Robotica76/2026_MakeX_Challengue/docs/01_requirements/README.md

# Requirements

Turn the official rules into reviewable, testable requirements before designing around them.
Source in use: **MakeX Challenge 2026 Storm Breaker Rules Guide V1.1 (English)**, stored in
[resources/rules](../../resources/rules/README.md); page numbers in the project refer to it.

| Document | Content today |
| --- | --- |
| [Competition requirements](competition_requirements.md) | Source register and interpretation questions (template, to fill) |
| [Rules compliance matrix](rules_compliance_matrix.md) | T01 (size, mass, ID), T02 (motors), T17 (battery, power module) checked against the v22 CAD |
| [Robot requirements](robot_requirements.md) | Measurable acceptance criteria (template, to fill) |

Requirement IDs in use come from the team issues: `T01-R*` size / mass / ID (issue #11),
`T02-R*` motors (#12), `T05-R*` chassis (#6), `T16-R*` modification stage, `T17-R*` battery and
power (#21). Design responses: [chassis design](../03_design/chassis/README.md), [v22 requirements check](../../mechanical/assemblies/full_robot/v22/README.md#requirements-check-cad).

## Review checklist

- Record edition, revision and page; do not paste rule text.
- Separate confirmed rule statements from assumptions and team goals.
- Resolve ambiguities with the competition authority and record the answer.
- Recheck architecture and tests when the rules guide changes.
