Robotica76/2026_MakeX_Challengue/tests/mechanical/README.md

# Mechanical component tests

Procedures and reports for parts and mechanisms. Test plans with pass criteria are in each
subsystem's `prototypes/README.md` (chassis, ball_intake, feeder, ball_storage, shooter, gripper,
gripper_elevation, flag_system) under [mechanical](../../mechanical/README.md). First tests: mass of each
printed / cut part vs CAD, fit of the numbered parts, roller and belt speeds at the real motor RPM.
No test has been run yet.
