Robotica76/2026_MakeX_Challengue/software/common/README.md

# Common

Shared contracts and utilities. Empty by design: mBlock uploads one file, so shared code is
inlined by [`bundle_for_mblock.py`](../../tools/scripts/README.md). Project modules that are shared
today live in their owner folder (`chassis.py` in [controls/drivetrain](../controls/drivetrain/README.md)).
