Robotica76/2026_MakeX_Challengue/software/drivers/README.md

# Drivers

There are no project driver modules: the programs call the **Makeblock mBlock Python APIs**
directly. The same APIs are emulated by the simulator
([`mblock_runtime.py`](../../simulation/field2d/mblock_runtime.py)), which is the reference list.

| Directory | APIs |
| --- | --- |
| [motors](motors/README.md) | `encoder_motor_class`, `power_expand_board` |
| [sensors](sensors/README.md) | `novapi.get_gyroscope`, `get_acceleration`, `ranging_sensor_class`, timers |
| [servos](servos/README.md) | `smartservo_class` |
| [vision](vision/README.md) | AI camera 2.0 |

Port assignment: [`robot_config.json`](../../simulation/field2d/robot_config.json) (assumption until wired).
