Robotica76/2026_MakeX_Challengue/software/robot/README.md

# Robot application

Top-level programs that run on the NovaPi: [main](main/README.md).

| Program | Role |
| --- | --- |
| [`storm_breaker_2026.py`](main/storm_breaker_2026.py) / [`.mblock`](main/storm_breaker_2026.mblock) | **Competition program** (blocks and Python, same program) |
| [`robot_2026.py`](main/robot_2026.py) | Earlier 2026 program built on the 2025 flow + `chassis.py` + `auto_pull_central.py` (needs bundling) |
