Robotica76/2026_MakeX_Challengue/software/vision/README.md

# Vision software

| Directory | Content |
| --- | --- |
| [bonus_cube_detection](bonus_cube_detection/README.md) | Bonus Battle (rules p.28): find the X3–X12 cube |
| [object_detection](object_detection/README.md) | Other props and the fortress |
| [calibration](calibration/README.md) | Camera calibration |
| [vision_reference](vision_reference/README.md) | Cube sticker images and prop-card statistics (PR #29, issue T18) |

No detection code yet. Hardware: AI camera 2.0 on the elevator lid. The automatic plan would gain
the remaining 4 % of X12 grabs by locating the cube with the camera ([Monte Carlo strategy](../../docs/07_strategy/montecarlo_strategy.md)).
