Robotica76/2026_MakeX_Challengue/tools/data_analysis/README.md

# Development data analysis

Analysis of simulation data lives with the simulations ([`simulation/analysis`](../../simulation/analysis/README.md):
Monte Carlo statistics, report and figure scripts). This folder is for robot data once it exists:
calibration runs, encoder / gyro logs, shot ranges. Planned first tools: a log parser for the NovaPi
serial output and a script that converts calibration runs into the parameter ranges of
`montecarlo_config_calibrated.json`.
