Robotica76/2026_MakeX_Challengue/tools/scripts/README.md

# Development Scripts

Reserve this directory for justified future support automation, such as organizing development artifacts or preparing experiment records. It must not host production robot control or firmware.

TBD before adding any utility: purpose, owner, inputs/outputs, execution requirements, permissions, failure behavior, and verification plan.

| Script | Purpose | Inputs / outputs | Requirements | Verification |
| --- | --- | --- | --- | --- |
| [`mass_properties.py`](mass_properties.py) | Estimate mass, centre of mass and inertia from the GLB (keyword densities, catalogue motor / electronics masses) | `.glb` → `robot_mass.json` | `trimesh` | Rerun after CAD changes; replace with weighed values |
| [`step_to_glb.py`](step_to_glb.py) | Convert a robot STEP assembly into the GLB mesh used by the [3D simulator](../../simulation/field3d/README.md) | `.step` or `.step.zip` → `.glb` (metres, CAD axes, one node per part); prints part count, size, parts per prefix | [`requirements-cad.txt`](requirements-cad.txt) (`cascadio`, `trimesh`) | `simulation/field3d/test_field3d.py` checks the generated asset against the v22 CAD |

## bundle_for_mblock.py

mBlock uploads a single Python file. `bundle_for_mblock.py` inlines the project modules a robot
program imports (`import chassis as ch`, ...) into one file (`build/<program>_mblock.py`) to paste
into mBlock's Python editor. Edit the sources, bundle again. Not yet tried on the NovaPi itself.

```bash
.venv/bin/python tools/scripts/bundle_for_mblock.py software/robot/main/robot_2026.py
```
