Robotica76/2026_MakeX_Challengue/resources/datasheets/README.md

# Datasheets and tutorials

| File | Content |
| --- | --- |
| [`tutorialchallenge.pdf`](tutorialchallenge.pdf) | MakeX Challenge tutorial (kit and programming reference) |

Motor and sensor specifications used in the design (DC-25 / DC-37 RPM, 180 encoder motor, brushless)
come from the rules' motor catalogue (T10); add manufacturer datasheets here when available.
