Robotica76/2026_MakeX_Challengue/resources/rules/README.md

# Official rules

| File | Edition | Use |
| --- | --- | --- |
| [`[English]+2026+MakeX+Challenge+Storm+Breaker+Rules+Guide(1).pdf`](%5BEnglish%5D+2026+MakeX+Challenge+Storm+Breaker+Rules+Guide%281%29.pdf) | Rules Guide **V1.1**, English (15 MB) | Source of every page reference (`p.N`) and rule ID (`R06`, `T10`, …) in the repository |

Rules most used by the design: T01 size (500 × 500 × 700 mm before modification), T02 mass (10 kg,
flag excluded), T08 (5) no hook-shaped parts, T10 motor catalogue and counts, T11 / T14 battery,
T17 flag, R06 own area, R19 stationary at the end of the automatic stage, R23, R24 X mark, R26
strategy-area channels, R27 no blocking. Check for newer editions on [makex.cc](https://www.makex.cc/) and record
which edition a decision used.
