Robotica76/2026_MakeX_Challengue/mechanical/ball_storage/drawings/README.md

# Ball Storage Drawings

Drawings reference the local [CAD](../cad/README.md) revision. Released fabrication drawings (dimensions, tolerances, inspection datums) are **not** produced yet; the sheets below are assembly/identification drawings generated from the v22 CAD.

## v22

| File | Content |
| --- | --- |
| [`v22_8_basket_and_feed_roller_exploded.pdf`](v22/v22_8_basket_and_feed_roller_exploded.pdf) · [PNG](v22/v22_8_basket_and_feed_roller_exploded.png) | Exploded view of subsystem 8 (Basket and feed roller) with every part numbered and the parts list (sheet 10 of the manual) |

Full manual (all subsystems, assembly sequence, complete parts list): [Ensamble_StormBreaker_v22.pdf](../../assemblies/full_robot/v22/docs/Ensamble_StormBreaker_v22.pdf).

**Pending for release:** fabrication drawings with dimensions and tolerances for the custom parts (CF plates, PC sheets, prints), hole patterns, and inspection datums.
