Robotica76/2026_MakeX_Challengue/mechanical/ball_storage/prototypes/README.md

# Ball Storage Prototypes

**Status (v22): no physical prototype has been built.** The figures below are CAD-based simulations (2D single-ball contact models or rigid-body estimates); they define what to measure, not results.

## Simulation evidence (v22 design inputs)

| Figure | What it shows |
| --- | --- |
| [`simulacion_lanzador_al_reves_v19.png`](v22/simulacion_lanzador_al_reves_v19.png) | Feed roller + inverted launcher: with the roller stopped the ball waits even with the wheel spinning; with the roller running it fires at ~44° / ~54° |

## Test plan

| Test | Measure | Pass criterion (from CAD / simulation) |
| --- | --- | --- |
| Hold | Ball waiting at the roller with the friction wheel at speed and roller stopped | Does not move |
| Feed | Ball fired per roller activation at 0.94 m/s | 10/10, one ball at a time |
| Capacity | Balls in the basket | 6–8 |

Record each test with date, robot revision, configuration, number of trials, and raw data before changing the design.
