Robotica76/2026_MakeX_Challengue/mechanical/chassis/drawings/README.md

# Chassis Drawings

Drawings reference the local [CAD](../cad/README.md) revision. Released fabrication drawings (dimensions, tolerances, inspection datums) are **not** produced yet; the sheets below are assembly/identification drawings generated from the v22 CAD.

## v22

| File | Content |
| --- | --- |
| [`v22_1_chassis_and_drive_exploded.pdf`](v22/v22_1_chassis_and_drive_exploded.pdf) · [PNG](v22/v22_1_chassis_and_drive_exploded.png) | Exploded view of subsystem 1 (Chassis and drive) with every part numbered and the parts list (sheet 3 of the manual) |
| [`v22_2_electronics_box_exploded.pdf`](v22/v22_2_electronics_box_exploded.pdf) · [PNG](v22/v22_2_electronics_box_exploded.png) | Exploded view of subsystem 2 (Electronics box) with every part numbered and the parts list (sheet 4 of the manual) |

Full manual (all subsystems, assembly sequence, complete parts list): [Ensamble_StormBreaker_v22.pdf](../../assemblies/full_robot/v22/docs/Ensamble_StormBreaker_v22.pdf).

**Pending for release:** fabrication drawings with dimensions and tolerances for the custom parts (CF plates, PC sheets, prints), hole patterns, and inspection datums.
