Robotica76/2026_MakeX_Challengue/mechanical/flag_system/drawings/README.md

# Flag System Drawings

Drawings reference the local [CAD](../cad/README.md) revision. Released fabrication drawings (dimensions, tolerances, inspection datums) are **not** produced yet; the sheets below are assembly/identification drawings generated from the v22 CAD.

## v22

| File | Content |
| --- | --- |
| [`v22_9_flag_mast_modification_stage_exploded.pdf`](v22/v22_9_flag_mast_modification_stage_exploded.pdf) · [PNG](v22/v22_9_flag_mast_modification_stage_exploded.png) | Exploded view of subsystem 9 (Flag mast (Modification Stage)) with every part numbered and the parts list (sheet 11 of the manual) |
| [`plano_mastil_bandera_v22.png`](v22/plano_mastil_bandera_v22.png) | Mast drawing: C-head section with dimensions and mast heights with the carriage down / up |

Full manual (all subsystems, assembly sequence, complete parts list): [Ensamble_StormBreaker_v22.pdf](../../assemblies/full_robot/v22/docs/Ensamble_StormBreaker_v22.pdf).

**Pending for release:** fabrication drawings with dimensions and tolerances for the custom parts (CF plates, PC sheets, prints), hole patterns, and inspection datums.
