Robotica76/2026_MakeX_Challengue/mechanical/flag_system/prototypes/README.md

# Flag System Prototypes

**Status (v22): no physical prototype has been built.** The figures below are CAD-based simulations (2D single-ball contact models or rigid-body estimates); they define what to measure, not results.

## Test plan

| Test | Measure | Pass criterion (from CAD / simulation) |
| --- | --- | --- |
| Retention | Flag stays during driving and bumps | No drop |
| Hanging | Raise, hook the loop on a real bar (950–965 mm), lower, strafe −x | Flag stays on the bar, no contact with the robot |
| Install time | Mast installation | < 30 s |

Record each test with date, robot revision, configuration, number of trials, and raw data before changing the design.
