Robotica76/2026_MakeX_Challengue/mechanical/gripper/drawings/README.md

# Gripper Drawings

Drawings reference the local [CAD](../cad/README.md) revision. Released fabrication drawings (dimensions, tolerances, inspection datums) are **not** produced yet; the sheets below are assembly/identification drawings generated from the v22 CAD.

## v22

| File | Content |
| --- | --- |
| [`v22_6_carriage_and_gripper_exploded.pdf`](v22/v22_6_carriage_and_gripper_exploded.pdf) · [PNG](v22/v22_6_carriage_and_gripper_exploded.png) | Exploded view of subsystem 6 (Carriage and gripper) with every part numbered and the parts list (sheet 8 of the manual) |

Full manual (all subsystems, assembly sequence, complete parts list): [Ensamble_StormBreaker_v22.pdf](../../assemblies/full_robot/v22/docs/Ensamble_StormBreaker_v22.pdf).

**Pending for release:** fabrication drawings with dimensions and tolerances for the custom parts (CF plates, PC sheets, prints), hole patterns, and inspection datums.
