Robotica76/2026_MakeX_Challengue/mechanical/gripper/prototypes/README.md

# Gripper Prototypes

**Status (v22): no physical prototype has been built.** The figures below are CAD-based simulations (2D single-ball contact models or rigid-body estimates); they define what to measure, not results.

## Test plan

| Test | Measure | Pass criterion (from CAD / simulation) |
| --- | --- | --- |
| Pin grip | Hold while driving and lifting | No slip |
| Cube / cone | Grip and release | TBD per element |

Record each test with date, robot revision, configuration, number of trials, and raw data before changing the design.
