Robotica76/2026_MakeX_Challengue/mechanical/gripper_elevation/prototypes/README.md

# Gripper Elevation Prototypes

**Status (v22): no physical prototype has been built.** The figures below are CAD-based simulations (2D single-ball contact models or rigid-body estimates); they define what to measure, not results.

## Test plan

| Test | Measure | Pass criterion (from CAD / simulation) |
| --- | --- | --- |
| Lift | Time 0 → 358 mm with a pin | TBD |
| Holding | Carriage drift with motor off | None |

Record each test with date, robot revision, configuration, number of trials, and raw data before changing the design.
