Robotica76/2026_MakeX_Challengue/simulation/analysis/reports/README.md

# Simulation reports

Figures and reports generated by the scripts in [`simulation/analysis`](../README.md). Regenerate them
with the script named in each row; they are committed so the results can be read without running
anything.

| Folder | Content | Produced by | Summary in |
| --- | --- | --- | --- |
| [chassis_montecarlo](chassis_montecarlo/README.md) | `chassis.py` robustness on 300 sampled robots per scenario, calibration guide (ES / EN) | `montecarlo_chassis.py`, `make_chassis_report.py` | [analysis README](../README.md#monte-carlo-chassispy-robustness) |
| [strategy_montecarlo](strategy_montecarlo/) | Automatic-stage strategy search figures | `montecarlo_strategy.py`, `plot_strategy_report.py` | [montecarlo_strategy.md](../../../docs/07_strategy/montecarlo_strategy.md) |
| [routes_montecarlo](routes_montecarlo/) | Every automatic mission order; two identical robots | `montecarlo_routes.py`, `two_robots.py`, `plot_routes_report.py` | same |
| [rl_strategy](rl_strategy/), [rl_strategy_robust](rl_strategy_robust/), `rl_strategy_seed1…5` | 2 vs 2 self-play reinforcement learning: learning curve, margin vs opponent styles, policy | `strategy_game.py`, `rl_strategy.py`, `rl_animation.py` | same |
| [rl_four](rl_four/) | UCB1 bandit over alliance configurations on the detailed 4-robot match | `rl_four.py` | same |
| [four_robots](four_robots/REPORTE.md) | Whole 2 vs 2 matches with four robots: report (Spanish), winning and representative match GIFs and logs | `four_robots.py`, `mc_four.py`, `../../field3d/timelapse4.py` | [REPORTE.md](four_robots/REPORTE.md) |
| [mc_four](mc_four/) | 80-match 4-robot Monte Carlo and plan efficiency | `mc_four.py`, `plot_mc_efficiency.py` | REPORTE.md section 0 |
| [summary](summary/) | One-page summary figure | `plot_summary_report.py` | — |
| [timelapse](timelapse/) | Match time-lapses | `../../field3d/timelapse.py` | — |

All values are simulations of the v22 model (ideal geometry, estimated physics); none is a robot measurement.
