Robotica76/2026_MakeX_Challengue/software/controls/drivetrain/README.md

# Drivetrain controls

Mecanum drivetrain control for the NovaPi, reused from the makeX 2025 robot and
adapted to 8 cm wheels. Implementation: [`chassis.py`](chassis.py).

## Hardware configuration

| Item | Value | Status |
|---|---|---|
| Wheels | Mecanum, 8 cm diameter (2025: 6 cm) | Effective diameter TBD (calibrate) |
| Motor ports | M4 = FL, M1 = FR, M3 = RL, M2 = RR (robot forward axis = intake side in v22) | Deduced from 2025 code, verify on robot |
| Motor signs | FL -1, FR +1, RL -1, RR +1 (left side mirrored) | Deduced from 2025 code, verify on robot |
| Turn arc | `CM_PER_TURN_DEGREE` = 34.52 cm × π / 180 = 0.603 cm/° (half track 22.12 + half wheelbase 12.40 cm) | v22 CAD; 2025 robot was 47 cm / 90° |
| Center of rotation | Wheel rectangle 7.9 cm behind the footprint center (`ODOM_CENTER_OFFSET_CM`) | v22 CAD |

## Coordinate frames

- Robot frame: `vy` forward (+), `vx` right (+), `w` clockwise (+).
- Fronts (v22 layout), in degrees clockwise from the robot forward axis:
  `F_INTAKE = 0` (default), `F_GRIPPER = 90` (right side, button "+", alias `F2`),
  `F_REAR = 180`, `F_LAUNCHER = -90` (left side, button "≡", alias `F1`). A front
  rotates forward and strafe so "forward" drives toward that side; it never changes
  the turn. In 2025 the launcher and gripper were on the forward axis and `F1`/`F2`
  were ±1; in v22 they are on the sides, so choosing them means strafing.
- Field frame (odometry): origin and heading 0 where `odo.reset()` was called;
  `x` to the right and `y` forward of the robot forward axis. Units: cm, degrees.
  `odo.x`, `odo.y` are the footprint center; the wheel center (center of rotation)
  is tracked internally, so turning in place moves the reported point on a 7.9 cm arc.

## Features and flags

| Flag | Effect |
|---|---|
| `USE_SENSORS` | `True`: closed loop with encoders + gyroscope (+ accelerometer collision detection). `False`: purely mechanical open loop (`move()`), as in 2025. |
| `SMOOTHING` | S-curve (jerk-limited) smoothing of joystick commands in manual mode. |
| `ADAPTIVE_SMOOTHING` | Scales the S-curve limits by speed (snappier when slow, gentler when fast) and by accelerometer vibration level. |

Autonomous API: `forward`, `backward`, `right`, `left`, `drive`, `turn`,
`turn_to`, `stop` (each returns `True` on arrival). `drive`, `turn_to` and `turn` accept
`on_cycle`, a function called every control cycle, to run mechanisms while the robot moves. Manual: `joystick_drive(front)`.
Setup before the match: `odo.calibrate()` (robot still), then `odo.reset()`.

## Open items (TBD)

- NovaPi sensor API names in the `sensors` section (`novapi.get_gyroscope("z")`,
  `novapi.get_acceleration(axis)`, `motor.get_value("angle")`) are unverified;
  confirm with the Python generated by the mBlock blocks.
- Accelerometer units and axes; `IMPACT_THRESHOLD`, `VIB_OK`, `VIB_MAX`.
- Gyroscope sign (`GYRO_SIGN`), `DEGREES_PER_CM`, `STRAFE_FACTOR` and control gains.
- Whether mBlock can upload more than one `.py` file to the NovaPi.

## Validation

Checked only in an offline Python simulation with mocked `novapi`/`mbuild`
(ideal wheels, gyroscope bias, injected vibration): closed-loop moves and turns
reach tolerance, S-curve has no overshoot, both `USE_SENSORS` modes produce the
same field pose. **Not yet tested on the robot.**

## Design decisions

DEC-S01 (reuse 2025 code + odometry + adaptive S-curve), DEC-S02 (fronts as angles), DEC-S03 (v22
geometry constants) in [DL-SYS-001](../../../docs/08_engineering_notebook/design_log/DL-SYS-001_design_decisions.md);
full rationale in [DL-T05-001](../../../docs/08_engineering_notebook/design_log/DL-T05-001_chassis_motion_software.md).
Note: the repository root holds an older copy, [`chassis.py`](../../../chassis.py) (2025 turn constant 47 cm / 90°);
this folder's file is the maintained one.
