Robotica76/2026_MakeX_Challengue/simulation/field2d/programs/README.md

# Example programs

| File | Content |
| --- | --- |
| [`all_motors_forward.py`](all_motors_forward.py) | Minimal mBlock-style program: all four drive motors forward. Smoke test of the program loader (`viewer.py --program programs/all_motors_forward.py`) |

Robot programs live in [`software/`](../../../software/README.md); the simulator loads them directly.
