Robotica76/2026_MakeX_Challengue/simulation/field3d/assets/README.md

# 3D assets

| File | Content |
| --- | --- |
| `storm_breaker_v22.glb` | The v22 robot (with the flag mast, carriage up) converted from the STEP by [`step_to_glb.py`](../../../tools/scripts/README.md): one node per CAD part, metres, CAD axes |

Regenerate after a CAD revision; the 3D tests check the part groups and footprint ([field3d](../README.md#checks)).
