Robotica76/2026_MakeX_Challengue/software/drivers/servos/README.md

# Servo drivers

One MS-12A servo is in the v22 CAD (shooter hood flap). API: `smartservo_class` (emulated by the
simulator, angle shown in the HUD). Not used by the programs yet; the 2025 robot used smart servos
on M5 / M6 ([legacy](../../legacy/challenge_2025/README.md)).
