Robotica76/2026_MakeX_Challengue/software/drivers/vision/README.md

# Vision drivers

Hardware: Makeblock AI camera 2.0 (v22 part 5.7, on the elevator lid). No driver code yet; the
simulator does not model the camera. Plans: [vision software](../../vision/README.md),
[vision architecture](../../../docs/04_controls/vision/README.md).
