Robotica76/2026_MakeX_Challengue/software/vision/bonus_cube_detection/README.md

# Bonus cube detection

Goal: identify which bonus cube (X3…X12) is on our strategy area and where, before the automatic
grab (rules p.28–30). Inputs: [vision_reference](../vision_reference/README.md). Not implemented; the
automatic routine uses the default prop card positions.
