Robotica76/2026_MakeX_Challengue/software/vision/vision_reference/README.md

# Vision reference material

| File | Content |
| --- | --- |
| [`Cubes Stikers IA Camara.pdf`](Cubes%20Stikers%20IA%20Camara.pdf) | Bonus-cube sticker sheet for the AI camera (commit 663de52) |
| [`prop_cards.xlsx`](prop_cards.xlsx) | Statistics of the prop cards: where each cube can appear (commit ee52407) |

Input for [bonus cube detection](../bonus_cube_detection/README.md) and for the prop layouts sampled by
the simulator ([`props.py`](../../../simulation/field2d/props.py)).
