Robotica76/2026_MakeX_Challengue/docs/02_system_architecture/electrical_architecture.md

# Electrical Architecture

Documentation-only power and signal plan. Approved components, supply properties, protections, and wiring requirements must be verified against official rules and manufacturer information.

## Power distribution

| Branch ID | Source → load | Component reference | Voltage / current + units | Protection / isolation proposal | Connector / wire specification | Requirement IDs | Owner |
| --- | --- | --- | --- | --- | --- | --- | --- |
| TBD | TBD | TBD | TBD | TBD | TBD | TBD | TBD |

## Signals and communication

| Interface ID | Sender → receiver | Signal / protocol | Level / units / rate | Connection reference | Timeout / disconnect policy | Verification ID |
| --- | --- | --- | --- | --- | --- | --- |
| TBD | TBD | TBD | TBD | TBD | TBD | TBD |

## Safety questions

| Question | Source needed | Proposed response | Review owner | Notebook / test evidence |
| --- | --- | --- | --- | --- |
| What protection and stop behavior are required? | TBD | TBD | TBD | TBD |
| How are cables restrained and moving parts isolated? | TBD | TBD | TBD | TBD |
| What happens on supply loss, brownout, or communication loss? | TBD | TBD | TBD | TBD |

Reconcile with the [power budget](weight_power_budget.md), [electronics design](../03_design/electronics/README.md), and [interface matrix](../05_integration/interface_matrix.md). Log design decisions in the [notebook](../08_engineering_notebook/README.md).
