Robotica76/2026_MakeX_Challengue/docs/02_system_architecture/mechanical_interfaces.md

# Mechanical Interfaces

Agree reference frames, loads, access, and fit before detailed CAD. No geometry or load limit is confirmed here.

| Interface ID | Joining subsystems | Reference frame / datum | Mounting / fastener specification | Envelope / travel + units | Load + units | Tolerance + units | Owner / reviewer | Requirement IDs |
| --- | --- | --- | --- | --- | --- | --- | --- | --- |
| TBD | TBD | TBD | TBD | TBD | TBD | TBD | TBD | TBD |

## Clearance and service access

| Configuration / mode | Moving parts | Clearance / interference question | Cable / object path | Access requirement | CAD / notebook evidence | Verification ID |
| --- | --- | --- | --- | --- | --- | --- |
| TBD | TBD | TBD | TBD | TBD | TBD | TBD |

## Interface agreement

| Interface ID / revision | Producer approval | Consumer approval | Change impact | Integration check | Status |
| --- | --- | --- | --- | --- | --- |
| TBD | TBD | TBD | TBD | TBD | Draft |

Mirror agreed boundaries in the [interface matrix](../05_integration/interface_matrix.md). Record fit failures and changes in [design logs](../08_engineering_notebook/design_log/README.md); verify using [integration tests](../06_verification/integration_tests/README.md).
