Robotica76/2026_MakeX_Challengue/docs/02_system_architecture/weight_power_budget.md

# Weight and Power Budget

All allocations, official limits, measured values, and margins are TBD. Include unit conventions, source revision, and uncertainty; distinguish estimates from measurements.

## Mass budget

| Subsystem | Requirement / rule ID | Allocation (kg) | Estimated mass (kg) | Measured mass (kg) | Included parts / uncertainty | Evidence / notebook link |
| --- | --- | --- | --- | --- | --- | --- |
| Chassis | TBD | TBD | TBD | TBD | TBD | TBD |
| Ball system | TBD | TBD | TBD | TBD | TBD | TBD |
| Shooter | TBD | TBD | TBD | TBD | TBD | TBD |
| Manipulator | TBD | TBD | TBD | TBD | TBD | TBD |
| Flag system | TBD | TBD | TBD | TBD | TBD | TBD |
| Electronics / wiring / fasteners | TBD | TBD | TBD | TBD | TBD | TBD |
| Total / reserve | TBD | TBD | TBD | TBD | TBD | TBD |

## Electrical and energy budget

| Load / branch | Supply (V) | Typical current (A) | Peak current (A) | Duty assumption | Energy estimate (Wh) | Measurement / source | Requirement ID |
| --- | --- | --- | --- | --- | --- | --- | --- |
| TBD | TBD | TBD | TBD | TBD | TBD | TBD | TBD |

## Reconciliation

| Budget | Verified limit / available capacity | Calculated total | Reserve / margin | Assumptions / uncertainty | Reviewer | Next measurement |
| --- | --- | --- | --- | --- | --- | --- |
| Mass | TBD | TBD | TBD | TBD | TBD | TBD |
| Peak electrical demand | TBD | TBD | TBD | TBD | TBD | TBD |
| Energy over verified operating interval | TBD | TBD | TBD | TBD | TBD | TBD |

Document calculation method and concurrent-load assumptions; do not sum unrelated peaks without explaining the scenario. Link [electrical architecture](electrical_architecture.md), [robot requirements](../01_requirements/robot_requirements.md), and [test results](../08_engineering_notebook/test_results/README.md).
