Robotica76/2026_MakeX_Challengue/electrical/architecture/electrical_architecture.md

# Electrical Architecture Starter

Status: TBD; investigation only, no hardware or topology selected.

## Architecture questions

| Topic | Decision | Evidence/source revision | Owner/review |
| --- | --- | --- | --- |
| Controller roles and boundaries | TBD | TBD | TBD |
| Subsystem actuation interfaces | TBD | TBD | TBD |
| Communication and feedback boundaries | TBD | TBD | TBD |
| Power/control separation | TBD | TBD | TBD |
| Fault handling and safe-state requirements | TBD | TBD | TBD |
| Mechanical packaging and service access | TBD | TBD | TBD |

## Interface record

For each future connection record producer, consumer, purpose, signal semantics, electrical characteristics, connector/channel assignment, fault behavior, and supporting source. Every field remains TBD until reviewed; do not infer compatibility.

Cross-check [motor](motor_allocation.md), [servo](servo_allocation.md), [sensor](../sensors/sensor_register.md), [power](../power/power_distribution.md), and [wiring](../wiring/wiring_diagrams.md) registers. Future software protocols remain undecided.
