Robotica76/2026_MakeX_Challengue/electrical/architecture/motor_allocation.md

# Motor Allocation Starter

Status: TBD. Rows identify candidate subsystem needs, not a requirement to use motors or any particular count.

| Candidate subsystem | Function/need | Actuator count/model | Driver/channel | Power demand/source | Feedback/interlocks | Mount/routing owner | Review |
| --- | --- | --- | --- | --- | --- | --- | --- |
| Chassis | TBD | TBD | TBD | TBD | TBD | TBD | TBD |
| Ball intake | TBD | TBD | TBD | TBD | TBD | TBD | TBD |
| Ball storage | TBD | TBD | TBD | TBD | TBD | TBD | TBD |
| Feeder | TBD | TBD | TBD | TBD | TBD | TBD | TBD |
| Shooter | TBD | TBD | TBD | TBD | TBD | TBD | TBD |
| Gripper | TBD | TBD | TBD | TBD | TBD | TBD | TBD |
| Gripper elevation | TBD | TBD | TBD | TBD | TBD | TBD | TBD |
| Flag system, if justified | TBD | TBD | TBD | TBD | TBD | TBD | TBD |

First justify actuation needs from [mechanical studies](../../mechanical/README.md). Later source specifications through [datasheets](../../resources/datasheets/README.md), confirm eligibility against reviewed rules, and reconcile [power](../power/power_distribution.md) and [BOM](../bom/electrical_bom.md). No motor, channel, rating, or total is approved.
