Robotica76/2026_MakeX_Challengue/electrical/architecture/servo_allocation.md

# Servo Allocation Starter

Status: TBD. Investigate whether any mechanism needs servo actuation; no servo is assumed or allocated.

| Candidate function/subsystem | Need/alternative rationale | Count/model | Controller/channel | Supply and demand/source | Motion/feedback semantics | Mount/routing owner | Review |
| --- | --- | --- | --- | --- | --- | --- | --- |
| TBD | TBD | TBD | TBD | TBD | TBD | TBD | TBD |

Record mechanical load/motion requirements before hardware selection. Source electrical and control characteristics later from [datasheets](../../resources/datasheets/README.md); verify compatibility and eligibility rather than assuming standard signals or supply levels.

Reconcile with [mechanical](../../mechanical/README.md), [power](../power/power_distribution.md), [wiring](../wiring/wiring_diagrams.md), and [BOM](../bom/electrical_bom.md). Channel count, connectors, limits, and safe states are TBD.
