Robotica76/2026_MakeX_Challengue/docs/05_integration/integration_plan.md

# Integration Plan

The stages below are an engineering review proposal, not executable instructions or a confirmed assembly schedule. Safety review and acceptance criteria must be completed before physical tests.

| Stage | Scope | Preconditions / approved revisions | Interface / requirement IDs | Check / acceptance source | Responsible students | Rollback / stop condition | Test / notebook link | Status |
| --- | --- | --- | --- | --- | --- | --- | --- | --- |
| Interface review | Contracts and ownership | TBD | TBD | TBD | TBD | TBD | TBD | Planned |
| Mechanical fit review | Packaging / access / movement | TBD | TBD | TBD | TBD | TBD | TBD | Planned |
| Electrical review | Connections / protection / budgets | TBD | TBD | TBD | TBD | TBD | TBD | Planned |
| Control-contract review | Modes / handoff / arbitration | TBD | TBD | TBD | TBD | TBD | TBD | Planned |
| Combined subsystem review | Cross-system behavior | TBD | TBD | TBD | TBD | TBD | TBD | Planned |
| Competition-context review | Verified rules and strategy | TBD | TBD | TBD | TBD | TBD | TBD | Planned |

## Readiness gate

| Gate | Evidence required | Reviewer | Open blocking issues | Decision record |
| --- | --- | --- | --- | --- |
| Proceed / hold / revise | TBD | TBD | TBD | TBD |

Use the [interface matrix](interface_matrix.md), [known issues](known_issues.md), and [integration tests](../06_verification/integration_tests/README.md). Capture each stage’s changes, results, and corrective actions with the [design log template](../08_engineering_notebook/design_log/entry_template.md).
