Robotica76/2026_MakeX_Challengue/docs/05_integration/interface_matrix.md

# Interface Matrix

Each interface needs agreement by both participating student teams. Detailed contracts live in linked architecture or design records.

| Interface ID | Producer / subsystem | Consumer / subsystem | Type: mechanical / electrical / software | Contract link / revision | Units / frame / connector / envelope | Failure behavior | Requirement IDs | Owners / approvals | Verification ID / result |
| --- | --- | --- | --- | --- | --- | --- | --- | --- | --- |
| TBD | TBD | TBD | TBD | TBD | TBD | TBD | TBD | TBD | TBD |

## Interface change review

| Interface ID | Proposed change | Affected consumers / documents | Compatibility / retest | Decision / notebook record | Approval / status |
| --- | --- | --- | --- | --- | --- |
| TBD | TBD | TBD | TBD | TBD | TBD |

Contract sources: [mechanical](../02_system_architecture/mechanical_interfaces.md), [electrical](../02_system_architecture/electrical_architecture.md), and [software](../02_system_architecture/software_architecture.md). Track failures in [known issues](known_issues.md) and link [notebook entries](../08_engineering_notebook/design_log/README.md).
