Robotica76/2026_MakeX_Challengue/electrical/power/battery_power_management.md

# Battery and Power Management Starter

Status: TBD. Battery type, quantity, chemistry, capacity, voltage, charger, runtime targets, and handling procedures are not specified.

| Topic | Requirement/decision | Authoritative source/revision | Verification plan | Owner/review |
| --- | --- | --- | --- | --- |
| Eligible source and charging equipment | TBD | TBD | TBD | TBD |
| Operating demand and duration | TBD | TBD | TBD | TBD |
| Monitoring and power-state reporting | TBD | TBD | TBD | TBD |
| Startup, shutdown, and fault response | TBD | TBD | TBD | TBD |
| Mounting, access, and replacement | TBD | TBD | TBD | TBD |
| Charging, storage, and handling guidance | TBD | TBD | TBD | TBD |

Obtain official eligibility requirements from [rules](../../resources/rules/README.md) and manufacturer guidance through authorized [datasheet references](../../resources/datasheets/README.md). Do not invent handling or protection procedures. Coordinate future demand studies with [power distribution](power_distribution.md) and packaging with [full_robot](../../mechanical/assemblies/full_robot/README.md).
