Robotica76/2026_MakeX_Challengue/electrical/power/power_distribution.md

# Power Distribution Starter

Status: TBD; no power topology, rails, ratings, or protection selections.

| Boundary/load group | Function | Source/rail | Demand and evidence | Distribution/protection | Connector/routing | Owner/review |
| --- | --- | --- | --- | --- | --- | --- |
| Control electronics | TBD | TBD | TBD | TBD | TBD | TBD |
| Candidate motor loads | TBD | TBD | TBD | TBD | TBD | TBD |
| Candidate servo loads | TBD | TBD | TBD | TBD | TBD | TBD |
| Candidate sensing/vision loads | TBD | TBD | TBD | TBD | TBD | TBD |

## Planning questions

- Which loads and operating combinations follow from approved subsystem concepts?
- Which demands are manufacturer-sourced, estimated, or measured, and under what conditions?
- What distribution, regulation, return/reference, protection, isolation, and shutdown requirements need review?
- How will packaging, routing, access, and fault behavior be verified?

All answers remain TBD. Reconcile [motor](../architecture/motor_allocation.md), [servo](../architecture/servo_allocation.md), [sensor](../sensors/sensor_register.md), and [battery](battery_power_management.md) records before future [wiring](../wiring/wiring_diagrams.md) release.
