Robotica76/2026_MakeX_Challengue/electrical/sensors/sensor_register.md

# Sensor Register Starter

Status: TBD. Candidate observability questions do not prescribe sensor hardware.

| Candidate observation | Subsystem/consumer | Sensor or alternative | Placement/frame | Signal/interface | Specification source | Calibration/verification | Owner/review |
| --- | --- | --- | --- | --- | --- | --- | --- |
| Robot motion/state | TBD | TBD | TBD | TBD | TBD | TBD | TBD |
| Ball presence/transfer/readiness | TBD | TBD | TBD | TBD | TBD | TBD | TBD |
| Manipulator position/retention | TBD | TBD | TBD | TBD | TBD | TBD | TBD |
| Task/element observation | TBD | TBD | TBD | TBD | TBD | TBD | TBD |

For each justified need, define units, frame, timing, validity, fault indication, and acceptance criteria before selection. All numerical characteristics, counts, connectors, and channels are TBD, to be sourced later.

Reference [datasheets](../../resources/datasheets/README.md), [vision studies](vision_interfaces.md), and future development-only [calibration support](../../tools/calibration/README.md). No production sensing implementation is included.
