Robotica76/2026_MakeX_Challengue/electrical/sensors/vision_interfaces.md

# Vision Interfaces Starter

Status: TBD. Vision need, camera hardware, processing location, algorithms, and communication protocol are undecided.

| Interface question | Decision | Evidence/source revision | Owner/review |
| --- | --- | --- | --- |
| Verified task and observation purpose | TBD | TBD | TBD |
| Camera placement, reference frame, and visibility | TBD | TBD | TBD |
| Power, mounting, routing, and electrical connection | TBD | TBD | TBD |
| Processing boundary and data transport | TBD | TBD | TBD |
| Output semantics, units, frames, timing, and validity | TBD | TBD | TBD |
| Calibration ownership and revision association | TBD | TBD | TBD |
| Failure/degraded behavior and acceptance evidence | TBD | TBD | TBD |

Investigate interfaces with [mechanical integration](../../mechanical/assemblies/full_robot/README.md), [sensor planning](sensor_register.md), and future software consumers. Record authorized [field](../../resources/field/README.md) and [game-element](../../resources/game_elements/README.md) sources before assuming targets or visual properties. No camera specifications or vision implementation are provided.
