Robotica76/2026_MakeX_Challengue/mechanical/ball_storage/drawings/v22/v22_8_basket_and_feed_roller_exploded.pdf

## N.º Pieza

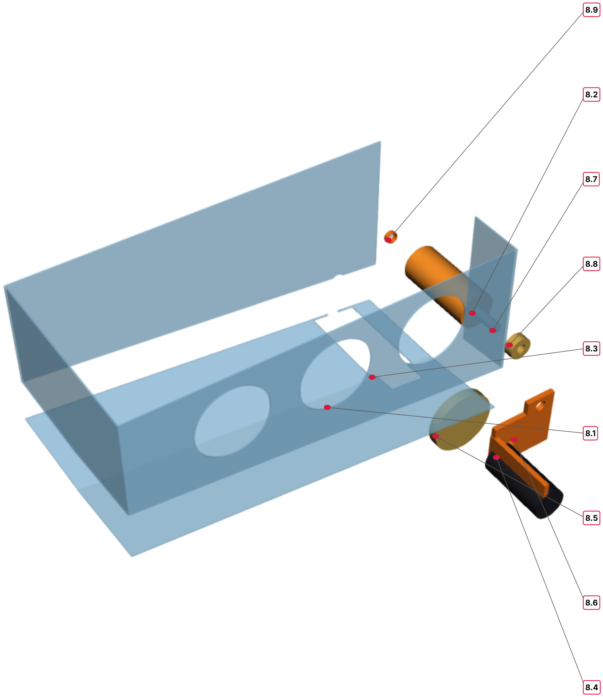
[picture p27: figure]

### 8.1 CN paredes canasta PC 1

### 8.2 CN rodillo alimentador TPU D30

### 8.3 CN piso canasta PC 1 2

### 8.4 CN motor DC25 200rpm alimentador 3a1

### 8.5 CN engrane 48T kit motor alimentador

### 8.6 CN soporte alimentador y motor PETG

### 8.7 CN eje alimentador D8 Al

### 8.8 CN engrane 16T kit alimentador

### 8.9 CN buje alimentador en pared trasera

# 8. Canasta y alimentador

## 9 piezas · explosión radial del subsistema

## MakeX Challenge 2026 · Storm Breaker v22

Medidas en mm. Numeración: subsistema.pieza (piezas ordenadas de mayor a menor volumen). Tornillería no se muestra en las explosionadas. | Hoja 10
