Robotica76/2026_MakeX_Challengue/mechanical/chassis/drawings/v22/v22_1_chassis_and_drive_exploded.pdf

## N.º Pieza

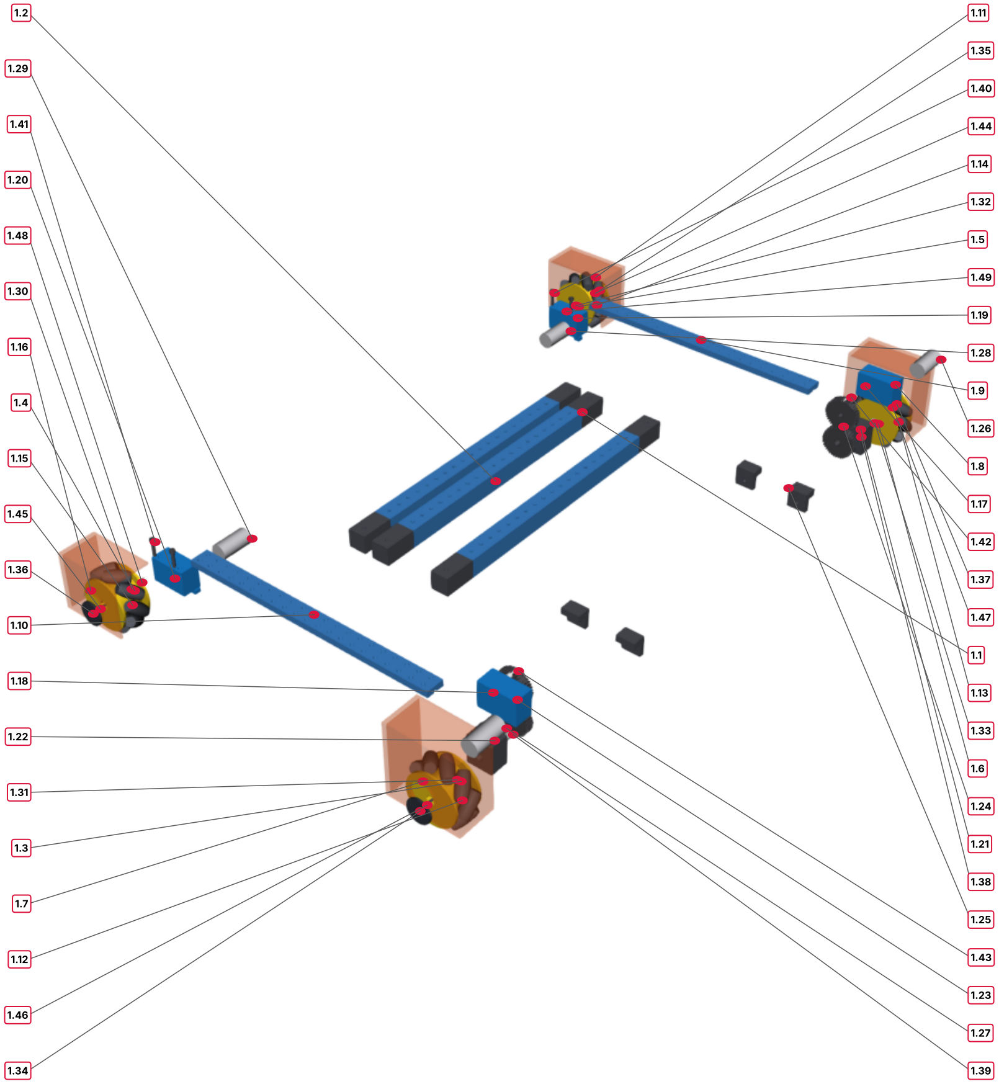
[picture p28: figure]

### 1.1 CH calzas travesano impresas x6

### 1.2 CH travesanos square beam 2424 312 x3

### 1.3 CH mecanum 80 R del der llanta

### 1.4 CH mecanum 80 L tras der llanta

### 1.5 CH mecanum 80 R tras izq llanta

### 1.6 CH mecanum 80 L del izq llanta

### 1.7 CH guarda rueda del der PETG

### 1.8 CH guarda rueda del izq PETG

### 1.9 CH slide beam 496 izq

### 1.10 CH slide beam 496 der

### 1.11 CH guarda rueda tras izq PETG

### 1.12 CH mecanum 80 R del der rodillos

### 1.13 CH mecanum 80 L del izq rodillos

### 1.14 CH mecanum 80 R tras izq rodillos

### 1.15 CH mecanum 80 L tras der rodillos

### 1.16 CH guarda rueda tras der PETG

### 1.17 CH motor 180 encoder del izq caja

### 1.18 CH motor 180 encoder del der caja

### 1.19 CH motor 180 encoder tras izq caja

### 1.20 CH motor 180 encoder tras der caja

### 1.21 CH chumacera impresa del izq

### 1.22 CH chumacera impresa del der

### 1.23 CH engranes 40T impresos del der

### 1.24 CH engranes 40T impresos del izq

### 1.25 CH separadores placa intake impresos x4

## N.º Pieza

### 1.26 CH motor 180 encoder del izq lata

### 1.27 CH motor 180 encoder del der lata

### 1.28 CH motor 180 encoder tras izq lata

### 1.29 CH motor 180 encoder tras der lata

### 1.30 CH coupling mecanum 80 tras der

### 1.31 CH coupling mecanum 80 del der

### 1.32 CH coupling mecanum 80 tras izq

### 1.33 CH coupling mecanum 80 del izq

### 1.34 CH hub mecanum 80 del der

### 1.35 CH hub mecanum 80 tras izq

### 1.36 CH hub mecanum 80 tras der

### 1.37 CH hub mecanum 80 del izq

### 1.38 CH eje rueda D8 del izq

### 1.39 CH eje rueda D8 del der

### 1.40 CH tornillos M4x20 motor tras izq

### 1.41 CH tornillos M4x20 motor tras der

### 1.42 CH motor 180 encoder del izq eje salida

### 1.43 CH motor 180 encoder del der eje salida

### 1.44 CH tornillo M2 5x30 tras izq

### 1.45 CH tornillo M2 5x30 tras der

### 1.46 CH tornillo M2 5x30 del der

### 1.47 CH tornillo M2 5x30 del izq

### 1.48 CH motor 180 encoder tras der eje salida

### 1.49 CH motor 180 encoder tras izq eje salida

# 1. Chasis y tracción

# 49 piezas · explosión radial del subsistema

# MakeX Challenge 2026 · Storm Breaker v22

Medidas en mm. Numeración: subsistema.pieza (piezas ordenadas de mayor a menor volumen). Tornillería no se muestra en las explosionadas. | Hoja 3
