Robotica76/2026_MakeX_Challengue/resources/README.md

# Resources

| Register | Content |
| --- | --- |
| [rules](rules/README.md) | **Rules Guide V1.1** (PDF) and the rules that drive the design |
| [field](field/README.md) | Where the field model comes from |
| [game_elements](game_elements/README.md) | Element data used by design and simulation |
| [datasheets](datasheets/README.md) | Kit tutorial; motor data from the rules catalogue |

Official site: [makex.cc](https://www.makex.cc/). Record the edition of every source a decision uses.
