Robotica76/2026_MakeX_Challengue/docs/01_requirements/competition_requirements.md

# Matriz de Cumplimiento de Reglas

El cumplimiento permanece sin verificar hasta que se haya revisado la fuente oficial y la evidencia relevante. Los IDs locales no implican numeración oficial de reglas.

| ID de regla local | Fuente oficial + revisión + sección | Interpretación del estudiante | ID de requisito del robot | Enlace de diseño / interfaz | Enlace de ID de verificación / procedimiento | Enlace de resultado / evidencia | Revisor | Estado |
| --- | --- | --- | --- | --- | --- | --- | --- | --- |
| RC-2.1 | Guía de Reglas MakeX Challenge Storm Breaker, 2026.9 v1.1, Sección 2.1 Requisitos de Participación | Equipo de 2 a 8 competidores más 1 o 2 mentores; edades de 11 a 18 años (nacidos entre 2008-01-02 y 2015-12-31); mentor mayor de 18 años; solo 1 operador y 1 observador en el área de competencia por partida. | TBD | TBD | TBD | TBD | TBD | Sin verificar |
| RC-2.2 | Guía de Reglas MakeX Challenge Storm Breaker, 2026.9 v1.1, Sección 2.2 Registro y Solicitud | Registrarse en el sitio web oficial de MakeX; un formulario por equipo; notificar al comité con anticipación para cambios en la plantilla. | TBD | TBD | TBD | TBD | TBD | Sin verificar |
| RC-3-Presencial | Guía de Reglas MakeX Challenge Storm Breaker, 2026.9 v1.1, Sección 3 Procedimiento de Competencia — Registro Presencial | Presentar identificación/pasaporte para el registro presencial; el mentor informa al equipo sobre salidas de emergencia, horario y áreas. | TBD | TBD | TBD | TBD | TBD | Sin verificar |
| RC-3-Inspección | Guía de Reglas MakeX Challenge Storm Breaker, 2026.9 v1.1, Sección 3 Procedimiento de Competencia — Inspección del Robot | Completar el Formulario de Autoinspección del Robot del Apéndice 3 con datos reales; autoverificación y verificación mutua antes de entrar al área de competencia; sin quejas maliciosas; levantar la mano para confirmar preparación. | TBD | TBD | TBD | TBD | TBD | Sin verificar |
| RC-3-Horario | Guía de Reglas MakeX Challenge Storm Breaker, 2026.9 v1.1, Sección 3 Procedimiento de Competencia — Anuncio del Horario | Horario anunciado al menos 30 minutos antes del inicio; incluye tabla de enfrentamientos, sesión, hora y alianzas. | TBD | TBD | TBD | TBD | TBD | Sin verificar |
| RC-3-Cuaderno | Guía de Reglas MakeX Challenge Storm Breaker, 2026.9 v1.1, Sección 3 Procedimiento de Competencia — Entrega del Cuaderno de Ingeniería | Entregar 1 copia impresa del cuaderno de ingeniería en el área de inspección; no se devuelve; base para premios especiales. | TBD | TBD | TBD | TBD | TBD | Sin verificar |
| RC-3-Práctica | Guía de Reglas MakeX Challenge Storm Breaker, 2026.9 v1.1, Sección 3 Procedimiento de Competencia — Ronda de Práctica | Los equipos que pasan la inspección pueden unirse a la ronda de práctica; hacer fila en la entrada; no todas las competencias tienen una. | TBD | TBD | TBD | TBD | TBD | Sin verificar |
| RC-3-Alianza | Guía de Reglas MakeX Challenge Storm Breaker, 2026.9 v1.1, Sección 3 Procedimiento de Competencia — Ceremonia de Selección de Alianza | Los equipos promovidos del top 50% pueden rechazar una vez; los del bottom 50% no pueden rechazar; límite de decisión de 30 s; equipos ausentes se consideran retirados. | TBD | TBD | TBD | TBD | TBD | Sin verificar |
| RC-3-Eliminación | Guía de Reglas MakeX Challenge Storm Breaker, 2026.9 v1.1, Sección 3 Procedimiento de Competencia — Ronda de Eliminación | BO3; "dos victorias" o "una victoria y dos empates" avanza; desempate por diferencia de puntos, luego puntaje más alto, luego partido extra. | TBD | TBD | TBD | TBD | TBD | Sin verificar |
| RC-4.1 | Guía de Reglas MakeX Challenge Storm Breaker, 2026.9 v1.1, Sección 4.1 Introducción | Una partida dura 4 min 40 s; cuatro etapas: automática (30 s), manual (100 s), modificación (60 s), final (90 s). | TBD | TBD | TBD | TBD | TBD | Sin verificar |
| RC-4.2-Arena | Guía de Reglas MakeX Challenge Storm Breaker, 2026.9 v1.1, Sección 4.2 Arena | Arena de 4655 mm × 3055 mm, altura del marco de 900 mm; robots y fortaleza móvil restringidos a su propia mitad. | TBD | TBD | TBD | TBD | TBD | Sin verificar |
| RC-4.2-Inicio | Guía de Reglas MakeX Challenge Storm Breaker, 2026.9 v1.1, Sección 4.2 Área de Inicio | Áreas de inicio de 500 mm × 500 mm en las cuatro esquinas; 2 por alianza; el robot se coloca aquí antes y después de la partida. | TBD | TBD | TBD | TBD | TBD | Sin verificar |
| RC-4.2-RecursoPropio | Guía de Reglas MakeX Challenge Storm Breaker, 2026.9 v1.1, Sección 4.2 Área de Recursos Propios | Área de recursos propios de 985 × 318 × 745 mm; 2 por alianza; 4 pinos + 10 pelotas cada una; colocación del controlador Bluetooth. | TBD | TBD | TBD | TBD | TBD | Sin verificar |
| RC-4.2-ÁreaPinos | Guía de Reglas MakeX Challenge Storm Breaker, 2026.9 v1.1, Sección 4.2 Área de Colocación de Pinos | Área de colocación de pinos de 995 × 195 × 388 mm; 1 por alianza; los pinos colocados aquí otorgan 30 pts. | TBD | TBD | TBD | TBD | TBD | Sin verificar |
| RC-4.2-ÁreaBandera | Guía de Reglas MakeX Challenge Storm Breaker, 2026.9 v1.1, Sección 4.2 Área de Colgado de Bandera | Área de colgado de bandera de 120 × 15 × 961 mm; 2 por alianza; asta de bandera de aluminio de 160 mm. | TBD | TBD | TBD | TBD | TBD | Sin verificar |
| RC-4.2-ÁreaCono | Guía de Reglas MakeX Challenge Storm Breaker, 2026.9 v1.1, Sección 4.2 Área de Colgado de Conos | Área de colgado de conos de 40 × 405 mm; 2 por alianza; los conos colgados aquí otorgan puntos. | TBD | TBD | TBD | TBD | TBD | Sin verificar |
| RC-4.2-Estrategia | Guía de Reglas MakeX Challenge Storm Breaker, 2026.9 v1.1, Sección 4.2 Área de Estrategia | Área de estrategia de 960 × 215 × 259 mm; 2; fuente de conos y cubos de bonificación; canal de cubos de letras. | TBD | TBD | TBD | TBD | TBD | Sin verificar |
| RC-4.2-ÁreaBono | Guía de Reglas MakeX Challenge Storm Breaker, 2026.9 v1.1, Sección 4.2 Área de Intercambio de Cubos de Bonificación | Área de intercambio de cubos de bonificación de 318 × 214 mm; 2 por alianza; el cubo de bonificación colocado aquí se intercambia por pelotas. | TBD | TBD | TBD | TBD | TBD | Sin verificar |
| RC-4.2-Central | Guía de Reglas MakeX Challenge Storm Breaker, 2026.9 v1.1, Sección 4.2 Área de Recursos Central | Área de recursos central de 455 × 86 × 292 mm; 1; contiene la marca X y 30 pelotas (15 superiores, 15 inferiores). | TBD | TBD | TBD | TBD | TBD | Sin verificar |
| RC-4.2-Fortaleza | Guía de Reglas MakeX Challenge Storm Breaker, 2026.9 v1.1, Sección 4.2 Fortaleza Móvil | Fortaleza móvil de 640 × 640 × 646 mm; 1 por alianza; nivel superior es el objetivo para las pelotas del oponente; nivel inferior contiene cubos de letras. | TBD | TBD | TBD | TBD | TBD | Sin verificar |
| RC-4.3-Letra | Guía de Reglas MakeX Challenge Storm Breaker, 2026.9 v1.1, Sección 4.3 Cubo de Letra | Cubos de letra de 120 mm de EVA; 16 en total (8 por fortaleza); letras M, A, K, E (2 de cada una); tolerancia de ±5 mm. | TBD | TBD | TBD | TBD | TBD | Sin verificar |
| RC-4.3-Pinos | Guía de Reglas MakeX Challenge Storm Breaker, 2026.9 v1.1, Sección 4.3 Pinos | Pinos de 290 mm de alto, base de 70 mm, diámetro máximo de 100 mm; 16 en total (8 por campamento); EVA rojo/azul. | TBD | TBD | TBD | TBD | TBD | Sin verificar |
| RC-4.3-Bono | Guía de Reglas MakeX Challenge Storm Breaker, 2026.9 v1.1, Sección 4.3 Cubo de Bonificación | Cubos de bonificación de 120 mm de EVA; 4 en total; etiquetas 3/6/9/12; posiciones según la Tarjeta de Prop; accesorios compartidos. | TBD | TBD | TBD | TBD | TBD | Sin verificar |
| RC-4.3-Cono | Guía de Reglas MakeX Challenge Storm Breaker, 2026.9 v1.1, Sección 4.3 Cono | Conos de 170 mm de alto, base de 120 × 120 mm; 4 en total; EVA amarillo; posiciones según la Tarjeta de Prop. | TBD | TBD | TBD | TBD | TBD | Sin verificar |
| RC-4.3-Pelota | Guía de Reglas MakeX Challenge Storm Breaker, 2026.9 v1.1, Sección 4.3 Pelota | Pelotas de 70 mm de diámetro; 100 en total (20 por área de recursos propios, 15 por nivel central, 30 de repuesto); EVA amarillo. | TBD | TBD | TBD | TBD | TBD | Sin verificar |
| RC-4.4-BatallaBono | Guía de Reglas MakeX Challenge Storm Breaker, 2026.9 v1.1, Sección 4.4 Batalla de Bonificación | Etapa automática: usar el Módulo de Visión para identificar y transferir cubos de bonificación al área de intercambio propia; máximo 2 cubos por alianza; cada área solo 1 cubo; sin contacto con el robot; pelotas intercambiadas valen 20 pts cada una hasta la cantidad marcada. | TBD | TBD | TBD | TBD | TBD | Sin verificar |
| RC-4.4-Precisión | Guía de Reglas MakeX Challenge Storm Breaker, 2026.9 v1.1, Sección 4.4 Lanzamiento de Precisión | Lanzar pelotas al área superior de la fortaleza del oponente; pelotas de bonificación valen 20 pts hasta la cantidad válida de bonificación, las restantes 10 pts; sin bonificación = todas 10 pts. | TBD | TBD | TBD | TBD | TBD | Sin verificar |
| RC-4.4-TransferenciaLetra | Guía de Reglas MakeX Challenge Storm Breaker, 2026.9 v1.1, Sección 4.4 Transferencia de Cubos de Letras | Mover los cubos de letras propios al canal del área de estrategia; 30 pts cada uno; válido si la proyección está en el canal, no toca el mapa y no toca el robot de la alianza. | TBD | TBD | TBD | TBD | TBD | Sin verificar |
| RC-4.4-MAKEX | Guía de Reglas MakeX Challenge Storm Breaker, 2026.9 v1.1, Sección 4.4 Desafío MAKEX | Llenar un lado del canal en orden M-A-K-E de afuera hacia adentro con 4 cubos válidos: +50 pts; ambos lados: +100 pts; la orientación de las letras es irrelevante. | TBD | TBD | TBD | TBD | TBD | Sin verificar |
| RC-4.4-TransferenciaPino | Guía de Reglas MakeX Challenge Storm Breaker, 2026.9 v1.1, Sección 4.4 Transferencia de Pinos | Mover los pinos propios fuera del área de recursos al campo propio: 10 pts; al área de colocación de pinos: 30 pts; sin contacto con el robot. | TBD | TBD | TBD | TBD | TBD | Sin verificar |
| RC-4.4-TransferenciaCono | Guía de Reglas MakeX Challenge Storm Breaker, 2026.9 v1.1, Sección 4.4 Transferencia de Conos | Colgar conos del área de estrategia en el área de colgado de conos propia: 20 pts cada uno; en posición vertical o invertida; sin contacto con el robot. | TBD | TBD | TBD | TBD | TBD | Sin verificar |
| RC-4.4-ChoqueX | Guía de Reglas MakeX Challenge Storm Breaker, 2026.9 v1.1, Sección 4.4 Choque X | Golpear la marca X con pelotas para que el color propio mire hacia el campo propio: 30 pts; sin contacto con el robot. | TBD | TBD | TBD | TBD | TBD | Sin verificar |
| RC-4.4-ColgadoBandera | Guía de Reglas MakeX Challenge Storm Breaker, 2026.9 v1.1, Sección 4.4 Colgado de la Bandera del Equipo | Solo etapa final: colgar la bandera del equipo en el asta propia: 50 pts; una bandera por robot por partida; la bandera debe mostrar el nombre del equipo propio; sin contacto con el suelo/robot; una bandera por asta. | TBD | TBD | TBD | TBD | TBD | Sin verificar |
| RC-4.5-Puntuación | Guía de Reglas MakeX Challenge Storm Breaker, 2026.9 v1.1, Sección 4.5 Explicación de Puntuación | Puntuación final del estado estático después de la partida; pelotas 10 c/u (máx 100), pelotas de bonificación 20 c/u (máx 21), cubos de letras 30 c/u (máx 8), conos 20 c/u (máx 4), pinos 10 o 30 c/u (máx 8), marca X 30 pts, bandera 50 pts, desafío MAKEX +50/+100. | TBD | TBD | TBD | TBD | TBD | Sin verificar |
| RC-4.6-SorteoProp | Guía de Reglas MakeX Challenge Storm Breaker, 2026.9 v1.1, Sección 4.6 Sorteo del Orden de Colocación | Sortear la Tarjeta de Prop antes de la partida; colocar 4 conos + 4 cubos de bonificación; sin tocar el robot durante la colocación; violación = el robot permanece en el inicio durante la etapa automática. | TBD | TBD | TBD | TBD | TBD | Sin verificar |
| RC-4.6-Auto | Guía de Reglas MakeX Challenge Storm Breaker, 2026.9 v1.1, Sección 4.6 Etapa Automática | 30 s; robots apagados en el inicio; el operador enciende después de la cuenta regresiva; ejecuta el programa automático preestablecido. | TBD | TBD | TBD | TBD | TBD | Sin verificar |
| RC-4.6-Intercambio | Guía de Reglas MakeX Challenge Storm Breaker, 2026.9 v1.1, Sección 4.6 Intercambio de Cubos de Bonificación | No consume tiempo de partida; el equipo solicita al árbitro; las pelotas se colocan en el área de recursos propia; los cubos usados se retiran; una oportunidad de intercambio por partida. | TBD | TBD | TBD | TBD | TBD | Sin verificar |
| RC-4.6-Manual | Guía de Reglas MakeX Challenge Storm Breaker, 2026.9 v1.1, Sección 4.6 Etapa Manual | 100 s; cuenta regresiva de 5 s; controlador Bluetooth; el observador puede tirar de la barrera del área de recursos propia una vez para liberar pelotas. | TBD | TBD | TBD | TBD | TBD | Sin verificar |
| RC-4.6-Modificación | Guía de Reglas MakeX Challenge Storm Breaker, 2026.9 v1.1, Sección 4.6 Etapa de Modificación | 60 s; robot retirado de la arena (proyección en el inicio) para modificar; límites de largo/ancho, altura ilimitada; regresar antes de que termine la cuenta regresiva o el robot se desactiva; recursos adquiridos colocados en el inicio con aprobación del árbitro. | TBD | TBD | TBD | TBD | TBD | Sin verificar |
| RC-4.6-Final | Guía de Reglas MakeX Challenge Storm Breaker, 2026.9 v1.1, Sección 4.6 Etapa Final | 90 s; cuenta regresiva de 5 s; el operador controla mediante Bluetooth; al final detener el robot, colocar el controlador en la canasta y salir de la arena. | TBD | TBD | TBD | TBD | TBD | Sin verificar |
| RC-4.6-Firma | Guía de Reglas MakeX Challenge Storm Breaker, 2026.9 v1.1, Sección 4.6 Puntuación del Árbitro y Confirmación de Firma del Participante | Los capitanes confirman el resultado y firman; las objeciones se escriben en la columna de observaciones sin firmar; ayudar a restaurar los accesorios y salir de manera ordenada. | TBD | TBD | TBD | TBD | TBD | Sin verificar |
| RC-T01 | Guía de Reglas MakeX Challenge Storm Breaker, 2026.9 v1.1, Sección 5.1 T01 | Tamaño inicial ≤500 × 500 × 700 mm; tamaño modificado ≤500 × 500 mm de huella, altura ilimitada; mostrar el tamaño máximo en la inspección. | TBD | TBD | TBD | TBD | TBD | Sin verificar |
| RC-T02 | Guía de Reglas MakeX Challenge Storm Breaker, 2026.9 v1.1, Sección 5.1 T02 | Peso neto máximo ≤10 kg incluyendo batería, excluyendo la bandera del equipo. | TBD | TBD | TBD | TBD | TBD | Sin verificar |
| RC-T03 | Guía de Reglas MakeX Challenge Storm Breaker, 2026.9 v1.1, Sección 5.1 T03 | Símbolo con número/nombre del equipo con caracteres >3.5 cm, fondo claro; no conforme = falla la inspección. | TBD | TBD | TBD | TBD | TBD | Sin verificar |
| RC-T04 | Guía de Reglas MakeX Challenge Storm Breaker, 2026.9 v1.1, Sección 5.1 T04 | Definición del sistema de tracción: placa principal + chasis/ruedas/orugas/estructura de contacto con el suelo. | TBD | TBD | TBD | TBD | TBD | Sin verificar |
| RC-T05 | Guía de Reglas MakeX Challenge Storm Breaker, 2026.9 v1.1, Sección 5.1 T05 | Un robot por equipo; el sistema de tracción no se puede modificar en la etapa de modificación; violación = descalificación. | TBD | TBD | TBD | TBD | TBD | Sin verificar |
| RC-T06 | Guía de Reglas MakeX Challenge Storm Breaker, 2026.9 v1.1, Sección 5.1 T06 | El reemplazo de componentes rotos (rueda, motor, placa principal) no se considera reemplazo del sistema de tracción. | TBD | TBD | TBD | TBD | TBD | Sin verificar |
| RC-T07 | Guía de Reglas MakeX Challenge Storm Breaker, 2026.9 v1.1, Sección 5.1 T07 | Lubricante permitido pero no debe gotear en la arena. | TBD | TBD | TBD | TBD | TBD | Sin verificar |
| RC-T08 | Guía de Reglas MakeX Challenge Storm Breaker, 2026.9 v1.1, Sección 5.1 T08 | Prohibido: ángulos afilados; piezas hidráulicas; interruptores/contactos con mercurio; piezas conductoras de corriente; piezas en forma de gancho para conexión; otras piezas peligrosas. | TBD | TBD | TBD | TBD | TBD | Sin verificar |
| RC-T09 | Guía de Reglas MakeX Challenge Storm Breaker, 2026.9 v1.1, Sección 5.1 T09 | Materiales prohibidos: gases inflamables/explosivos; líquidos/sustancias gelatinosas (excepto pequeñas cantidades de pegamento/lubricante); materiales que contaminen la arena; tejido animal; otros materiales peligrosos. | TBD | TBD | TBD | TBD | TBD | Sin verificar |
| RC-T10 | Guía de Reglas MakeX Challenge Storm Breaker, 2026.9 v1.1, Sección 5.1 T10 | Límites de motores/servos: total de motores ≤13, servos ≤6, brushless ≤2; solo se permiten DC 25/37/180 gear, brushless 2823/2824, encoder 180, servo MS-12A; sin modificación mecánica/eléctrica excepto longitud del cable externo. | TBD | TBD | TBD | TBD | TBD | Sin verificar |
| RC-T11 | Guía de Reglas MakeX Challenge Storm Breaker, 2026.9 v1.1, Sección 5.1 T11 | Una batería por robot (excepto mira láser), fijada dentro del robot; no debe colisionar ni separarse. | TBD | TBD | TBD | TBD | TBD | Sin verificar |
| RC-T12 | Guía de Reglas MakeX Challenge Storm Breaker, 2026.9 v1.1, Sección 5.1 T12 | Mira láser ≤5 mW (por debajo de Clase 3a/R); máximo una por robot. | TBD | TBD | TBD | TBD | TBD | Sin verificar |
| RC-T13 | Guía de Reglas MakeX Challenge Storm Breaker, 2026.9 v1.1, Sección 5.1 T13 | Cables de batería intactos, sin grietas/roturas/cables expuestos; aislamiento eléctrico entre líneas de alimentación y estructura del robot. | TBD | TBD | TBD | TBD | TBD | Sin verificar |
| RC-T14 | Guía de Reglas MakeX Challenge Storm Breaker, 2026.9 v1.1, Sección 5.1 T14 | Especificaciones de alimentación/placa principal/sensores: Li-Po 3S 11.1 V, 25–30C, 4200 mAh; placa principal M7 ATSAMS70N20A-AN + STM32F030CCT6, 6–13 V; Raspberry Pi 3 B+ permitida; módulo de visión ≥1 tipo ilimitado, 90°, 3.05 ± 5% mm, <60 fps, 3.7 V Li-Po o mBuild, 1–2 W, protocolo mBuild; sensores de distancia/movimiento/color/ultrasonido según especificación; sin sensores que interfieran con otros robots; controlador Bluetooth 4.0+, 20 m, ≤25 mA, 4 dBm, ≤100 ms, pilas AA, macOS/Windows; módulo Bluetooth BT4.0, 2402–2480 MHz, 1.5 dBi, ≤4 dBm, 15 mA; sin otro control inalámbrico. | TBD | TBD | TBD | TBD | TBD | Sin verificar |
| RC-T15 | Guía de Reglas MakeX Challenge Storm Breaker, 2026.9 v1.1, Sección 5.1 T15 | Sin dispositivos de sonido eléctricos excepto el zumbador integrado; LEDs RGB ≤5 V permitidos para decoración/estado si no interfieren. | TBD | TBD | TBD | TBD | TBD | Sin verificar |
| RC-T16 | Guía de Reglas MakeX Challenge Storm Breaker, 2026.9 v1.1, Sección 5.1 T16 | Piezas mecánicas autoconstruidas/adquiridas permitidas (bisagras, piñones, cadenas, poleas); productos comerciales altamente integrados (manipuladores multi-DOF, manos mecánicas) prohibidos. | TBD | TBD | TBD | TBD | TBD | Sin verificar |
| RC-T17 | Guía de Reglas MakeX Challenge Storm Breaker, 2026.9 v1.1, Sección 5.2 T17 | Bandera del equipo: rectangular, tela/papel/material flexible, ≥400 × 300 mm, incluye el nombre oficial del equipo, sin cortes irregulares; asta rígida, longitud = lado de colgado, sección transversal <10 × 10 mm; total ≤400 × 10 × 10 mm; sin nombres de otros equipos. | TBD | TBD | TBD | TBD | TBD | Sin verificar |
| RC-E01 | Guía de Reglas MakeX Challenge Storm Breaker, 2026.9 v1.1, Sección 6.1 E01 Advertencia | El árbitro emite una advertencia y exige el cese inmediato; puede pausar la partida si se ve afectada la equidad. | TBD | TBD | TBD | TBD | TBD | Sin verificar |
| RC-E02 | Guía de Reglas MakeX Challenge Storm Breaker, 2026.9 v1.1, Sección 6.1 E02 Violación | Primera infracción: −20 pts; reincidencia: −120 pts adicionales. Etapa de clasificación por equipo; etapa de eliminación por alianza (excepto suspensiones). | TBD | TBD | TBD | TBD | TBD | Sin verificar |
| RC-E03 | Guía de Reglas MakeX Challenge Storm Breaker, 2026.9 v1.1, Sección 6.1 E03 Suspensión | El árbitro puede suspender el robot; los competidores deben solicitar la suspensión en caso de mal funcionamiento; queja maliciosa o contacto ilegal conlleva suspensión. | TBD | TBD | TBD | TBD | TBD | Sin verificar |
| RC-E04 | Guía de Reglas MakeX Challenge Storm Breaker, 2026.9 v1.1, Sección 6.1 E04 Descalificación de la Partida Individual | Violaciones graves: robot suspendido, resultado de la partida anulado, otras partidas no afectadas. | TBD | TBD | TBD | TBD | TBD | Sin verificar |
| RC-E05 | Guía de Reglas MakeX Challenge Storm Breaker, 2026.9 v1.1, Sección 6.1 E05 Descalificación de Toda la Competencia | Robot suspendido; el equipo no puede participar en la competencia actual/siguiente; todos los resultados descalificados; pierde el derecho a premios. | TBD | TBD | TBD | TBD | TBD | Sin verificar |
| RC-R01 | Guía de Reglas MakeX Challenge Storm Breaker, 2026.9 v1.1, Sección 6.2 R01 | Sin cinta adhesiva de doble cara, pegamento ni adhesivos para fijar elementos del campo; campo contaminado = inseguro. | TBD | TBD | TBD | TBD | TBD | Sin verificar |
| RC-R02 | Guía de Reglas MakeX Challenge Storm Breaker, 2026.9 v1.1, Sección 6.2 R02 | Sin escalada/colisión intencional con límites o barrera central; sin inclinar/colapsar la fortaleza móvil; violación = descalificación de la partida actual; no intencional sin caída de accesorios = sin penalización; el árbitro puede pausar y restaurar. | TBD | TBD | TBD | TBD | TBD | Sin verificar |
| RC-R03 | Guía de Reglas MakeX Challenge Storm Breaker, 2026.9 v1.1, Sección 6.2 R03 | Sin dañar robots de otros equipos durante el evento; confirmado = descalificación de todo el evento; puede afectar la elegibilidad futura. | TBD | TBD | TBD | TBD | TBD | Sin verificar |
| RC-R04 | Guía de Reglas MakeX Challenge Storm Breaker, 2026.9 v1.1, Sección 6.2 R04 | Materiales/estructuras peligrosas prohibidas (gas inflamable, fuego/humo, hidráulica, mercurio, plomo, contaminantes de arena, materiales de conexión, bordes afilados, tejido animal, líquidos/geles excepto pegamento/lubricante, piezas conductoras de corriente); violación = descalificación de la partida actual; dos violaciones = todos los resultados del evento anulados. | TBD | TBD | TBD | TBD | TBD | Sin verificar |
| RC-R05 | Guía de Reglas MakeX Challenge Storm Breaker, 2026.9 v1.1, Sección 6.2 R05 | El árbitro puede juzgar la seguridad de forma independiente; violación = descalificación de la partida actual; dos violaciones de seguridad = todos los resultados del evento anulados. | TBD | TBD | TBD | TBD | TBD | Sin verificar |
| RC-R06 | Guía de Reglas MakeX Challenge Storm Breaker, 2026.9 v1.1, Sección 6.2 R06 | Sin proyección del robot/fortaleza móvil más allá del límite del campo o área designada (excepto etapa de modificación); cuenta regresiva de 3 s para regresar; fallo = −20 pts, reincidencia = −120 pts. | TBD | TBD | TBD | TBD | TBD | Sin verificar |
| RC-R07 | Guía de Reglas MakeX Challenge Storm Breaker, 2026.9 v1.1, Sección 6.3 R07 | 1 operador + 1 observador por equipo; 2 operadores + 2 observadores por alianza; uno seleccionado como capitán de alianza. | TBD | TBD | TBD | TBD | TBD | Sin verificar |
| RC-R08 | Guía de Reglas MakeX Challenge Storm Breaker, 2026.9 v1.1, Sección 6.3 R08 | Sin sustitución por terceras personas; el operador controla el robot; operador/observador pueden intercambiar roles durante la partida. | TBD | TBD | TBD | TBD | TBD | Sin verificar |
| RC-R09 | Guía de Reglas MakeX Challenge Storm Breaker, 2026.9 v1.1, Sección 6.3 R09 | Recoger el cabello largo; no usar calzado que deje los dedos al descubierto. | TBD | TBD | TBD | TBD | TBD | Sin verificar |
| RC-R10 | Guía de Reglas MakeX Challenge Storm Breaker, 2026.9 v1.1, Sección 6.3 R10 | Usar gafas de protección durante la competencia; corrección inmediata y reinspección; negativa/grave = descalificación de la partida actual (otras partidas no afectadas). | TBD | TBD | TBD | TBD | TBD | Sin verificar |
| RC-R11 | Guía de Reglas MakeX Challenge Storm Breaker, 2026.9 v1.1, Sección 6.3 R11 | Permanecer dentro del área de operación propia; regreso en 3 s con cuenta regresiva; primer fallo = −20 pts, reincidencia = −120 pts. | TBD | TBD | TBD | TBD | TBD | Sin verificar |
| RC-R12 | Guía de Reglas MakeX Challenge Storm Breaker, 2026.9 v1.1, Sección 6.3 R12 | Llegar a tiempo; >5 min de retraso = forfeit voluntario; descalificación solo de la partida actual. | TBD | TBD | TBD | TBD | TBD | Sin verificar |
| RC-R13 | Guía de Reglas MakeX Challenge Storm Breaker, 2026.9 v1.1, Sección 6.3 R13 | Sin activación del robot antes del inicio del árbitro; violación = −20 pts; reincidencia = suspensión; ventaja obtenida invalidada y campo restaurado. | TBD | TBD | TBD | TBD | TBD | Sin verificar |
| RC-R14 | Guía de Reglas MakeX Challenge Storm Breaker, 2026.9 v1.1, Sección 6.3 R14 | Detener el control/robot después de cada etapa (excepto inercia); violación = −20 pts; ventaja invalidada. | TBD | TBD | TBD | TBD | TBD | Sin verificar |
| RC-R15 | Guía de Reglas MakeX Challenge Storm Breaker, 2026.9 v1.1, Sección 6.3 R15 | Sin dispositivos de comunicación electrónicos para contactar personas fuera del sitio; violación = descalificación de la ronda actual. | TBD | TBD | TBD | TBD | TBD | Sin verificar |
| RC-R16 | Guía de Reglas MakeX Challenge Storm Breaker, 2026.9 v1.1, Sección 6.3 R16 | BO3: 5 min de depuración después de cada partida; sin tiempo extra; violación = descalificación de la ronda actual. | TBD | TBD | TBD | TBD | TBD | Sin verificar |
| RC-R17 | Guía de Reglas MakeX Challenge Storm Breaker, 2026.9 v1.1, Sección 6.3 R17 | Sin quejas maliciosas; confirmada = robot infractor suspendido de la partida actual. | TBD | TBD | TBD | TBD | TBD | Sin verificar |
| RC-R18 | Guía de Reglas MakeX Challenge Storm Breaker, 2026.9 v1.1, Sección 6.3 R18 | Conducta respetuosa; sin burlas/abusos/peleas; negativa tras advertencia = descalificación de la partida actual; grave = todo el evento; puede afectar la elegibilidad futura. | TBD | TBD | TBD | TBD | TBD | Sin verificar |
| RC-R19 | Guía de Reglas MakeX Challenge Storm Breaker, 2026.9 v1.1, Sección 6.4 R19 | Controlador Bluetooth conectado antes de la partida; colocado fuera de la arena durante la etapa automática; recogerlo solo después de la automática; detener el control después de la manual; violación = −20 pts o suspensión/descalificación. | TBD | TBD | TBD | TBD | TBD | Sin verificar |
| RC-R20 | Guía de Reglas MakeX Challenge Storm Breaker, 2026.9 v1.1, Sección 6.4 R20 | Sin control después de la suspensión; violación = descalificación de la partida actual. | TBD | TBD | TBD | TBD | TBD | Sin verificar |
| RC-R21 | Guía de Reglas MakeX Challenge Storm Breaker, 2026.9 v1.1, Sección 6.4 R21 | Sin desprendimiento de piezas ni dejar mecanismos; piezas menores no estructurales exentas; primera = −20 pts; reincidencia = suspensión. | TBD | TBD | TBD | TBD | TBD | Sin verificar |
| RC-R22 | Guía de Reglas MakeX Challenge Storm Breaker, 2026.9 v1.1, Sección 6.4 R22 | El tamaño/peso del robot debe cumplir durante toda la partida (excepto deformación no humana); violación = descalificación de la partida actual. | TBD | TBD | TBD | TBD | TBD | Sin verificar |
| RC-R23 | Guía de Reglas MakeX Challenge Storm Breaker, 2026.9 v1.1, Sección 6.4 R23 | Sin lanzar/mover intencionalmente elementos del campo al campo del oponente o fuera de la arena (pelotas exentas si es movimiento normal); primera = −20 pts; reincidencia = −120 pts; elementos de puntuación retirados inválidos. | TBD | TBD | TBD | TBD | TBD | Sin verificar |
| RC-R24 | Guía de Reglas MakeX Challenge Storm Breaker, 2026.9 v1.1, Sección 6.4 R24 | Sin contacto directo/indirecto con la marca X; el árbitro pausa y restaura; primera = −20 pts; reincidencia = −120 pts. | TBD | TBD | TBD | TBD | TBD | Sin verificar |
| RC-R25 | Guía de Reglas MakeX Challenge Storm Breaker, 2026.9 v1.1, Sección 6.4 R25 | Sin retirar elementos de puntuación del área superior de la fortaleza propia; el árbitro puede restaurar; ventaja invalidada; primera = −20 pts; reincidencia = −120 pts. | TBD | TBD | TBD | TBD | TBD | Sin verificar |
| RC-R26 | Guía de Reglas MakeX Challenge Storm Breaker, 2026.9 v1.1, Sección 6.4 R26 | Ninguna parte del robot puede entrar al canal del área de estrategia; el árbitro puede pausar/restaurar; ventaja invalidada; primera = −20 pts; reincidencia = −120 pts. | TBD | TBD | TBD | TBD | TBD | Sin verificar |
| RC-R27 | Guía de Reglas MakeX Challenge Storm Breaker, 2026.9 v1.1, Sección 6.4 R27 | Sin obstruir/restringir robots oponentes o interacción con elementos del campo; 3 s para desenganchar; primera = −20 pts; reincidencia = −120 pts. | TBD | TBD | TBD | TBD | TBD | Sin verificar |
| RC-R28 | Guía de Reglas MakeX Challenge Storm Breaker, 2026.9 v1.1, Sección 6.4 R28 | Sin contacto directo/indirecto con el robot propio fuera de la etapa de modificación; robot desactivado; −20 pts; reincidencia = −120 pts. | TBD | TBD | TBD | TBD | TBD | Sin verificar |
| RC-R29 | Guía de Reglas MakeX Challenge Storm Breaker, 2026.9 v1.1, Sección 6.4 R29 | Sin tocar/mover elementos del campo fuera de la modificación permitida; soltar el controlador y retroceder al final; primera = −20 pts; reincidencia = −120 pts; elementos de puntuación tocados inválidos y retirados. | TBD | TBD | TBD | TBD | TBD | Sin verificar |
| RC-R30 | Guía de Reglas MakeX Challenge Storm Breaker, 2026.9 v1.1, Sección 6.4 R30 | Modificación/reinicio solo con el robot parcial o totalmente en el área de inicio propia; dos robots no pueden ocupar la misma área de inicio; sin retiro fuera de la modificación; violación = suspensión de la partida. | TBD | TBD | TBD | TBD | TBD | Sin verificar |
| RC-R31 | Guía de Reglas MakeX Challenge Storm Breaker, 2026.9 v1.1, Sección 6.4 R31 | Sin personas ajenas al equipo (padres, mentores, profesores) en el área de competencia o dando instrucciones; primera = −20 pts; el árbitro puede aumentar hasta descalificación de la partida actual. | TBD | TBD | TBD | TBD | TBD | Sin verificar |
| RC-R32 | Guía de Reglas MakeX Challenge Storm Breaker, 2026.9 v1.1, Sección 6.4 R32 | Sin contacto/comunicación con personas fuera del campo o espectadores durante la partida (transferencia de piezas, controladores o comunicación verbal); primera = −20 pts; el árbitro puede aumentar hasta descalificación. | TBD | TBD | TBD | TBD | TBD | Sin verificar |
| RC-R33 | Guía de Reglas MakeX Challenge Storm Breaker, 2026.9 v1.1, Sección 6.4 R33 | Antes de la etapa manual, las pelotas de bonificación obtenidas deben colocarse en el área de recursos propia; después del inicio de la manual, las pelotas de bonificación no canjeadas se vuelven inválidas. | TBD | TBD | TBD | TBD | TBD | Sin verificar |
| RC-R34 | Guía de Reglas MakeX Challenge Storm Breaker, 2026.9 v1.1, Sección 6.5 R34 | Al final de la etapa manual, el robot debe retirarse del área de inicio (parcial o totalmente) para modificaciones; si no está en el área de inicio, no puede operar durante la etapa de modificación; violación = suspensión inmediata de la partida. | TBD | TBD | TBD | TBD | TBD | Sin verificar |
| RC-R35 | Guía de Reglas MakeX Challenge Storm Breaker, 2026.9 v1.1, Sección 6.5 R35 | La modificación solo puede realizarse después de que la proyección vertical del robot esté completamente fuera de la arena; no se puede modificar con el robot suspendido justo encima de la arena; violación = suspensión inmediata. | TBD | TBD | TBD | TBD | TBD | Sin verificar |
| RC-R36 | Guía de Reglas MakeX Challenge Storm Breaker, 2026.9 v1.1, Sección 6.5 R36 | Al retirar el robot de la arena, los competidores no pueden tocar accesorios de puntuación sin contacto con el robot ni cambiar su estado. | TBD | TBD | TBD | TBD | TBD | Sin verificar |
| RC-R37 | Guía de Reglas MakeX Challenge Storm Breaker, 2026.9 v1.1, Sección 6.5 R37 | Al retirar el robot, no puede llevar accesorios de puntuación excepto pelotas; los demás accesorios deben colocarse cerca en la arena; si afecta la puntuación, el árbitro invalida y restaura; −20 pts; elementos tocados ilegalmente invalidados y retirados. | TBD | TBD | TBD | TBD | TBD | Sin verificar |
| RC-R38 | Guía de Reglas MakeX Challenge Storm Breaker, 2026.9 v1.1, Sección 6.5 R38 | El robot debe colocarse en su área de inicio antes del final de la etapa de modificación; no puede comenzar la modificación suspendido en el aire o sobre el campo; violación = suspensión inmediata. | TBD | TBD | TBD | TBD | TBD | Sin verificar |
| RC-R39 | Guía de Reglas MakeX Challenge Storm Breaker, 2026.9 v1.1, Sección 6.5 R39 | Después de la etapa de modificación, los robots deben cumplir todos los requisitos de la competencia; violación = suspensión inmediata. | TBD | TBD | TBD | TBD | TBD | Sin verificar |
| RC-7.1-Confirmación | Guía de Reglas MakeX Challenge Storm Breaker, 2026.9 v1.1, Sección 7.1 Confirmación de Resultados | Los capitanes confirman resultados y firman; sin objeciones después de firmar; errores de cálculo corregidos por el personal de aprobación; otros problemas no se tratan. | TBD | TBD | TBD | TBD | TBD | Sin verificar |
| RC-7.1-Disputa | Guía de Reglas MakeX Challenge Storm Breaker, 2026.9 v1.1, Sección 7.1 Resolución de Disputas | Si hay objeciones, rechazar firmar y escribir claramente en observaciones; el comité solo trata apelaciones relacionadas con las razones declaradas. | TBD | TBD | TBD | TBD | TBD | Sin verificar |
| RC-7.2-Apelación | Guía de Reglas MakeX Challenge Storm Breaker, 2026.9 v1.1, Sección 7.2 Procedimiento de Apelación y Período Válido | Apelar dentro del período válido (normalmente 30 min después de la partida) mediante formulario; el capitán debe estar presente; solo capitanes/competidores pueden estar presentes; el comité puede comunicarse a solas con el equipo. | TBD | TBD | TBD | TBD | TBD | Sin verificar |
| RC-7.3-Inválida | Guía de Reglas MakeX Challenge Storm Breaker, 2026.9 v1.1, Sección 7.3 Apelación Inválida | Apelaciones fuera de plazo, personal no autorizado, apelaciones poco claras/emocionales o incívicas son inválidas; advertencias múltiples pueden llevar a descalificación. | TBD | TBD | TBD | TBD | TBD | Sin verificar |
| RC-7.4-Arbitraje | Guía de Reglas MakeX Challenge Storm Breaker, 2026.9 v1.1, Sección 7.4 Procedimiento de Arbitraje | Comisión de Arbitraje (árbitro jefe, consultor, director técnico); resultados: mantener resultado original o repetir partida; sin segunda apelación; si se repite, ambos equipos deben presentarse en 5 min o se considera retiro. | TBD | TBD | TBD | TBD | TBD | Sin verificar |
| RC-Ap3-Autoinspección | Guía de Reglas MakeX Challenge Storm Breaker, 2026.9 v1.1, Apéndice 3 Formulario de Autoinspección del Robot | Completar y firmar el formulario con datos reales (tamaño, peso, cantidad de módulos de visión, motores, servos, brushless, controlador Bluetooth, batería); verificar estructuras peligrosas, materiales prohibidos, seguridad personal, piezas personalizadas, sujeción de bordes afilados, no desprendimiento, no interferencia, número de equipo, entrega del cuaderno, no contaminación. | TBD | TBD | TBD | TBD | TBD | Sin verificar |
| RC-Ap6-GestiónEnergía | Guía de Reglas MakeX Challenge Storm Breaker, 2026.9 v1.1, Apéndice 6 Módulo de Gestión de Energía | Módulo de gestión de energía obligatorio; tamaño 85 × 56 × 11.5 mm; voltaje 6–12 V; indicadores LED; tubo digital de 2 dígitos (canal 1–40 o "Er"); zumbador; botón multifunción (reset, clic, doble clic, pulsación larga); código de identificación de señal de inicio automático en el programa; instalación segura con cables firmes; antena sin interferencias; ID escaneable; no reemplazar batería ni presionar reset después del inicio. | TBD | TBD | TBD | TBD | TBD | Sin verificar |

## Impacto del cambio

| Cambio en la fuente | IDs de reglas/requisitos afectados | Diseño/estrategia afectados | Re-prueba necesaria | Responsable | Decisión del cuaderno |
| --- | --- | --- | --- | --- | --- |
| TBD | TBD | TBD | TBD | TBD | TBD |

Registrar el incumplimiento en [problemas conocidos](../05_integration/known_issues.md). Vincular las acciones correctivas al [plan de verificación](../06_verification/verification_plan.md) y al [registro de diseño](../08_engineering_notebook/design_log/entry_template.md). No marcar "cumplido" basándose únicamente en un diseño previsto.
