Robotica76/2026_MakeX_Challengue/mechanical/flag_system/drawings/v22/v22_9_flag_mast_modification_stage_exploded.pdf

## N.º Pieza

### 9.1 FLAG cabeza C PETG

### 9.2 FLAG mastil tubo CF 8x6

### 9.3 FLAG ligas x2

### 9.4 FLAG pasador R D3

# 9. Mástil de bandera (Modification Stage)

## 4 piezas · explosión radial del subsistema

### MakeX Challenge 2026 · Storm Breaker v22

9.3

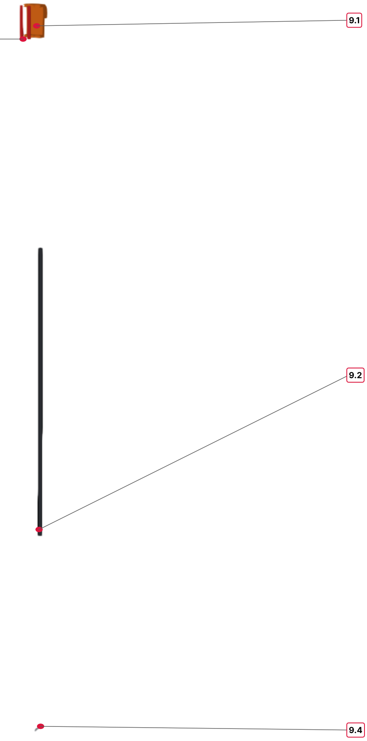
[picture p29: figure]

Medidas en mm. Numeración: subsistema.pieza (piezas ordenadas de mayor a menor volumen). Tornillería no se muestra en las explosionadas. | Hoja 11
