Robotica76/2026_MakeX_Challengue/mechanical/ball_intake/cad/3860x0.webp

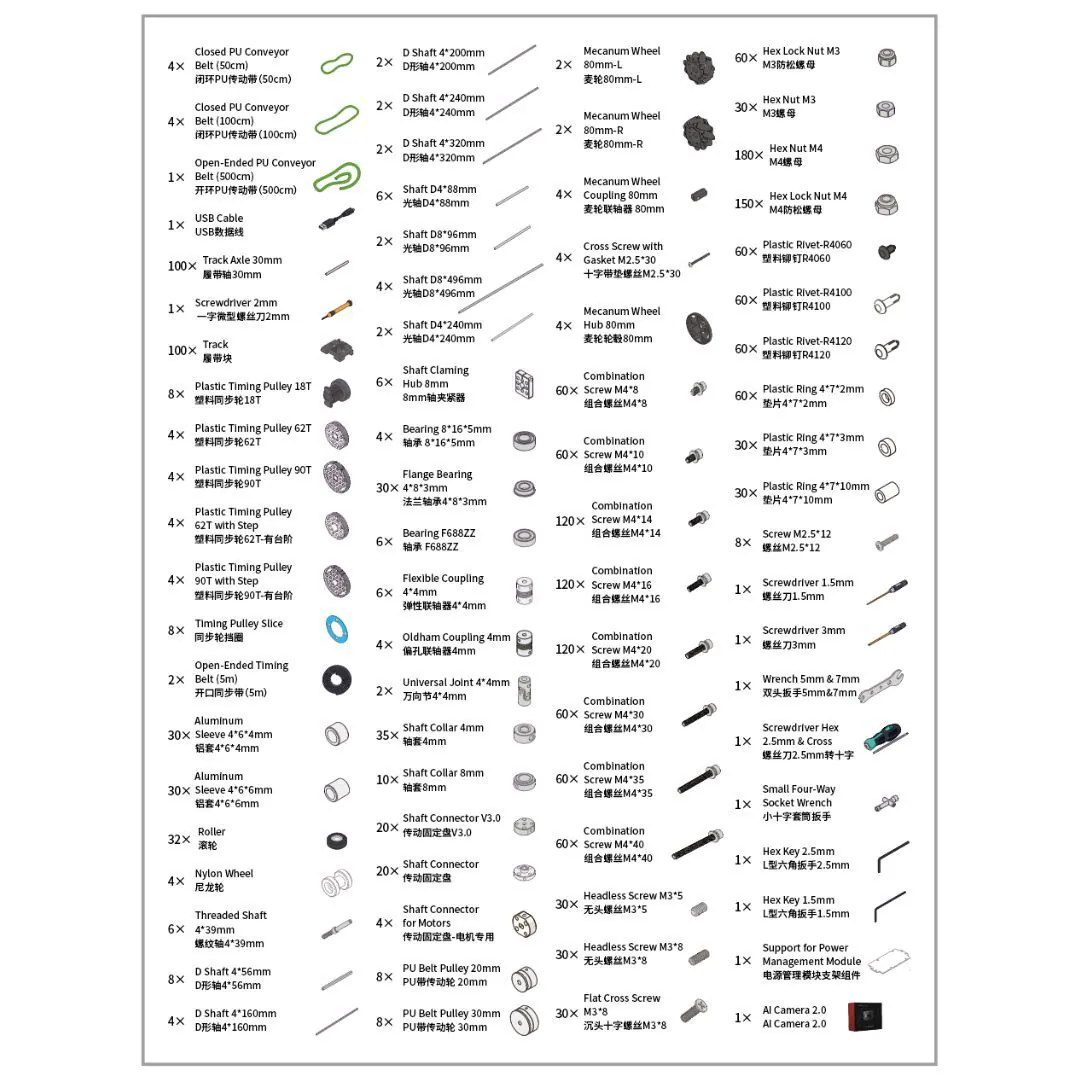
mechanical/ball_intake/cad/3860x0.webp
