Robotica76/2026_MakeX_Challengue/mechanical/ball_intake/cad/3860x.webp

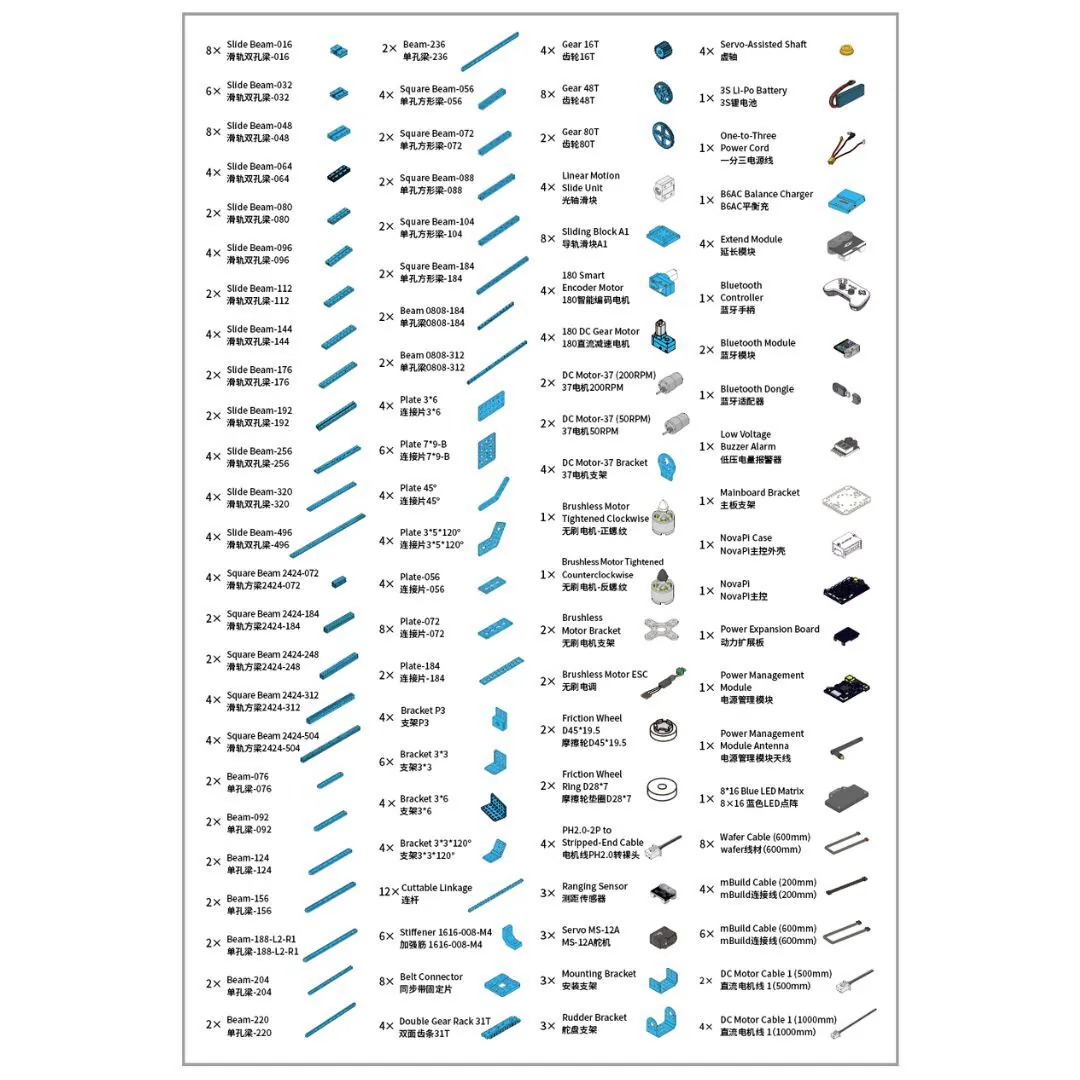
mechanical/ball_intake/cad/3860x.webp
