Robotica76/2026_MakeX_Challengue/mechanical/ball_intake/drawings/v22/v22_4_ball_intake_and_ur_arm_exploded.png

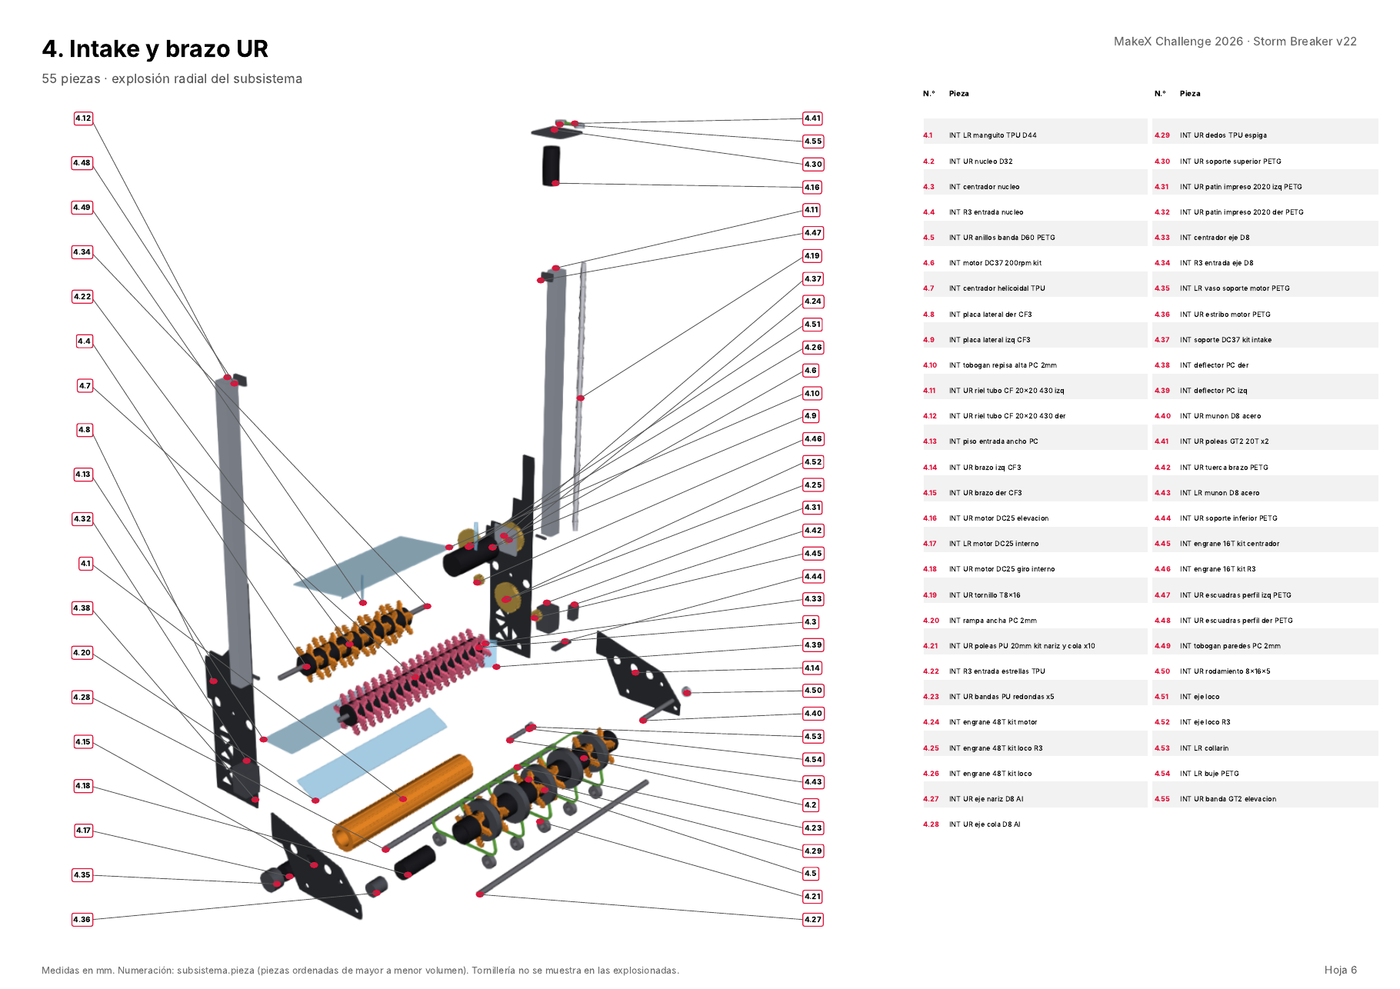
mechanical/ball_intake/drawings/v22/v22_4_ball_intake_and_ur_arm_exploded.png
