Robotica76/2026_MakeX_Challengue/mechanical/ball_intake/prototypes/v22/simulacion_cono_v15.png

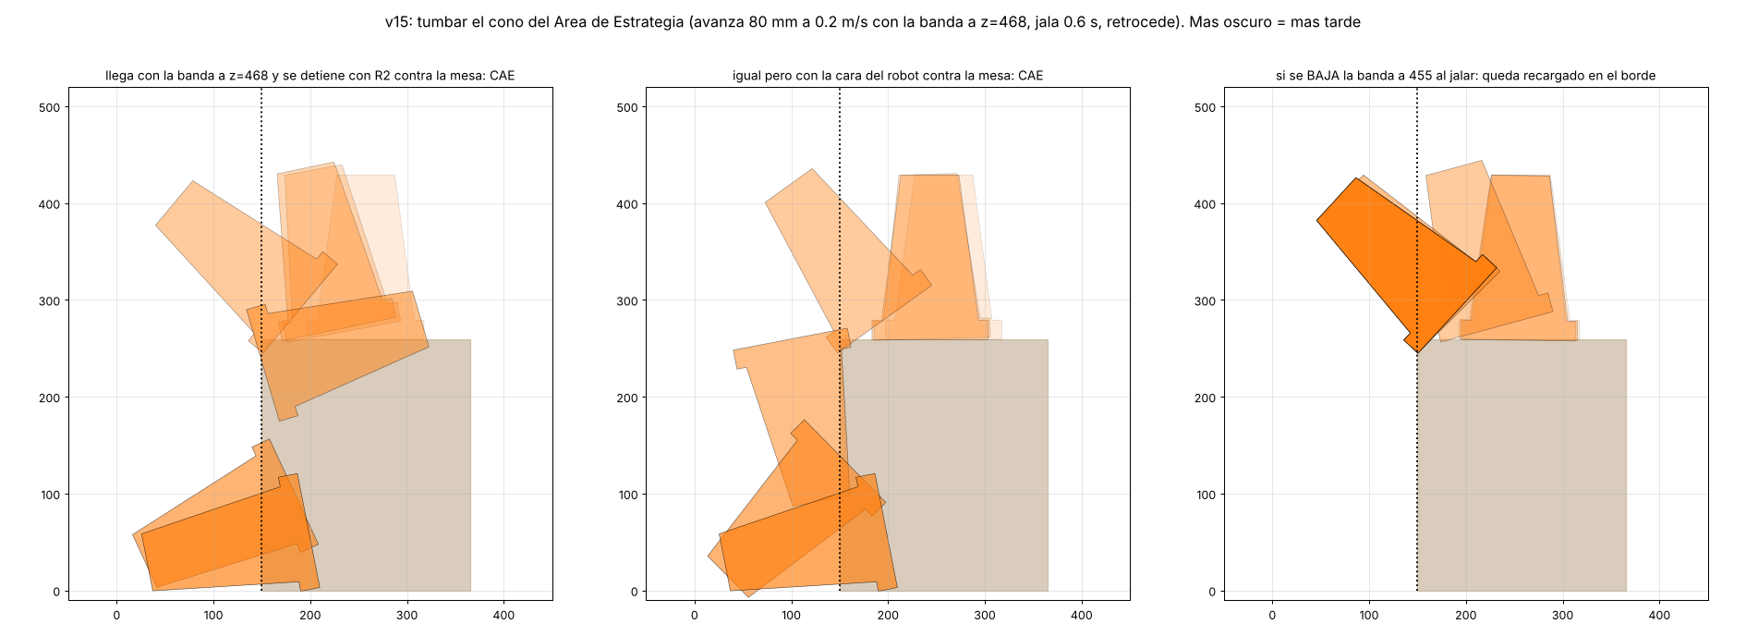
mechanical/ball_intake/prototypes/v22/simulacion_cono_v15.png
