Robotica76/2026_MakeX_Challengue/mechanical/ball_intake/prototypes/v22/simulacion_recoleccion_torre_v19.png

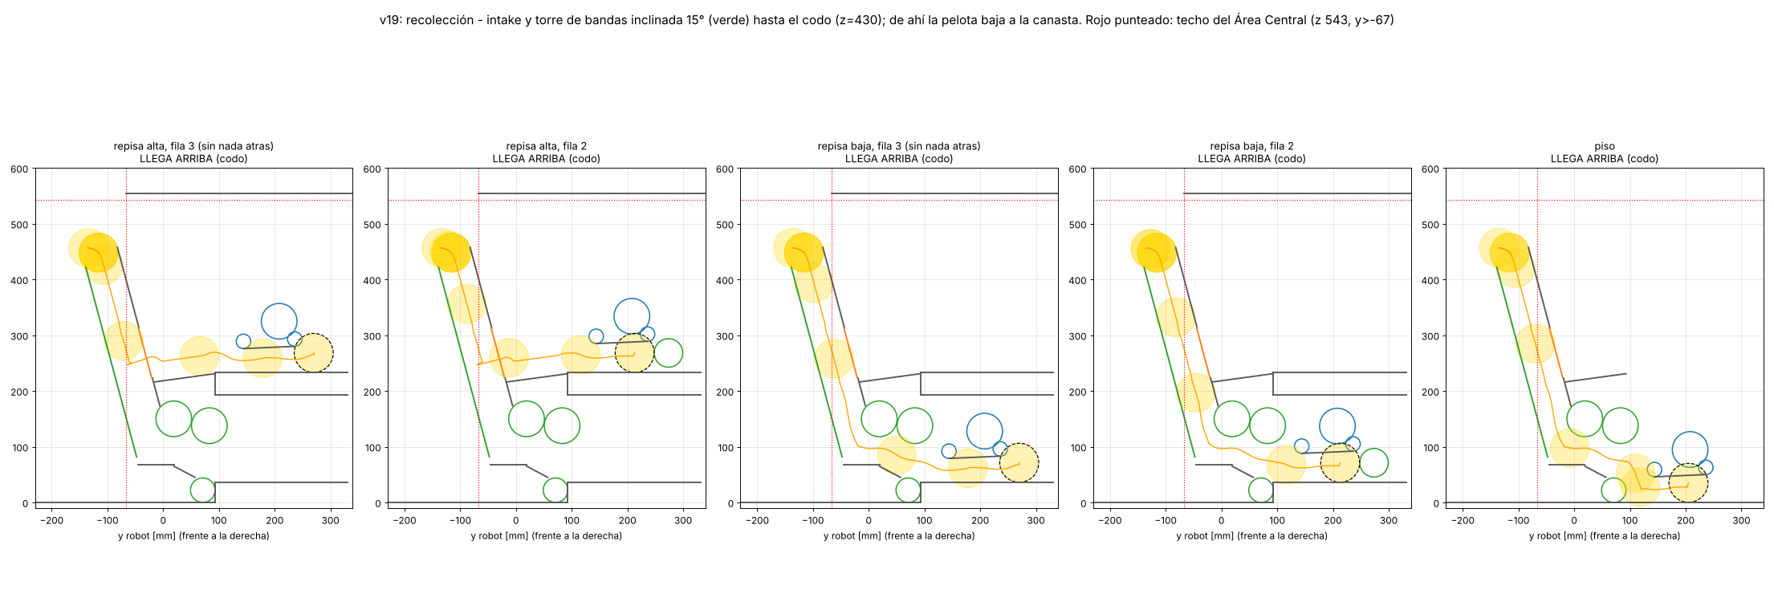
mechanical/ball_intake/prototypes/v22/simulacion_recoleccion_torre_v19.png
