Robotica76/2026_MakeX_Challengue/mechanical/ball_storage/drawings/v22/v22_8_basket_and_feed_roller_exploded.png

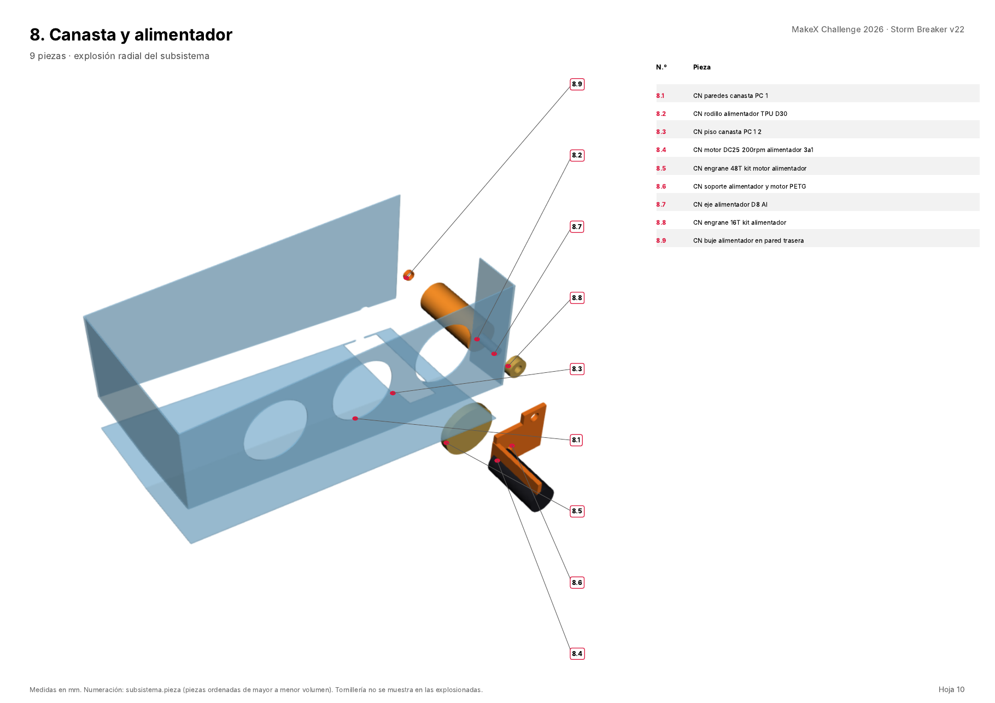
mechanical/ball_storage/drawings/v22/v22_8_basket_and_feed_roller_exploded.png
