Robotica76/2026_MakeX_Challengue/mechanical/ball_storage/prototypes/v22/simulacion_lanzador_al_reves_v19.png

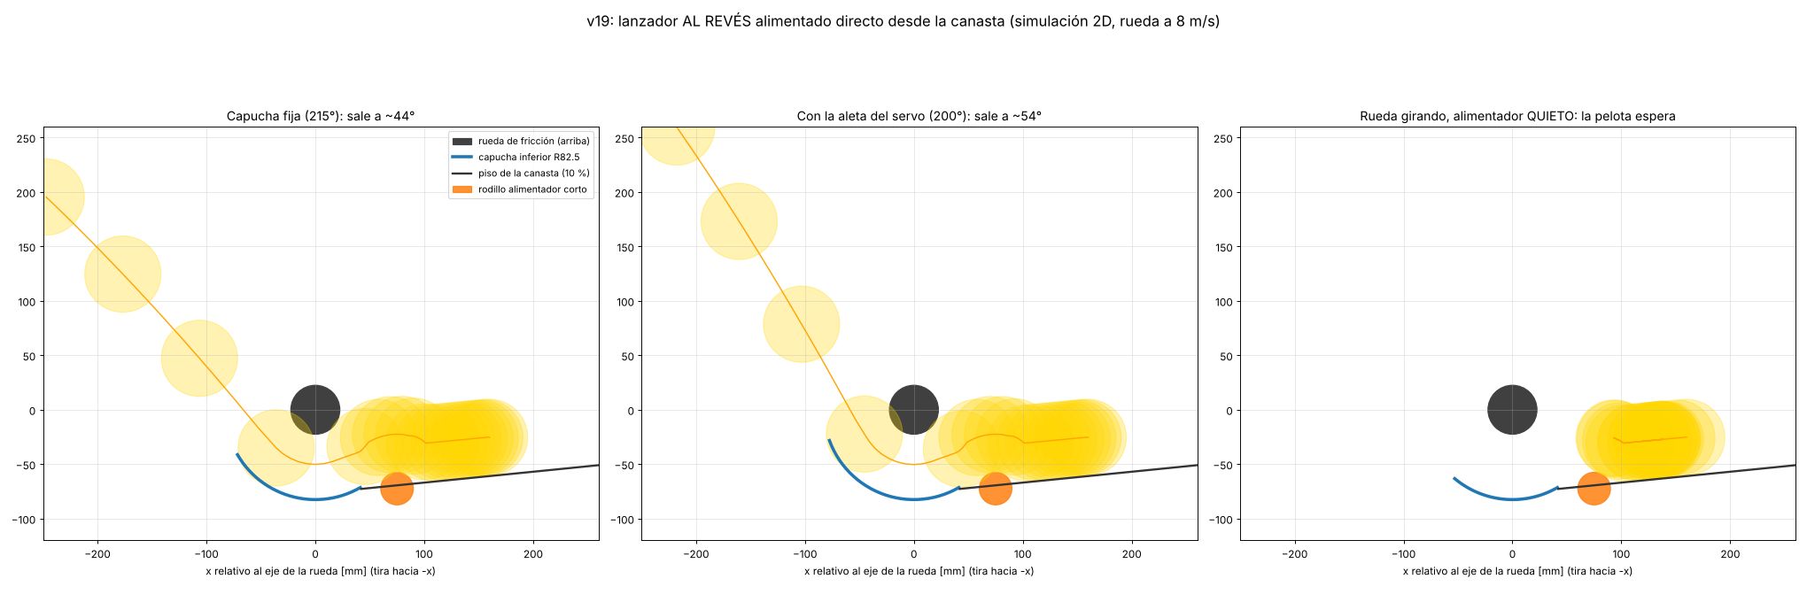
mechanical/ball_storage/prototypes/v22/simulacion_lanzador_al_reves_v19.png
