Robotica76/2026_MakeX_Challengue/mechanical/chassis/drawings/v22/v22_1_chassis_and_drive_exploded.png

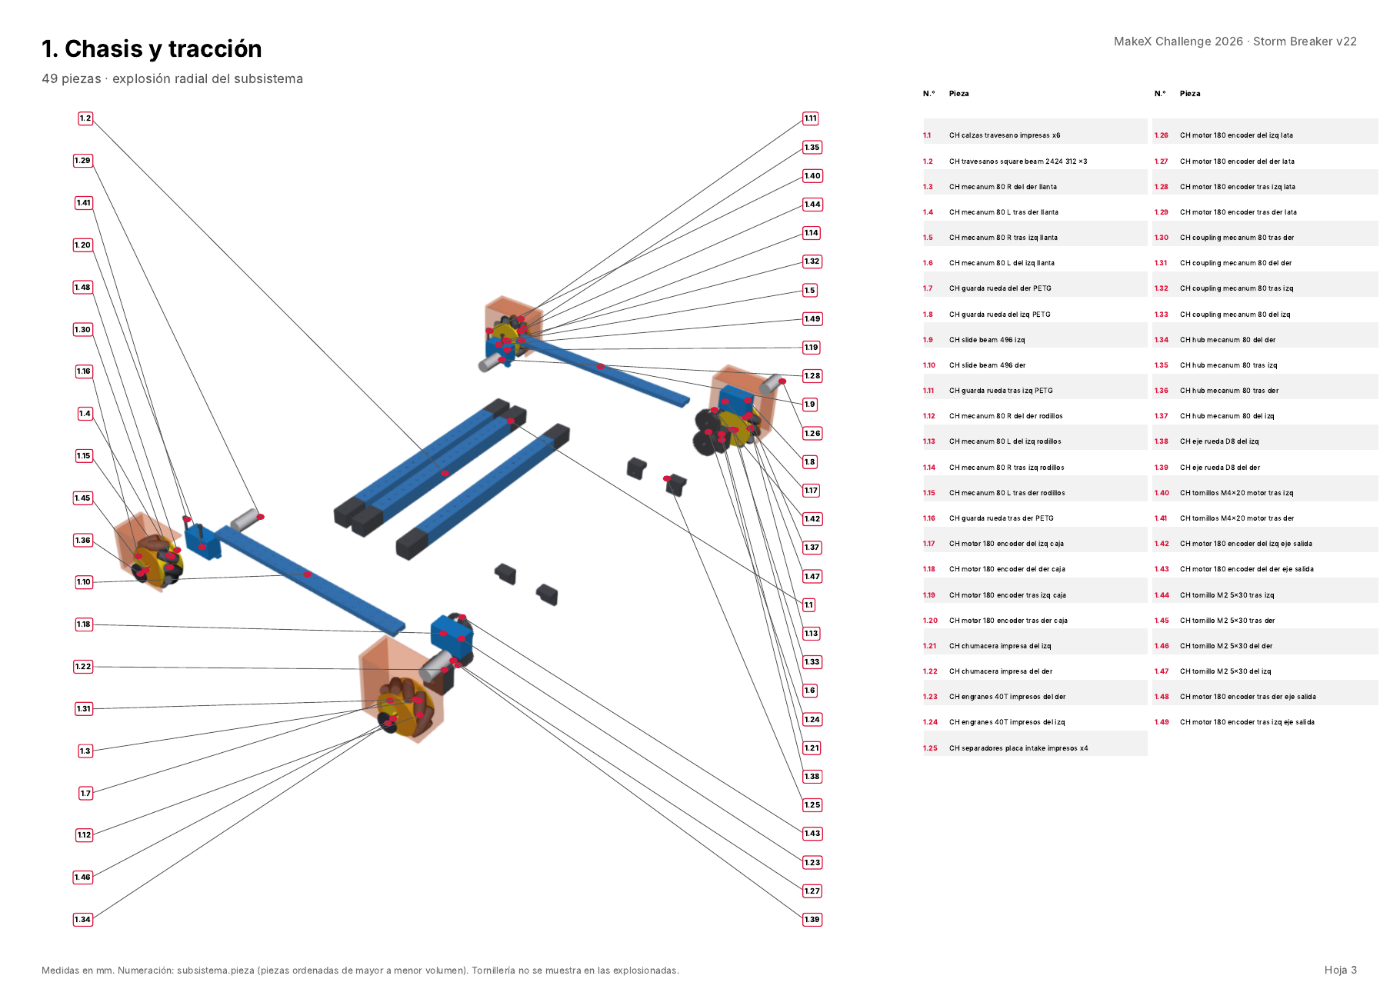
mechanical/chassis/drawings/v22/v22_1_chassis_and_drive_exploded.png
