Robotica76/2026_MakeX_Challengue/mechanical/chassis/drawings/v22/v22_2_electronics_box_exploded.png

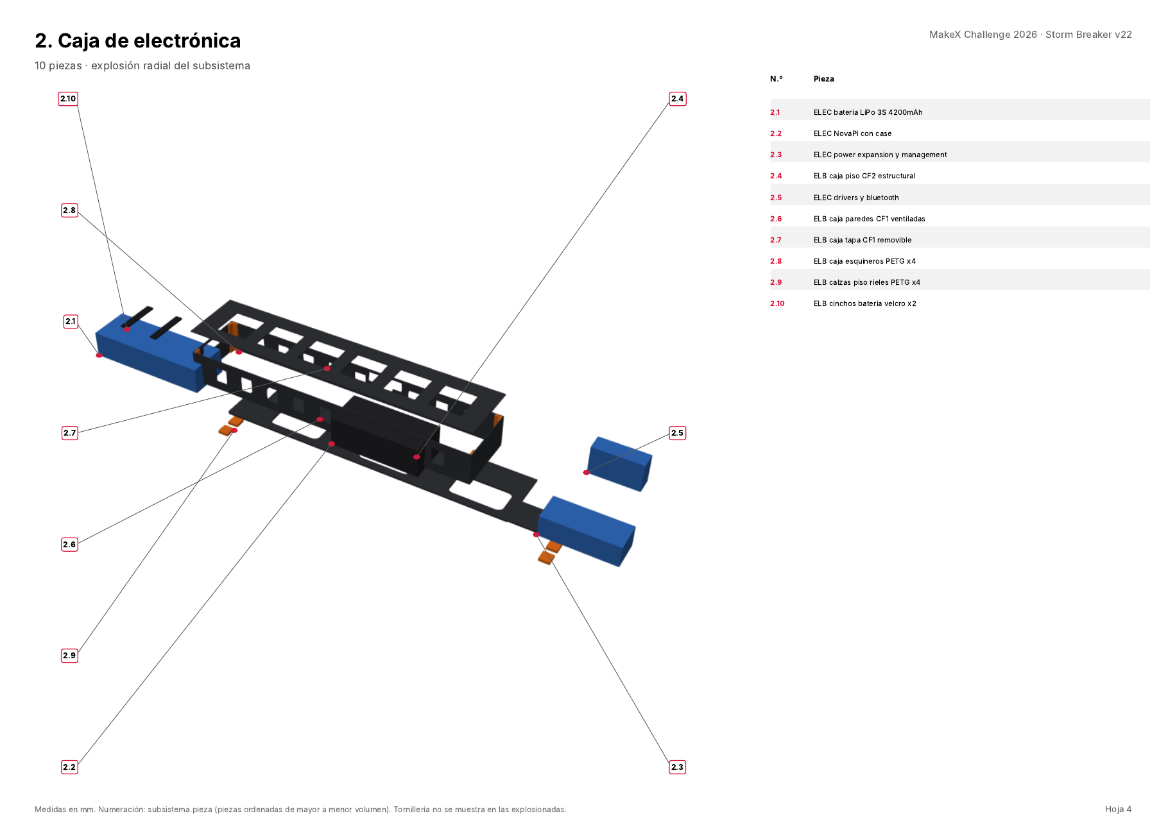
mechanical/chassis/drawings/v22/v22_2_electronics_box_exploded.png
