Robotica76/2026_MakeX_Challengue/mechanical/chassis/prototypes/v22/simulacion_inercia_maniobra_v21.png

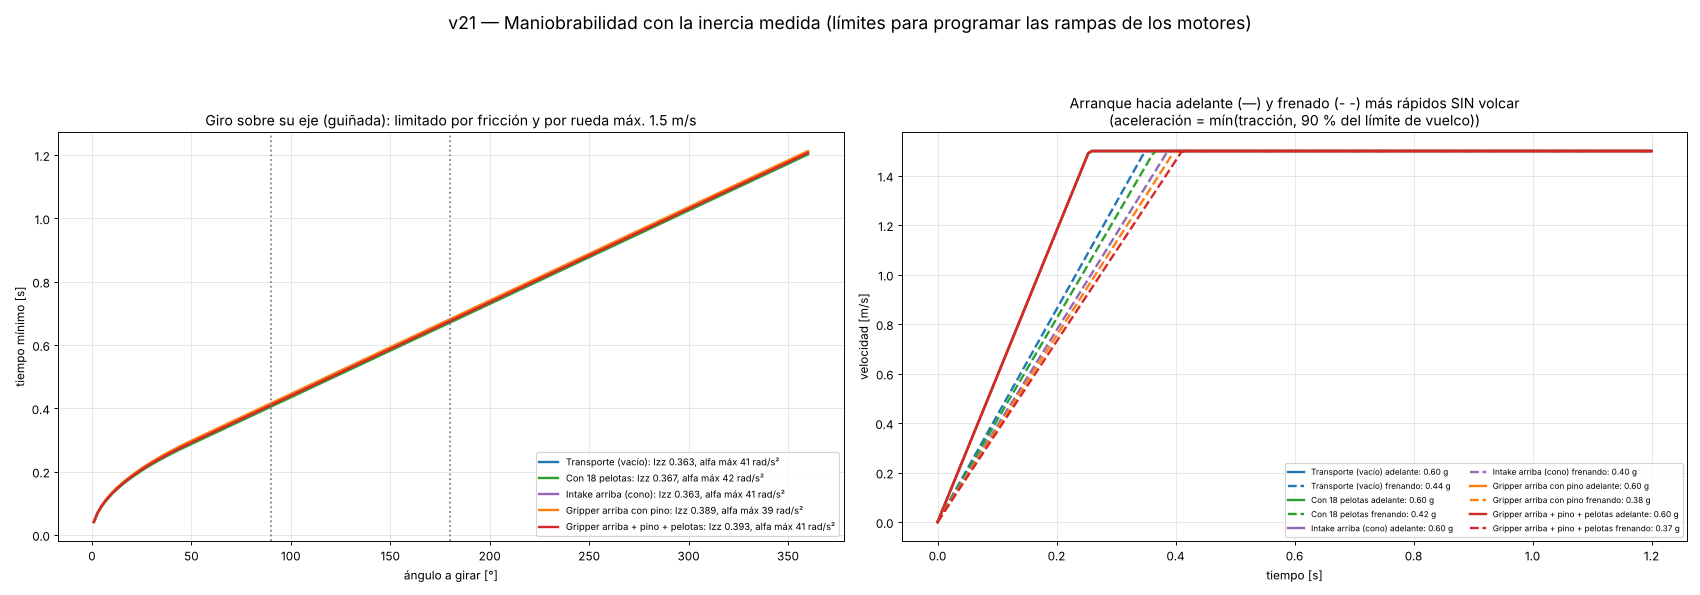
mechanical/chassis/prototypes/v22/simulacion_inercia_maniobra_v21.png
