Robotica76/2026_MakeX_Challengue/mechanical/feeder/drawings/v22/v22_3_ball_tower_transfer_to_basket_exploded.png

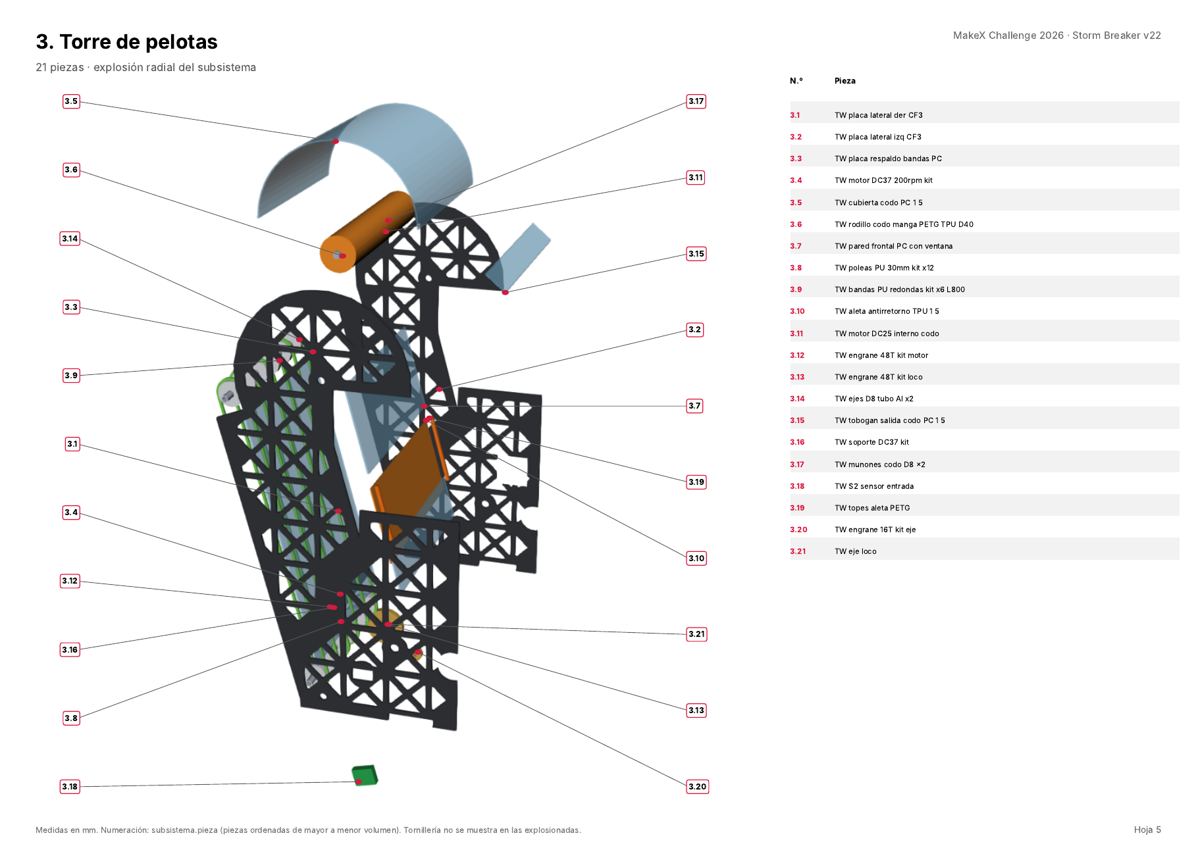
mechanical/feeder/drawings/v22/v22_3_ball_tower_transfer_to_basket_exploded.png
