Robotica76/2026_MakeX_Challengue/mechanical/feeder/prototypes/v22/simulacion_codo_y_bolsillo_v18.png

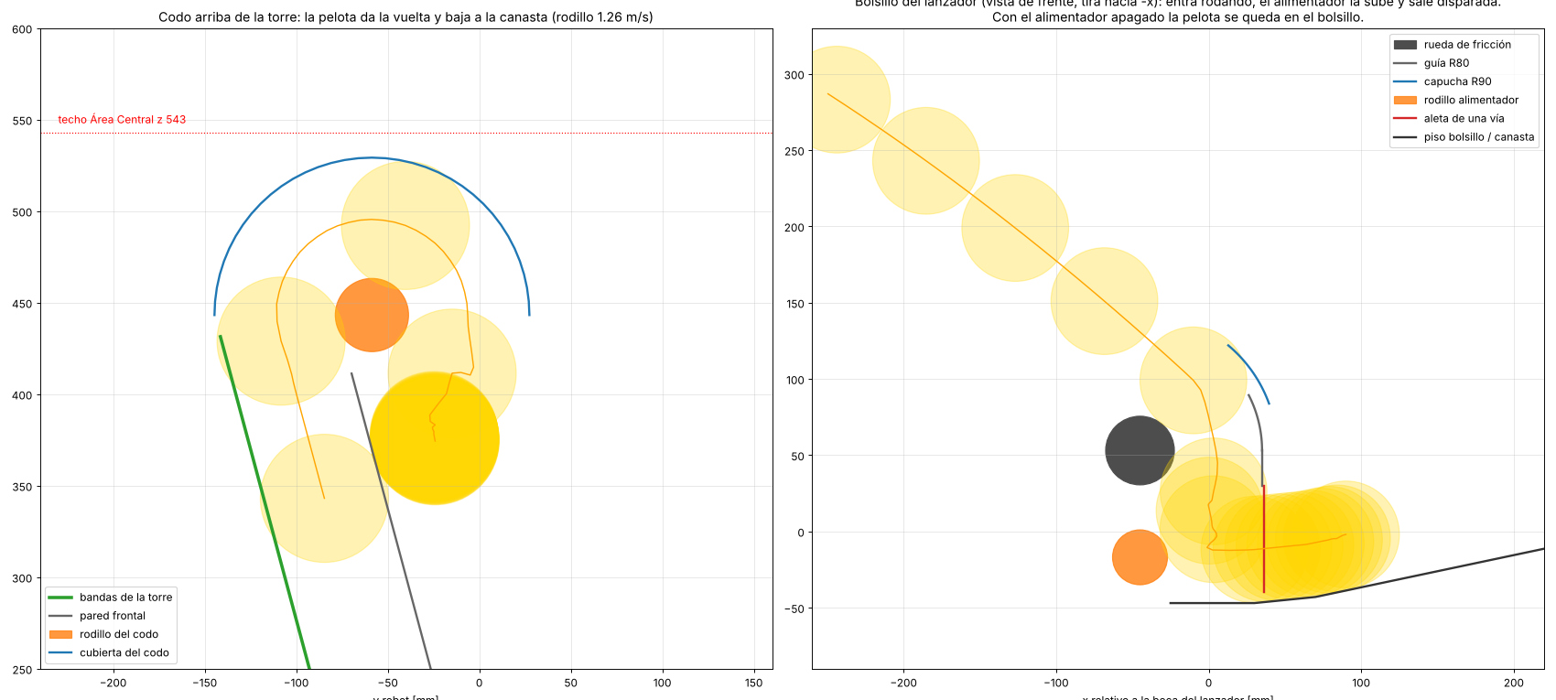
mechanical/feeder/prototypes/v22/simulacion_codo_y_bolsillo_v18.png
