Robotica76/2026_MakeX_Challengue/mechanical/flag_system/drawings/v22/plano_mastil_bandera_v22.png

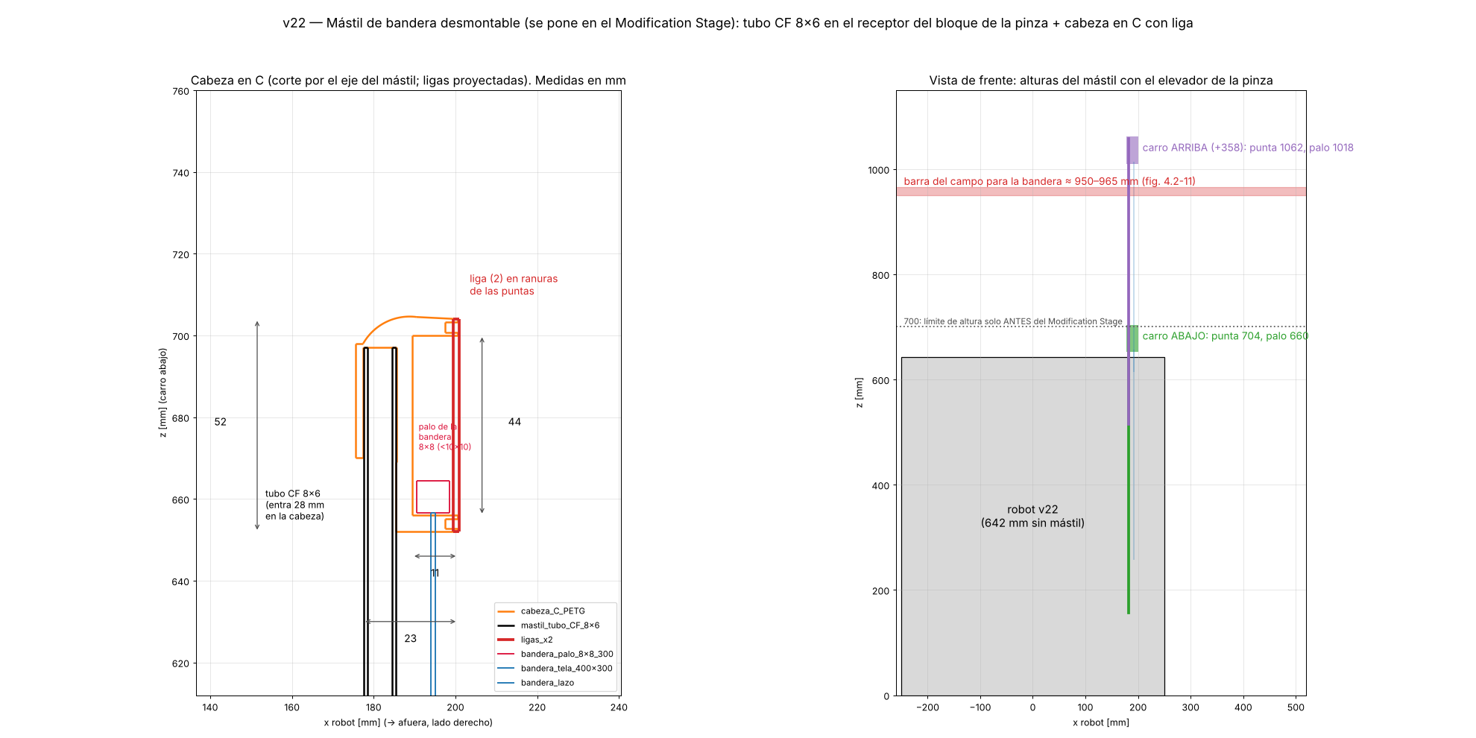
mechanical/flag_system/drawings/v22/plano_mastil_bandera_v22.png
