Robotica76/2026_MakeX_Challengue/mechanical/flag_system/drawings/v22/v22_9_flag_mast_modification_stage_exploded.png

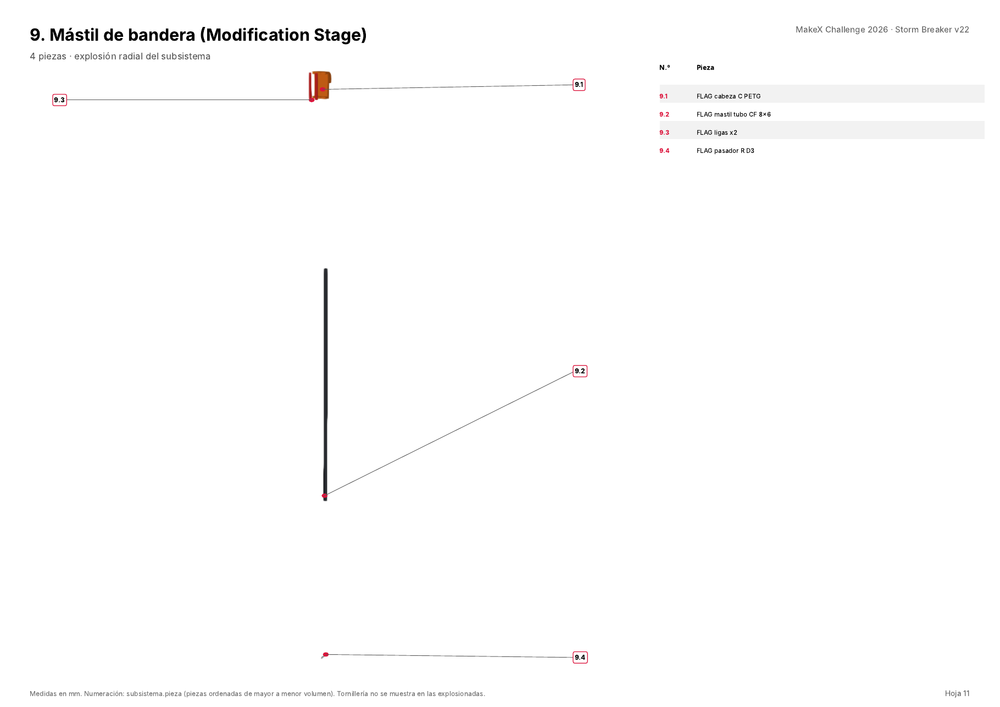
mechanical/flag_system/drawings/v22/v22_9_flag_mast_modification_stage_exploded.png
