Robotica76/2026_MakeX_Challengue/mechanical/gripper/drawings/v22/v22_6_carriage_and_gripper_exploded.png

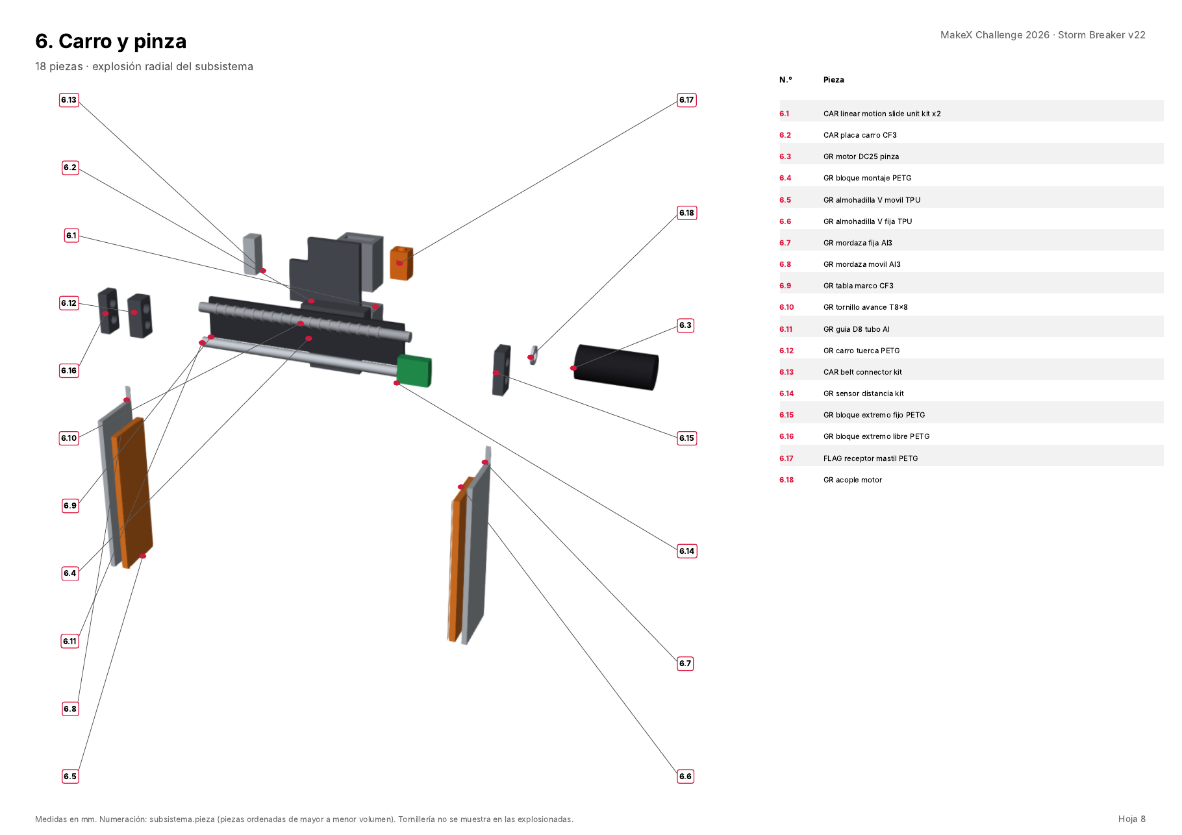
mechanical/gripper/drawings/v22/v22_6_carriage_and_gripper_exploded.png
