Robotica76/2026_MakeX_Challengue/mechanical/gripper_elevation/drawings/v22/v22_5_gripper_elevator_and_structure_exploded.png

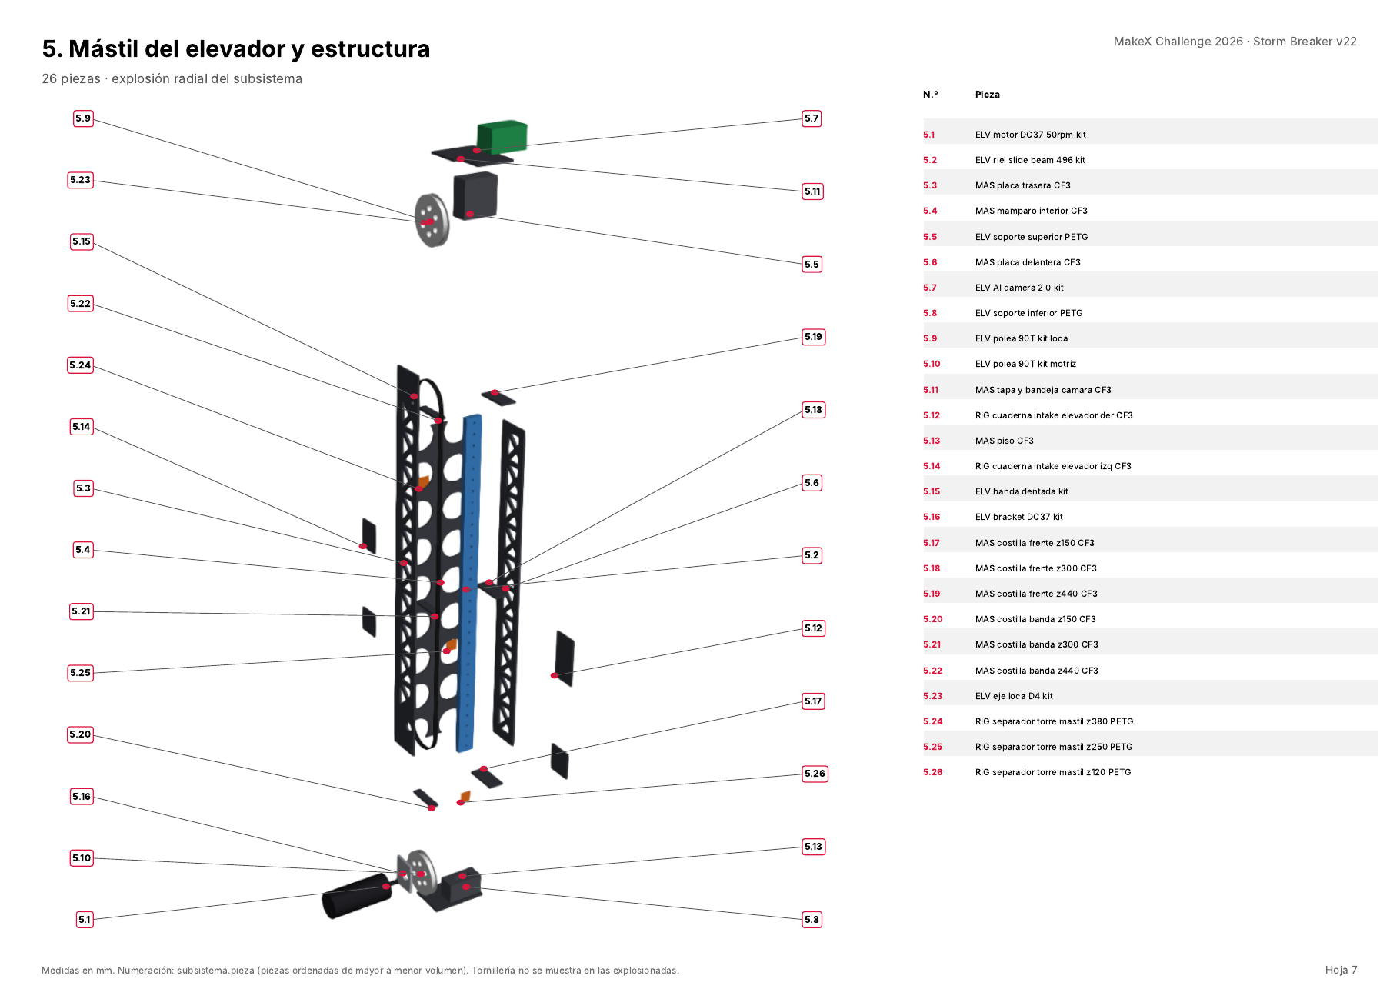
mechanical/gripper_elevation/drawings/v22/v22_5_gripper_elevator_and_structure_exploded.png
