Robotica76/2026_MakeX_Challengue/mechanical/shooter/drawings/v22/v22_7_shooter_inverted_launcher_exploded.png

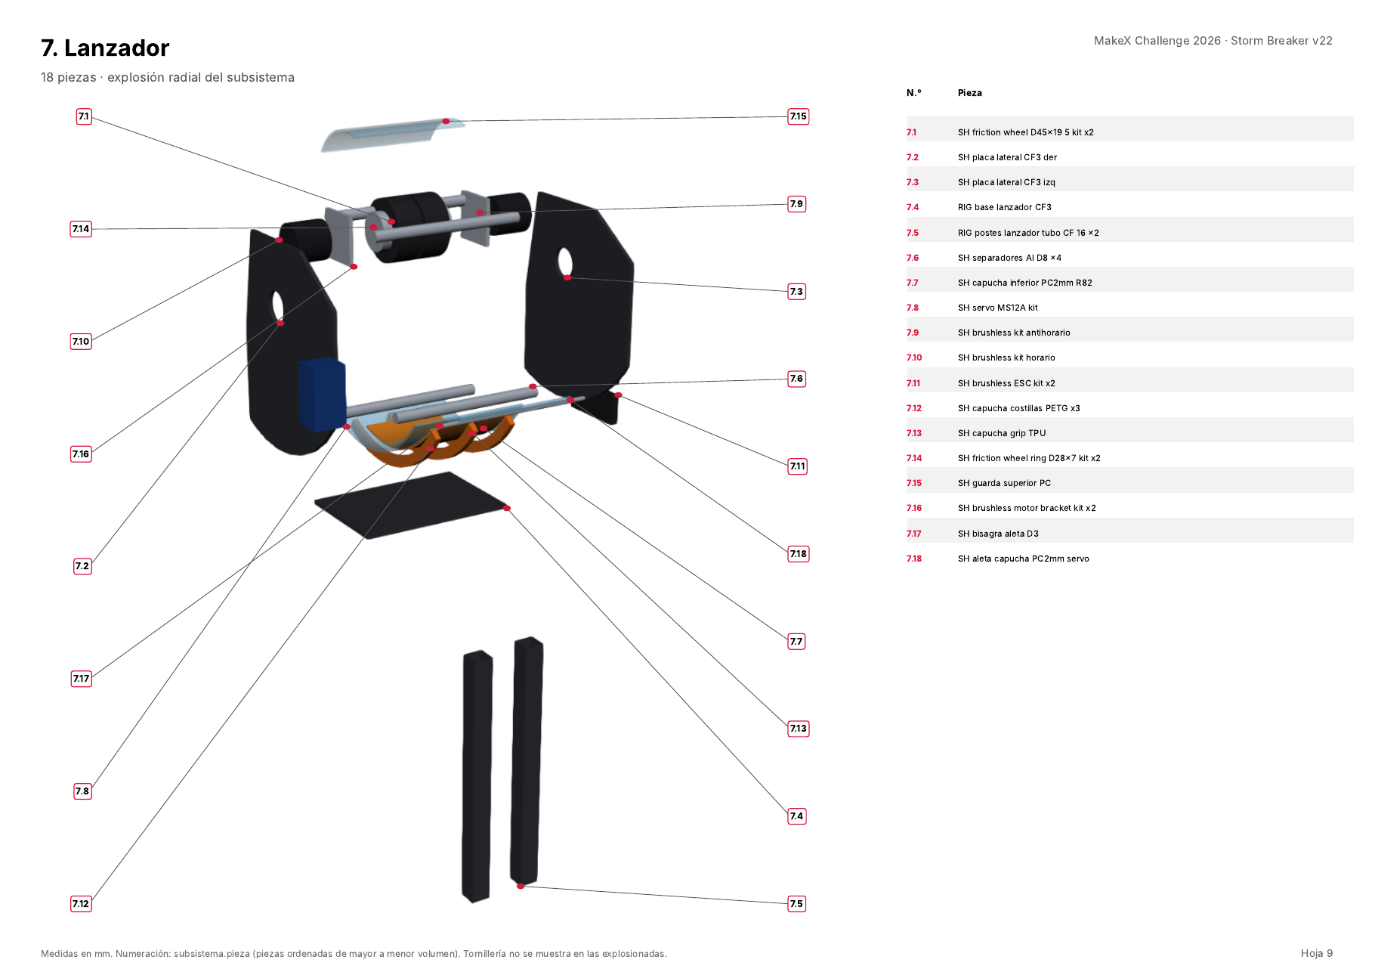
mechanical/shooter/drawings/v22/v22_7_shooter_inverted_launcher_exploded.png
