Robotica76/2026_MakeX_Challengue/mechanical/shooter/prototypes/v22/simulacion_tiro_balistica_v19.png

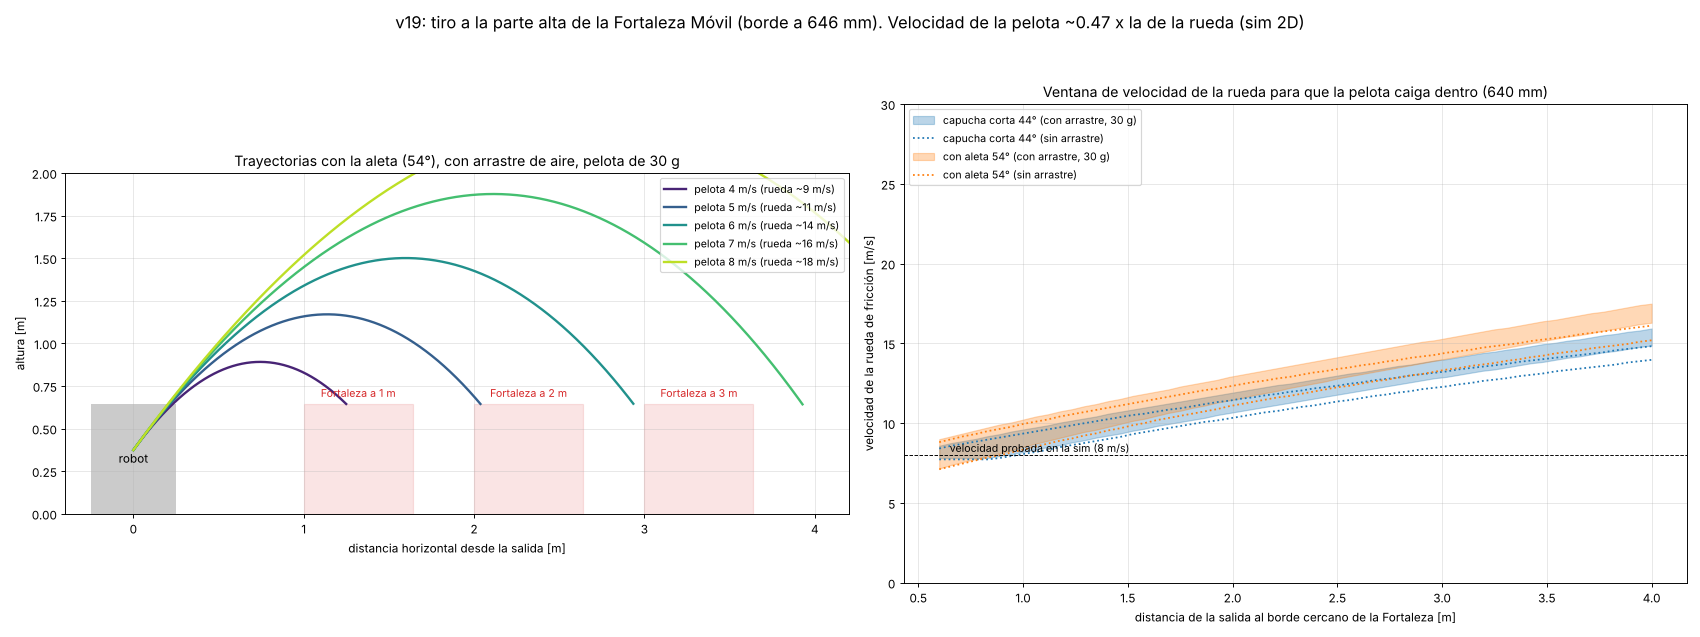
mechanical/shooter/prototypes/v22/simulacion_tiro_balistica_v19.png
