Robotica76/2026_MakeX_Challengue/simulation/analysis/reports/four_robots/partido_ganador_4_robots.gif

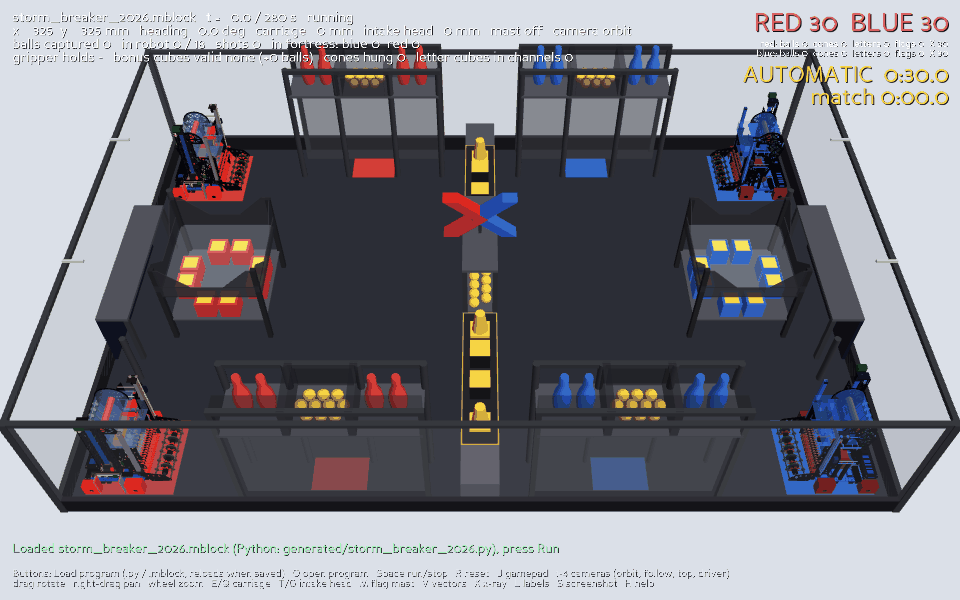
simulation/analysis/reports/four_robots/partido_ganador_4_robots.gif
