Robotica76/2026_MakeX_Challengue/simulation/analysis/reports/mc_four/eficiencia.png

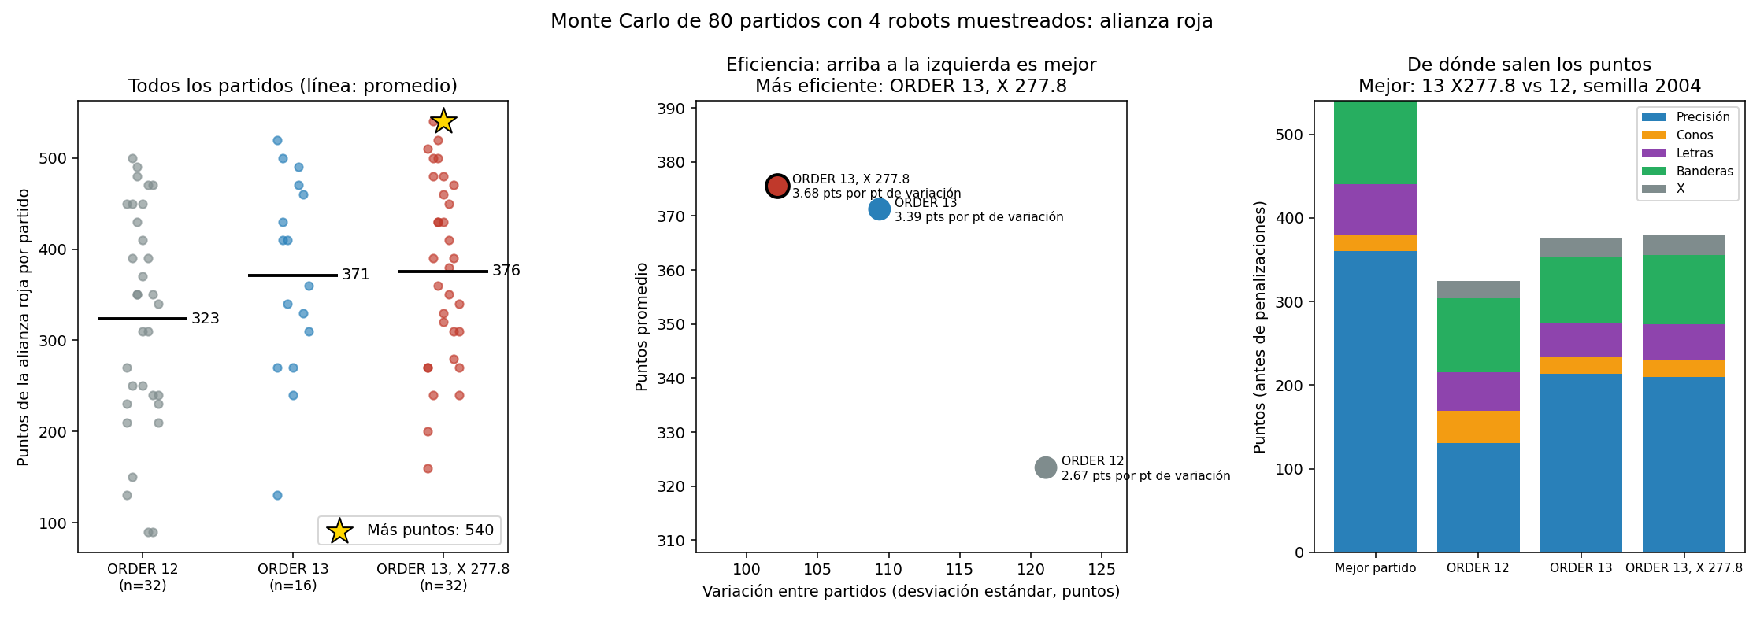
simulation/analysis/reports/mc_four/eficiencia.png
