Robotica76/2026_MakeX_Challengue/simulation/analysis/reports/mc_four/mc_four.png

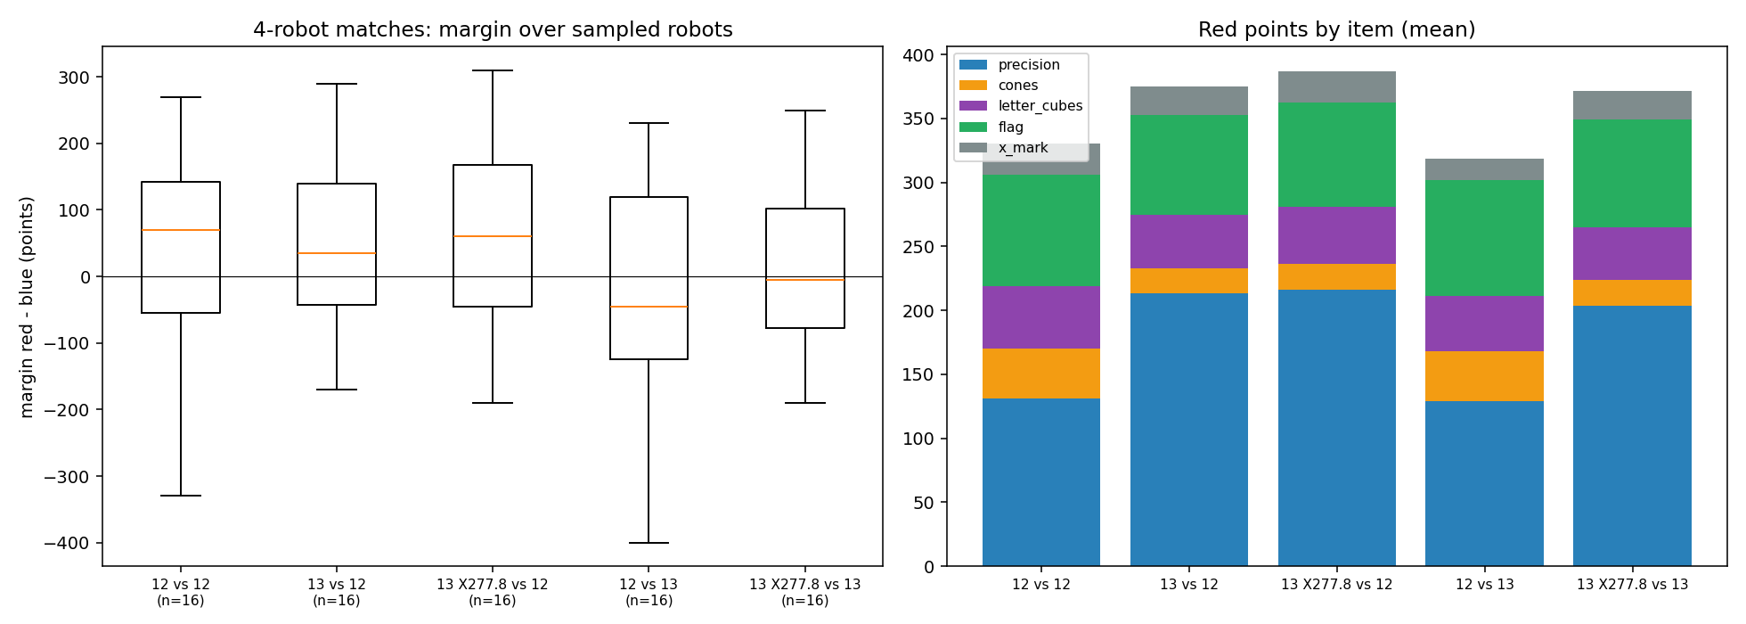
simulation/analysis/reports/mc_four/mc_four.png
