Robotica76/2026_MakeX_Challengue/simulation/analysis/reports/rl_four/bandit.png

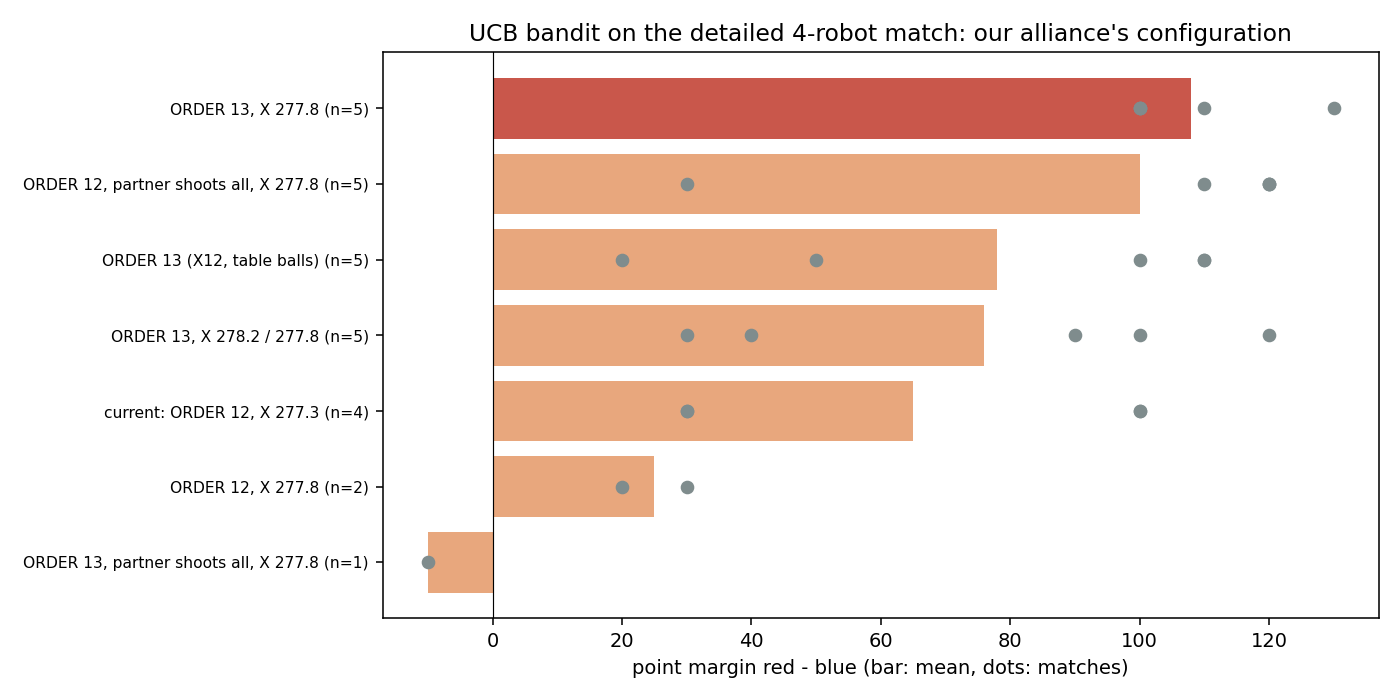
simulation/analysis/reports/rl_four/bandit.png
