Robotica76/2026_MakeX_Challengue/simulation/analysis/reports/rl_strategy/1_learning_curve.png

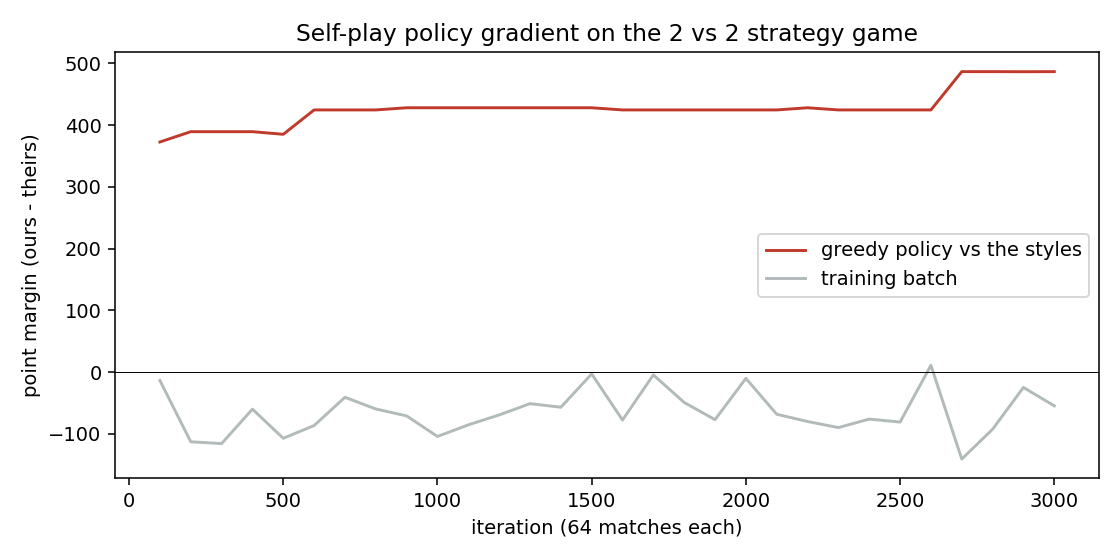
simulation/analysis/reports/rl_strategy/1_learning_curve.png
