Robotica76/2026_MakeX_Challengue/simulation/analysis/reports/rl_strategy/2_margin_vs_styles.png

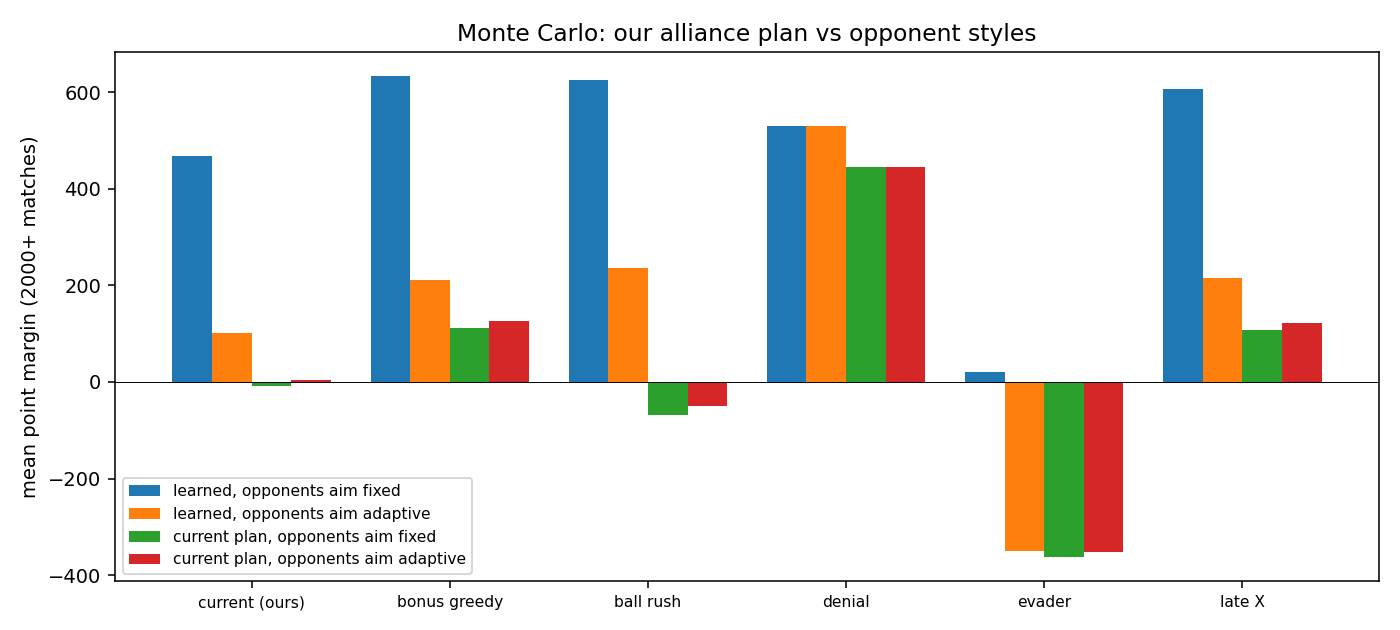
simulation/analysis/reports/rl_strategy/2_margin_vs_styles.png
