Robotica76/2026_MakeX_Challengue/simulation/analysis/reports/rl_strategy_robust/2_margin_vs_styles.png

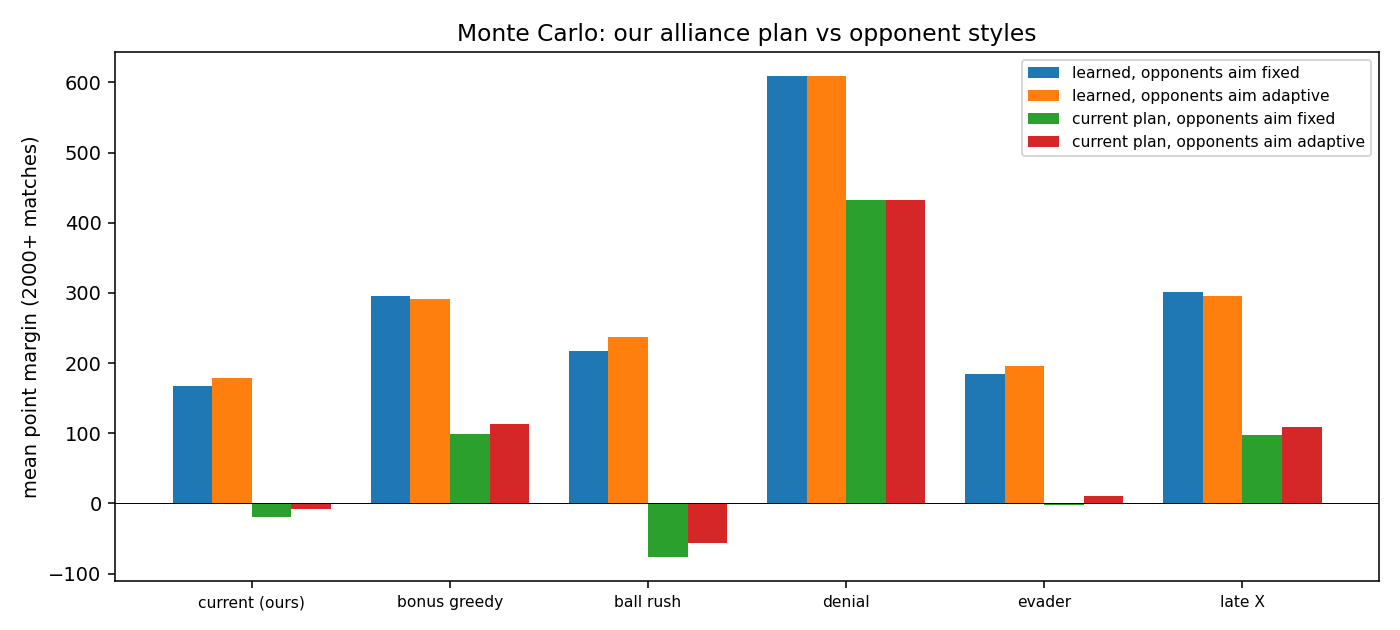
simulation/analysis/reports/rl_strategy_robust/2_margin_vs_styles.png
