Robotica76/2026_MakeX_Challengue/simulation/analysis/reports/rl_strategy_robust/aprendizaje.gif

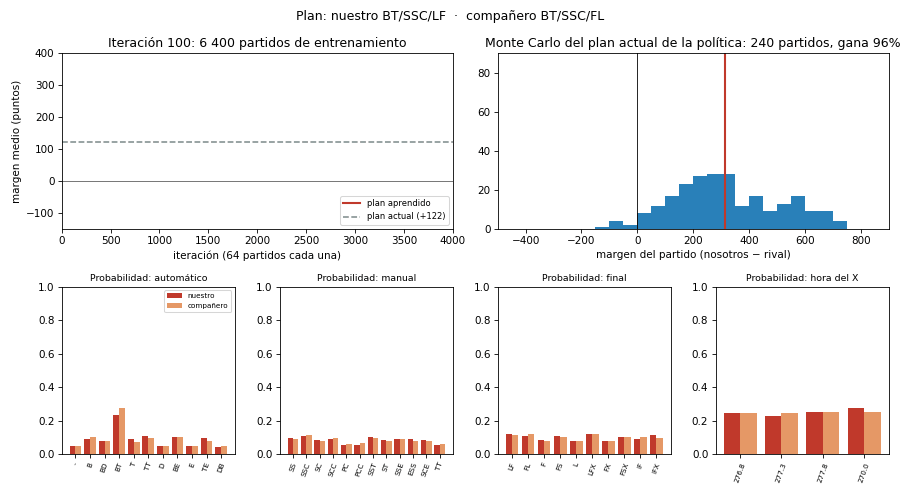
simulation/analysis/reports/rl_strategy_robust/aprendizaje.gif
