Robotica76/2026_MakeX_Challengue/simulation/analysis/reports/rl_strategy_seed2/3_policy.png

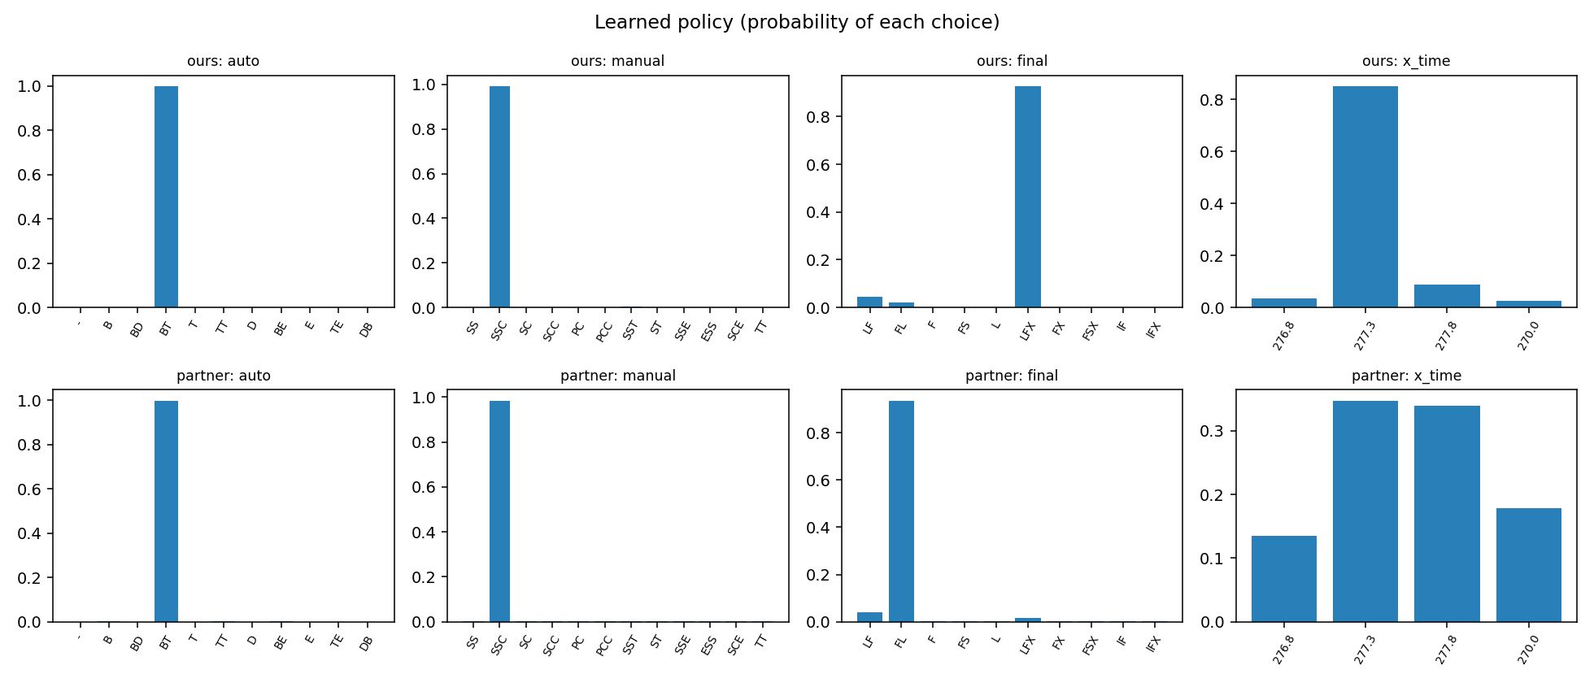
simulation/analysis/reports/rl_strategy_seed2/3_policy.png
