Robotica76/2026_MakeX_Challengue/simulation/analysis/reports/rl_strategy_seed4/1_learning_curve.png

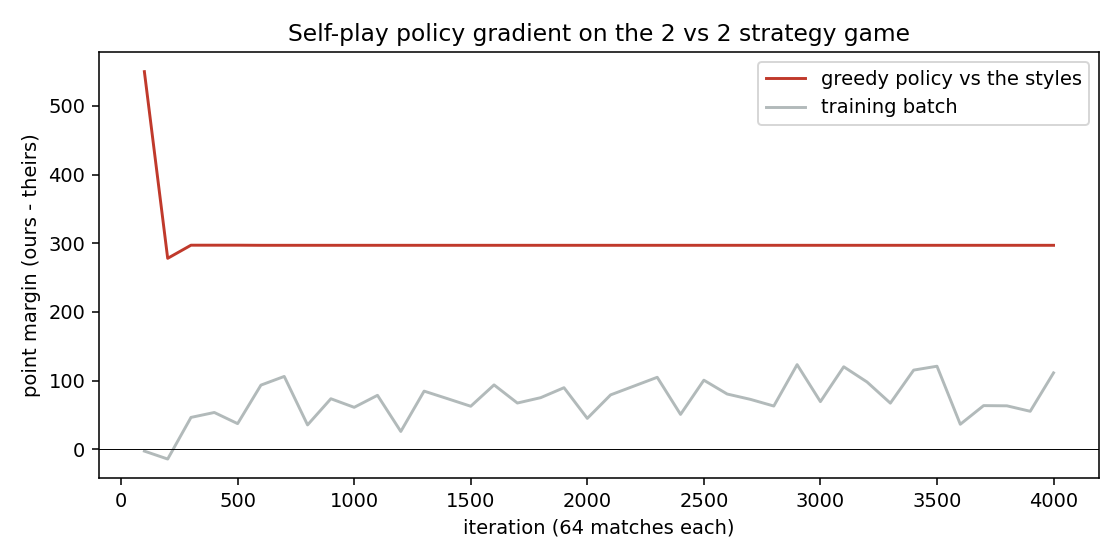
simulation/analysis/reports/rl_strategy_seed4/1_learning_curve.png
