Robotica76/2026_MakeX_Challengue/simulation/analysis/reports/routes_montecarlo/1_auto_routes.png

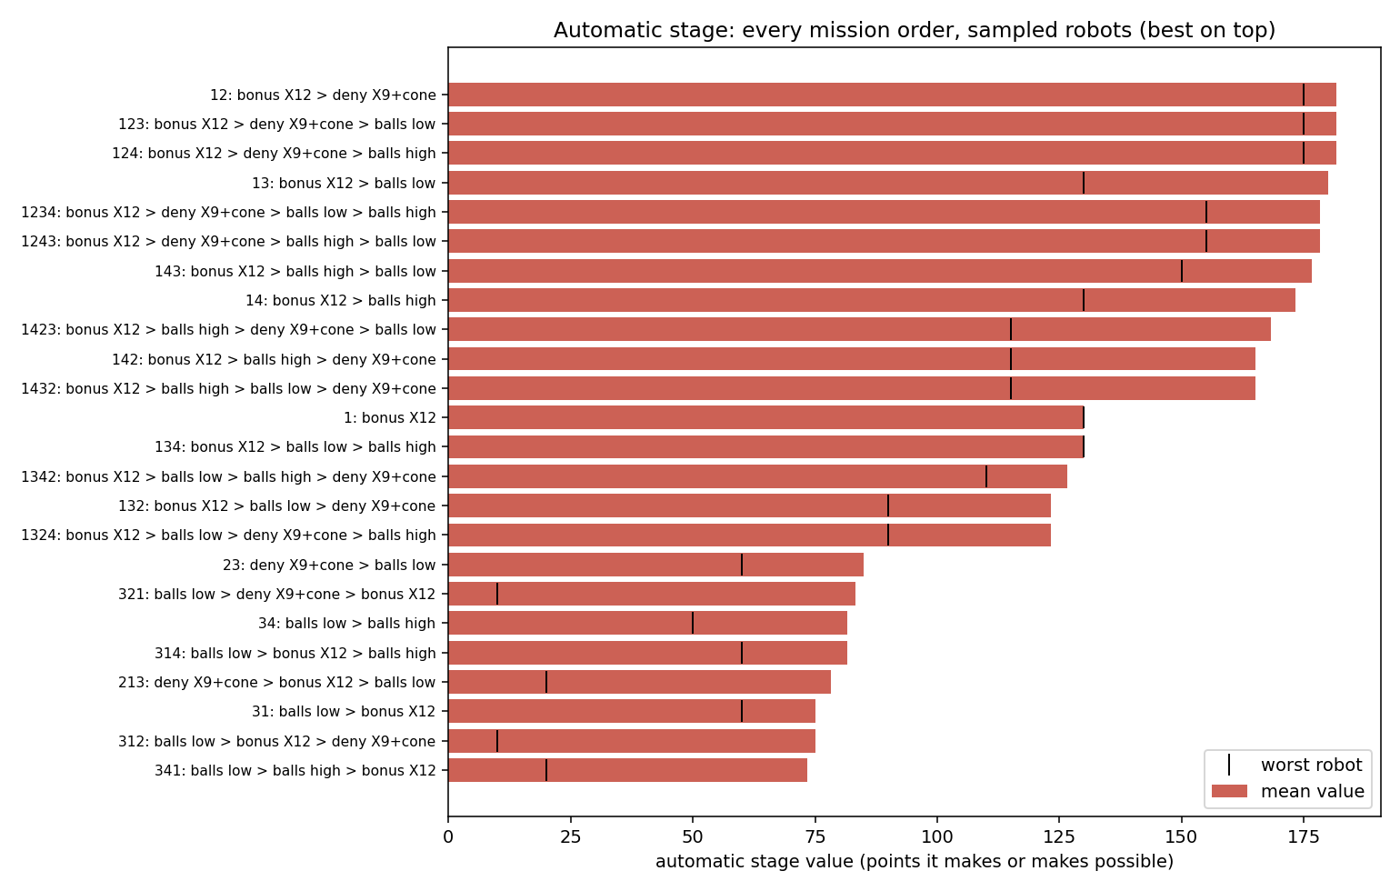
simulation/analysis/reports/routes_montecarlo/1_auto_routes.png
