Robotica76/2026_MakeX_Challengue/simulation/analysis/reports/routes_montecarlo/2_match_routes.png

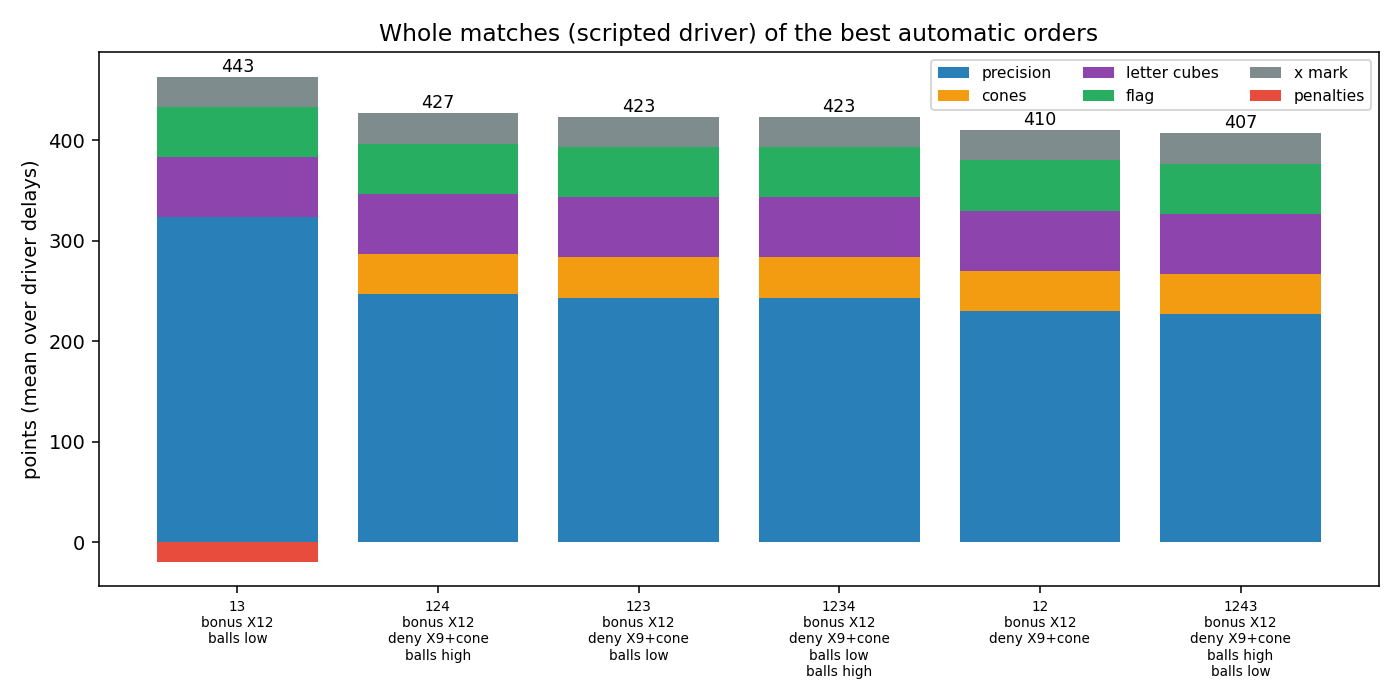
simulation/analysis/reports/routes_montecarlo/2_match_routes.png
