Robotica76/2026_MakeX_Challengue/simulation/analysis/reports/routes_montecarlo/3_two_robots.png

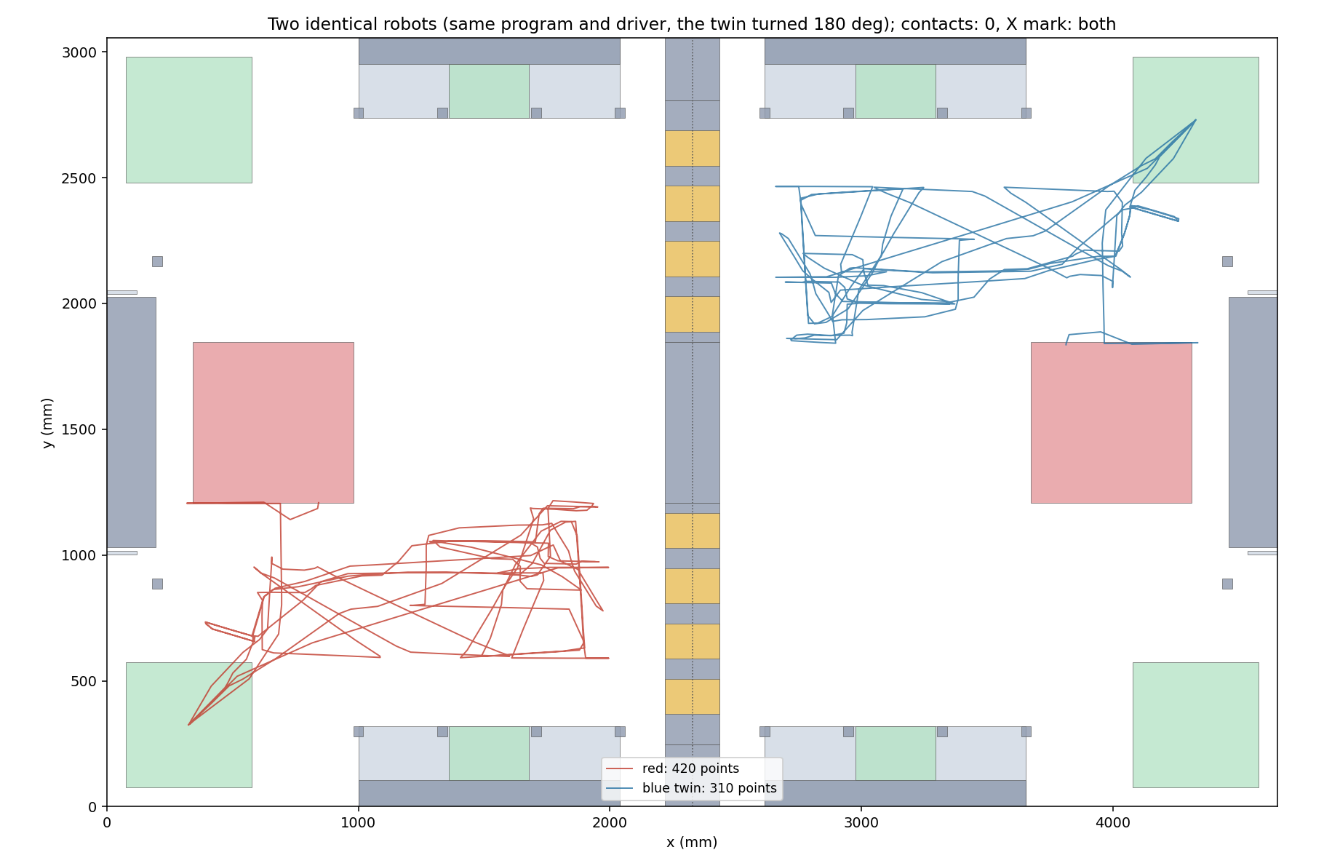
simulation/analysis/reports/routes_montecarlo/3_two_robots.png
