Robotica76/2026_MakeX_Challengue/simulation/analysis/reports/routes_montecarlo/5_two_robots_34_vs_34.png

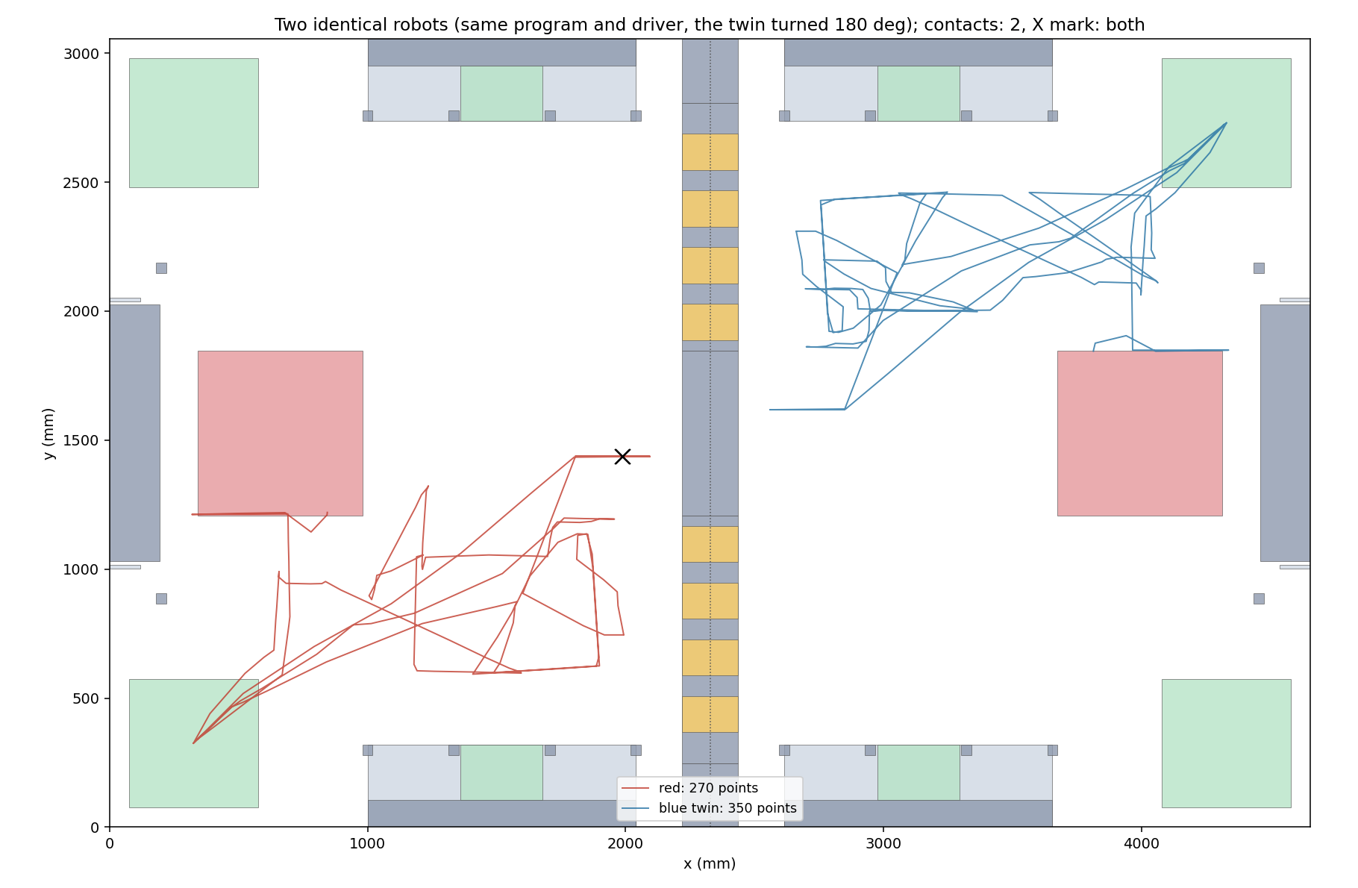
simulation/analysis/reports/routes_montecarlo/5_two_robots_34_vs_34.png
