Robotica76/2026_MakeX_Challengue/simulation/analysis/reports/strategy_montecarlo/figures/1_field_paths.png

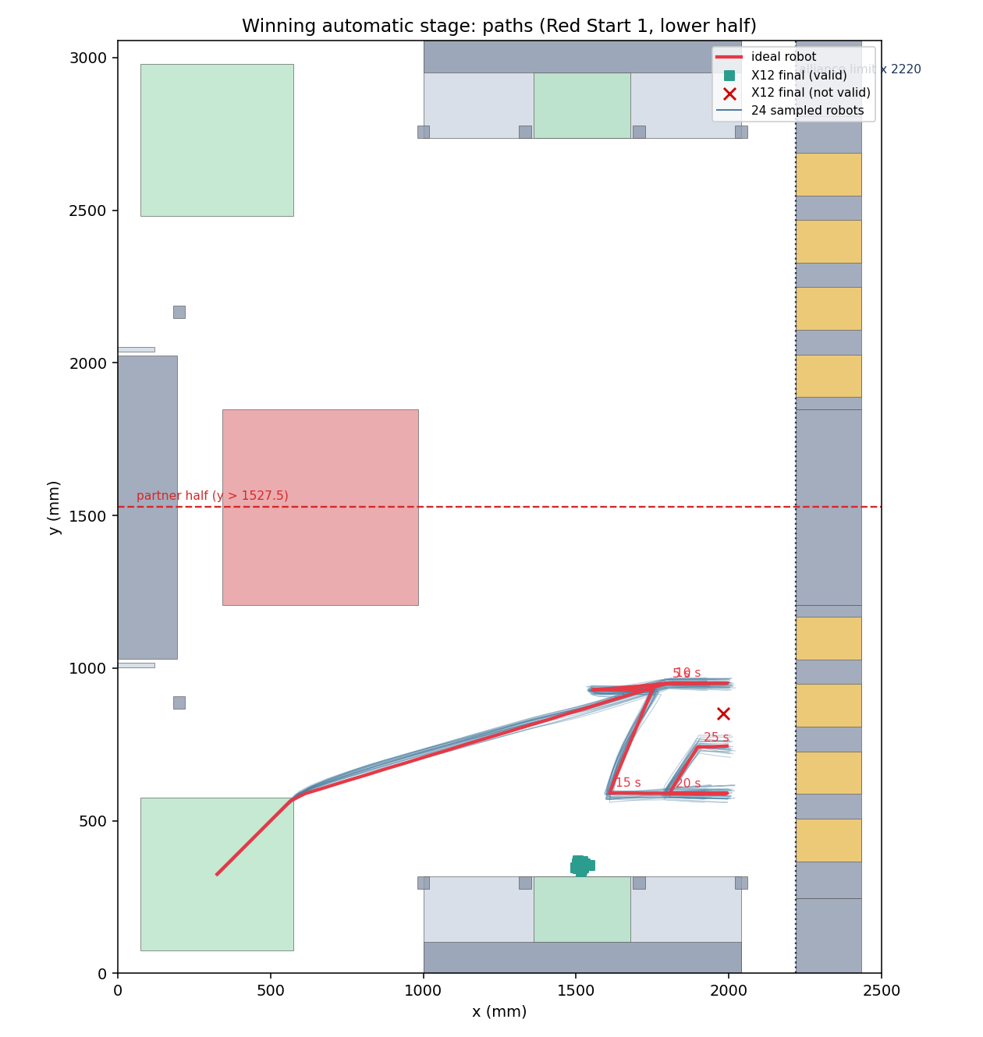
simulation/analysis/reports/strategy_montecarlo/figures/1_field_paths.png
