Robotica76/2026_MakeX_Challengue/simulation/analysis/reports/strategy_montecarlo/figures/2_candidates.png

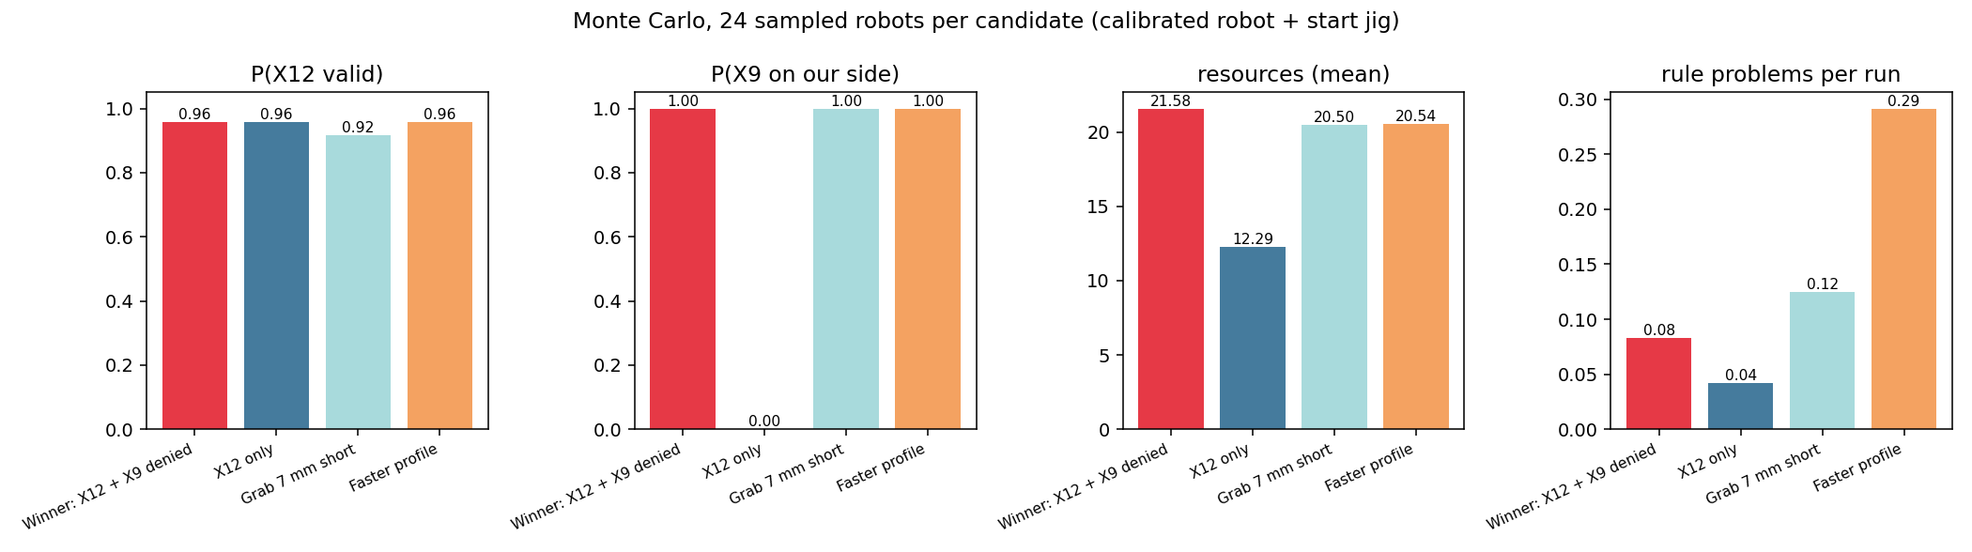
simulation/analysis/reports/strategy_montecarlo/figures/2_candidates.png
