Robotica76/2026_MakeX_Challengue/simulation/analysis/reports/strategy_montecarlo/figures/3_x12_time.png

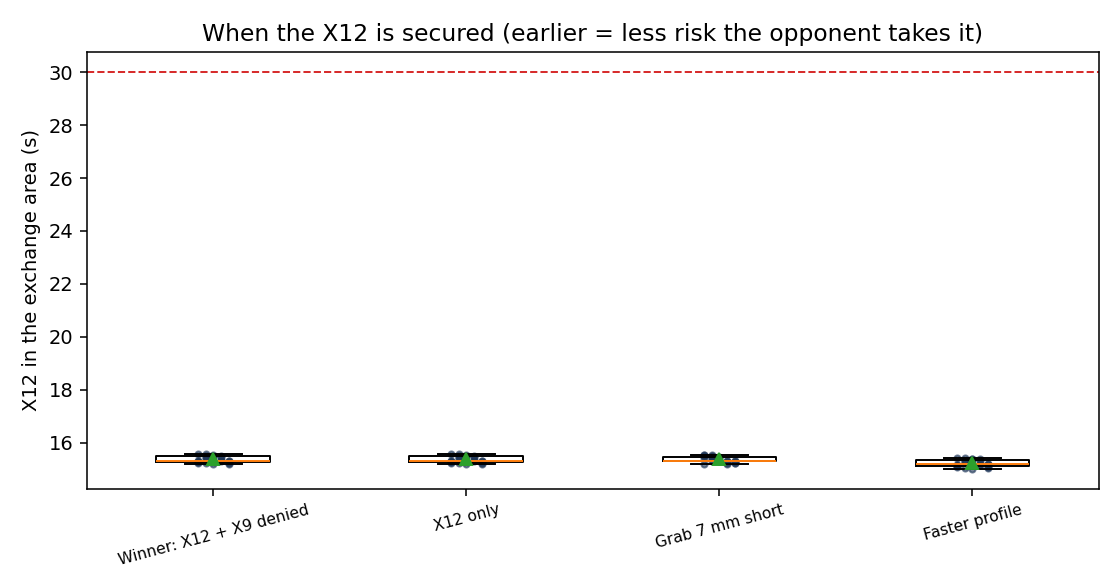
simulation/analysis/reports/strategy_montecarlo/figures/3_x12_time.png
