Robotica76/2026_MakeX_Challengue/simulation/analysis/reports/strategy_montecarlo/figures/4_speed_profile.png

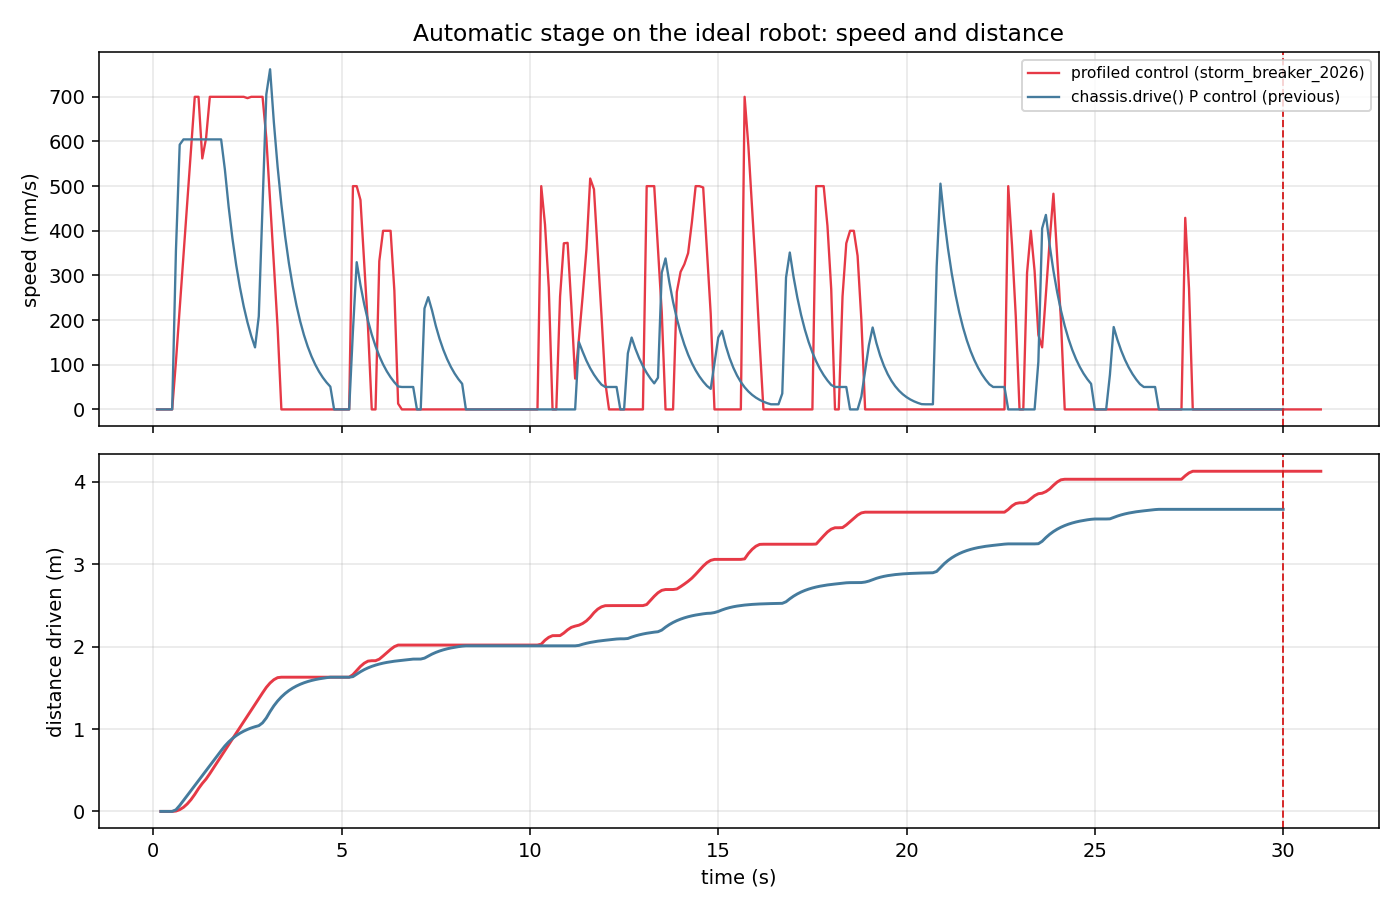
simulation/analysis/reports/strategy_montecarlo/figures/4_speed_profile.png
