Robotica76/2026_MakeX_Challengue/simulation/analysis/reports/strategy_montecarlo/figures/5_match_points.png

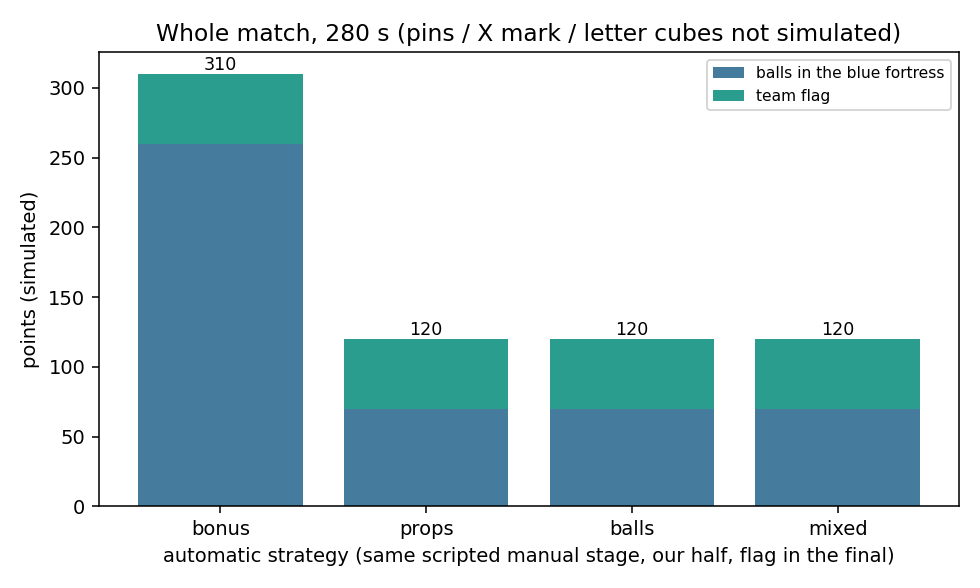
simulation/analysis/reports/strategy_montecarlo/figures/5_match_points.png
