Robotica76/2026_MakeX_Challengue/simulation/analysis/reports/summary/summary.png

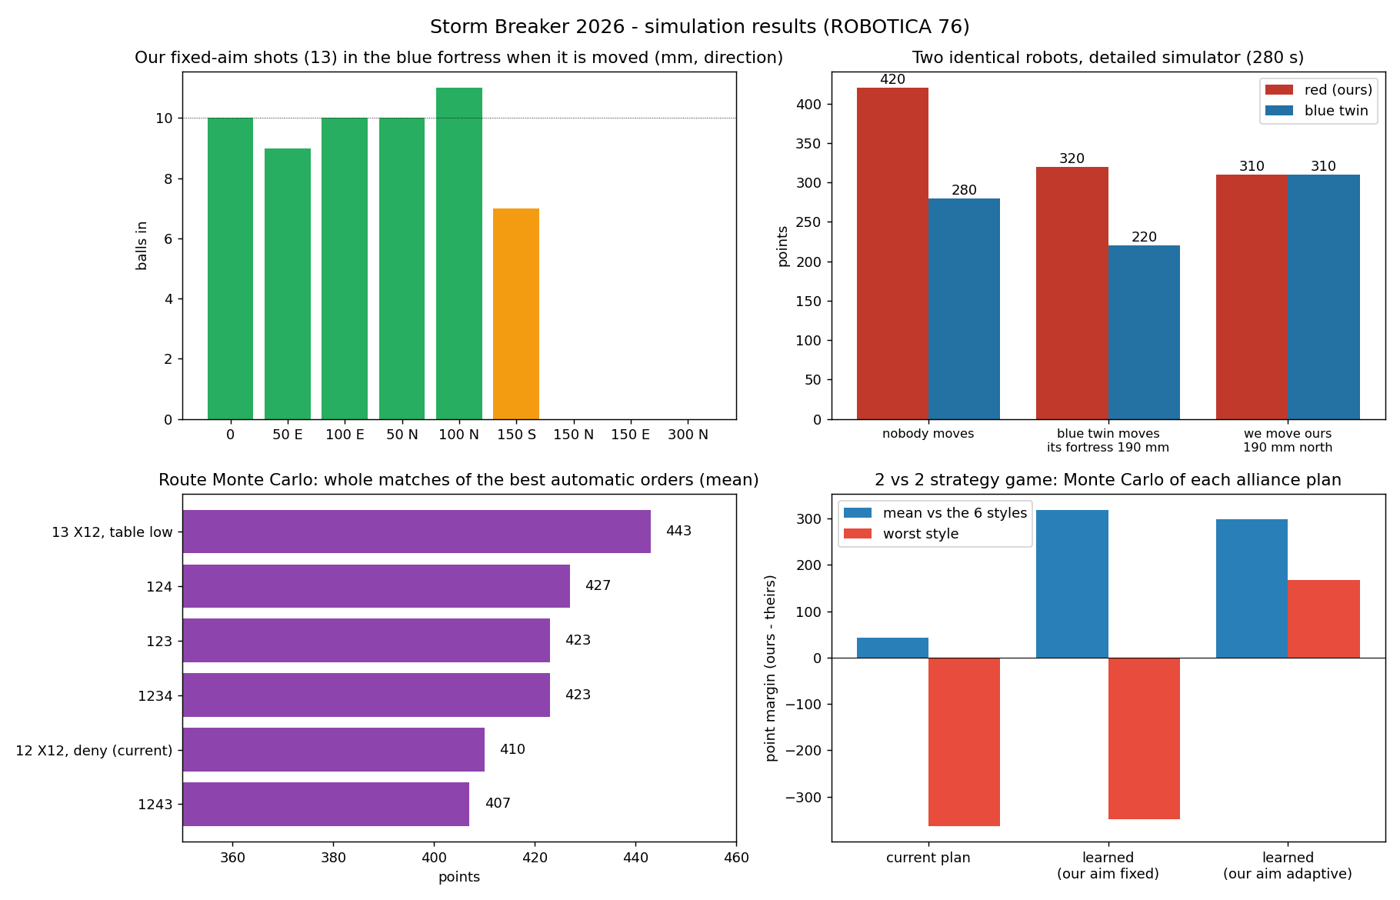
simulation/analysis/reports/summary/summary.png
