Robotica76/2026_MakeX_Challengue/simulation/field3d/docs/follow_mast.png

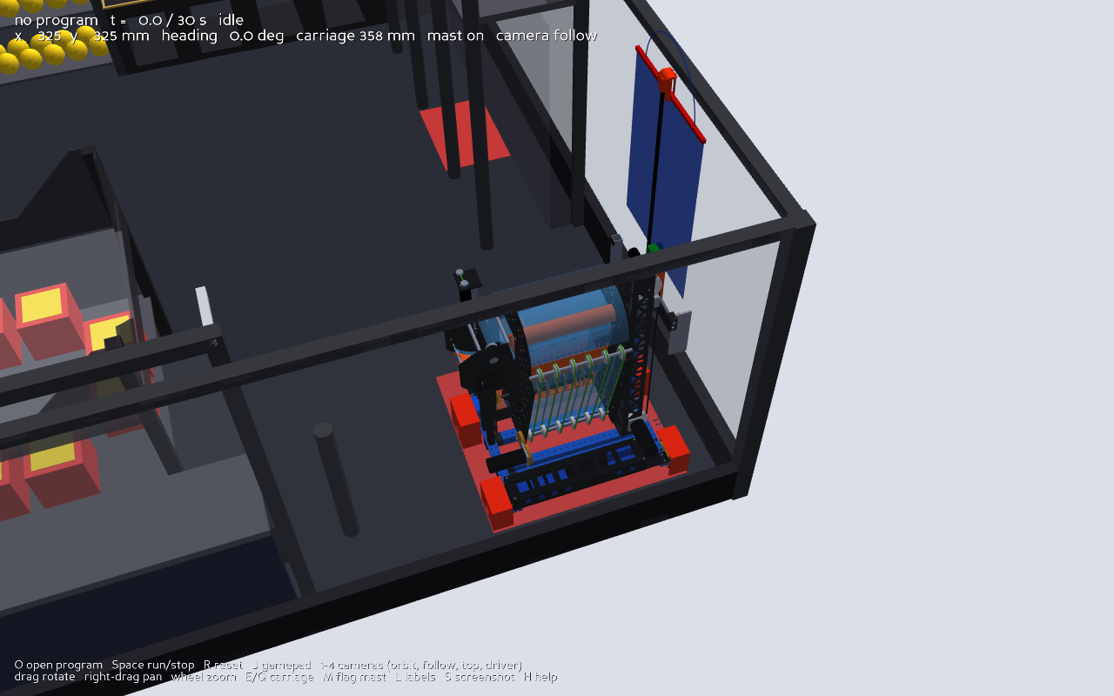
simulation/field3d/docs/follow_mast.png
