Robotica76/2026_MakeX_Challengue/simulation/field3d/docs/scoreboard.png

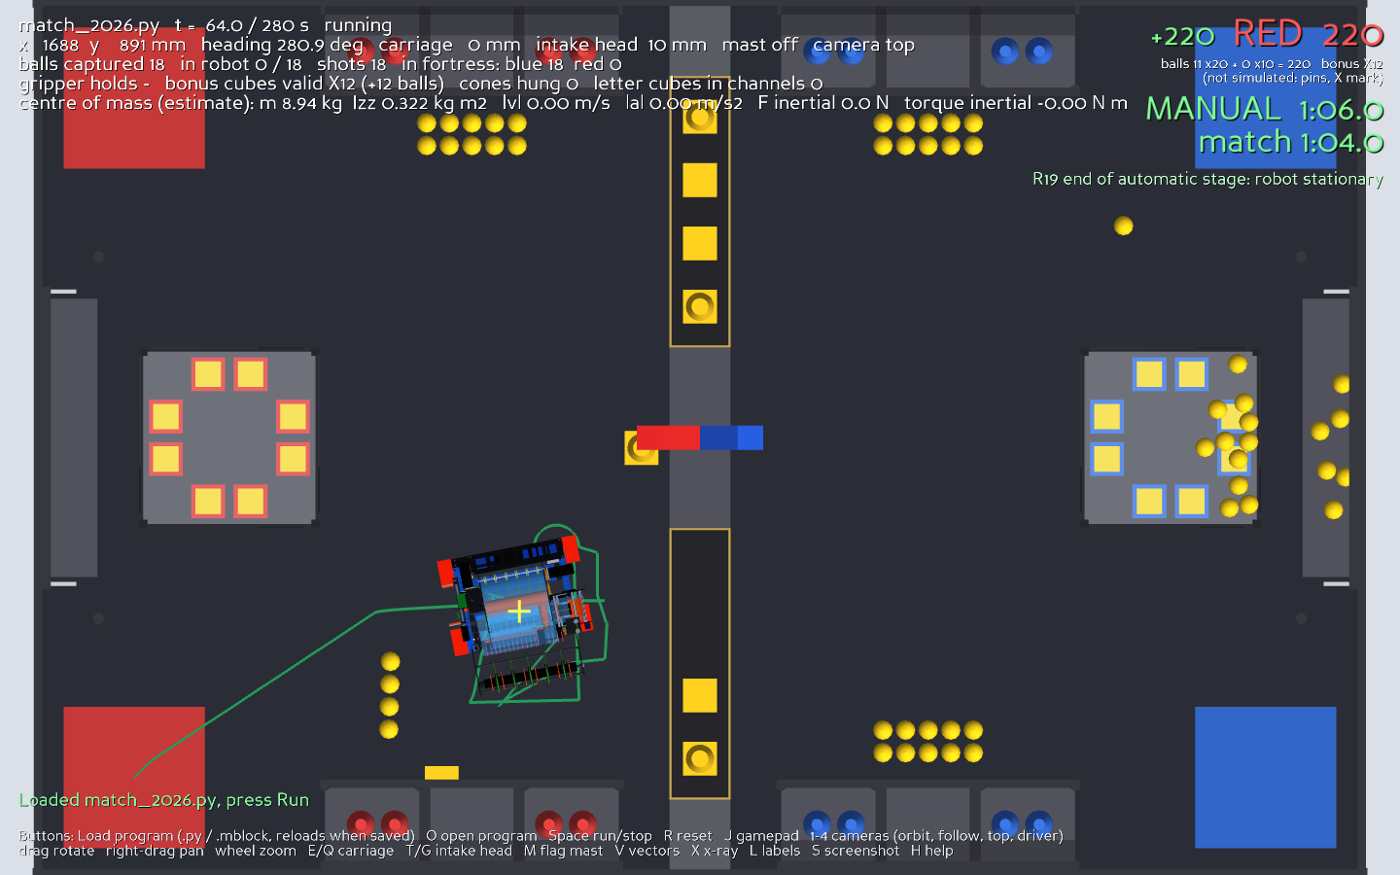
simulation/field3d/docs/scoreboard.png
