Robotica76/2026_MakeX_Challengue/electrical/bom/README.md

# Electrical BOM

| Item | Qty | Source | v22 part |
| --- | --- | --- | --- |
| NovaPi controller (with case) | 1 | MakeX kit | 2.2 |
| Power expansion / management board | 1 | MakeX kit | 2.3 |
| LiPo 3S 4200 mAh 25–30C | 1 (+ spares) | Rules T14 | 2.1 |
| Drivers + Bluetooth module | 1 set | Kit | 2.5 |
| 180 smart encoder motor | 4 | Kit | chassis |
| DC-37 (200 RPM × 2, 50 RPM × 1) | 3 | Kit | 4.6, 3.4, 5.1 |
| DC-25 200 RPM | 6 | Kit — **verify the kit has 6** | 4.16, 4.17, 4.18, 3.11, 8.4, 6.3 |
| Brushless 2823/2824 + ESC | 2 | Kit | 7.9–7.11 |
| Servo MS-12A | 1 | Kit | 7.8 |
| Ranging sensor | 2 (≤ 3) | Kit | 6.14, 3.18 |
| AI camera 2.0 | 1 | Kit | 5.7 |

Full mechanical BOMs: each subsystem's `manufacturing/README.md`. Register: [electrical_bom.md](electrical_bom.md).
