Robotica76/2026_MakeX_Challengue/mechanical/common_parts/README.md

# Common Parts

> **Revision v22 (CAD only).** Parts 10.x (Hardware) of the [Storm Breaker v22 manual](../assemblies/full_robot/v22/docs/Ensamble_StormBreaker_v22.pdf). Not built or measured yet.

## Purpose

Hardware and parts shared by several subsystems.

## Competition Capabilities

—

## Requirements

Mass counts toward the 10 kg limit.

## Mechanical Interfaces

All subsystems.

## Electrical Interfaces

—

## Software Interfaces

—

## Design

Representative M3 button-head screws placed automatically at plate–plate and motor joints (73). Joints where the head clashed with neighbours are not modelled (≈ 80, ≈ 80 g).

## Current Status

v22 CAD.

## Testing

See [prototypes](prototypes/README.md).

## Known Issues

- Real hole patterns come from the plate drawings, not from these screw positions.

## Design decisions

| ID | Decision |
| --- | --- |
| [DEC-M13](../../docs/08_engineering_notebook/design_log/DL-SYS-001_design_decisions.md) | Numbering and folder structure |

## Documentation map

| Folder | Content |
| --- | --- |
| [cad](cad/README.md) | 1 numbered STL, robot frame |
| [drawings](drawings/README.md) | Exploded, numbered sheets from the manual |
| [manufacturing](manufacturing/README.md) | BOM with process / material, assembly steps, checks |
| [prototypes](prototypes/README.md) | Simulation evidence and test plan |

## Related GitHub Issues

TBD: link actual design and validation issues when created.
