Robotica76/2026_MakeX_Challengue/mechanical/common_parts/cad/README.md

# Common Parts CAD

Shared hardware (subsystem 10).

## Revisions

| Revision | Parts | Integration |
| --- | --- | --- |
| [v22](v22/) | 1 numbered STL (this page) | [Storm Breaker v22](../../assemblies/full_robot/v22/README.md) |

## v22 · Numbered parts

File name = `<subsystem>.<part>_<CAD name>.stl`, the same numbering as the [assembly manual](../../assemblies/full_robot/v22/docs/Ensamble_StormBreaker_v22.pdf) (sheet —). Within a subsystem, part 1 is the largest by volume.

- Every STL is exported in the **robot frame at its assembled position** (mm; origin on the floor at the centre of the 500 × 500 envelope; `+y` forward, `+x` right, `+z` up), so the files drop into place together. Re-orient each part on the build plate before printing.
- Mesh tolerance 0.1 mm linear / 0.2 rad angular. Use the STEP in [full_robot/v22](../../assemblies/full_robot/v22/cad/) for engineering changes.
- Kit parts (motors, wheels, beams, gears, belts) and electronics are included only as **reference geometry** for fit checks; do not print them.
- A file whose name ends in `_xN` holds N identical instances in one mesh.

### 10. Hardware (1 parts)

| No. | File | Size X × Y × Z (mm) | Process |
| --- | --- | --- | --- |
| 10.1 | [`10.1_HW_tornillos_M3_boton_x73.stl`](v22/10.1_HW_tornillos_M3_boton_x73.stl) | 438.4 × 457.7 × 603 | Hardware (purchase) |
