Robotica76/2026_MakeX_Challengue/electrical/bom/electrical_bom.md

# Electrical BOM Starter

Status: TBD; not a procurement list or approved component specification.

| Function/category | Part/manufacturer | Quantity | Required characteristics | Authoritative source/revision | Eligibility/compatibility review | Selection/procurement status | Owner |
| --- | --- | --- | --- | --- | --- | --- | --- |
| Control | TBD | TBD | TBD | TBD | TBD | TBD | TBD |
| Actuation/drive electronics, if needed | TBD | TBD | TBD | TBD | TBD | TBD | TBD |
| Sensing/vision, if needed | TBD | TBD | TBD | TBD | TBD | TBD | TBD |
| Power source/distribution/protection | TBD | TBD | TBD | TBD | TBD | TBD | TBD |
| Wiring/connectors, if needed | TBD | TBD | TBD | TBD | TBD | TBD | TBD |

Source specifications later through the [datasheet register](../../resources/datasheets/README.md). Review eligibility against verified [rules](../../resources/rules/README.md), interfaces against [architecture](../architecture/electrical_architecture.md), and electrical demand against [power](../power/power_distribution.md). Record alternatives and approval evidence before assigning part numbers or quantities.
