Robotica76/2026_MakeX_Challengue/mechanical/ball_intake/cad/Intake_StormBreaker.stl

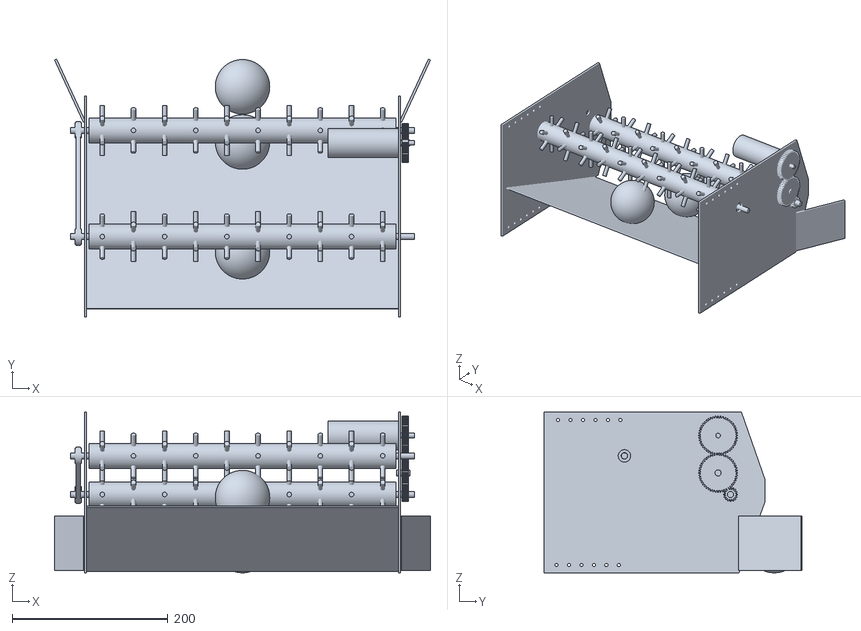
[picture p82: CAD file, 2026-10-24]
mechanical/ball_intake/cad/Intake_StormBreaker.stl
482.7 x 331.2 x 206.3
