Robotica76/2026_MakeX_Challengue/mechanical/ball_intake/cad/v22/4.29_INT_UR_dedos_TPU_espiga.stl

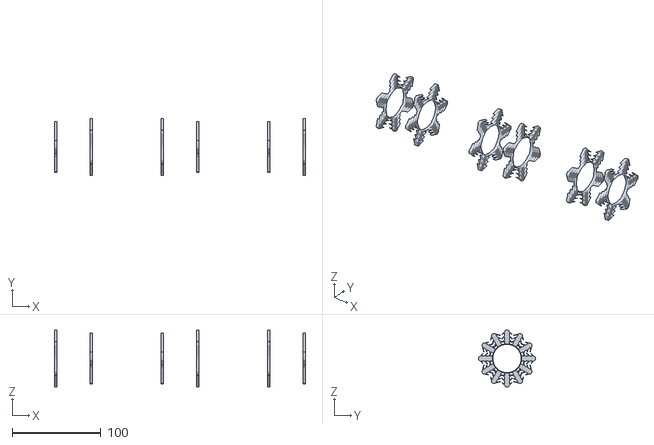
[picture p83: CAD file, 2026-11-07]
mechanical/ball_intake/cad/v22/4.29_INT_UR_dedos_TPU_espiga.stl
283.0 x 64.0 x 64.0
