Robotica76/2026_MakeX_Challengue/mechanical/ball_storage/cad/v22/8.2_CN_rodillo_alimentador_TPU_D30.stl

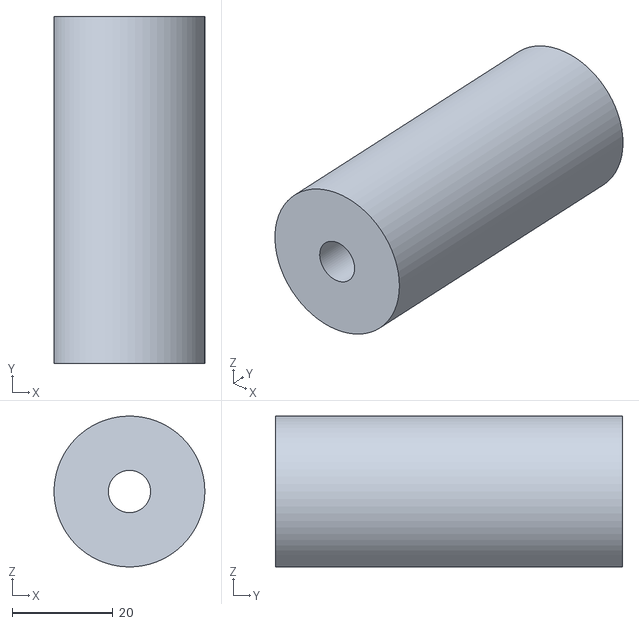
[picture p84: CAD file, 2026-11-07]
mechanical/ball_storage/cad/v22/8.2_CN_rodillo_alimentador_TPU_D30.stl
30.0 x 69.0 x 30.0
