Robotica76/2026_MakeX_Challengue/mechanical/chassis/cad/v22/1.7_CH_guarda_rueda_del_der_PETG.stl

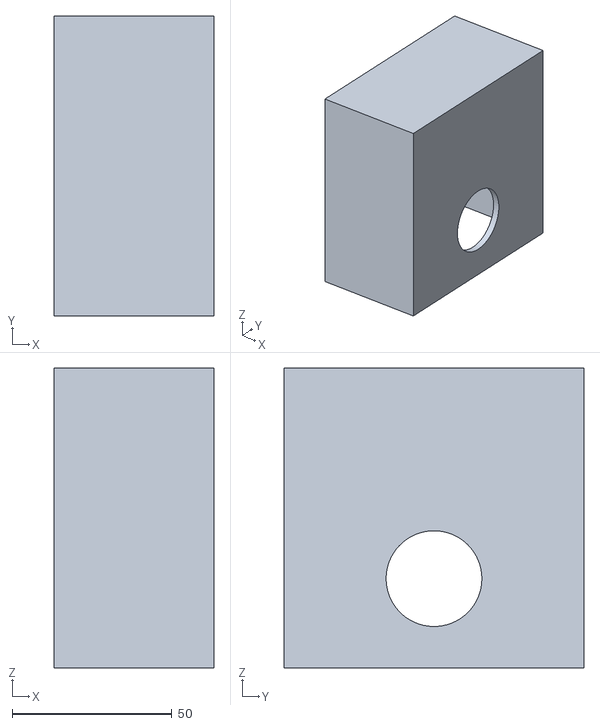
[picture p85: CAD file, 2026-11-07]
mechanical/chassis/cad/v22/1.7_CH_guarda_rueda_del_der_PETG.stl
50.0 x 94.0 x 94.0
