Robotica76/2026_MakeX_Challengue/mechanical/common_parts/cad/v22/10.1_HW_tornillos_M3_boton_x73.stl

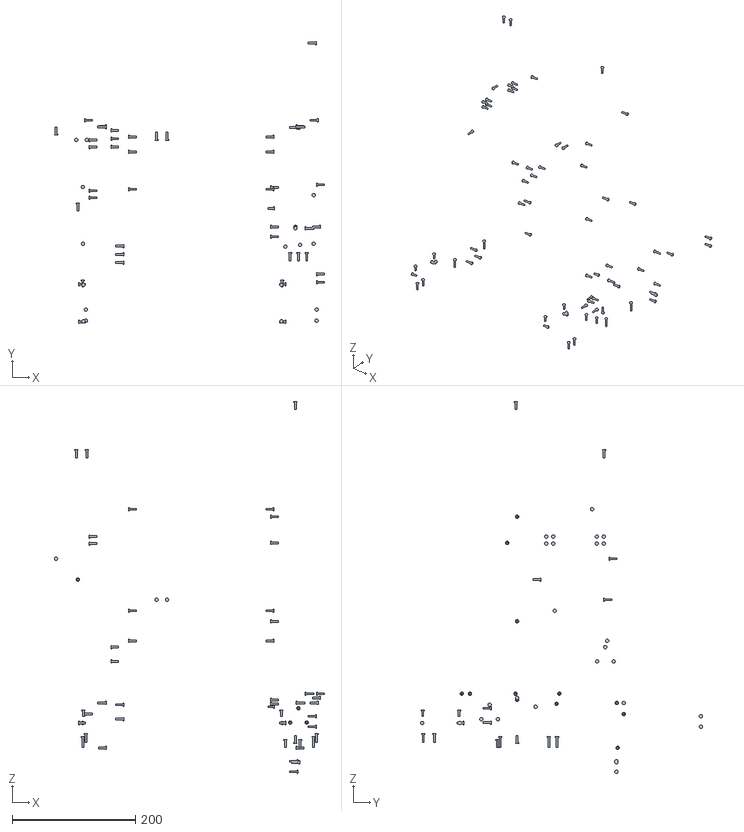
[picture p86: CAD file, 2026-11-07]
mechanical/common_parts/cad/v22/10.1_HW_tornillos_M3_boton_x73.stl
438.3 x 457.7 x 603.0
