Robotica76/2026_MakeX_Challengue/mechanical/feeder/cad/v22/3.5_TW_cubierta_codo_PC_1_5.stl

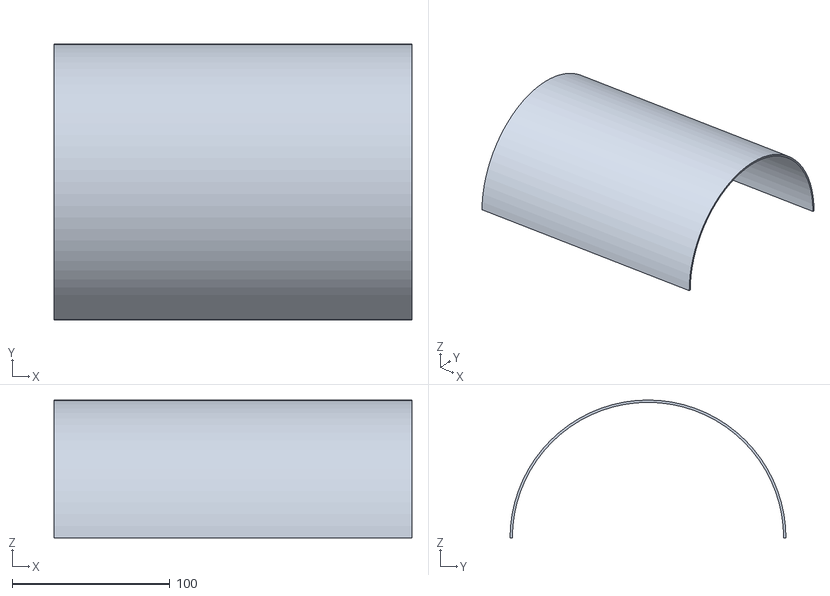
[picture p87: CAD file, 2026-11-07]
mechanical/feeder/cad/v22/3.5_TW_cubierta_codo_PC_1_5.stl
227.0 x 175.0 x 87.5
