Robotica76/2026_MakeX_Challengue/mechanical/flag_system/cad/v22/9.3_FLAG_ligas_x2.stl

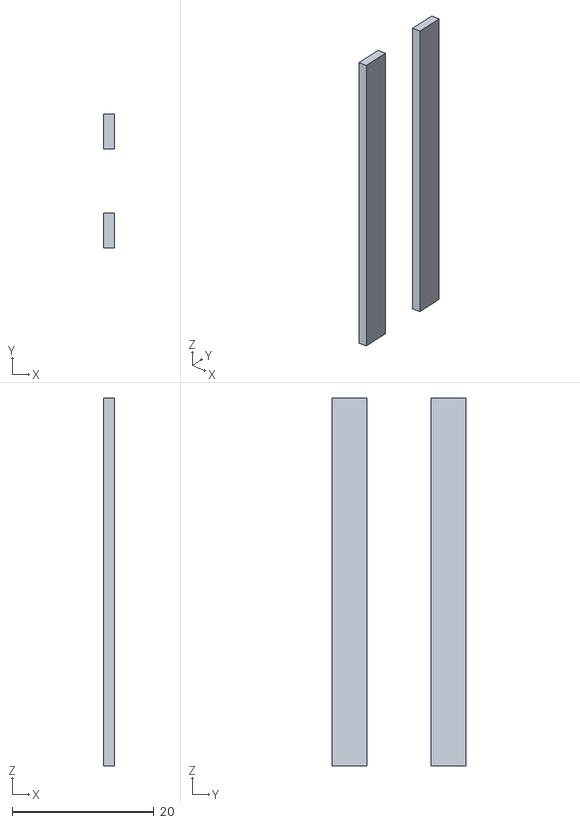
[picture p88: CAD file, 2026-11-07]
mechanical/flag_system/cad/v22/9.3_FLAG_ligas_x2.stl
1.50 x 19.0 x 52.0
