Robotica76/2026_MakeX_Challengue/mechanical/gripper/cad/v22/6.2_CAR_placa_carro_CF3.stl

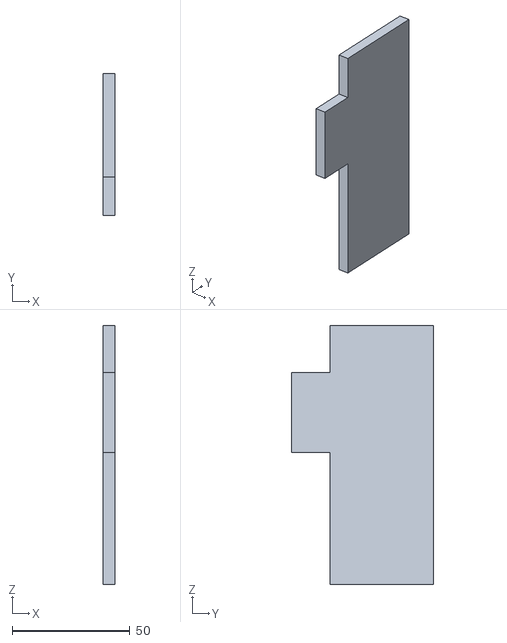
[picture p89: CAD file, 2026-11-07]
mechanical/gripper/cad/v22/6.2_CAR_placa_carro_CF3.stl
5.00 x 60.5 x 110.0
