Robotica76/2026_MakeX_Challengue/mechanical/gripper_elevation/cad/v22/5.25_RIG_separador_torre_mastil_z250_PETG.stl

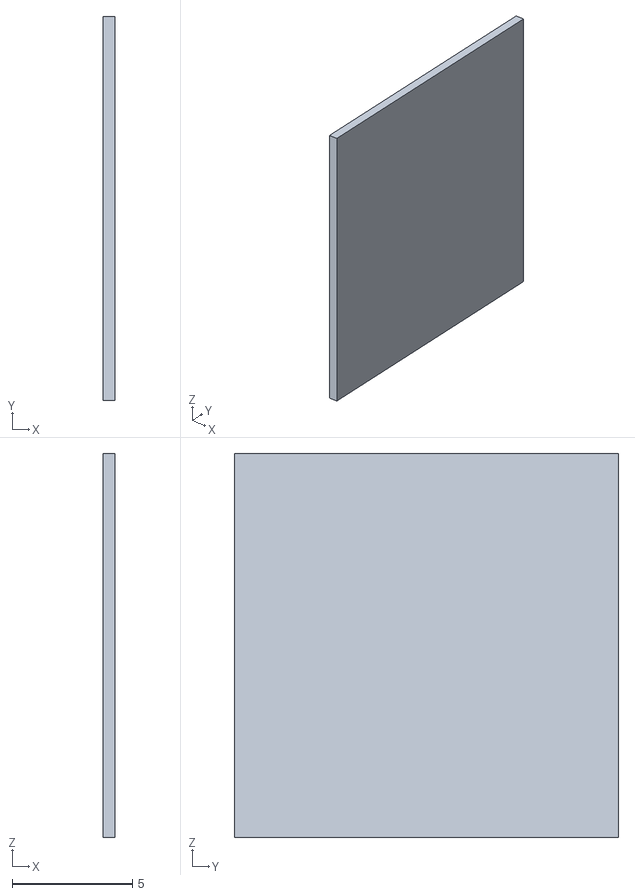
[picture p90: CAD file, 2026-11-07]
mechanical/gripper_elevation/cad/v22/5.25_RIG_separador_torre_mastil_z250_PETG.stl
0.5 x 16.0 x 16.0
