Robotica76/2026_MakeX_Challengue/mechanical/shooter/cad/v22/7.4_RIG_base_lanzador_CF3.stl

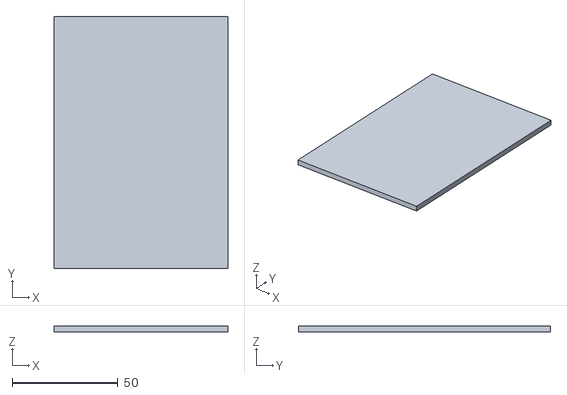
[picture p91: CAD file, 2026-11-07]
mechanical/shooter/cad/v22/7.4_RIG_base_lanzador_CF3.stl
82.0 x 119.0 x 3.00
