Robotica76/2026_MakeX_Challengue/mechanical/ball_intake/cad/v22/4.10_INT_tobogan_repisa_alta_PC_2mm.stl

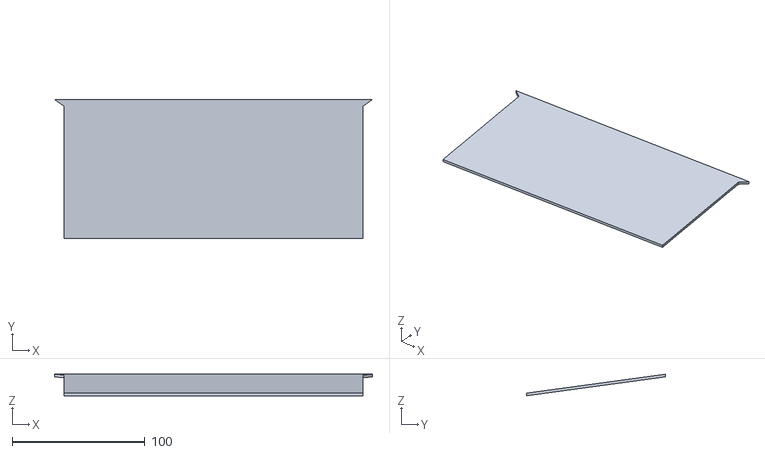
[picture p92: CAD file, 2026-11-07]
mechanical/ball_intake/cad/v22/4.10_INT_tobogan_repisa_alta_PC_2mm.stl
240.0 x 105.0 x 16.3
