Robotica76/2026_MakeX_Challengue/mechanical/ball_storage/cad/v22/8.8_CN_engrane_16T_kit_alimentador.stl

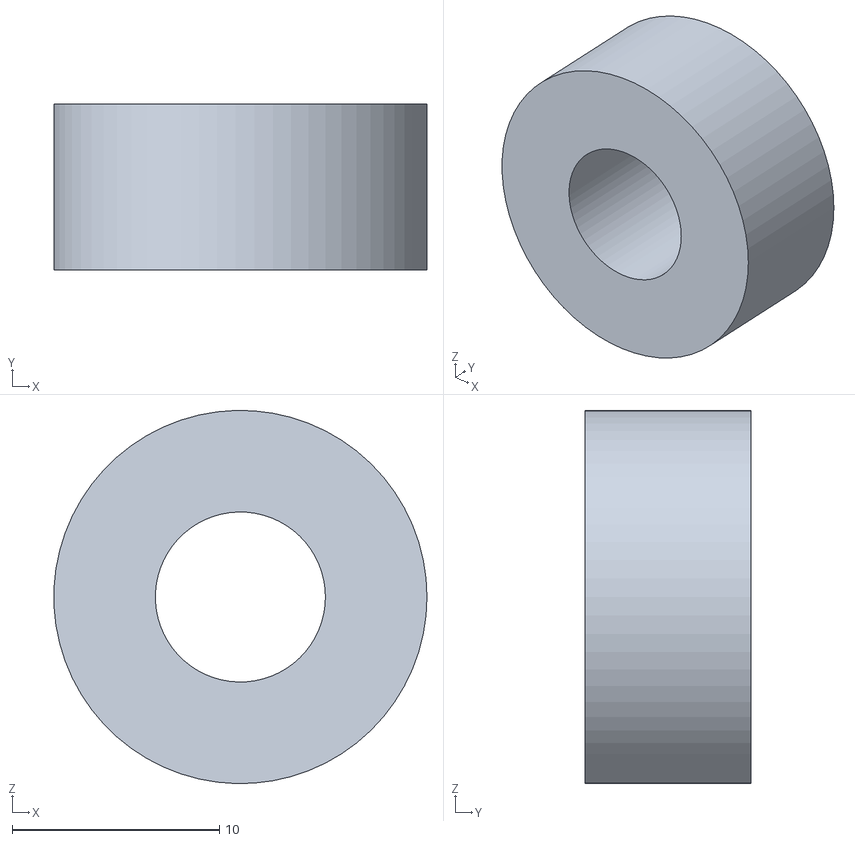
[picture p93: CAD file, 2026-11-07]
mechanical/ball_storage/cad/v22/8.8_CN_engrane_16T_kit_alimentador.stl
18.0 x 8.00 x 18.0
