Robotica76/2026_MakeX_Challengue/mechanical/chassis/cad/v22/1.45_CH_tornillo_M2_5x30_tras_der.stl

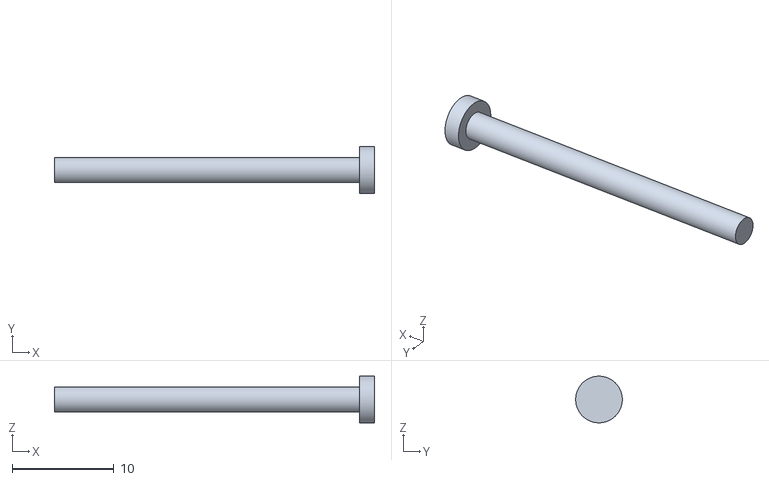
[picture p94: CAD file, 2026-11-07]
mechanical/chassis/cad/v22/1.45_CH_tornillo_M2_5x30_tras_der.stl
31.5 x 4.60 x 4.60
