Robotica76/2026_MakeX_Challengue/mechanical/feeder/cad/v22/3.18_TW_S2_sensor_entrada.stl

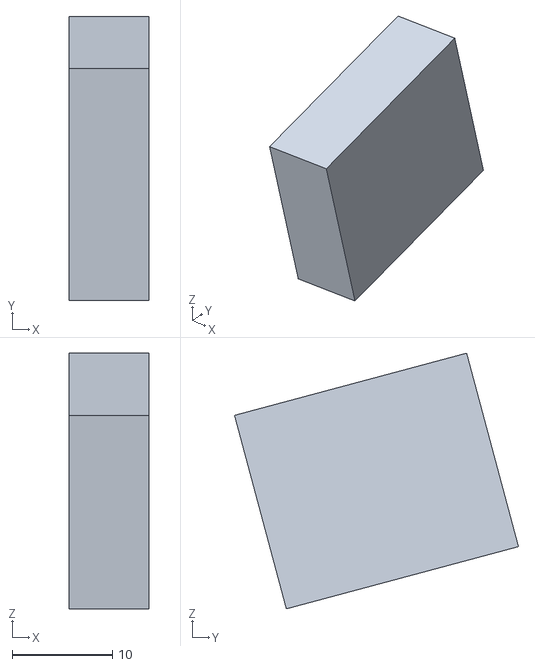
[picture p95: CAD file, 2026-11-07]
mechanical/feeder/cad/v22/3.18_TW_S2_sensor_entrada.stl
8.00 x 28.4 x 25.5
