Robotica76/2026_MakeX_Challengue/mechanical/flag_system/cad/v22/9.4_FLAG_pasador_R_D3.stl

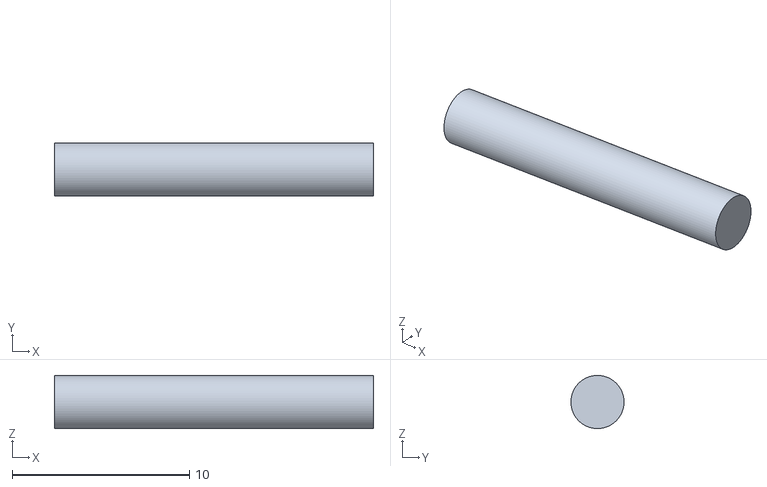
[picture p96: CAD file, 2026-11-07]
mechanical/flag_system/cad/v22/9.4_FLAG_pasador_R_D3.stl
18.0 x 3.00 x 3.00
