Robotica76/2026_MakeX_Challengue/mechanical/gripper/cad/v22/6.17_FLAG_receptor_mastil_PETG.stl

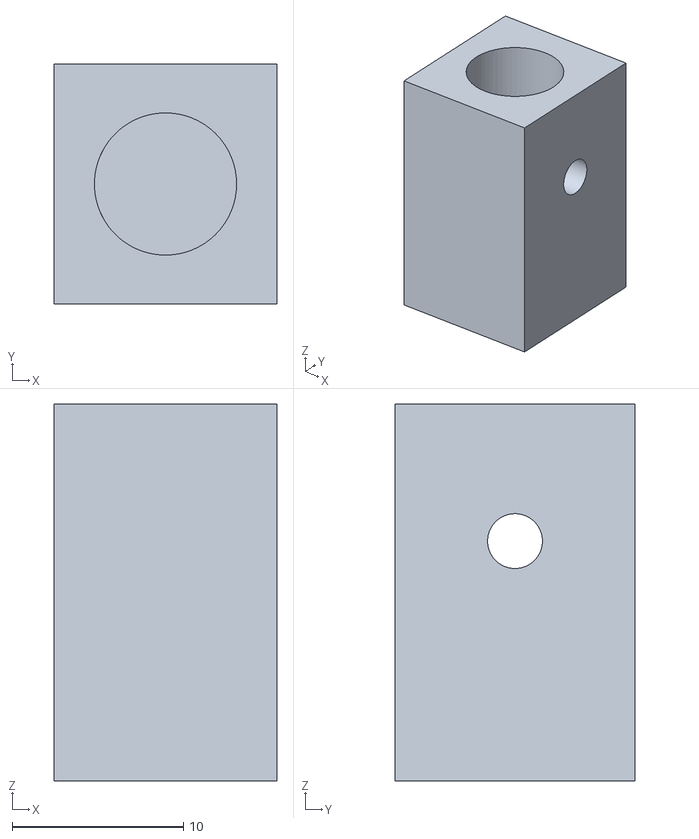
[picture p97: CAD file, 2026-11-07]
mechanical/gripper/cad/v22/6.17_FLAG_receptor_mastil_PETG.stl
13.0 x 14.0 x 22.0
