Robotica76/2026_MakeX_Challengue/mechanical/gripper_elevation/cad/v22/5.7_ELV_AI_camera_2_0_kit.stl

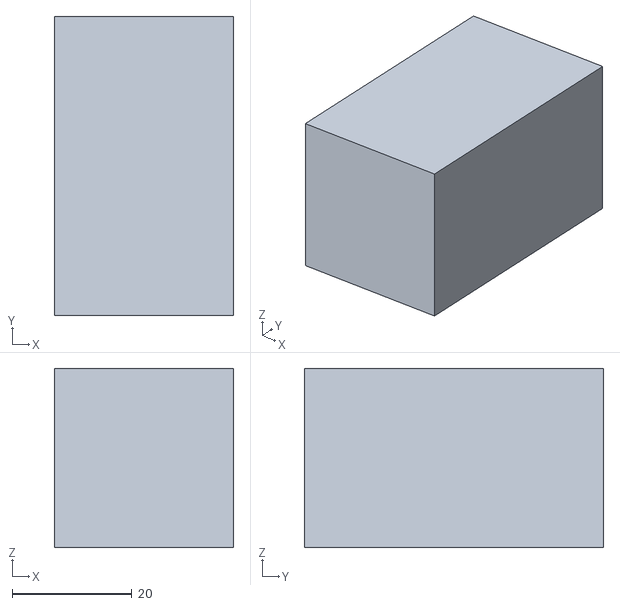
[picture p98: CAD file, 2026-11-07]
mechanical/gripper_elevation/cad/v22/5.7_ELV_AI_camera_2_0_kit.stl
30.0 x 50.0 x 30.0
