Robotica76/2026_MakeX_Challengue/mechanical/shooter/cad/v22/7.12_SH_capucha_costillas_PETG_x3.stl

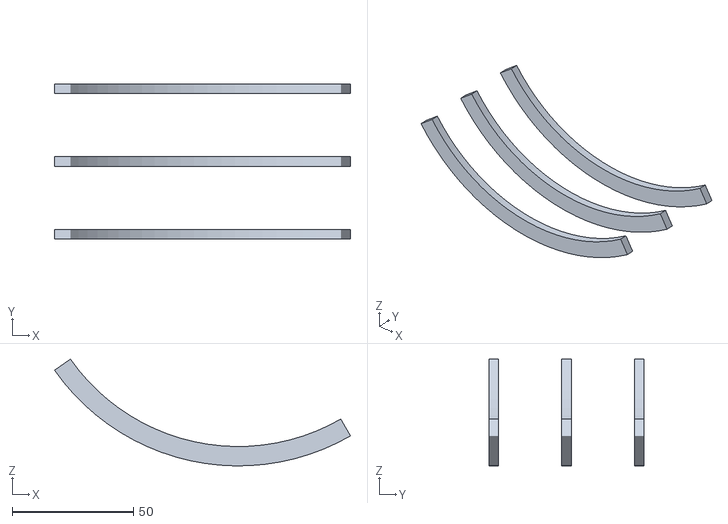
[picture p99: CAD file, 2026-11-07]
mechanical/shooter/cad/v22/7.12_SH_capucha_costillas_PETG_x3.stl
122.0 x 64.0 x 44.0
