Robotica76/2026_MakeX_Challengue/mechanical/ball_intake/cad/v22/4.8_INT_placa_lateral_der_CF3.stl

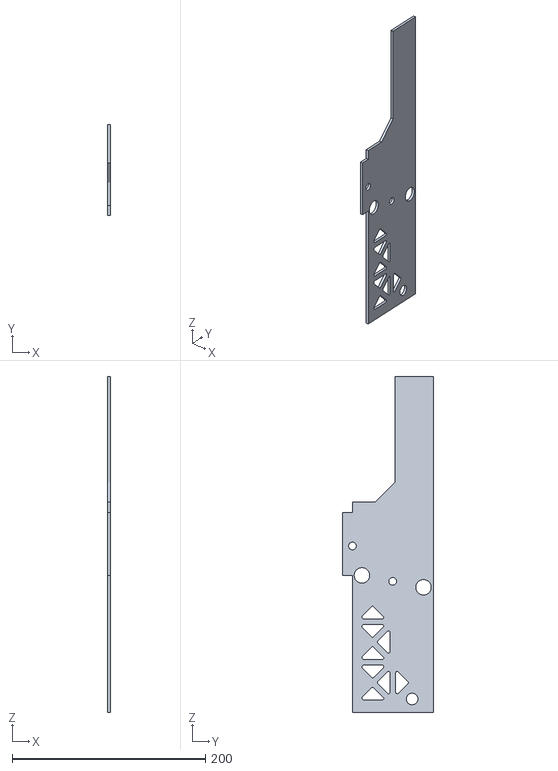
[picture p100: CAD file, 2026-11-07]
mechanical/ball_intake/cad/v22/4.8_INT_placa_lateral_der_CF3.stl
3.00 x 94.0 x 348.0
