Robotica76/2026_MakeX_Challengue/mechanical/ball_storage/cad/v22/8.7_CN_eje_alimentador_D8_Al.stl

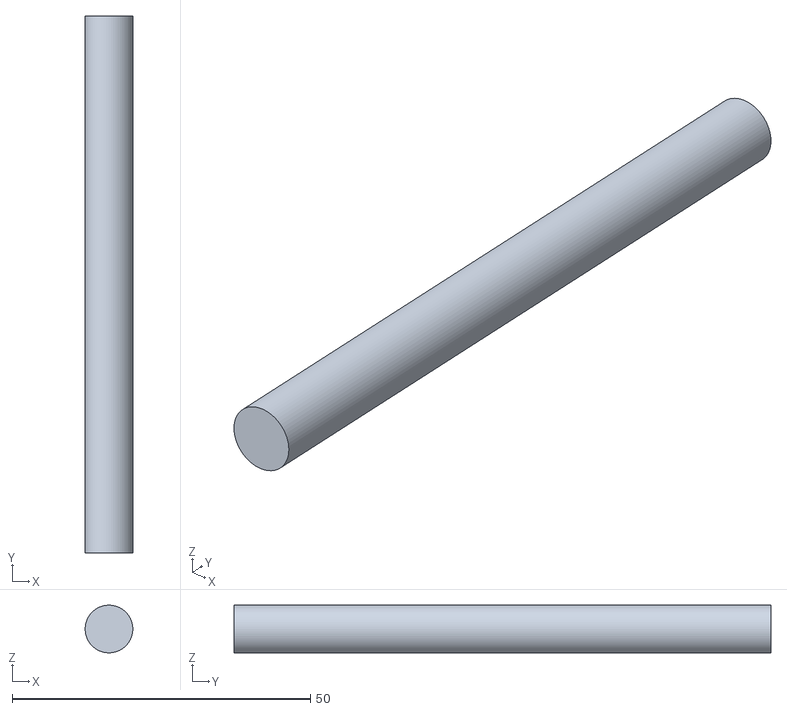
[picture p101: CAD file, 2026-11-07]
mechanical/ball_storage/cad/v22/8.7_CN_eje_alimentador_D8_Al.stl
8.00 x 90.0 x 8.00
