Robotica76/2026_MakeX_Challengue/mechanical/chassis/cad/v22/1.41_CH_tornillos_M4x20_motor_tras_der.stl

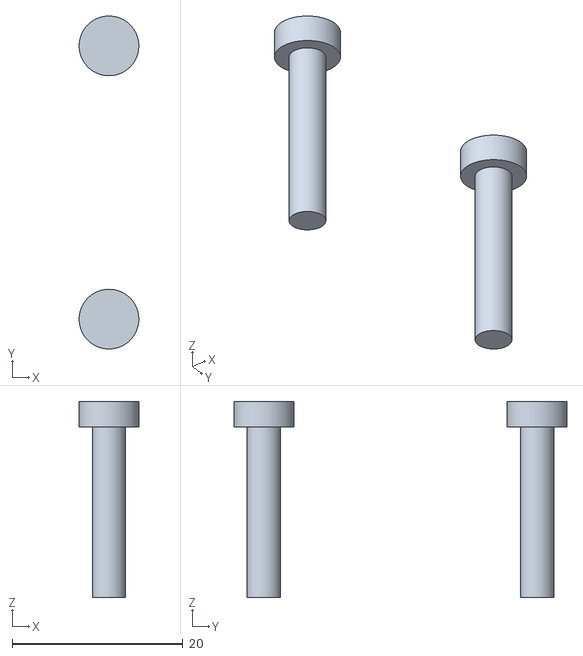
[picture p102: CAD file, 2026-11-07]
mechanical/chassis/cad/v22/1.41_CH_tornillos_M4x20_motor_tras_der.stl
7.00 x 39.0 x 23.0
