Robotica76/2026_MakeX_Challengue/mechanical/feeder/cad/v22/3.9_TW_bandas_PU_redondas_kit_x6_L800.stl

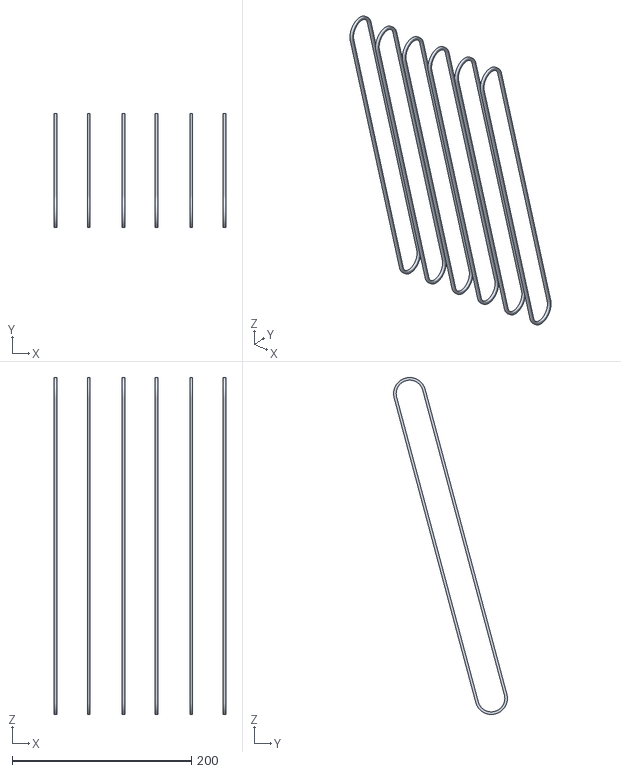
[picture p103: CAD file, 2026-11-07]
mechanical/feeder/cad/v22/3.9_TW_bandas_PU_redondas_kit_x6_L800.stl
191.4 x 127.1 x 376.0
