Robotica76/2026_MakeX_Challengue/mechanical/flag_system/cad/v22/9.1_FLAG_cabeza_C_PETG.stl

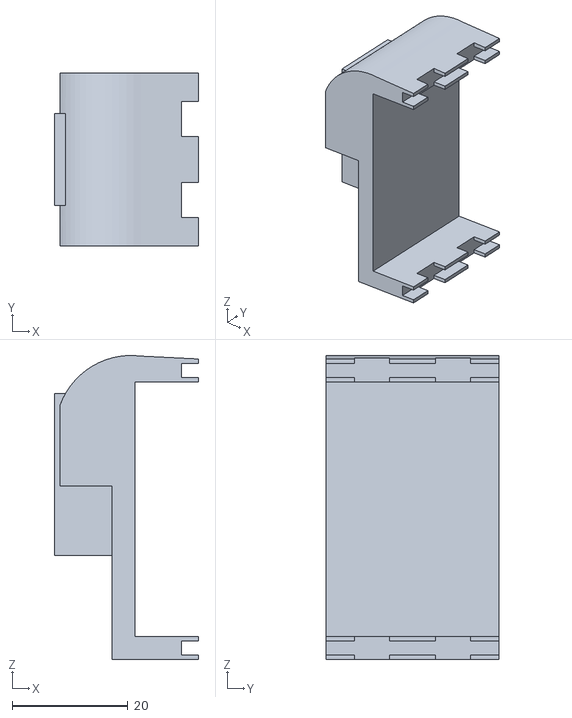
[picture p104: CAD file, 2026-11-07]
mechanical/flag_system/cad/v22/9.1_FLAG_cabeza_C_PETG.stl
25.0 x 30.0 x 52.6
