Robotica76/2026_MakeX_Challengue/mechanical/gripper/cad/v22/6.5_GR_almohadilla_V_movil_TPU.stl

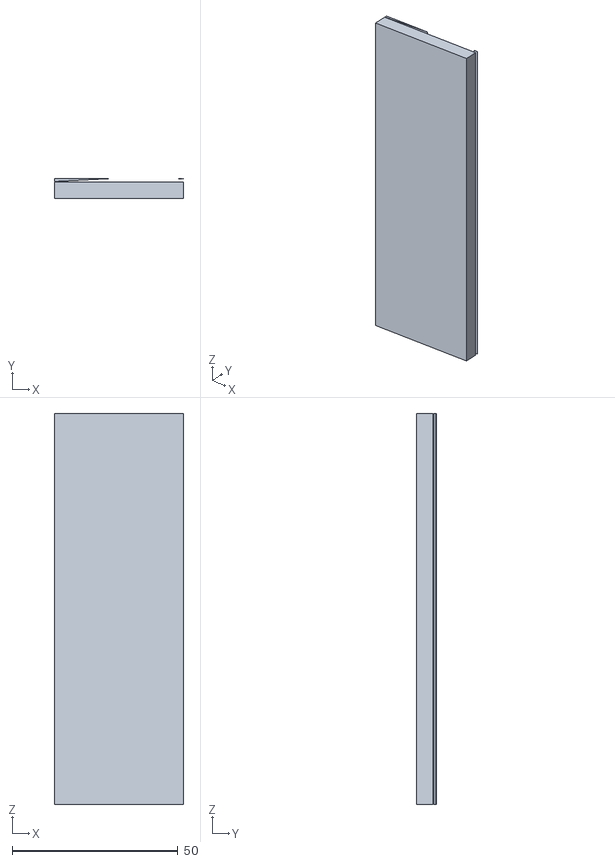
[picture p105: CAD file, 2026-11-07]
mechanical/gripper/cad/v22/6.5_GR_almohadilla_V_movil_TPU.stl
39.0 x 6.00 x 118.0
