Robotica76/2026_MakeX_Challengue/mechanical/gripper_elevation/cad/v22/5.6_MAS_placa_delantera_CF3.stl

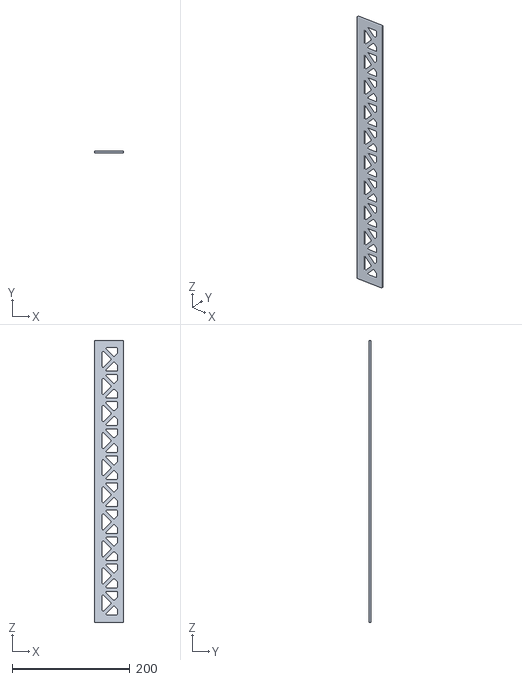
[picture p106: CAD file, 2026-11-07]
mechanical/gripper_elevation/cad/v22/5.6_MAS_placa_delantera_CF3.stl
49.0 x 3.00 x 479.0
