Robotica76/2026_MakeX_Challengue/mechanical/shooter/cad/v22/7.11_SH_brushless_ESC_kit_x2.stl

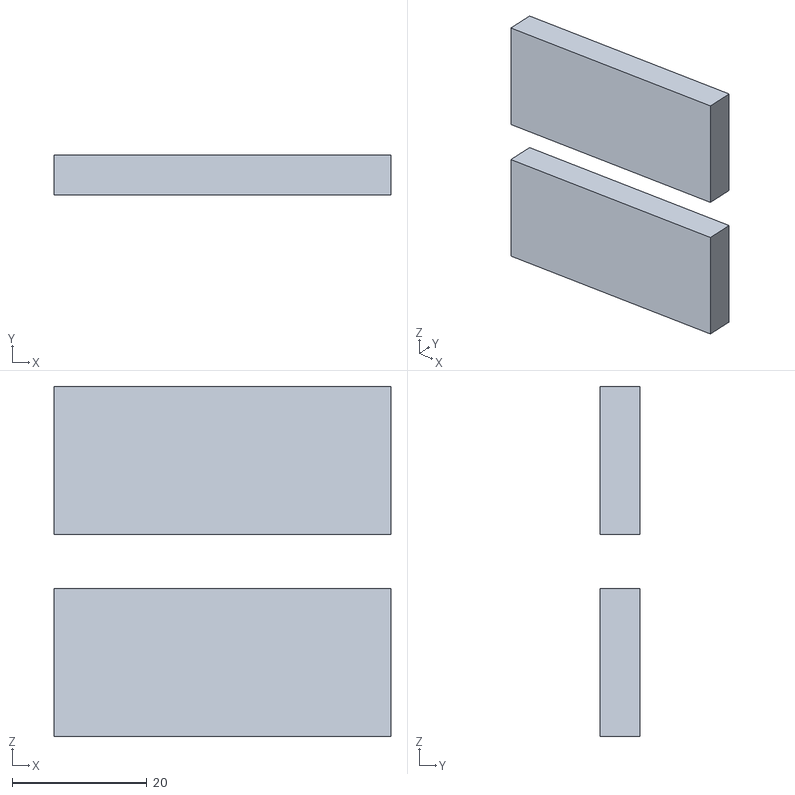
[picture p107: CAD file, 2026-11-07]
mechanical/shooter/cad/v22/7.11_SH_brushless_ESC_kit_x2.stl
50.0 x 6.00 x 52.0
