Robotica76/2026_MakeX_Challengue/mechanical/ball_intake/cad/v22/4.35_INT_LR_vaso_soporte_motor_PETG.stl

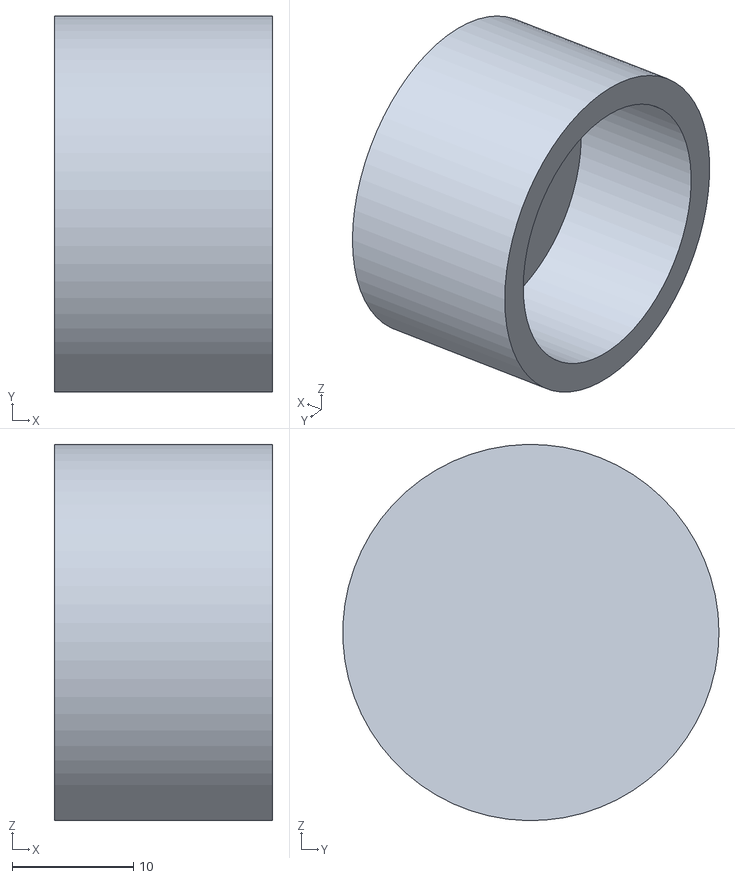
[picture p108: CAD file, 2026-11-07]
mechanical/ball_intake/cad/v22/4.35_INT_LR_vaso_soporte_motor_PETG.stl
18.0 x 31.0 x 31.0
