Robotica76/2026_MakeX_Challengue/mechanical/ball_storage/cad/v22/8.4_CN_motor_DC25_200rpm_alimentador_3a1.stl

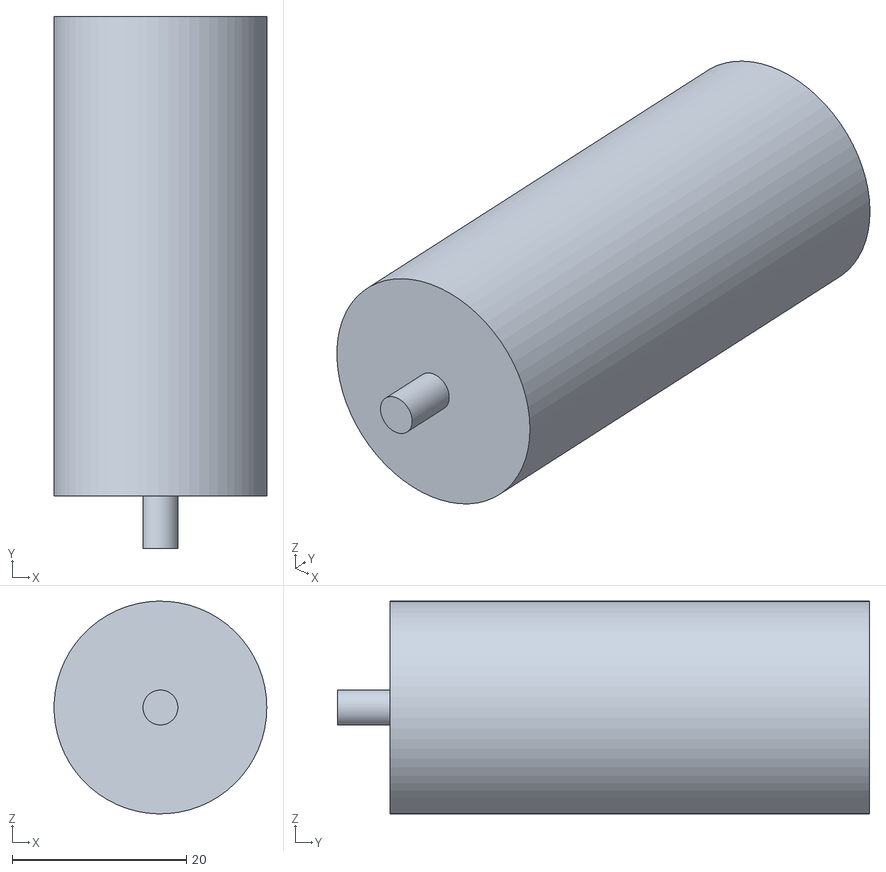
[picture p109: CAD file, 2026-11-07]
mechanical/ball_storage/cad/v22/8.4_CN_motor_DC25_200rpm_alimentador_3a1.stl
24.4 x 61.0 x 24.4
