Robotica76/2026_MakeX_Challengue/mechanical/chassis/cad/v22/2.8_ELB_caja_esquineros_PETG_x4.stl

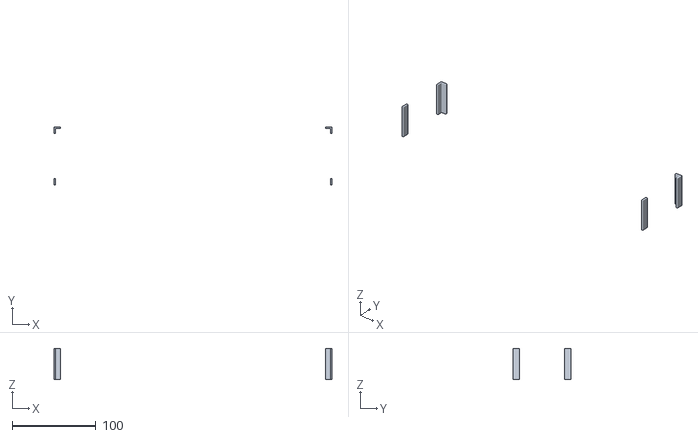
[picture p110: CAD file, 2026-11-07]
mechanical/chassis/cad/v22/2.8_ELB_caja_esquineros_PETG_x4.stl
331.0 x 69.0 x 37.0
