Robotica76/2026_MakeX_Challengue/mechanical/feeder/cad/v22/3.3_TW_placa_respaldo_bandas_PC.stl

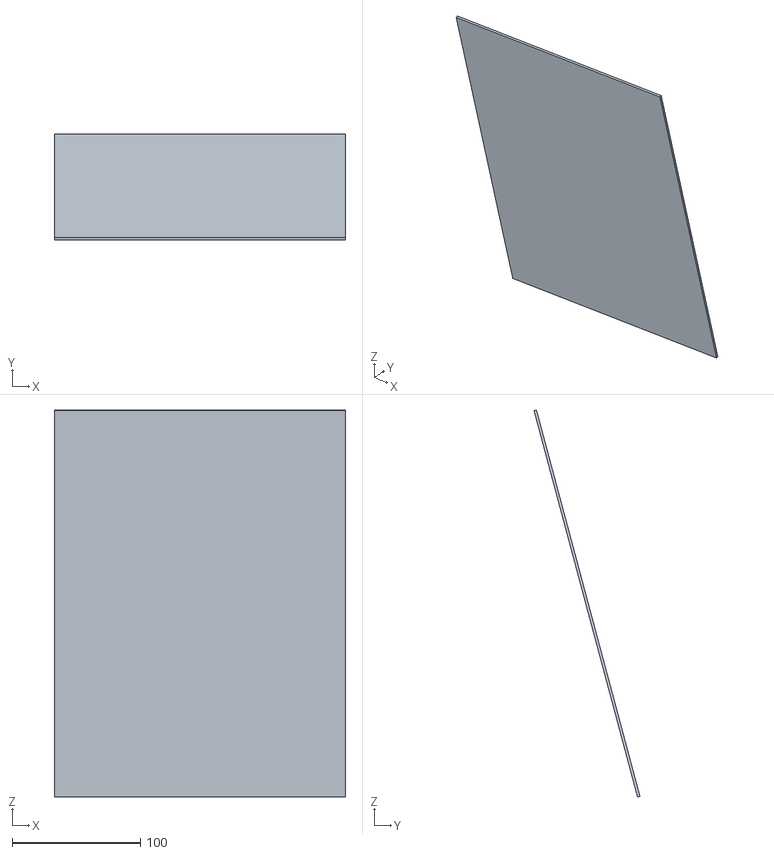
[picture p111: CAD file, 2026-11-07]
mechanical/feeder/cad/v22/3.3_TW_placa_respaldo_bandas_PC.stl
227.0 x 82.7 x 301.9
