Robotica76/2026_MakeX_Challengue/mechanical/flag_system/cad/v22/9.2_FLAG_mastil_tubo_CF_8x6.stl

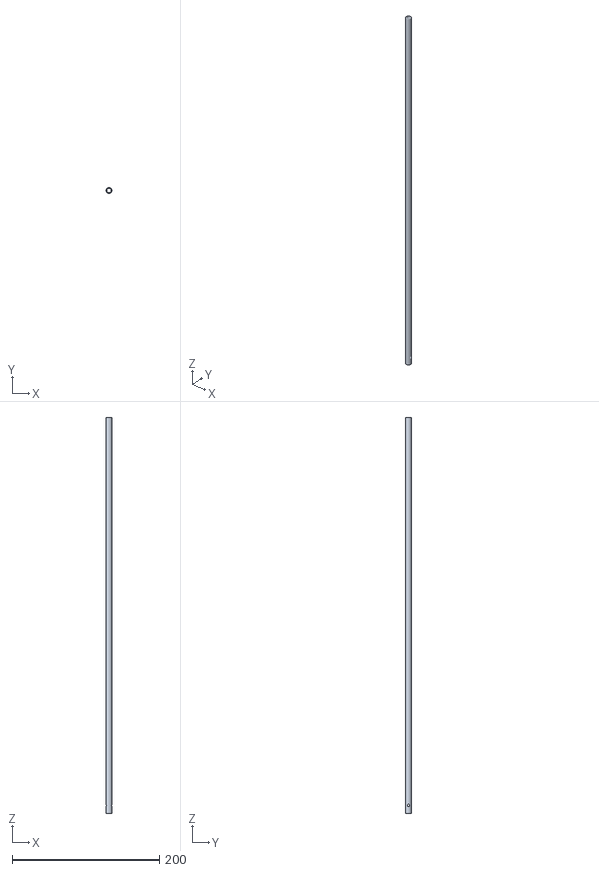
[picture p112: CAD file, 2026-11-07]
mechanical/flag_system/cad/v22/9.2_FLAG_mastil_tubo_CF_8x6.stl
8.00 x 8.00 x 537.0
