Robotica76/2026_MakeX_Challengue/mechanical/gripper_elevation/cad/v22/5.14_RIG_cuaderna_intake_elevador_izq_CF3.stl

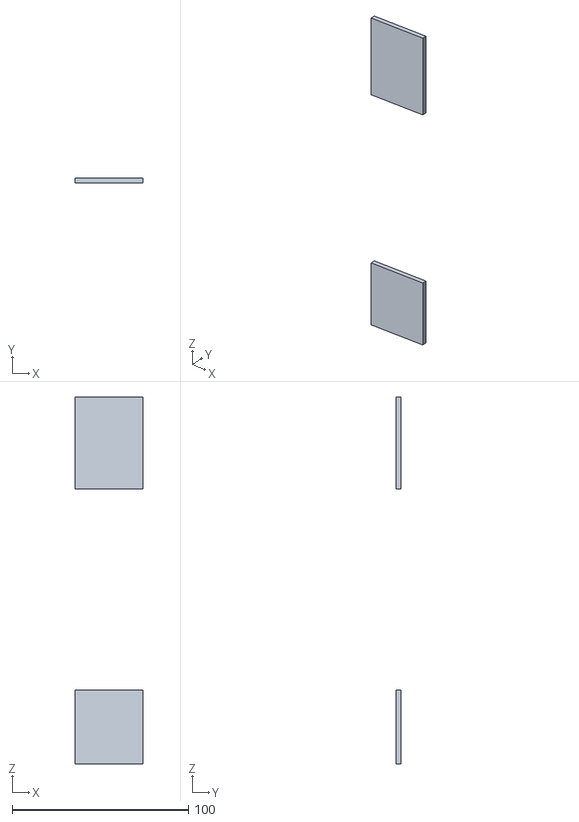
[picture p113: CAD file, 2026-11-07]
mechanical/gripper_elevation/cad/v22/5.14_RIG_cuaderna_intake_elevador_izq_CF3.stl
38.5 x 3.00 x 208.0
