Robotica76/2026_MakeX_Challengue/mechanical/shooter/cad/v22/7.18_SH_aleta_capucha_PC2mm_servo.stl

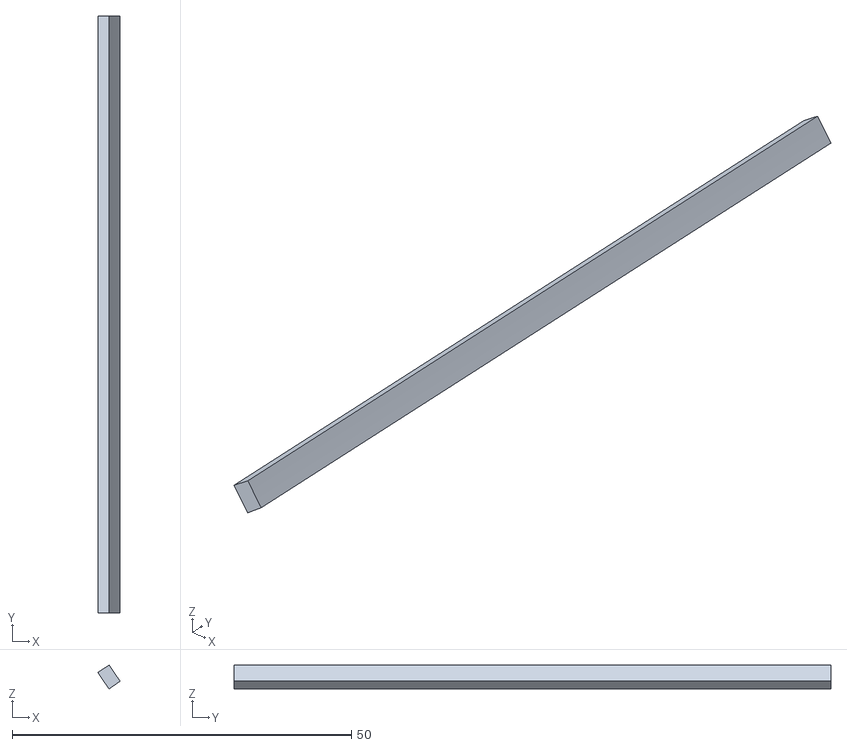
[picture p114: CAD file, 2026-11-07]
mechanical/shooter/cad/v22/7.18_SH_aleta_capucha_PC2mm_servo.stl
3.29 x 88.0 x 3.53
