Robotica76/2026_MakeX_Challengue/mechanical/ball_intake/cad/v22/4.21_INT_UR_poleas_PU_20mm_kit_nariz_y_cola_x10.stl

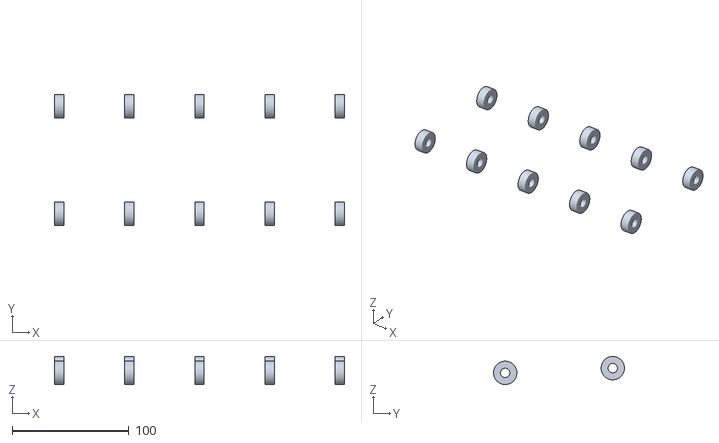
[picture p115: CAD file, 2026-11-07]
mechanical/ball_intake/cad/v22/4.21_INT_UR_poleas_PU_20mm_kit_nariz_y_cola_x10.stl
248.0 x 112.0 x 24.0
