Robotica76/2026_MakeX_Challengue/mechanical/ball_storage/cad/v22/8.5_CN_engrane_48T_kit_motor_alimentador.stl

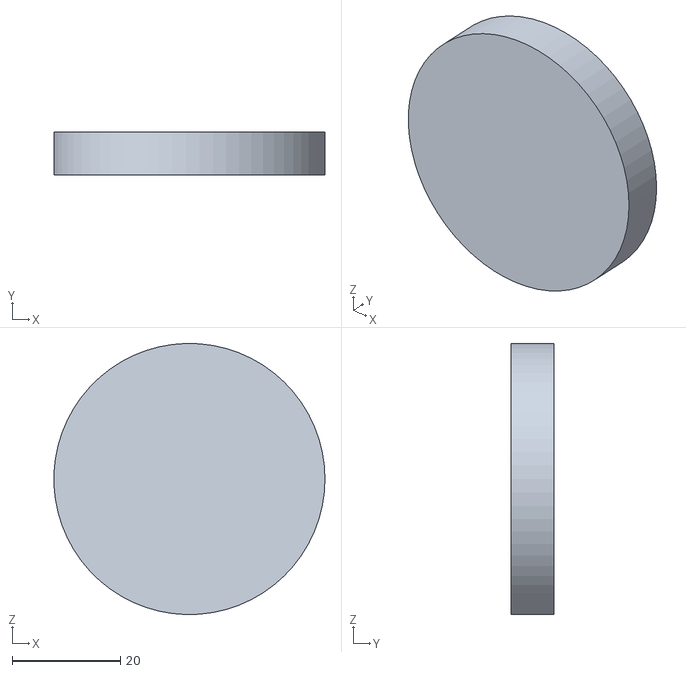
[picture p116: CAD file, 2026-11-07]
mechanical/ball_storage/cad/v22/8.5_CN_engrane_48T_kit_motor_alimentador.stl
50.0 x 8.00 x 50.0
