Robotica76/2026_MakeX_Challengue/mechanical/chassis/cad/v22/1.37_CH_hub_mecanum_80_del_izq.stl

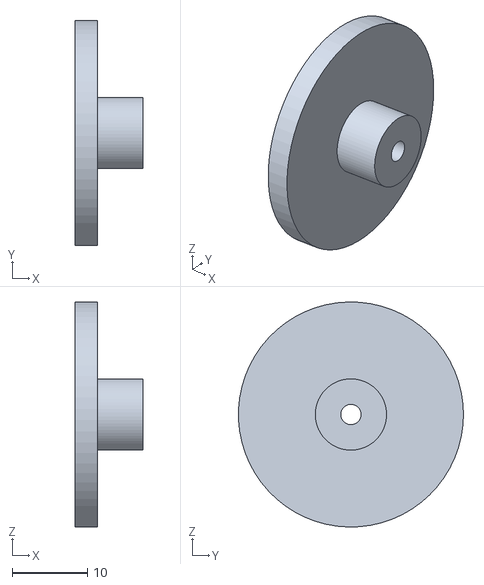
[picture p117: CAD file, 2026-11-07]
mechanical/chassis/cad/v22/1.37_CH_hub_mecanum_80_del_izq.stl
9.00 x 30.0 x 30.0
