Robotica76/2026_MakeX_Challengue/mechanical/feeder/cad/v22/3.1_TW_placa_lateral_der_CF3.stl

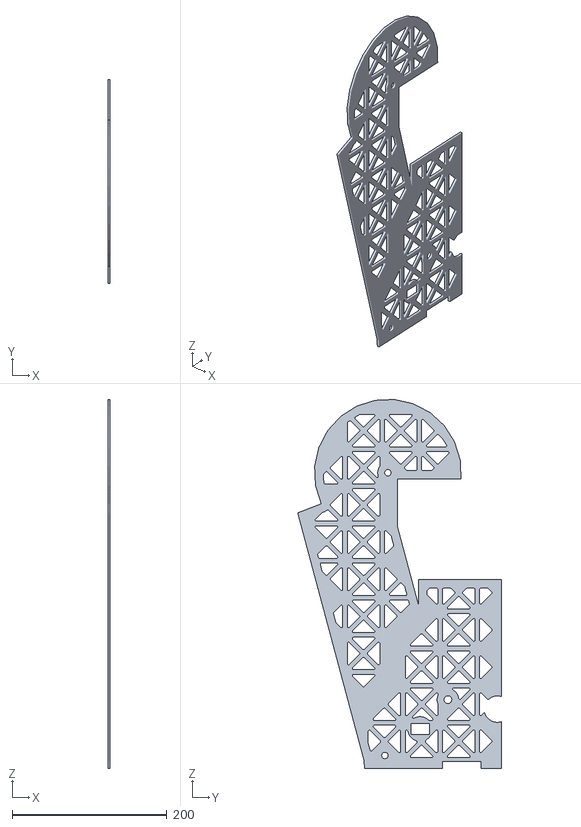
[picture p118: CAD file, 2026-11-07]
mechanical/feeder/cad/v22/3.1_TW_placa_lateral_der_CF3.stl
3.00 x 263.2 x 476.8
