Robotica76/2026_MakeX_Challengue/mechanical/gripper/cad/v22/6.18_GR_acople_motor.stl

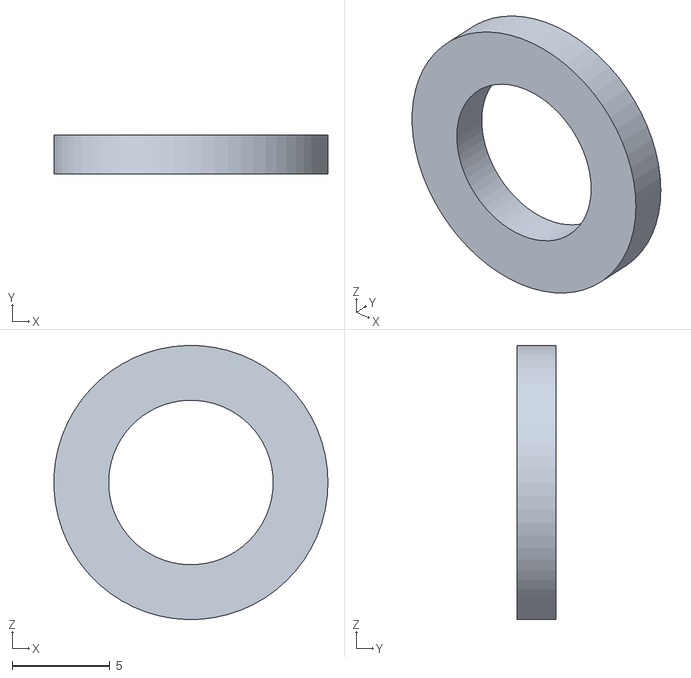
[picture p119: CAD file, 2026-11-07]
mechanical/gripper/cad/v22/6.18_GR_acople_motor.stl
14.0 x 2.00 x 14.0
