Robotica76/2026_MakeX_Challengue/mechanical/gripper_elevation/cad/v22/5.16_ELV_bracket_DC37_kit.stl

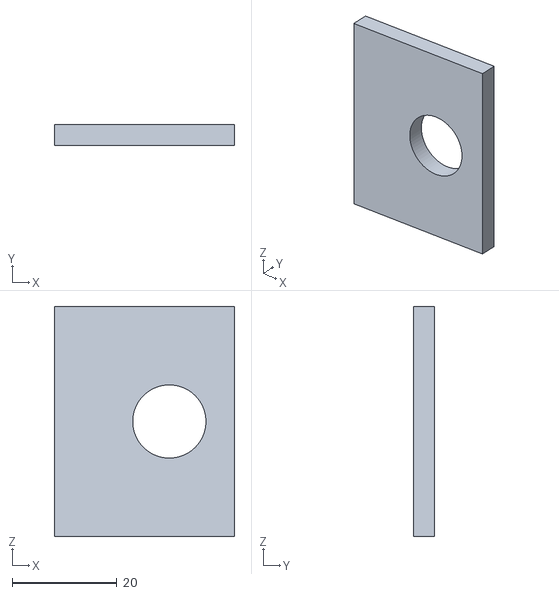
[picture p120: CAD file, 2026-11-07]
mechanical/gripper_elevation/cad/v22/5.16_ELV_bracket_DC37_kit.stl
34.5 x 4.00 x 44.0
