Robotica76/2026_MakeX_Challengue/mechanical/shooter/cad/v22/7.17_SH_bisagra_aleta_D3.stl

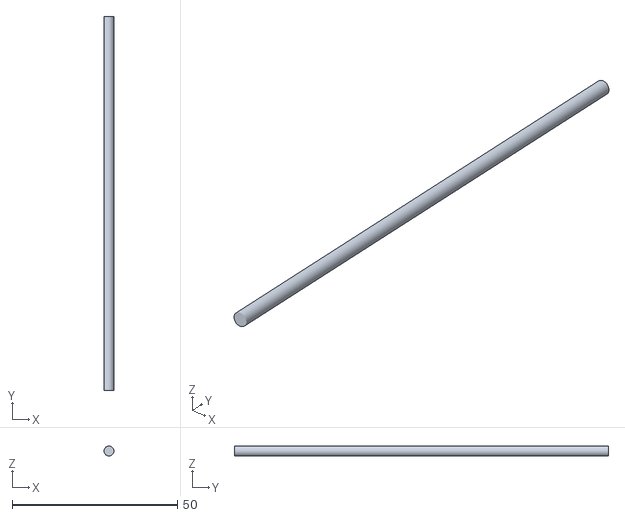
[picture p121: CAD file, 2026-11-07]
mechanical/shooter/cad/v22/7.17_SH_bisagra_aleta_D3.stl
3.00 x 113.0 x 3.00
