Robotica76/2026_MakeX_Challengue/mechanical/ball_intake/cad/v22/4.30_INT_UR_soporte_superior_PETG.stl

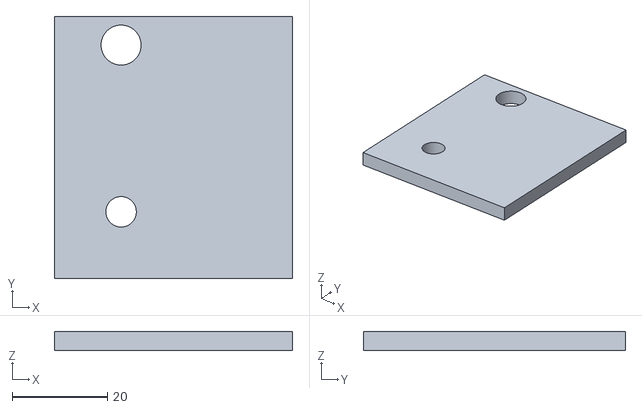
[picture p122: CAD file, 2026-11-07]
mechanical/ball_intake/cad/v22/4.30_INT_UR_soporte_superior_PETG.stl
50.0 x 55.0 x 4.00
