Robotica76/2026_MakeX_Challengue/mechanical/ball_storage/cad/v22/8.9_CN_buje_alimentador_en_pared_trasera.stl

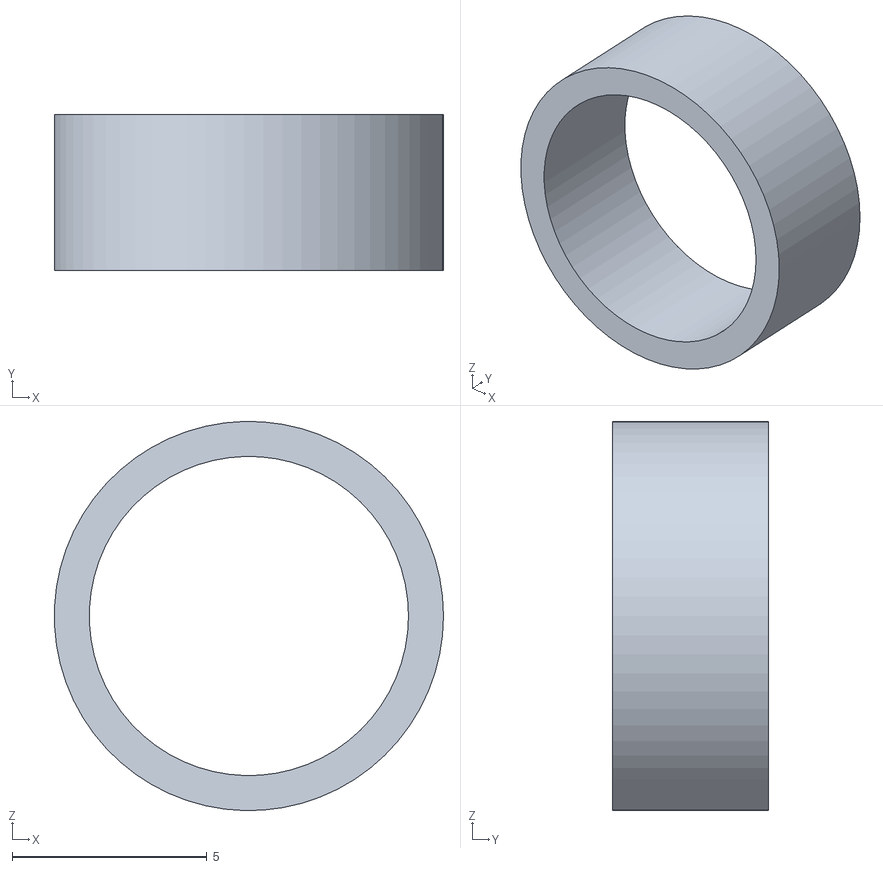
[picture p123: CAD file, 2026-11-07]
mechanical/ball_storage/cad/v22/8.9_CN_buje_alimentador_en_pared_trasera.stl
9.99 x 4.00 x 10.00
