Robotica76/2026_MakeX_Challengue/mechanical/chassis/cad/v22/1.23_CH_engranes_40T_impresos_del_der.stl

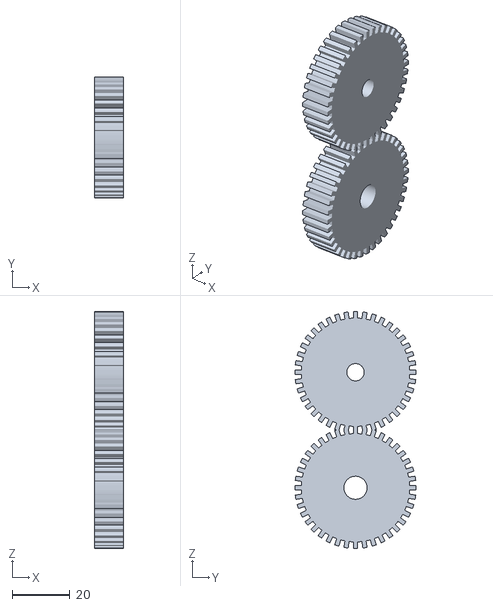
[picture p124: CAD file, 2026-11-07]
mechanical/chassis/cad/v22/1.23_CH_engranes_40T_impresos_del_der.stl
10.0 x 42.1 x 82.1
