Robotica76/2026_MakeX_Challengue/mechanical/feeder/cad/v22/3.4_TW_motor_DC37_200rpm_kit.stl

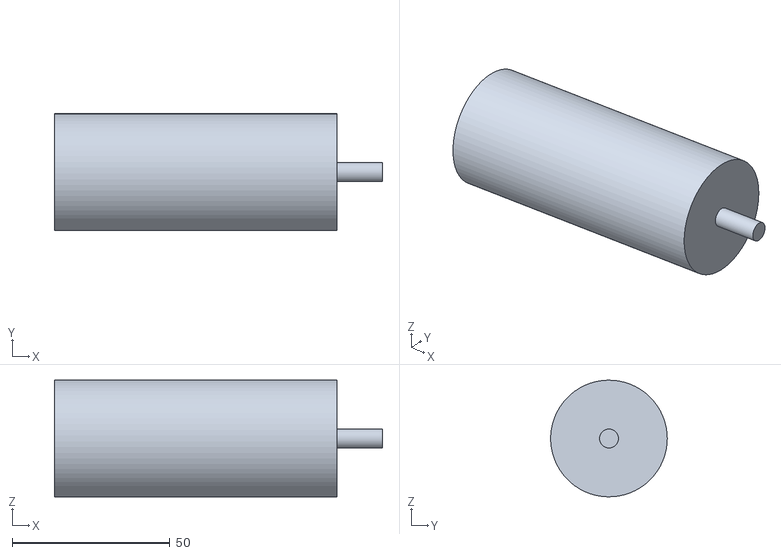
[picture p125: CAD file, 2026-11-07]
mechanical/feeder/cad/v22/3.4_TW_motor_DC37_200rpm_kit.stl
104.0 x 37.0 x 37.0
