Robotica76/2026_MakeX_Challengue/mechanical/gripper/cad/v22/6.11_GR_guia_D8_tubo_Al.stl

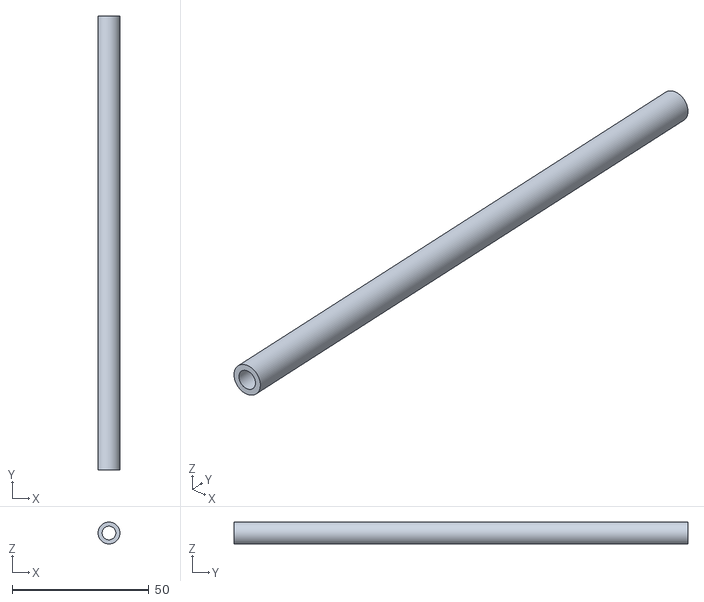
[picture p126: CAD file, 2026-11-07]
mechanical/gripper/cad/v22/6.11_GR_guia_D8_tubo_Al.stl
8.00 x 166.0 x 8.00
