Robotica76/2026_MakeX_Challengue/mechanical/shooter/cad/v22/7.8_SH_servo_MS12A_kit.stl

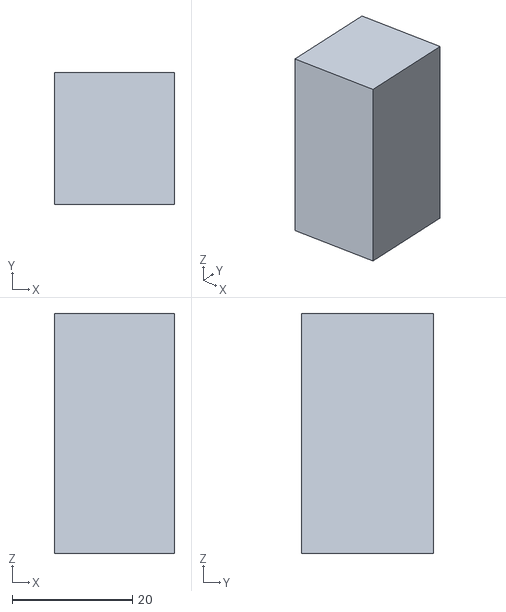
[picture p127: CAD file, 2026-11-07]
mechanical/shooter/cad/v22/7.8_SH_servo_MS12A_kit.stl
20.0 x 22.0 x 40.0
