Robotica76/2026_MakeX_Challengue/mechanical/ball_intake/cad/v22/4.5_INT_UR_anillos_banda_D60_PETG.stl

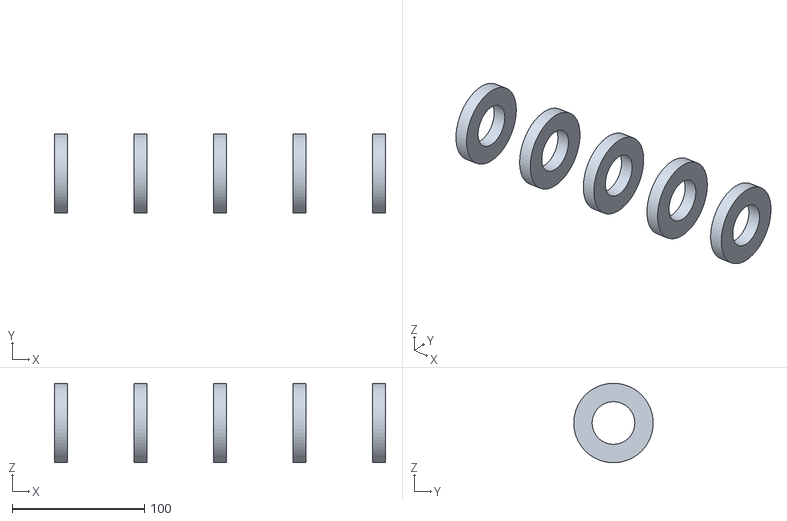
[picture p128: CAD file, 2026-11-07]
mechanical/ball_intake/cad/v22/4.5_INT_UR_anillos_banda_D60_PETG.stl
250.0 x 60.0 x 60.0
