Robotica76/2026_MakeX_Challengue/mechanical/ball_storage/cad/v22/8.6_CN_soporte_alimentador_y_motor_PETG.stl

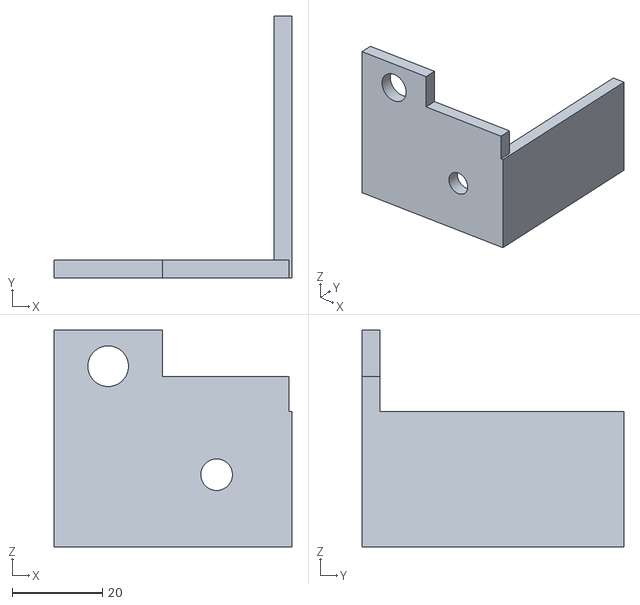
[picture p129: CAD file, 2026-11-07]
mechanical/ball_storage/cad/v22/8.6_CN_soporte_alimentador_y_motor_PETG.stl
52.7 x 58.0 x 48.0
