Robotica76/2026_MakeX_Challengue/mechanical/chassis/cad/v22/1.18_CH_motor_180_encoder_del_der_caja.stl

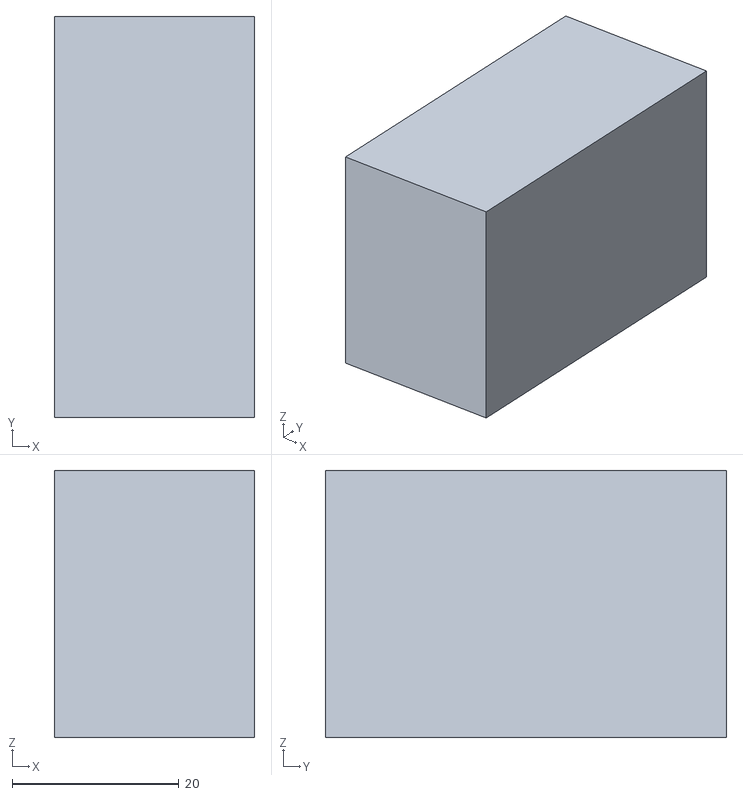
[picture p130: CAD file, 2026-11-07]
mechanical/chassis/cad/v22/1.18_CH_motor_180_encoder_del_der_caja.stl
24.0 x 48.1 x 32.0
