Robotica76/2026_MakeX_Challengue/mechanical/feeder/cad/v22/3.17_TW_munones_codo_D8_x2.stl

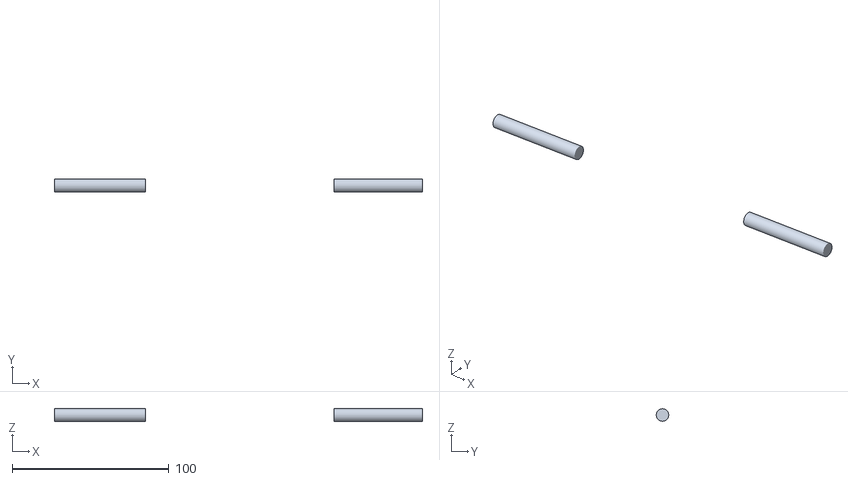
[picture p131: CAD file, 2026-11-07]
mechanical/feeder/cad/v22/3.17_TW_munones_codo_D8_x2.stl
234.5 x 8.00 x 8.00
