Robotica76/2026_MakeX_Challengue/mechanical/gripper/cad/v22/6.3_GR_motor_DC25_pinza.stl

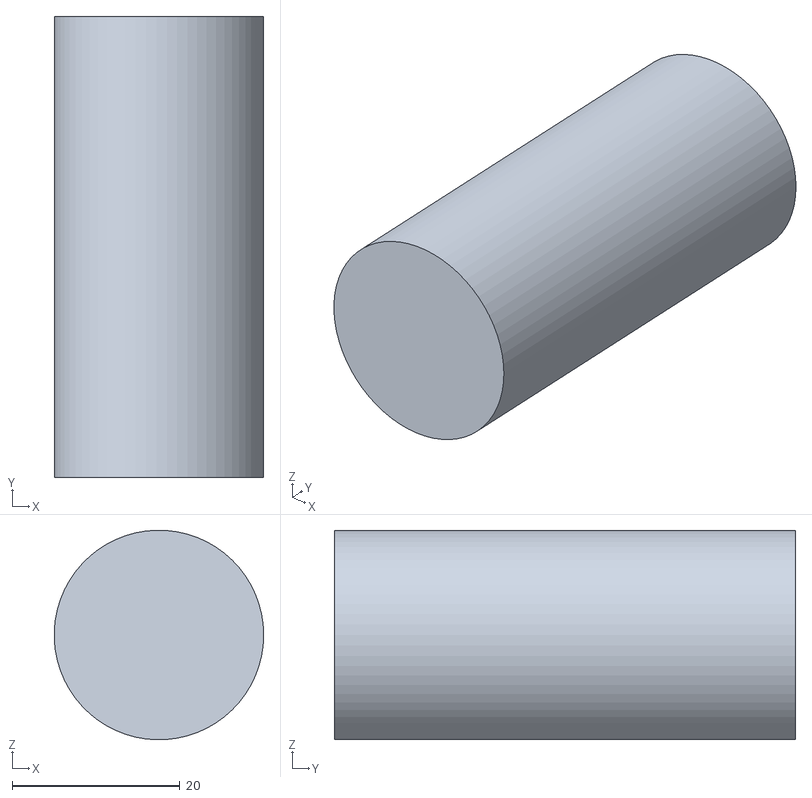
[picture p132: CAD file, 2026-11-07]
mechanical/gripper/cad/v22/6.3_GR_motor_DC25_pinza.stl
25.0 x 55.0 x 25.0
