Robotica76/2026_MakeX_Challengue/mechanical/gripper_elevation/cad/v22/5.17_MAS_costilla_frente_z150_CF3.stl

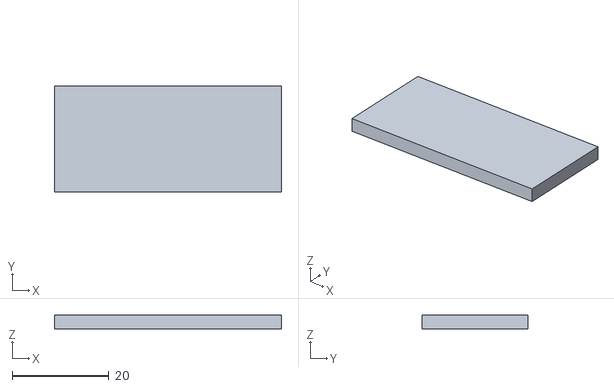
[picture p133: CAD file, 2026-11-07]
mechanical/gripper_elevation/cad/v22/5.17_MAS_costilla_frente_z150_CF3.stl
47.0 x 22.0 x 3.00
