Robotica76/2026_MakeX_Challengue/mechanical/shooter/cad/v22/7.9_SH_brushless_kit_antihorario.stl

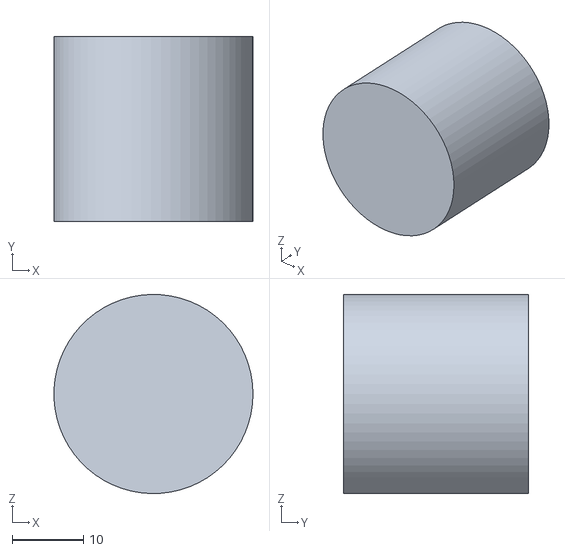
[picture p134: CAD file, 2026-11-07]
mechanical/shooter/cad/v22/7.9_SH_brushless_kit_antihorario.stl
28.0 x 26.0 x 28.0
