Robotica76/2026_MakeX_Challengue/mechanical/ball_intake/cad/v22/4.34_INT_R3_entrada_eje_D8.stl

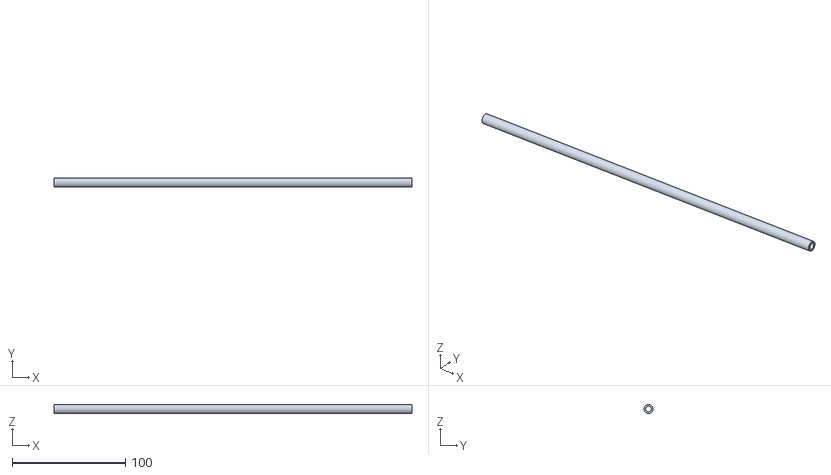
[picture p135: CAD file, 2026-11-07]
mechanical/ball_intake/cad/v22/4.34_INT_R3_entrada_eje_D8.stl
316.2 x 8.00 x 8.00
