Robotica76/2026_MakeX_Challengue/mechanical/ball_storage/cad/v22/8.1_CN_paredes_canasta_PC_1.stl

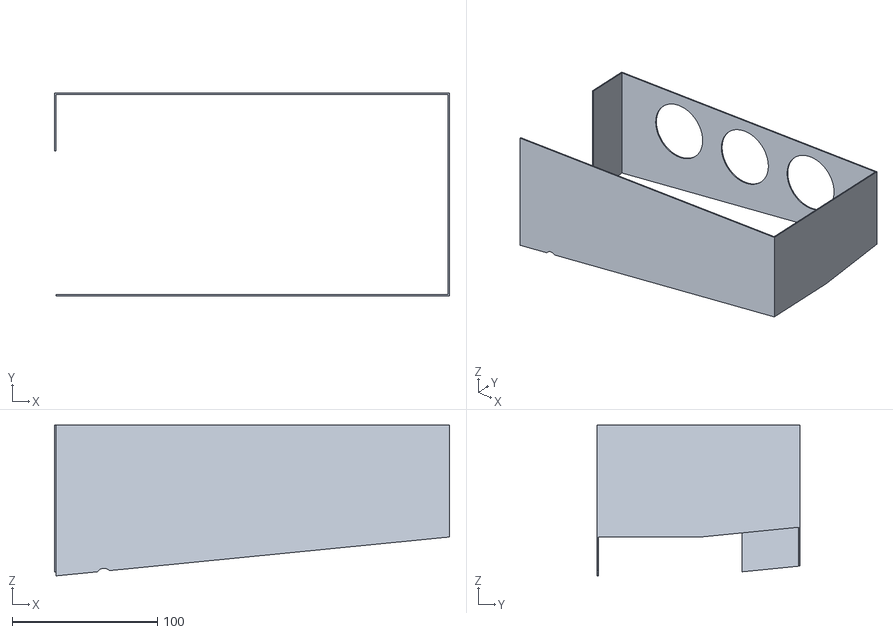
[picture p136: CAD file, 2026-11-07]
mechanical/ball_storage/cad/v22/8.1_CN_paredes_canasta_PC_1.stl
272.0 x 140.0 x 103.9
