Robotica76/2026_MakeX_Challengue/mechanical/chassis/cad/v22/1.33_CH_coupling_mecanum_80_del_izq.stl

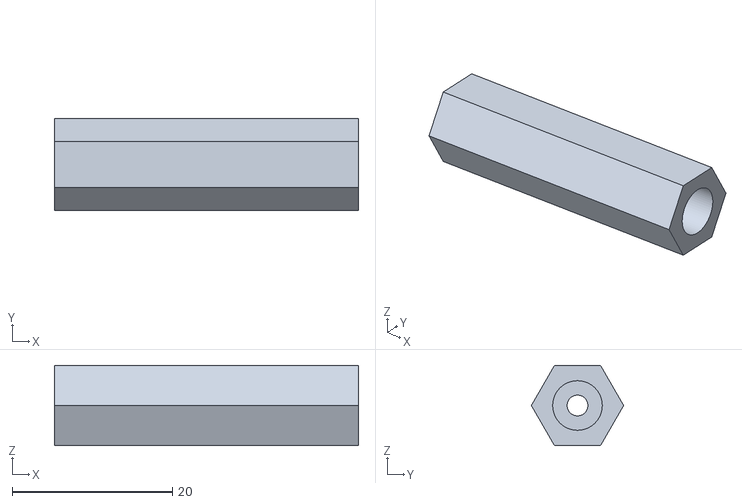
[picture p137: CAD file, 2026-11-07]
mechanical/chassis/cad/v22/1.33_CH_coupling_mecanum_80_del_izq.stl
38.0 x 11.5 x 10.0
