Robotica76/2026_MakeX_Challengue/mechanical/feeder/cad/v22/3.14_TW_ejes_D8_tubo_Al_x2.stl

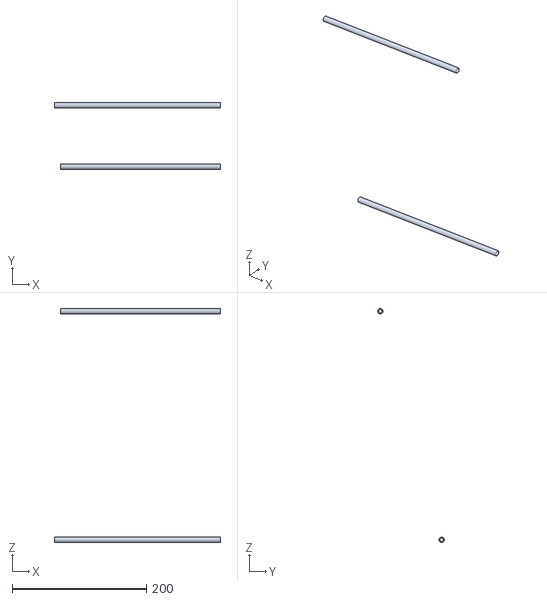
[picture p138: CAD file, 2026-11-07]
mechanical/feeder/cad/v22/3.14_TW_ejes_D8_tubo_Al_x2.stl
247.0 x 99.1 x 348.0
