Robotica76/2026_MakeX_Challengue/mechanical/gripper/cad/v22/6.4_GR_bloque_montaje_PETG.stl

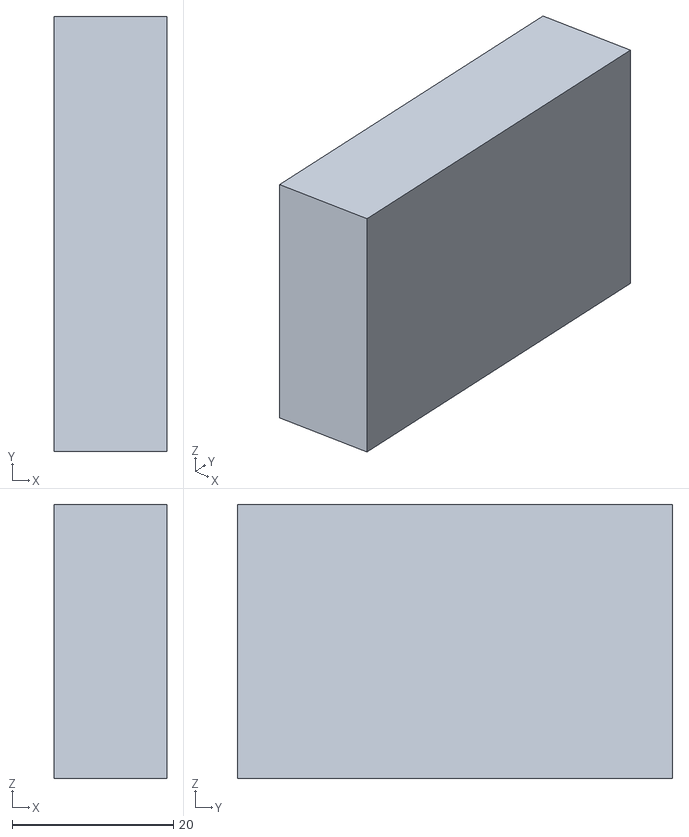
[picture p139: CAD file, 2026-11-07]
mechanical/gripper/cad/v22/6.4_GR_bloque_montaje_PETG.stl
14.0 x 54.0 x 34.0
