Robotica76/2026_MakeX_Challengue/mechanical/shooter/cad/v22/7.16_SH_brushless_motor_bracket_kit_x2.stl

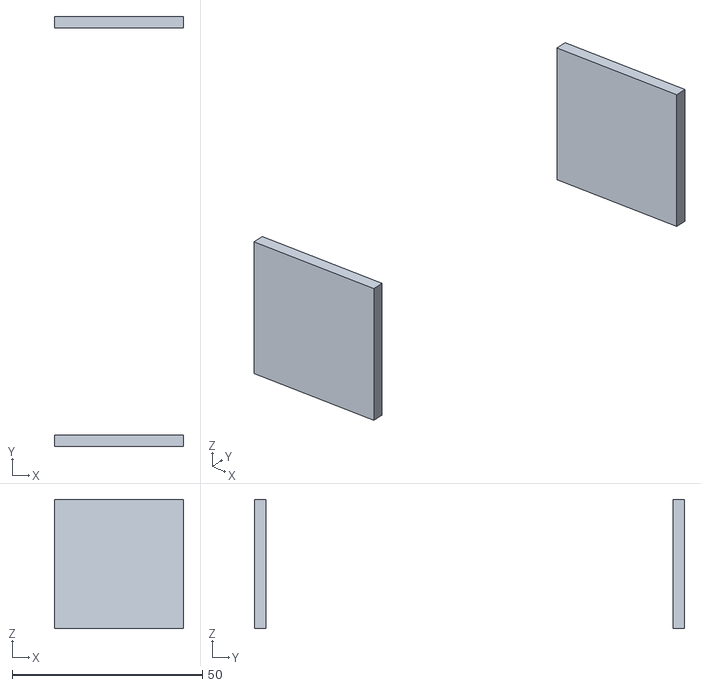
[picture p140: CAD file, 2026-11-07]
mechanical/shooter/cad/v22/7.16_SH_brushless_motor_bracket_kit_x2.stl
34.0 x 113.0 x 34.0
