Robotica76/2026_MakeX_Challengue/mechanical/ball_intake/cad/v22/4.26_INT_engrane_48T_kit_loco.stl

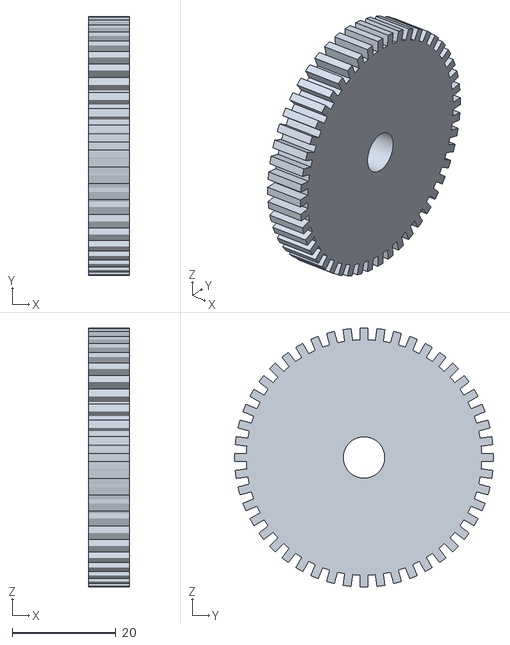
[picture p141: CAD file, 2026-11-07]
mechanical/ball_intake/cad/v22/4.26_INT_engrane_48T_kit_loco.stl
8.00 x 50.1 x 50.0
