Robotica76/2026_MakeX_Challengue/mechanical/ball_storage/cad/v22/8.3_CN_piso_canasta_PC_1_2.stl

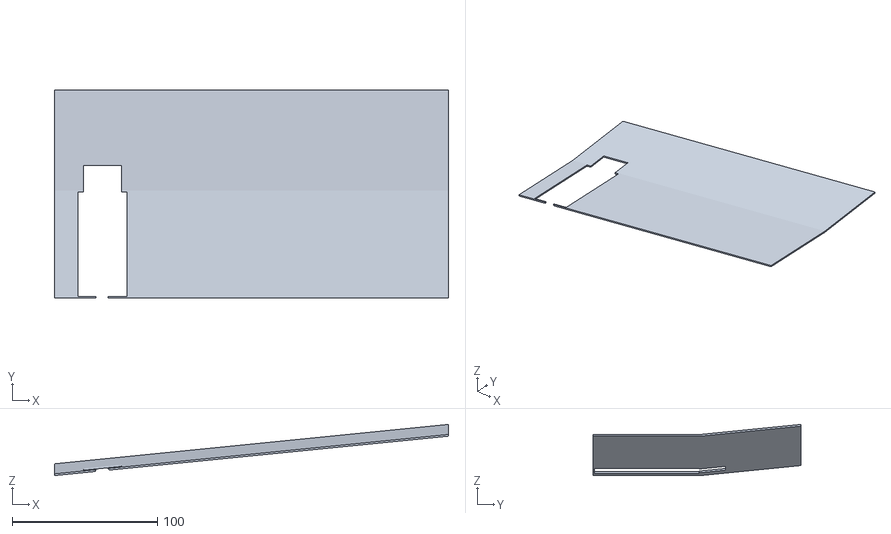
[picture p142: CAD file, 2026-11-07]
mechanical/ball_storage/cad/v22/8.3_CN_piso_canasta_PC_1_2.stl
271.0 x 143.0 x 35.2
