Robotica76/2026_MakeX_Challengue/mechanical/feeder/cad/v22/3.20_TW_engrane_16T_kit_eje.stl

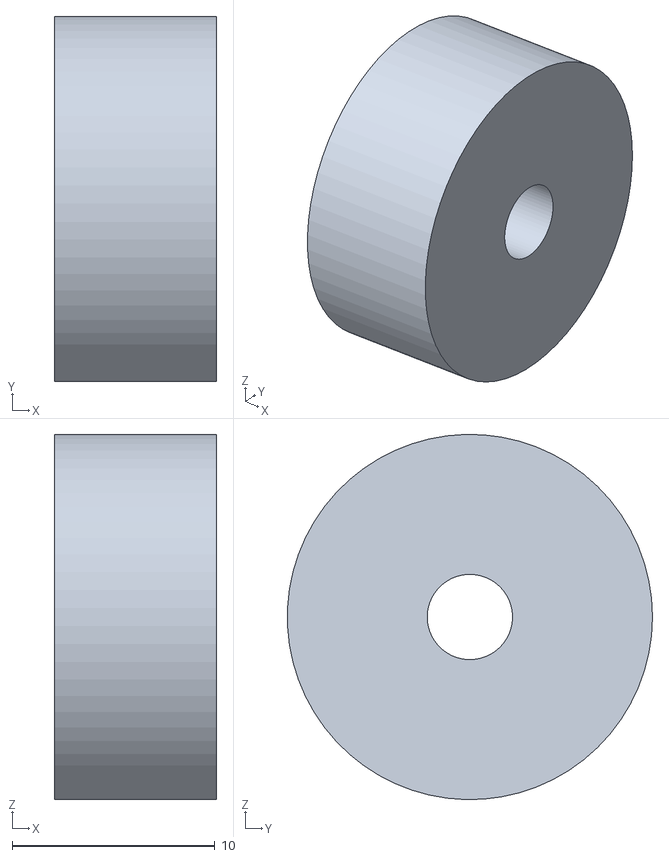
[picture p143: CAD file, 2026-11-07]
mechanical/feeder/cad/v22/3.20_TW_engrane_16T_kit_eje.stl
8.00 x 18.0 x 18.0
