Robotica76/2026_MakeX_Challengue/mechanical/gripper/cad/v22/6.15_GR_bloque_extremo_fijo_PETG.stl

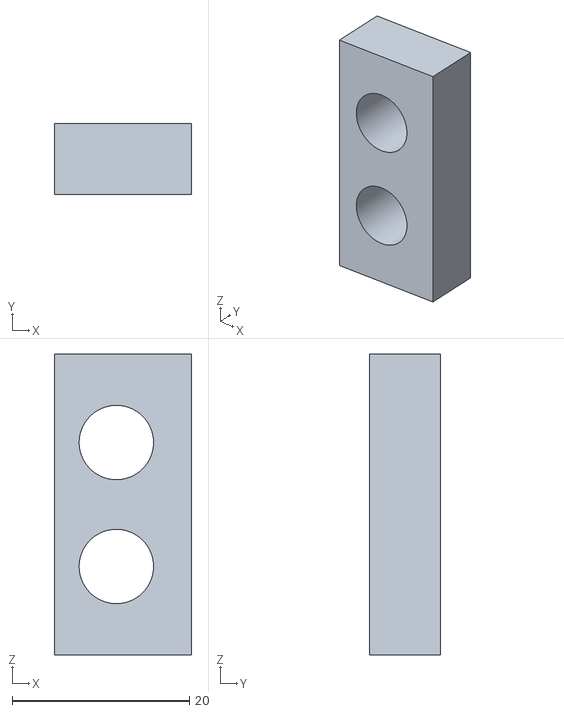
[picture p144: CAD file, 2026-11-07]
mechanical/gripper/cad/v22/6.15_GR_bloque_extremo_fijo_PETG.stl
15.5 x 8.00 x 34.0
