Robotica76/2026_MakeX_Challengue/mechanical/gripper_elevation/cad/v22/5.4_MAS_mamparo_interior_CF3.stl

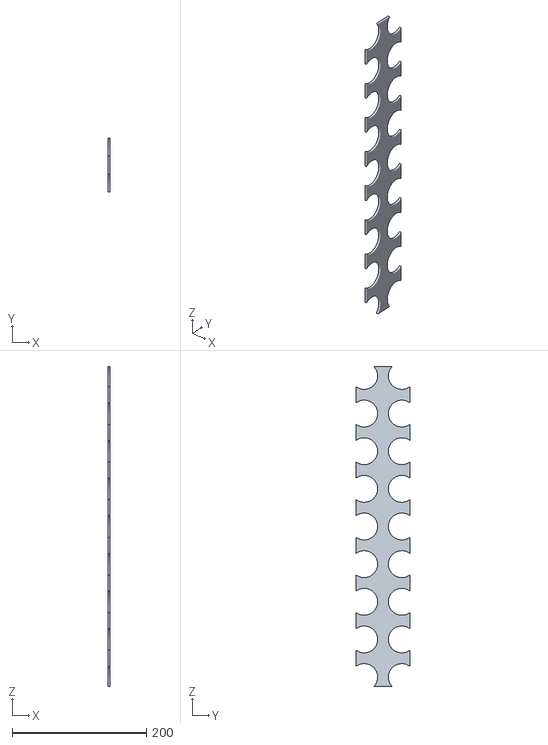
[picture p145: CAD file, 2026-11-07]
mechanical/gripper_elevation/cad/v22/5.4_MAS_mamparo_interior_CF3.stl
3.00 x 80.0 x 476.0
