Robotica76/2026_MakeX_Challengue/mechanical/shooter/cad/v22/7.7_SH_capucha_inferior_PC2mm_R82.stl

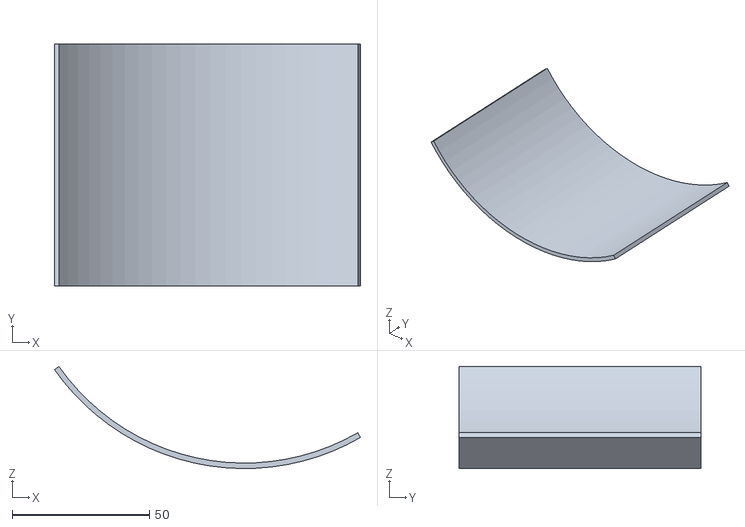
[picture p146: CAD file, 2026-11-07]
mechanical/shooter/cad/v22/7.7_SH_capucha_inferior_PC2mm_R82.stl
111.5 x 88.0 x 37.2
