Robotica76/2026_MakeX_Challengue/mechanical/ball_intake/cad/v22/4.1_INT_LR_manguito_TPU_D44.stl

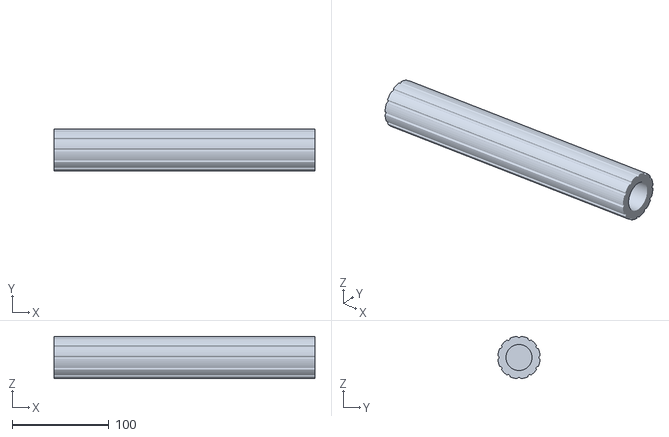
[picture p147: CAD file, 2026-11-07]
mechanical/ball_intake/cad/v22/4.1_INT_LR_manguito_TPU_D44.stl
270.0 x 43.9 x 43.9
