Robotica76/2026_MakeX_Challengue/mechanical/chassis/cad/v22/1.2_CH_travesanos_square_beam_2424_312_x3.stl

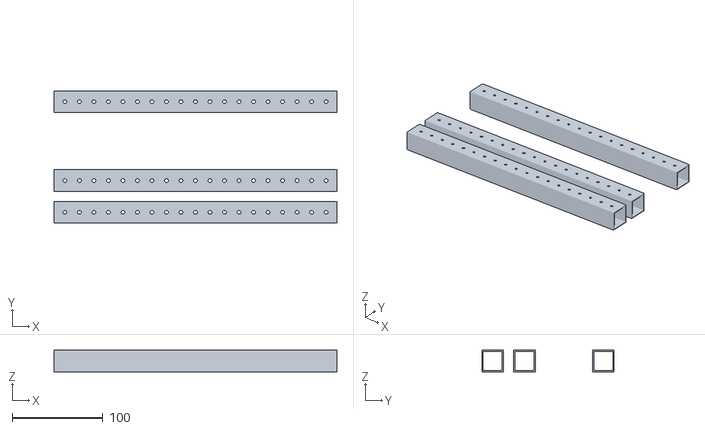
[picture p148: CAD file, 2026-11-07]
mechanical/chassis/cad/v22/1.2_CH_travesanos_square_beam_2424_312_x3.stl
312.0 x 146.0 x 24.0
