Robotica76/2026_MakeX_Challengue/mechanical/feeder/cad/v22/3.21_TW_eje_loco.stl

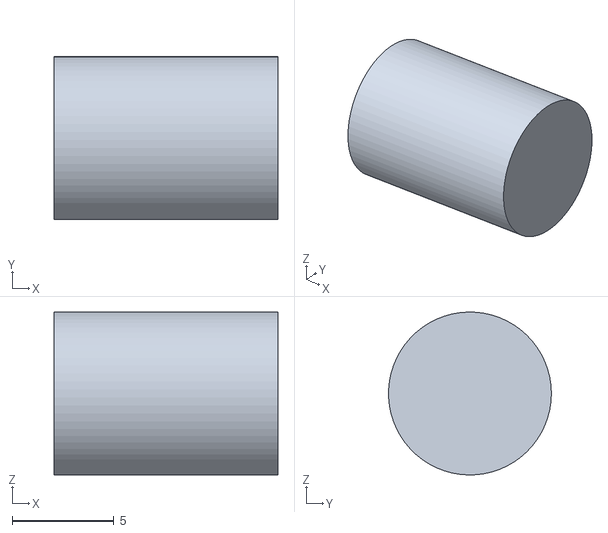
[picture p149: CAD file, 2026-11-07]
mechanical/feeder/cad/v22/3.21_TW_eje_loco.stl
11.0 x 8.00 x 8.00
