Robotica76/2026_MakeX_Challengue/mechanical/gripper/cad/v22/6.8_GR_mordaza_movil_Al3.stl

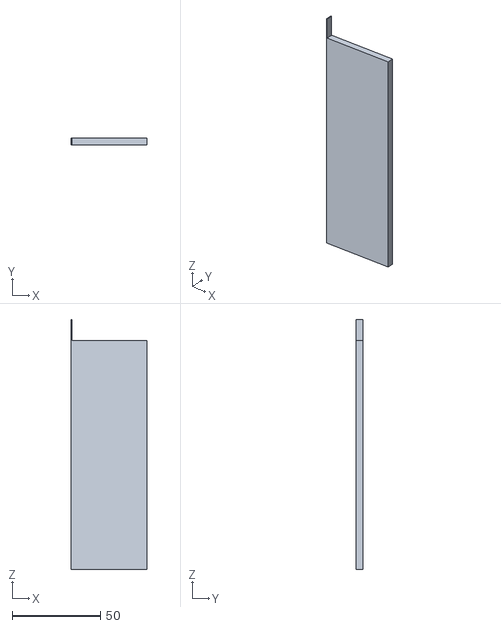
[picture p150: CAD file, 2026-11-07]
mechanical/gripper/cad/v22/6.8_GR_mordaza_movil_Al3.stl
43.0 x 4.00 x 142.0
