Robotica76/2026_MakeX_Challengue/mechanical/gripper_elevation/cad/v22/5.21_MAS_costilla_banda_z300_CF3.stl

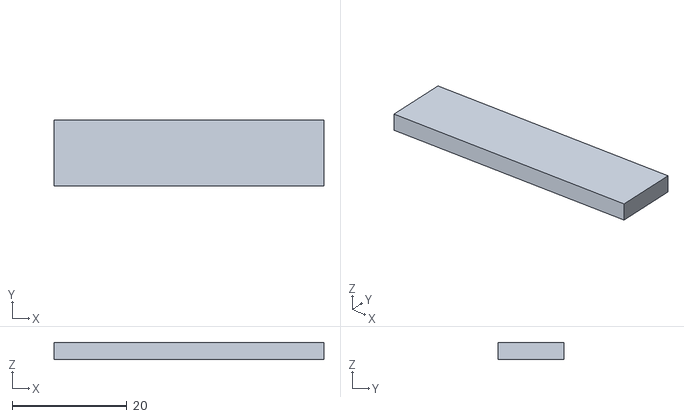
[picture p151: CAD file, 2026-11-07]
mechanical/gripper_elevation/cad/v22/5.21_MAS_costilla_banda_z300_CF3.stl
47.0 x 11.5 x 3.00
