Robotica76/2026_MakeX_Challengue/mechanical/shooter/cad/v22/7.14_SH_friction_wheel_ring_D28x7_kit_x2.stl

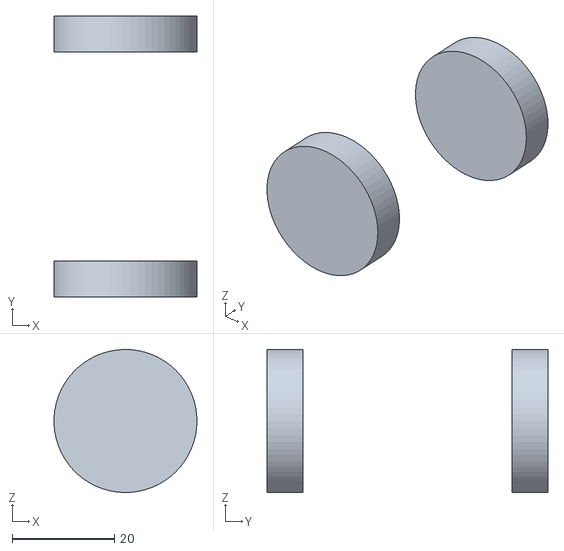
[picture p152: CAD file, 2026-11-07]
mechanical/shooter/cad/v22/7.14_SH_friction_wheel_ring_D28x7_kit_x2.stl
28.0 x 55.0 x 28.0
