Robotica76/2026_MakeX_Challengue/mechanical/ball_intake/cad/v22/4.31_INT_UR_patin_impreso_2020_izq_PETG.stl

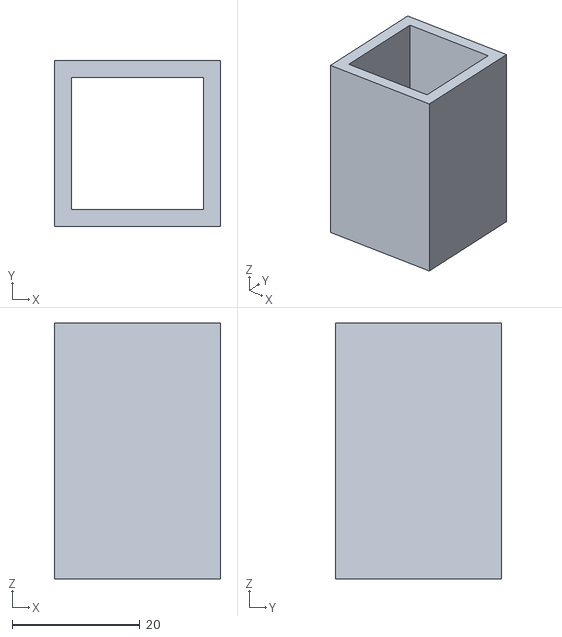
[picture p153: CAD file, 2026-11-07]
mechanical/ball_intake/cad/v22/4.31_INT_UR_patin_impreso_2020_izq_PETG.stl
26.0 x 26.0 x 40.0
