Robotica76/2026_MakeX_Challengue/mechanical/feeder/cad/v22/3.11_TW_motor_DC25_interno_codo.stl

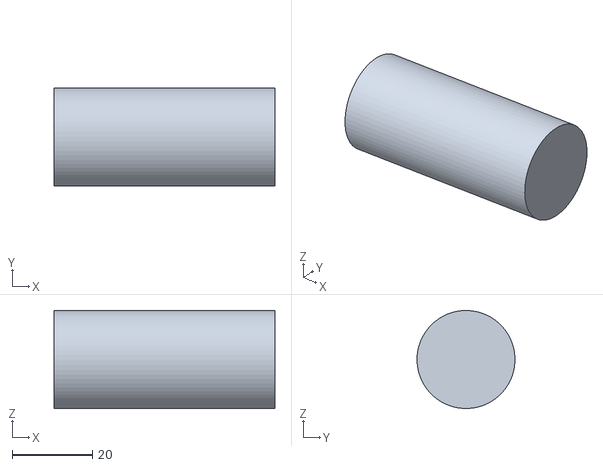
[picture p154: CAD file, 2026-11-07]
mechanical/feeder/cad/v22/3.11_TW_motor_DC25_interno_codo.stl
55.0 x 24.4 x 24.4
