Robotica76/2026_MakeX_Challengue/mechanical/gripper/cad/v22/6.9_GR_tabla_marco_CF3.stl

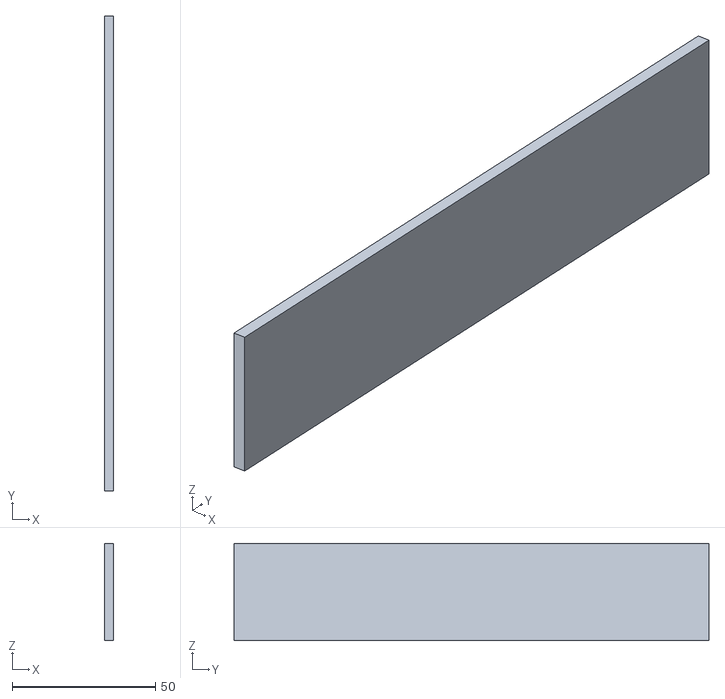
[picture p155: CAD file, 2026-11-07]
mechanical/gripper/cad/v22/6.9_GR_tabla_marco_CF3.stl
3.00 x 166.0 x 34.0
