Robotica76/2026_MakeX_Challengue/mechanical/shooter/cad/v22/7.5_RIG_postes_lanzador_tubo_CF_16_x2.stl

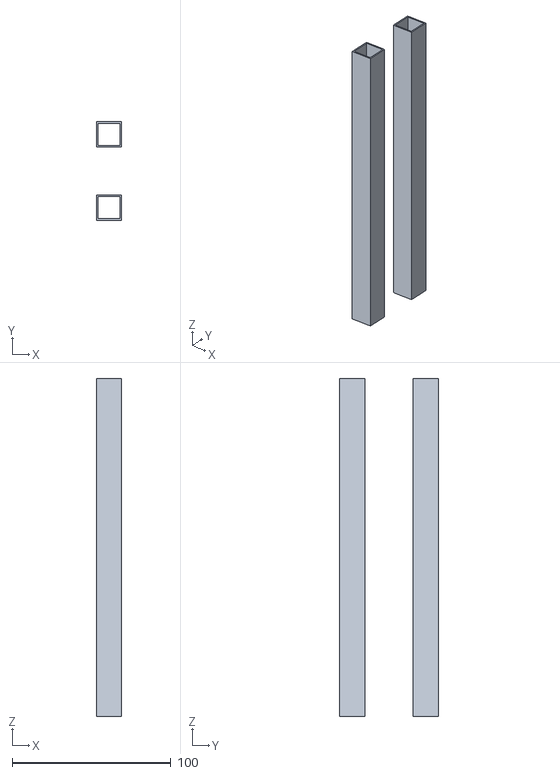
[picture p156: CAD file, 2026-11-07]
mechanical/shooter/cad/v22/7.5_RIG_postes_lanzador_tubo_CF_16_x2.stl
16.0 x 62.0 x 212.7
