Robotica76/2026_MakeX_Challengue/mechanical/chassis/cad/v22/1.3_CH_mecanum_80_R_del_der_llanta.stl

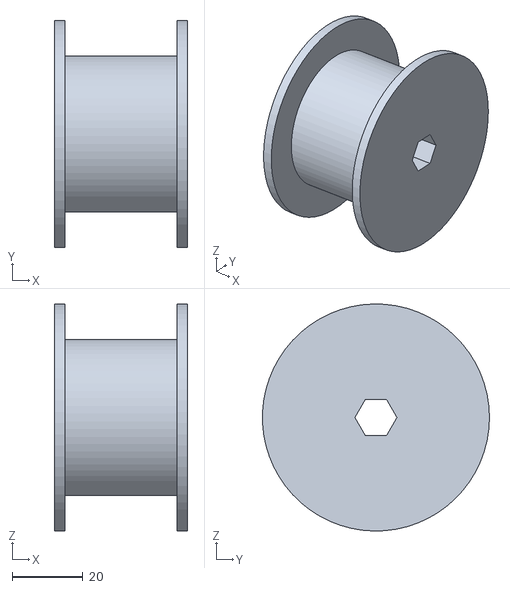
[picture p157: CAD file, 2026-11-07]
mechanical/chassis/cad/v22/1.3_CH_mecanum_80_R_del_der_llanta.stl
37.5 x 64.0 x 64.0
