Robotica76/2026_MakeX_Challengue/mechanical/feeder/cad/v22/3.19_TW_topes_aleta_PETG.stl

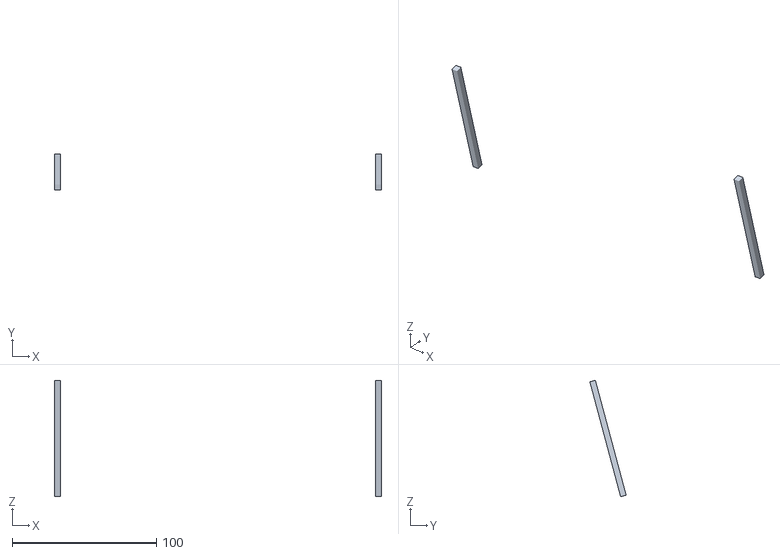
[picture p158: CAD file, 2026-11-07]
mechanical/feeder/cad/v22/3.19_TW_topes_aleta_PETG.stl
227.0 x 25.2 x 80.8
