Robotica76/2026_MakeX_Challengue/mechanical/gripper/cad/v22/6.12_GR_carro_tuerca_PETG.stl

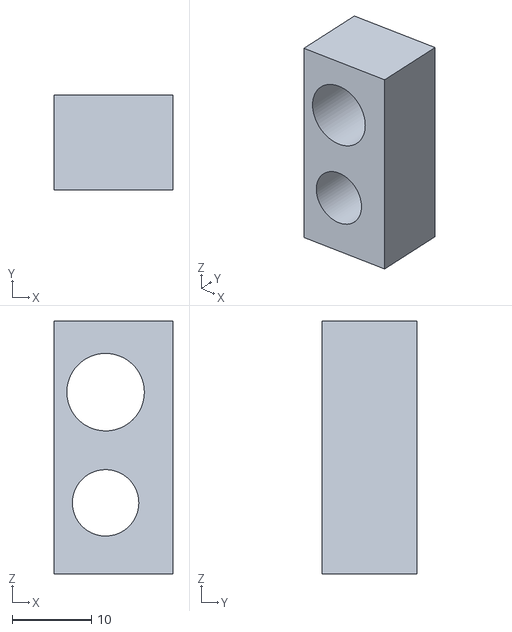
[picture p159: CAD file, 2026-11-07]
mechanical/gripper/cad/v22/6.12_GR_carro_tuerca_PETG.stl
15.0 x 12.0 x 32.0
