Robotica76/2026_MakeX_Challengue/mechanical/gripper_elevation/cad/v22/5.15_ELV_banda_dentada_kit.stl

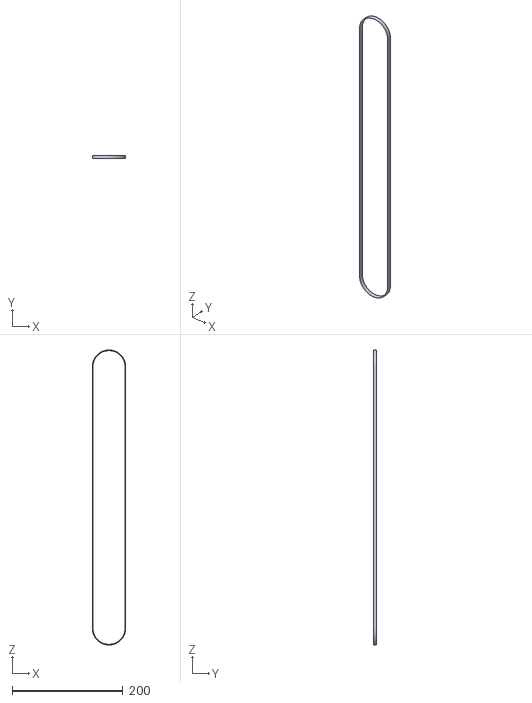
[picture p160: CAD file, 2026-11-07]
mechanical/gripper_elevation/cad/v22/5.15_ELV_banda_dentada_kit.stl
60.2 x 6.00 x 532.2
