Robotica76/2026_MakeX_Challengue/mechanical/ball_intake/cad/v22/4.4_INT_R3_entrada_nucleo.stl

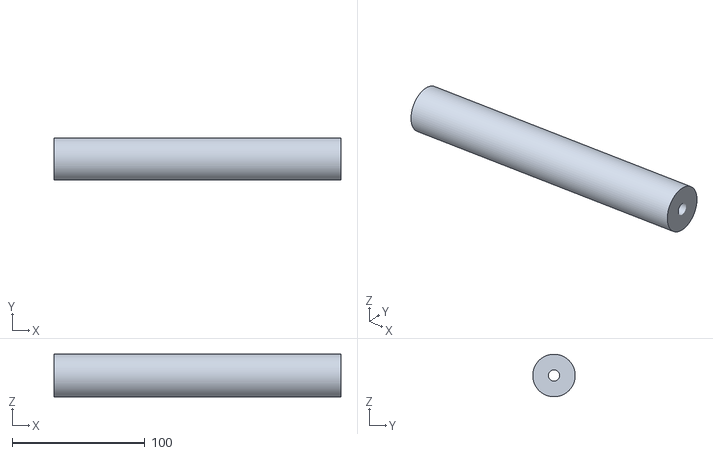
[picture p161: CAD file, 2026-11-07]
mechanical/ball_intake/cad/v22/4.4_INT_R3_entrada_nucleo.stl
216.0 x 32.0 x 32.0
