Robotica76/2026_MakeX_Challengue/mechanical/chassis/cad/v22/1.10_CH_slide_beam_496_der.stl

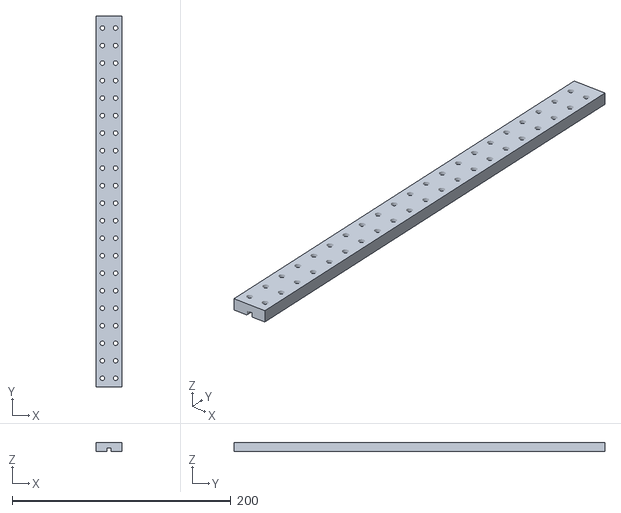
[picture p162: CAD file, 2026-11-07]
mechanical/chassis/cad/v22/1.10_CH_slide_beam_496_der.stl
24.0 x 339.0 x 8.00
