Robotica76/2026_MakeX_Challengue/mechanical/feeder/cad/v22/3.10_TW_aleta_antirretorno_TPU_1_5.stl

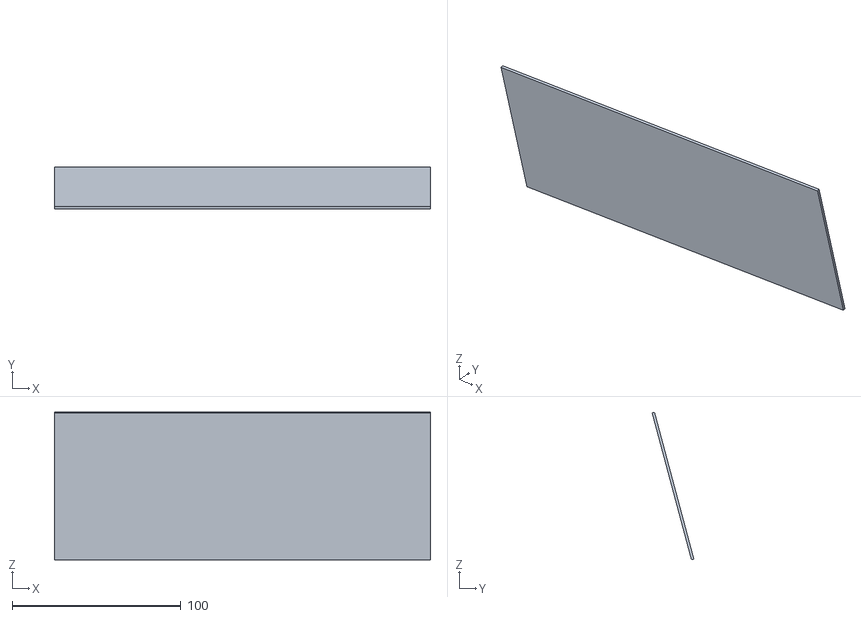
[picture p163: CAD file, 2026-11-07]
mechanical/feeder/cad/v22/3.10_TW_aleta_antirretorno_TPU_1_5.stl
223.0 x 24.8 x 87.5
