Robotica76/2026_MakeX_Challengue/mechanical/gripper/cad/v22/6.13_CAR_belt_connector_kit.stl

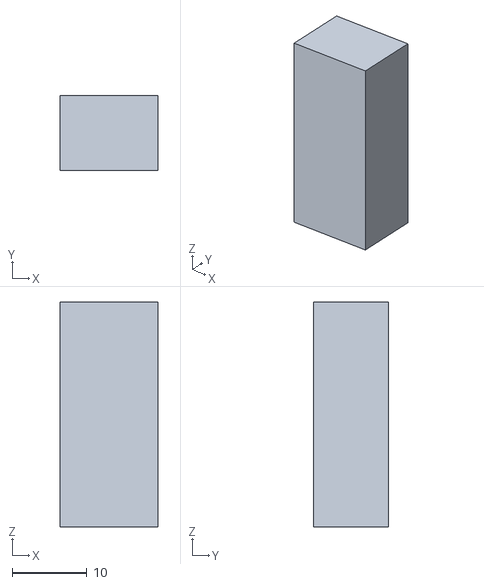
[picture p164: CAD file, 2026-11-07]
mechanical/gripper/cad/v22/6.13_CAR_belt_connector_kit.stl
13.1 x 10.0 x 30.0
