Robotica76/2026_MakeX_Challengue/mechanical/shooter/cad/v22/7.13_SH_capucha_grip_TPU.stl

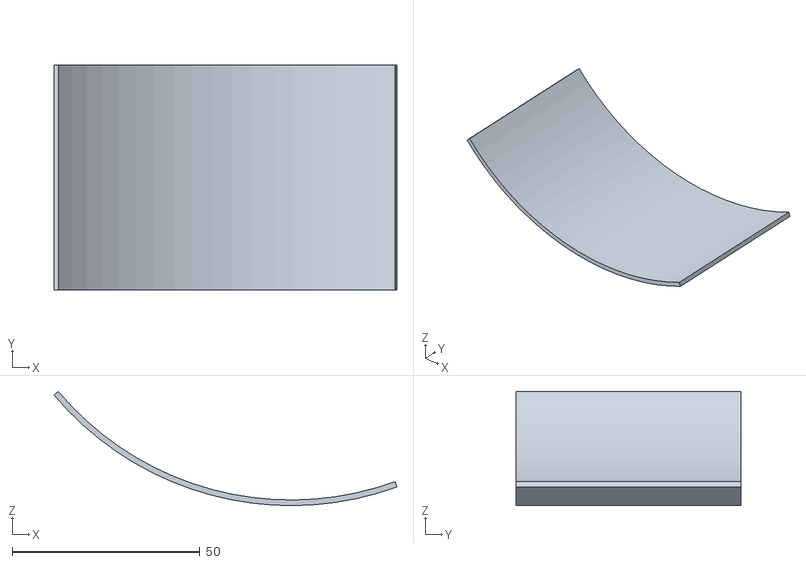
[picture p166: CAD file, 2026-11-07]
mechanical/shooter/cad/v22/7.13_SH_capucha_grip_TPU.stl
91.4 x 60.0 x 30.4
