Robotica76/2026_MakeX_Challengue/mechanical/ball_intake/cad/v22/4.37_INT_soporte_DC37_kit_intake.stl

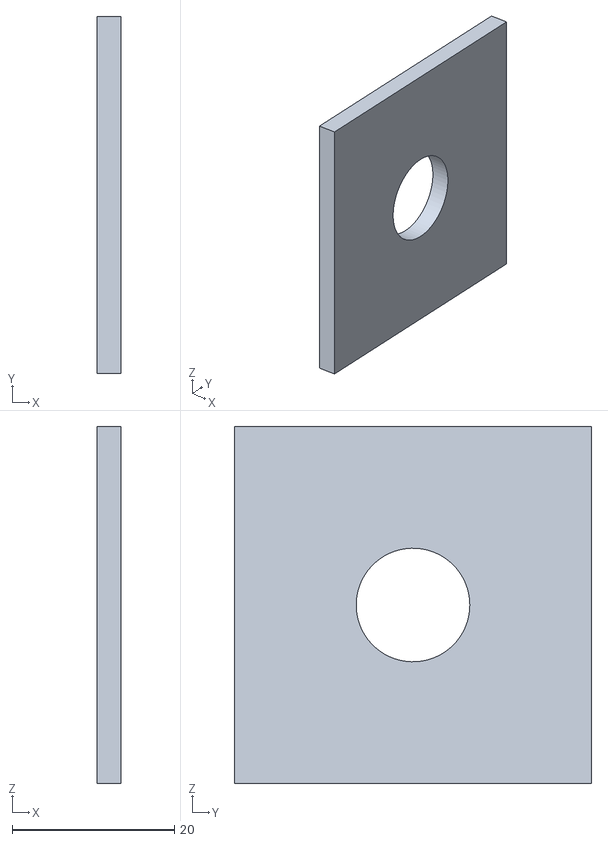
[picture p167: CAD file, 2026-11-07]
mechanical/ball_intake/cad/v22/4.37_INT_soporte_DC37_kit_intake.stl
3.00 x 44.0 x 44.0
