Robotica76/2026_MakeX_Challengue/mechanical/chassis/cad/v22/1.12_CH_mecanum_80_R_del_der_rodillos.stl

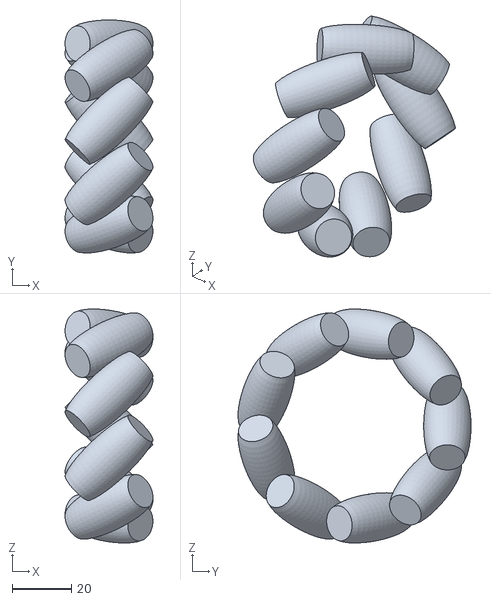
[picture p168: CAD file, 2026-11-07]
mechanical/chassis/cad/v22/1.12_CH_mecanum_80_R_del_der_rodillos.stl
29.7 x 78.7 x 79.0
