Robotica76/2026_MakeX_Challengue/mechanical/feeder/cad/v22/3.16_TW_soporte_DC37_kit.stl

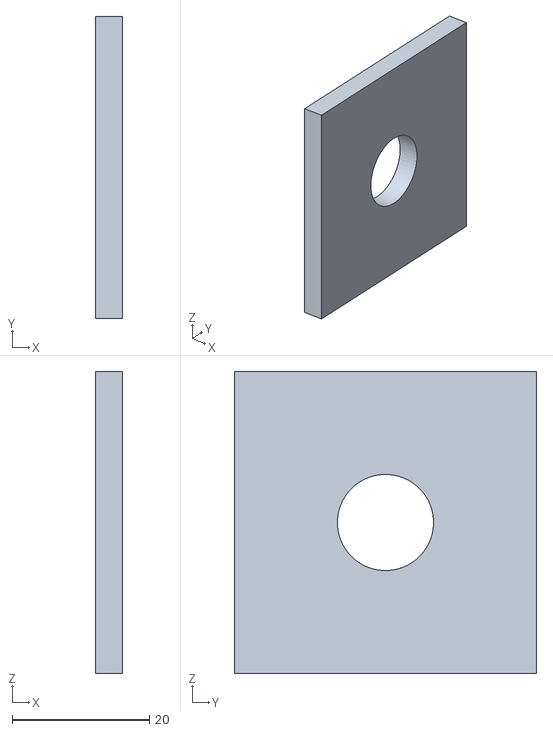
[picture p169: CAD file, 2026-11-07]
mechanical/feeder/cad/v22/3.16_TW_soporte_DC37_kit.stl
4.00 x 44.0 x 44.0
