Robotica76/2026_MakeX_Challengue/mechanical/gripper/cad/v22/6.10_GR_tornillo_avance_T8x8.stl

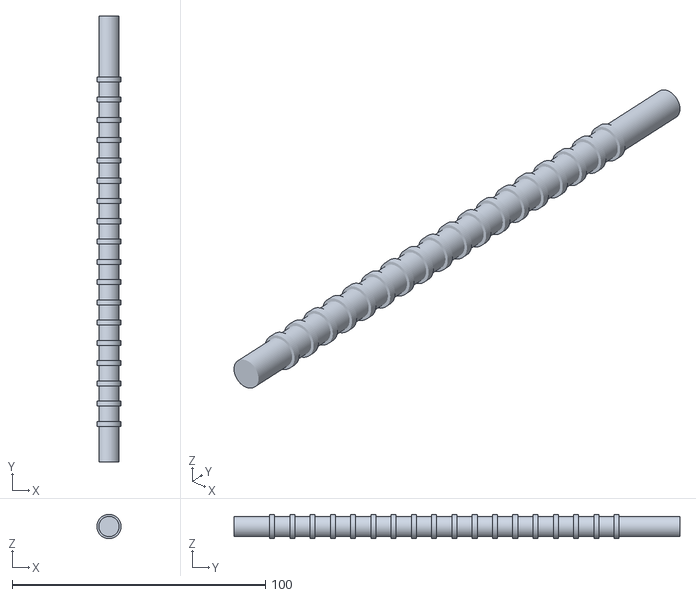
[picture p170: CAD file, 2026-11-07]
mechanical/gripper/cad/v22/6.10_GR_tornillo_avance_T8x8.stl
9.59 x 176.0 x 9.60
