Robotica76/2026_MakeX_Challengue/mechanical/gripper_elevation/cad/v22/5.9_ELV_polea_90T_kit_loca.stl

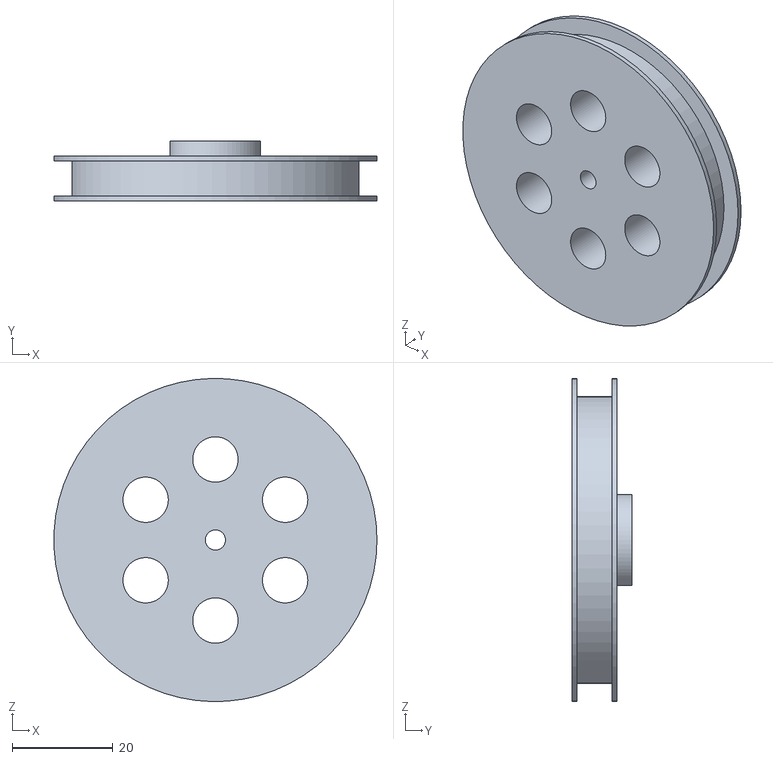
[picture p171: CAD file, 2026-11-07]
mechanical/gripper_elevation/cad/v22/5.9_ELV_polea_90T_kit_loca.stl
64.2 x 12.0 x 64.2
