Robotica76/2026_MakeX_Challengue/mechanical/shooter/cad/v22/7.6_SH_separadores_Al_D8_x4.stl

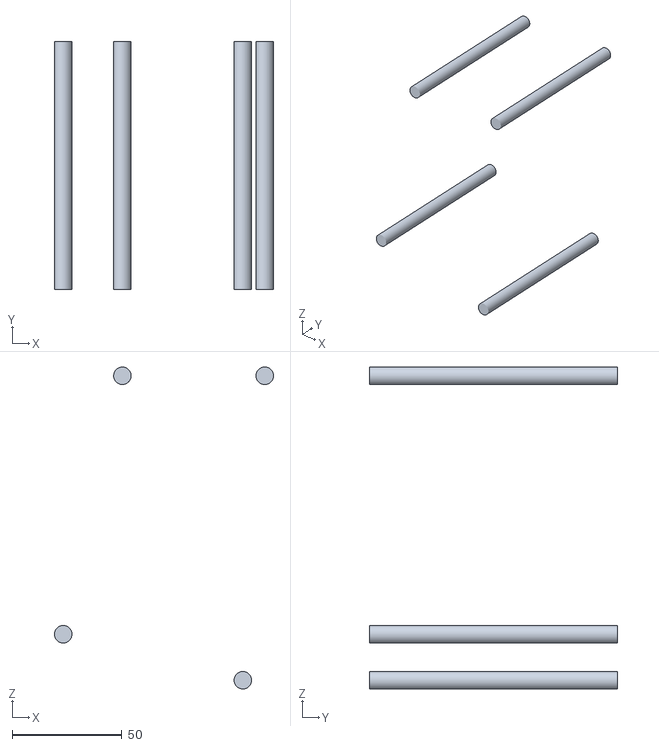
[picture p172: CAD file, 2026-11-07]
mechanical/shooter/cad/v22/7.6_SH_separadores_Al_D8_x4.stl
100.0 x 113.0 x 147.0
