Robotica76/2026_MakeX_Challengue/mechanical/ball_intake/cad/v22/4.42_INT_UR_tuerca_brazo_PETG.stl

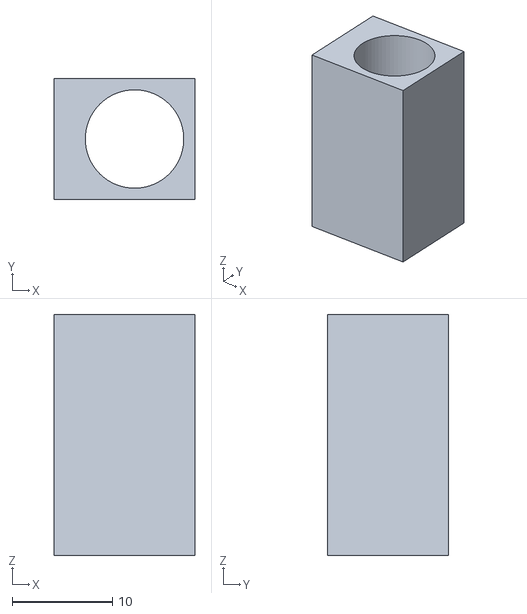
[picture p173: CAD file, 2026-11-07]
mechanical/ball_intake/cad/v22/4.42_INT_UR_tuerca_brazo_PETG.stl
14.0 x 12.0 x 24.0
