Robotica76/2026_MakeX_Challengue/mechanical/chassis/cad/v22/1.26_CH_motor_180_encoder_del_izq_lata.stl

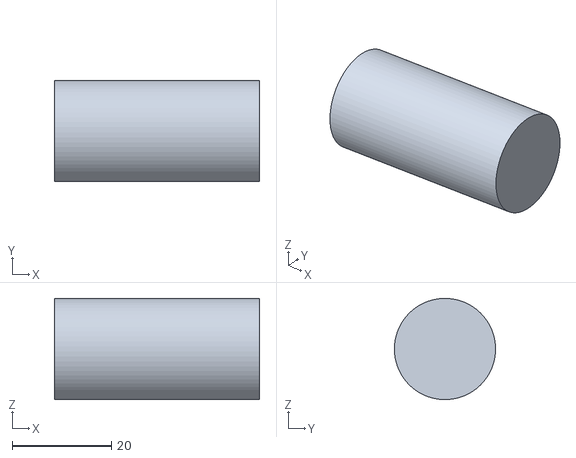
[picture p174: CAD file, 2026-11-07]
mechanical/chassis/cad/v22/1.26_CH_motor_180_encoder_del_izq_lata.stl
41.3 x 20.4 x 20.4
