Robotica76/2026_MakeX_Challengue/mechanical/feeder/cad/v22/3.6_TW_rodillo_codo_manga_PETG_TPU_D40.stl

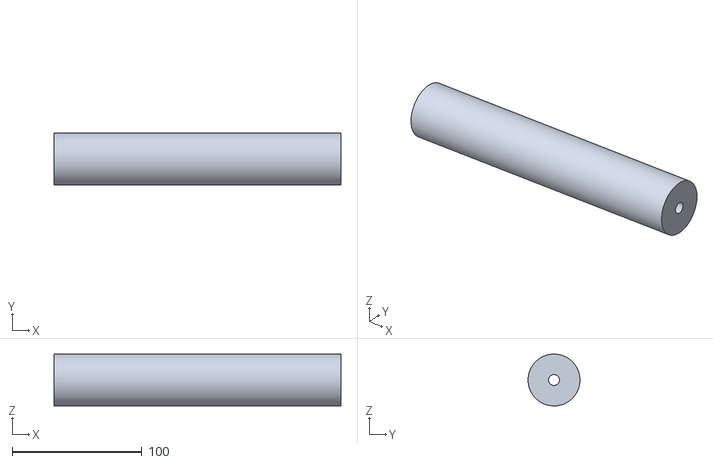
[picture p175: CAD file, 2026-11-07]
mechanical/feeder/cad/v22/3.6_TW_rodillo_codo_manga_PETG_TPU_D40.stl
221.0 x 40.0 x 40.0
