Robotica76/2026_MakeX_Challengue/mechanical/shooter/cad/v22/7.2_SH_placa_lateral_CF3_der.stl

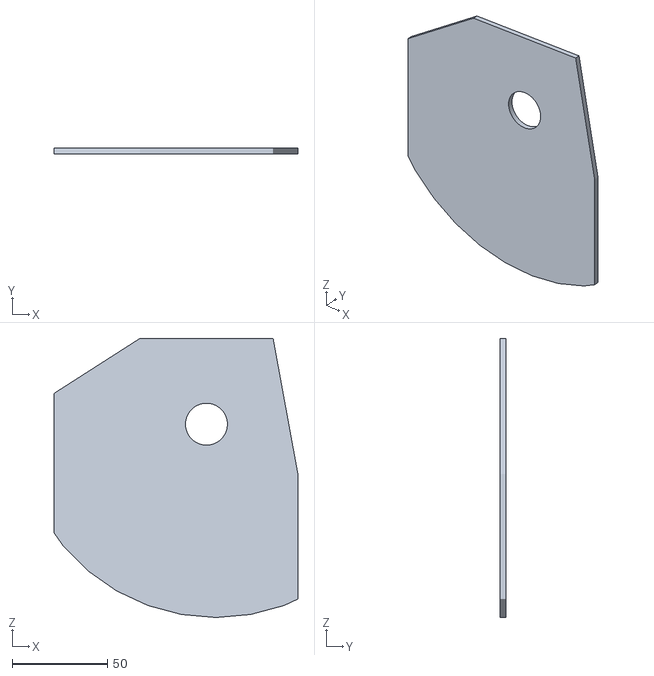
[picture p176: CAD file, 2026-11-07]
mechanical/shooter/cad/v22/7.2_SH_placa_lateral_CF3_der.stl
128.0 x 3.00 x 146.5
