Robotica76/2026_MakeX_Challengue/mechanical/ball_intake/cad/v22/4.54_INT_LR_buje_PETG.stl

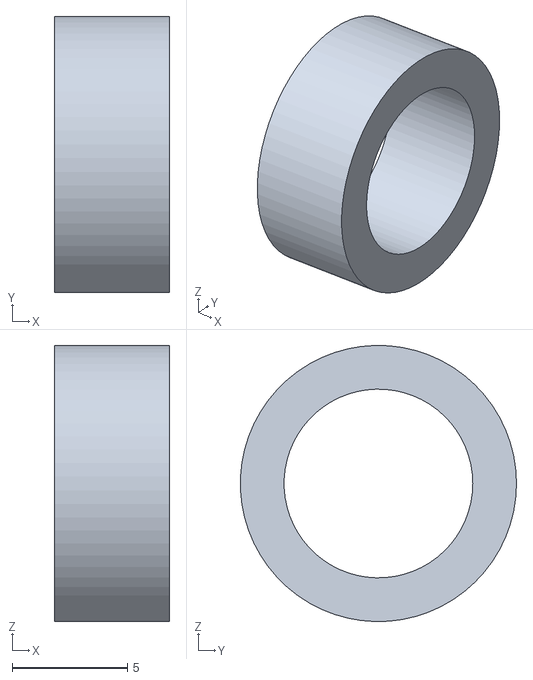
[picture p177: CAD file, 2026-11-07]
mechanical/ball_intake/cad/v22/4.54_INT_LR_buje_PETG.stl
5.00 x 12.0 x 12.0
