Robotica76/2026_MakeX_Challengue/mechanical/gripper/cad/v22/6.14_GR_sensor_distancia_kit.stl

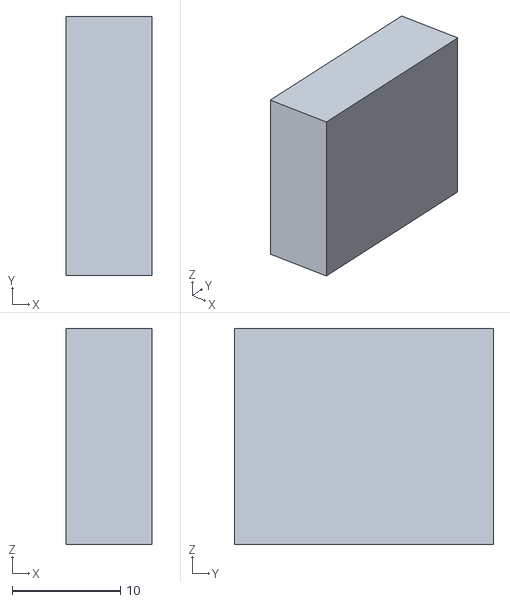
[picture p178: CAD file, 2026-11-07]
mechanical/gripper/cad/v22/6.14_GR_sensor_distancia_kit.stl
8.00 x 24.0 x 20.0
