Robotica76/2026_MakeX_Challengue/mechanical/gripper_elevation/cad/v22/5.3_MAS_placa_trasera_CF3.stl

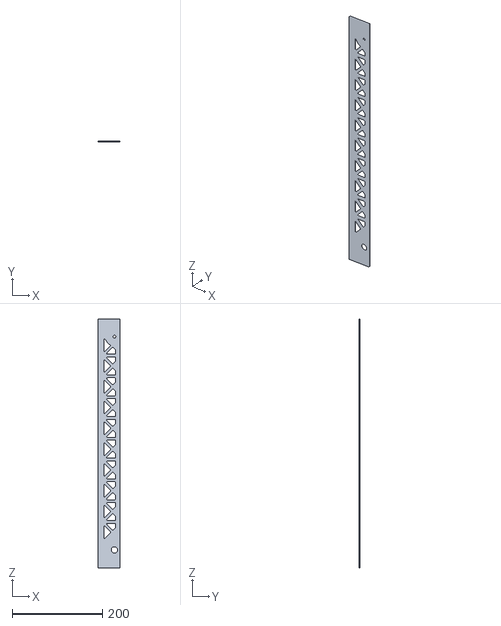
[picture p179: CAD file, 2026-11-07]
mechanical/gripper_elevation/cad/v22/5.3_MAS_placa_trasera_CF3.stl
49.0 x 3.00 x 551.0
