Robotica76/2026_MakeX_Challengue/mechanical/shooter/cad/v22/7.1_SH_friction_wheel_D45x19_5_kit_x2.stl

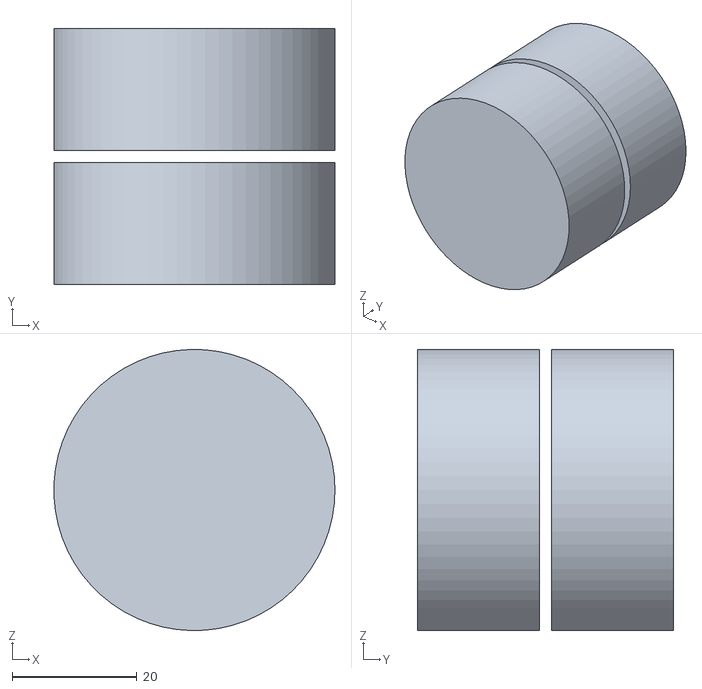
[picture p180: CAD file, 2026-11-07]
mechanical/shooter/cad/v22/7.1_SH_friction_wheel_D45x19_5_kit_x2.stl
45.0 x 41.0 x 45.0
