Robotica76/2026_MakeX_Challengue/mechanical/ball_intake/cad/v22/4.49_INT_tobogan_paredes_PC_2mm.stl

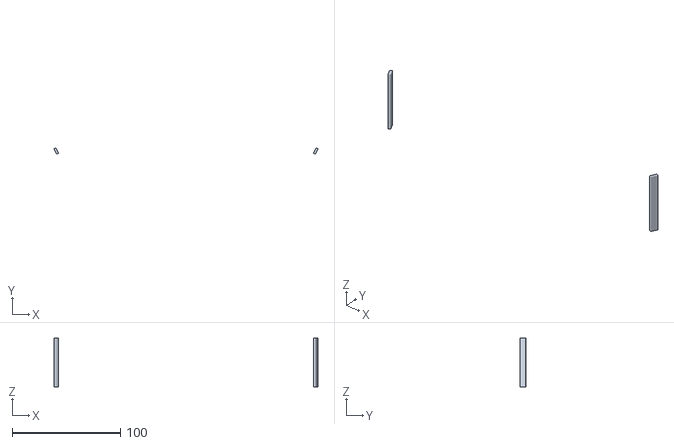
[picture p181: CAD file, 2026-11-07]
mechanical/ball_intake/cad/v22/4.49_INT_tobogan_paredes_PC_2mm.stl
243.6 x 5.89 x 45.0
