Robotica76/2026_MakeX_Challengue/mechanical/chassis/cad/v22/2.2_ELEC_NovaPi_con_case.stl

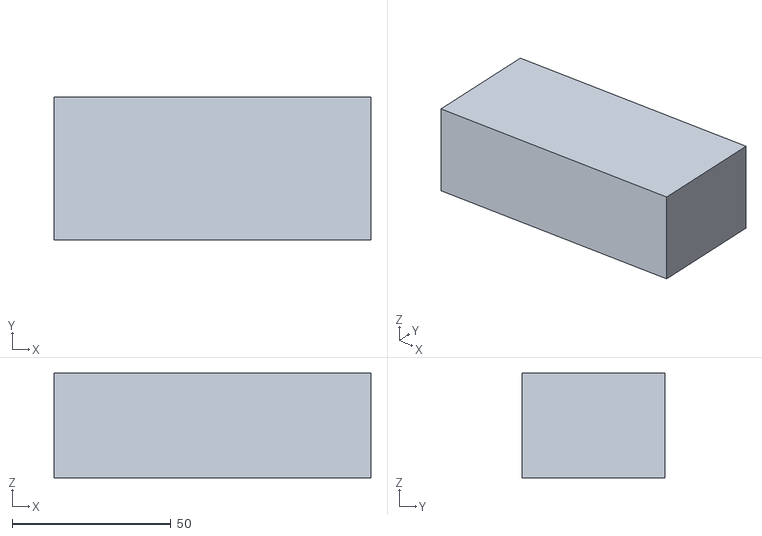
[picture p182: CAD file, 2026-11-07]
mechanical/chassis/cad/v22/2.2_ELEC_NovaPi_con_case.stl
100.0 x 45.0 x 33.0
