Robotica76/2026_MakeX_Challengue/mechanical/feeder/cad/v22/3.12_TW_engrane_48T_kit_motor.stl

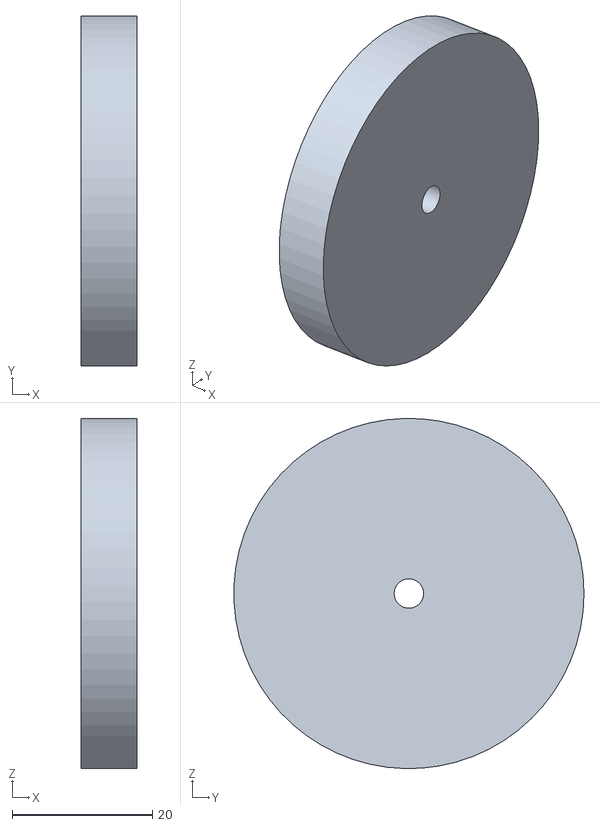
[picture p183: CAD file, 2026-11-07]
mechanical/feeder/cad/v22/3.12_TW_engrane_48T_kit_motor.stl
8.00 x 50.0 x 50.0
