Robotica76/2026_MakeX_Challengue/mechanical/gripper/cad/v22/6.1_CAR_linear_motion_slide_unit_kit_x2.stl

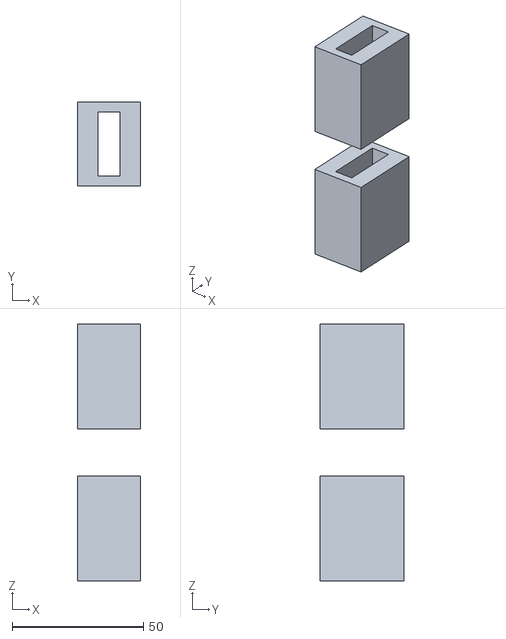
[picture p184: CAD file, 2026-11-07]
mechanical/gripper/cad/v22/6.1_CAR_linear_motion_slide_unit_kit_x2.stl
24.0 x 32.0 x 98.0
