Robotica76/2026_MakeX_Challengue/mechanical/gripper_elevation/cad/v22/5.23_ELV_eje_loca_D4_kit.stl

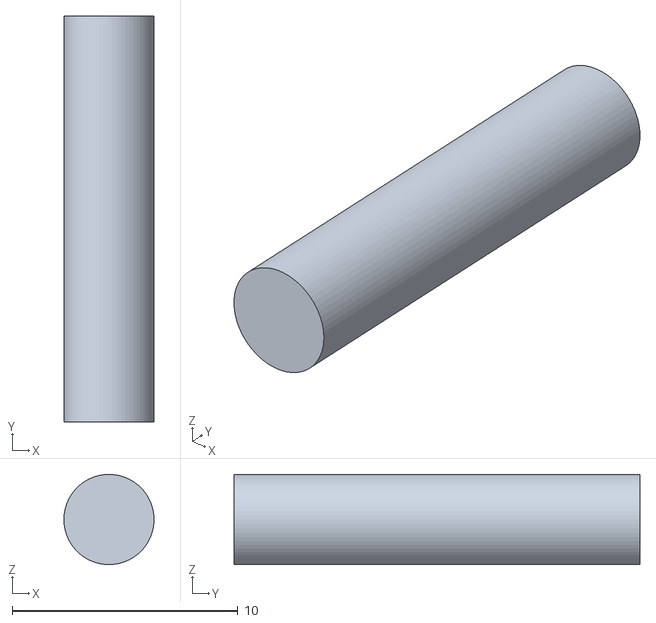
[picture p185: CAD file, 2026-11-07]
mechanical/gripper_elevation/cad/v22/5.23_ELV_eje_loca_D4_kit.stl
4.00 x 18.0 x 4.00
