Robotica76/2026_MakeX_Challengue/mechanical/chassis/cad/v22/1.42_CH_motor_180_encoder_del_izq_eje_salida.stl

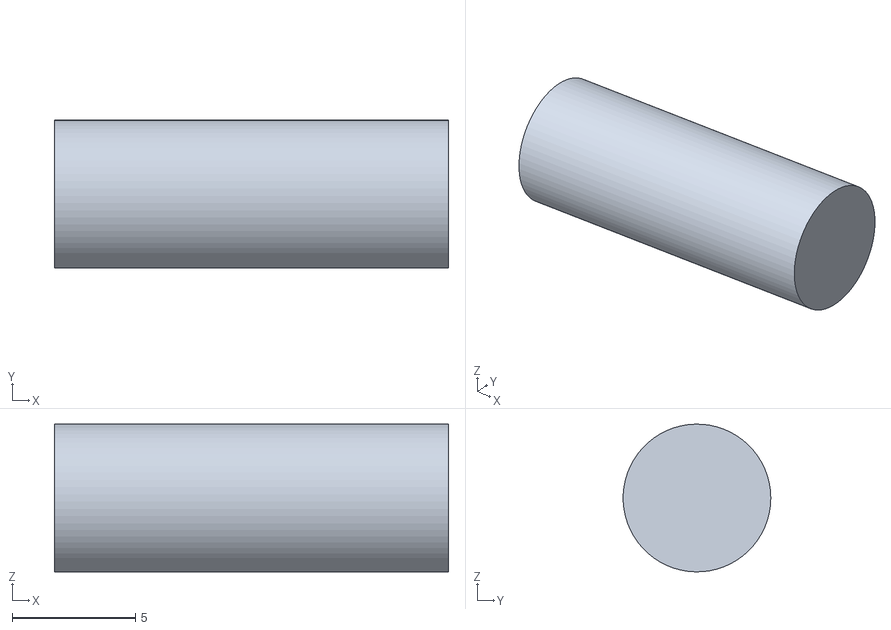
[picture p186: CAD file, 2026-11-07]
mechanical/chassis/cad/v22/1.42_CH_motor_180_encoder_del_izq_eje_salida.stl
16.0 x 6.00 x 6.00
