Robotica76/2026_MakeX_Challengue/mechanical/shooter/cad/v22/7.15_SH_guarda_superior_PC.stl

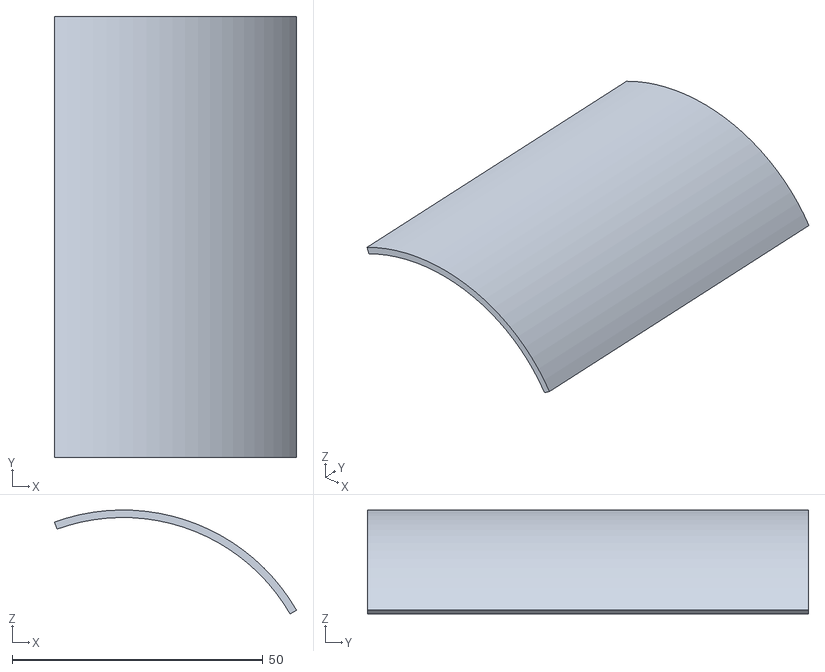
[picture p187: CAD file, 2026-11-07]
mechanical/shooter/cad/v22/7.15_SH_guarda_superior_PC.stl
48.3 x 88.0 x 20.7
