Robotica76/2026_MakeX_Challengue/mechanical/ball_intake/cad/v22/4.45_INT_engrane_16T_kit_centrador.stl

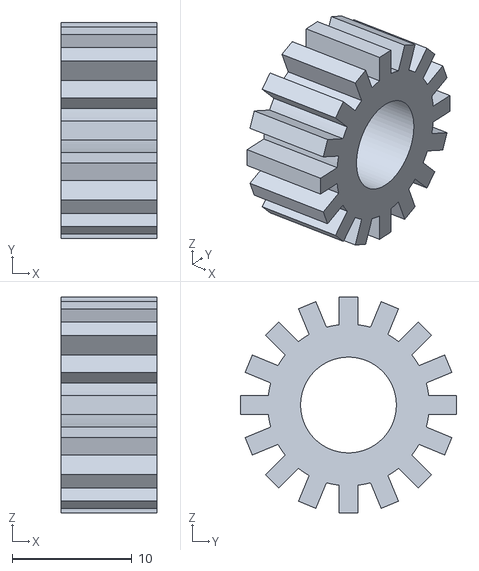
[picture p188: CAD file, 2026-11-07]
mechanical/ball_intake/cad/v22/4.45_INT_engrane_16T_kit_centrador.stl
8.00 x 18.1 x 18.1
