Robotica76/2026_MakeX_Challengue/mechanical/chassis/cad/v22/2.6_ELB_caja_paredes_CF1_ventiladas.stl

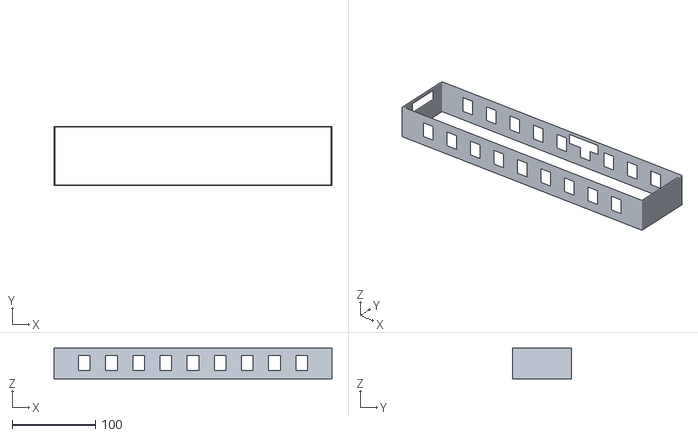
[picture p189: CAD file, 2026-11-07]
mechanical/chassis/cad/v22/2.6_ELB_caja_paredes_CF1_ventiladas.stl
333.0 x 71.0 x 37.0
