Robotica76/2026_MakeX_Challengue/mechanical/feeder/cad/v22/3.15_TW_tobogan_salida_codo_PC_1_5.stl

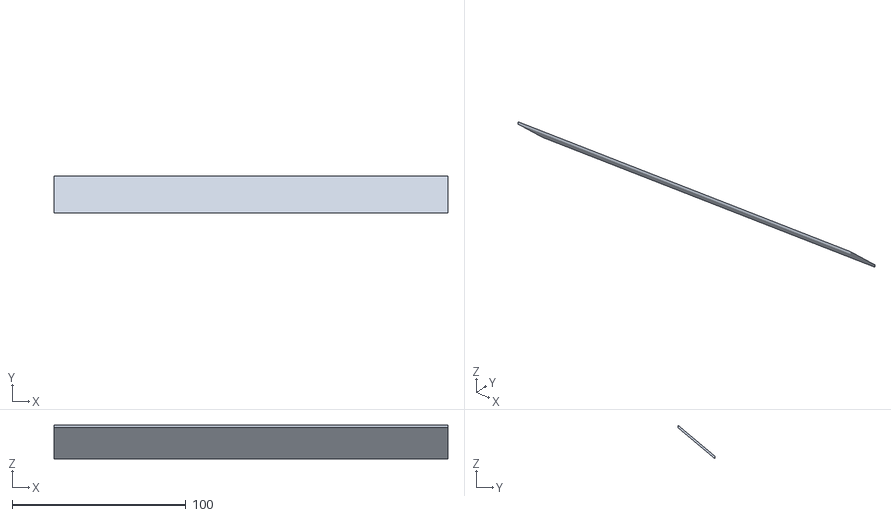
[picture p190: CAD file, 2026-11-07]
mechanical/feeder/cad/v22/3.15_TW_tobogan_salida_codo_PC_1_5.stl
227.0 x 21.4 x 19.5
