Robotica76/2026_MakeX_Challengue/mechanical/gripper_elevation/cad/v22/5.8_ELV_soporte_inferior_PETG.stl

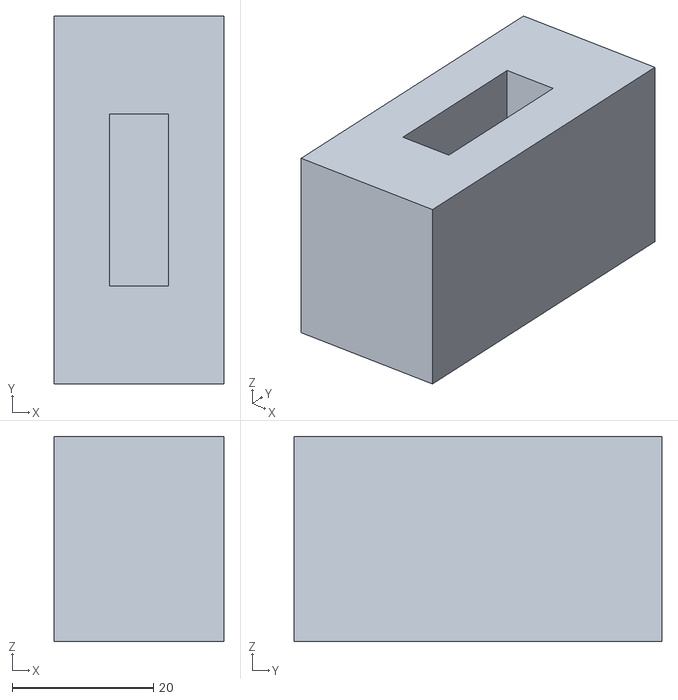
[picture p191: CAD file, 2026-11-07]
mechanical/gripper_elevation/cad/v22/5.8_ELV_soporte_inferior_PETG.stl
24.0 x 52.0 x 29.0
