Robotica76/2026_MakeX_Challengue/mechanical/ball_intake/cad/v22/4.13_INT_piso_entrada_ancho_PC.stl

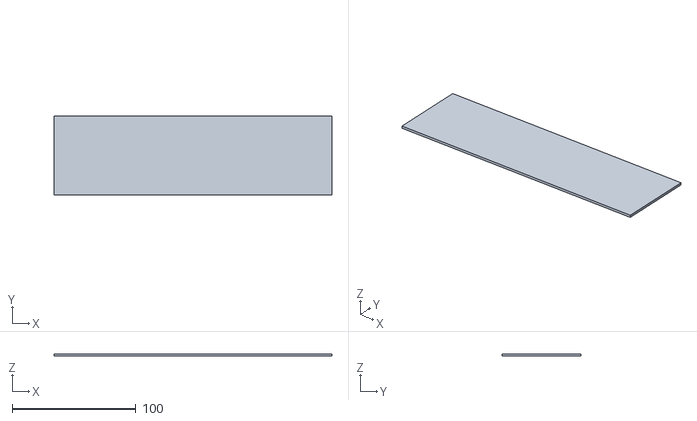
[picture p192: CAD file, 2026-11-07]
mechanical/ball_intake/cad/v22/4.13_INT_piso_entrada_ancho_PC.stl
225.0 x 64.0 x 2.00
