Robotica76/2026_MakeX_Challengue/mechanical/chassis/cad/v22/1.11_CH_guarda_rueda_tras_izq_PETG.stl

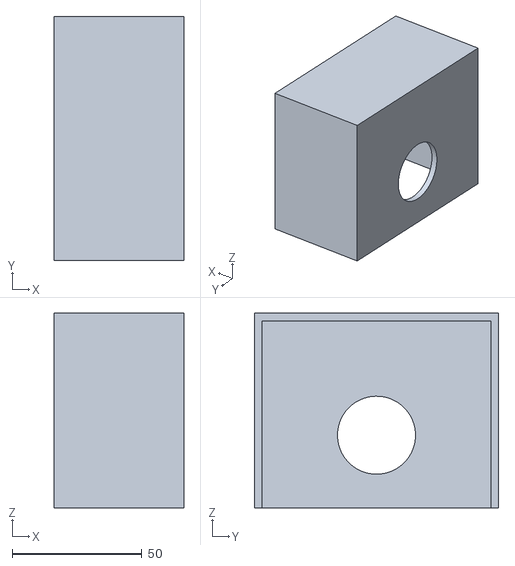
[picture p193: CAD file, 2026-11-07]
mechanical/chassis/cad/v22/1.11_CH_guarda_rueda_tras_izq_PETG.stl
50.0 x 94.0 x 75.0
