Robotica76/2026_MakeX_Challengue/mechanical/feeder/cad/v22/3.8_TW_poleas_PU_30mm_kit_x12.stl

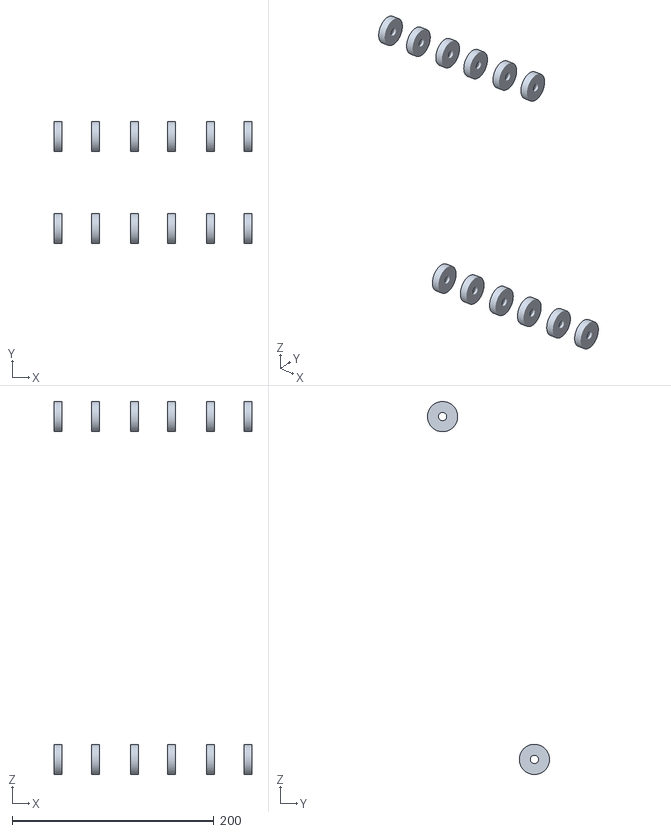
[picture p194: CAD file, 2026-11-07]
mechanical/feeder/cad/v22/3.8_TW_poleas_PU_30mm_kit_x12.stl
196.4 x 121.1 x 370.0
