Robotica76/2026_MakeX_Challengue/mechanical/ball_intake/cad/v22/4.22_INT_R3_entrada_estrellas_TPU.stl

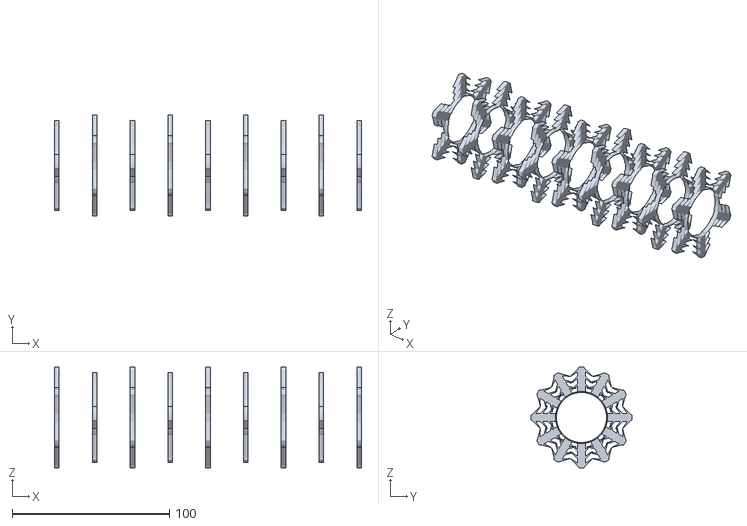
[picture p195: CAD file, 2026-11-07]
mechanical/ball_intake/cad/v22/4.22_INT_R3_entrada_estrellas_TPU.stl
195.0 x 64.0 x 64.0
