Robotica76/2026_MakeX_Challengue/mechanical/feeder/cad/v22/3.7_TW_pared_frontal_PC_con_ventana.stl

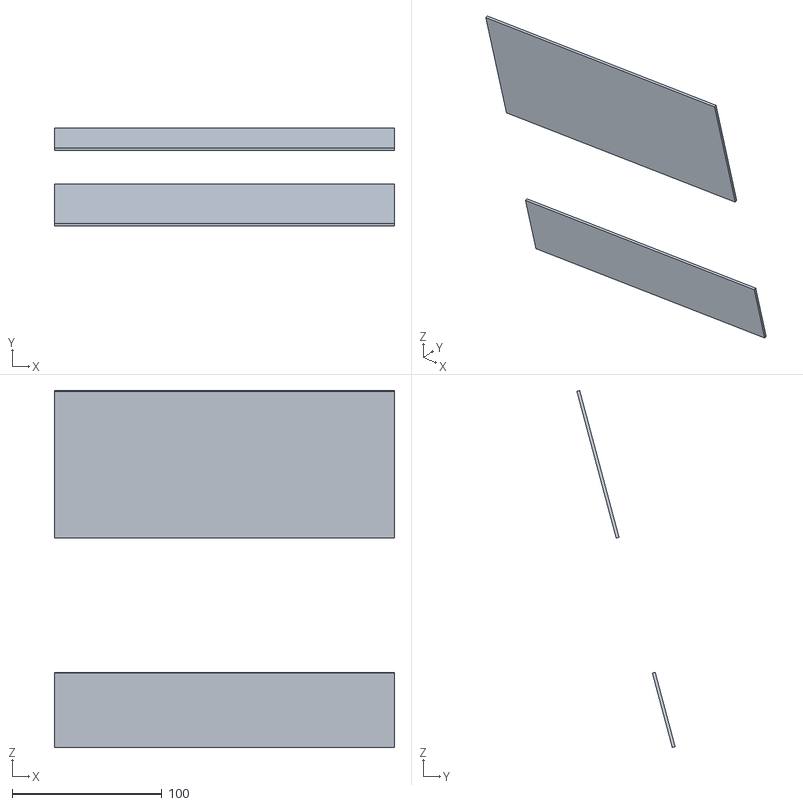
[picture p196: CAD file, 2026-11-07]
mechanical/feeder/cad/v22/3.7_TW_pared_frontal_PC_con_ventana.stl
227.0 x 65.6 x 238.1
