Robotica76/2026_MakeX_Challengue/mechanical/gripper_elevation/cad/v22/5.13_MAS_piso_CF3.stl

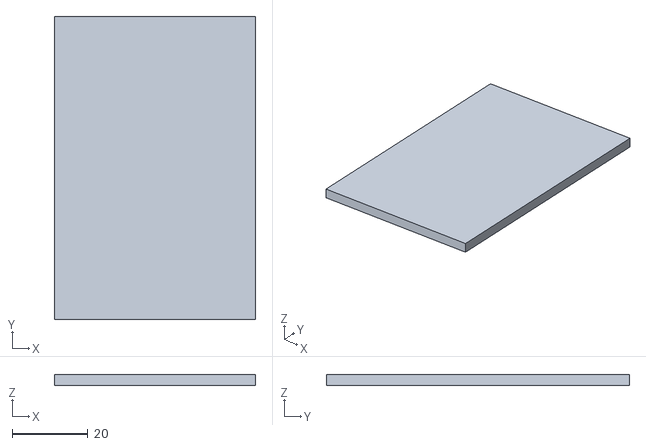
[picture p197: CAD file, 2026-11-07]
mechanical/gripper_elevation/cad/v22/5.13_MAS_piso_CF3.stl
53.0 x 80.0 x 3.00
