Robotica76/2026_MakeX_Challengue/mechanical/chassis/cad/v22/1.49_CH_motor_180_encoder_tras_izq_eje_salida.stl

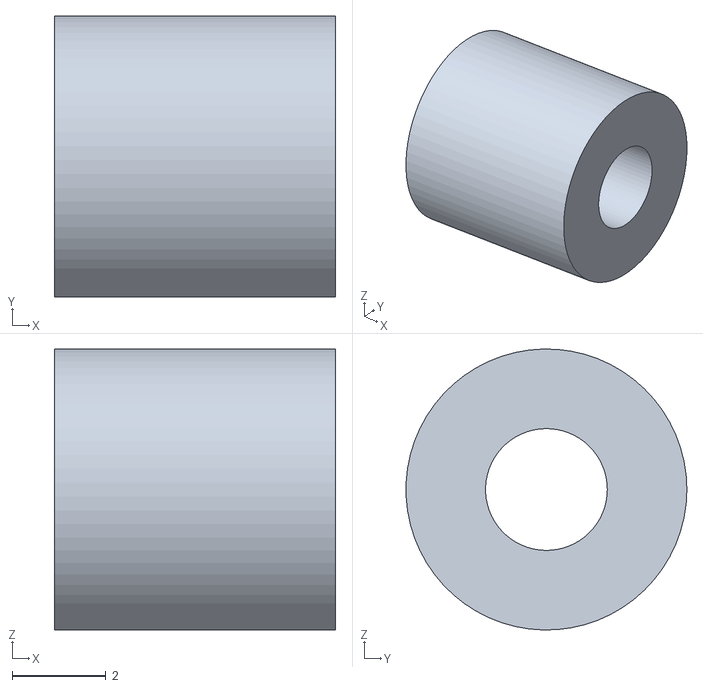
[picture p198: CAD file, 2026-11-07]
mechanical/chassis/cad/v22/1.49_CH_motor_180_encoder_tras_izq_eje_salida.stl
6.00 x 6.00 x 6.00
