Robotica76/2026_MakeX_Challengue/mechanical/gripper_elevation/cad/v22/5.11_MAS_tapa_y_bandeja_camara_CF3.stl

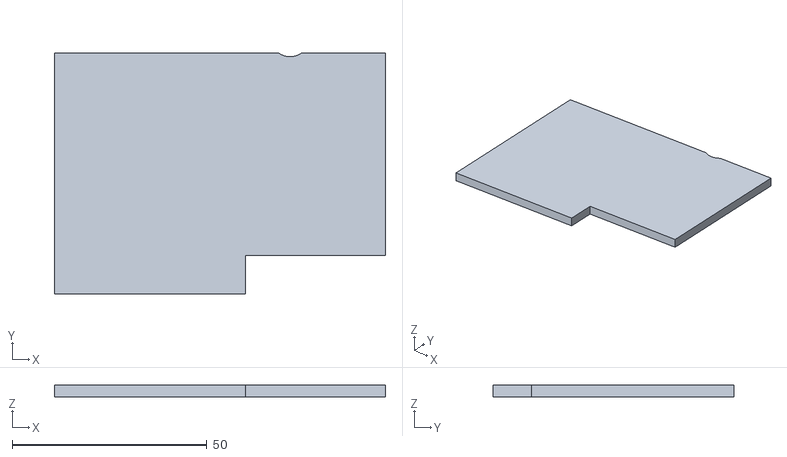
[picture p199: CAD file, 2026-11-07]
mechanical/gripper_elevation/cad/v22/5.11_MAS_tapa_y_bandeja_camara_CF3.stl
85.0 x 62.0 x 3.00
