Robotica76/2026_MakeX_Challengue/mechanical/ball_intake/cad/v22/4.51_INT_eje_loco.stl

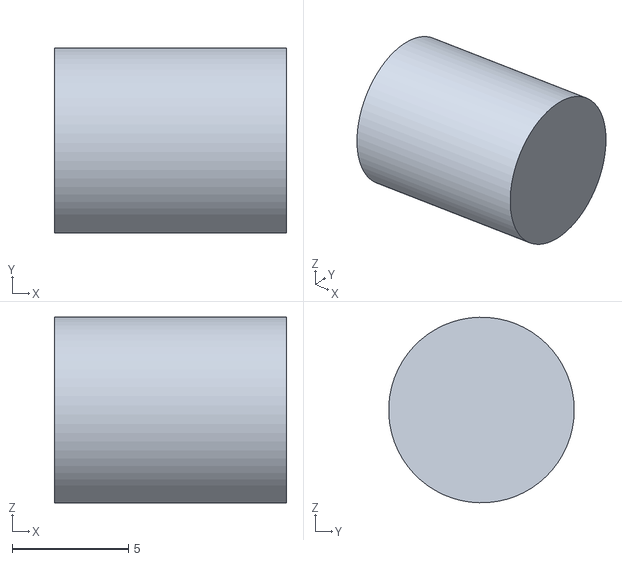
[picture p200: CAD file, 2026-11-07]
mechanical/ball_intake/cad/v22/4.51_INT_eje_loco.stl
10.0 x 8.00 x 8.00
