Robotica76/2026_MakeX_Challengue/mechanical/chassis/cad/v22/2.10_ELB_cinchos_bateria_velcro_x2.stl

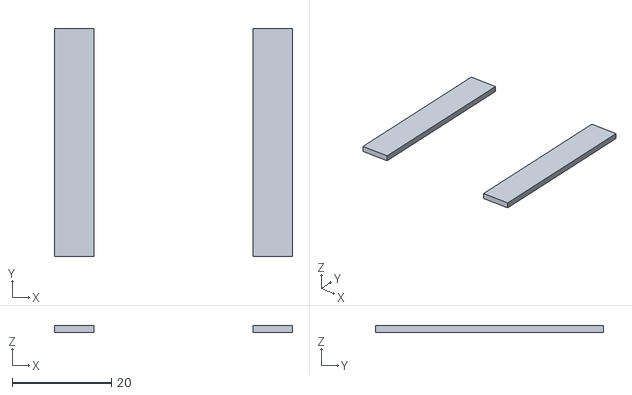
[picture p201: CAD file, 2026-11-07]
mechanical/chassis/cad/v22/2.10_ELB_cinchos_bateria_velcro_x2.stl
48.0 x 46.0 x 1.50
