Robotica76/2026_MakeX_Challengue/mechanical/gripper_elevation/cad/v22/5.2_ELV_riel_slide_beam_496_kit.stl

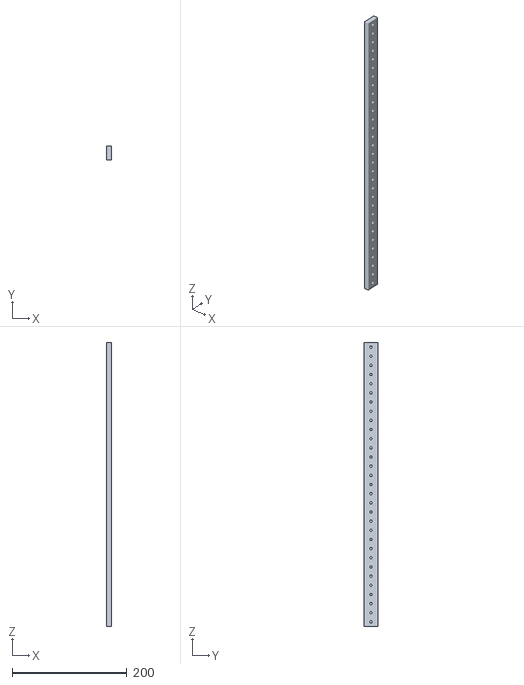
[picture p202: CAD file, 2026-11-07]
mechanical/gripper_elevation/cad/v22/5.2_ELV_riel_slide_beam_496_kit.stl
8.00 x 24.0 x 496.0
