Robotica76/2026_MakeX_Challengue/mechanical/ball_intake/cad/v22/4.50_INT_UR_rodamiento_8x16x5.stl

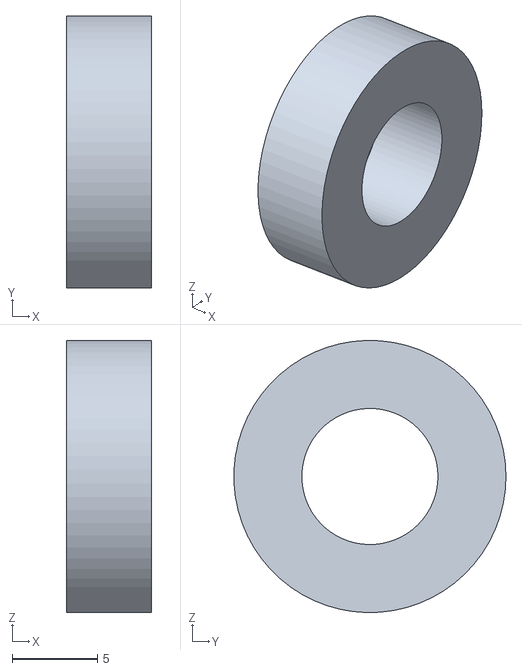
[picture p203: CAD file, 2026-11-07]
mechanical/ball_intake/cad/v22/4.50_INT_UR_rodamiento_8x16x5.stl
5.00 x 16.0 x 16.0
