Robotica76/2026_MakeX_Challengue/mechanical/gripper_elevation/cad/v22/5.5_ELV_soporte_superior_PETG.stl

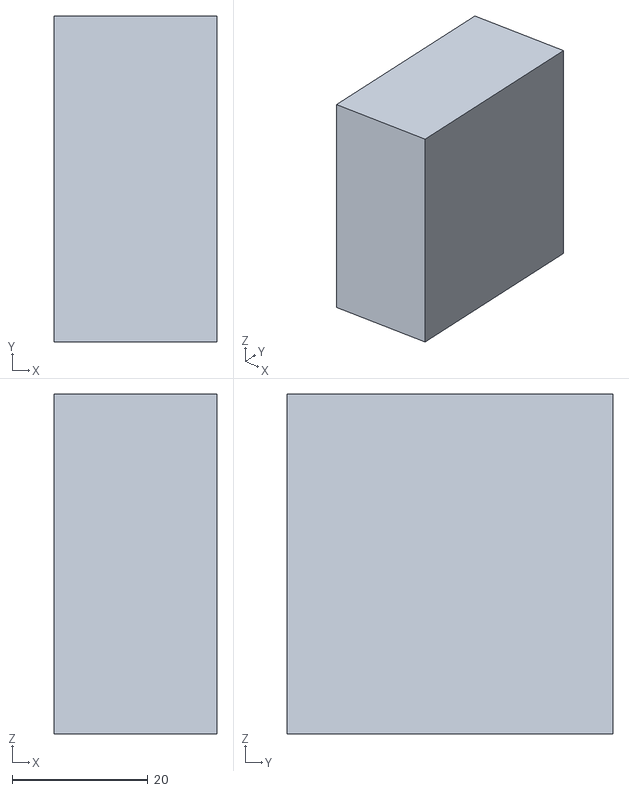
[picture p204: CAD file, 2026-11-07]
mechanical/gripper_elevation/cad/v22/5.5_ELV_soporte_superior_PETG.stl
24.0 x 48.0 x 50.0
