Robotica76/2026_MakeX_Challengue/mechanical/ball_intake/cad/v22/4.15_INT_UR_brazo_der_CF3.stl

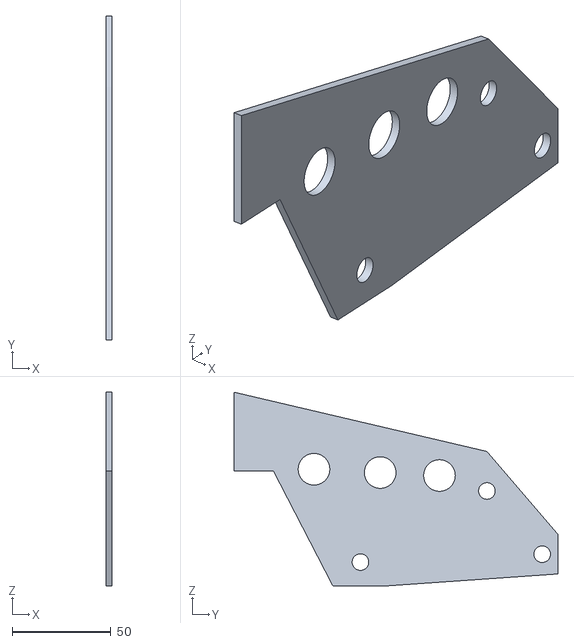
[picture p205: CAD file, 2026-11-07]
mechanical/ball_intake/cad/v22/4.15_INT_UR_brazo_der_CF3.stl
3.00 x 164.0 x 98.0
