Robotica76/2026_MakeX_Challengue/mechanical/chassis/cad/v22/1.16_CH_guarda_rueda_tras_der_PETG.stl

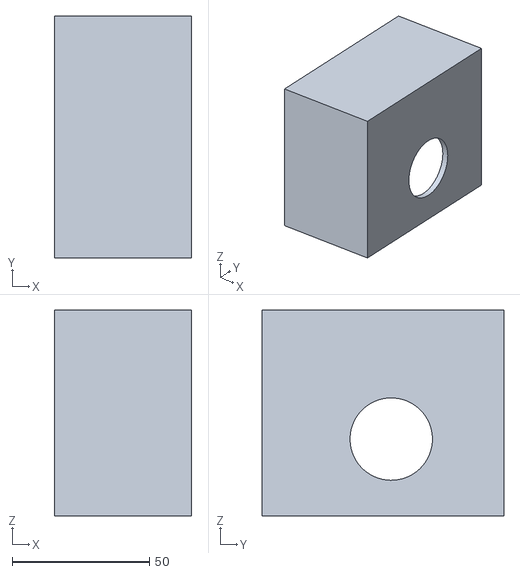
[picture p206: CAD file, 2026-11-07]
mechanical/chassis/cad/v22/1.16_CH_guarda_rueda_tras_der_PETG.stl
50.0 x 88.0 x 75.0
