Robotica76/2026_MakeX_Challengue/mechanical/gripper_elevation/cad/v22/5.1_ELV_motor_DC37_50rpm_kit.stl

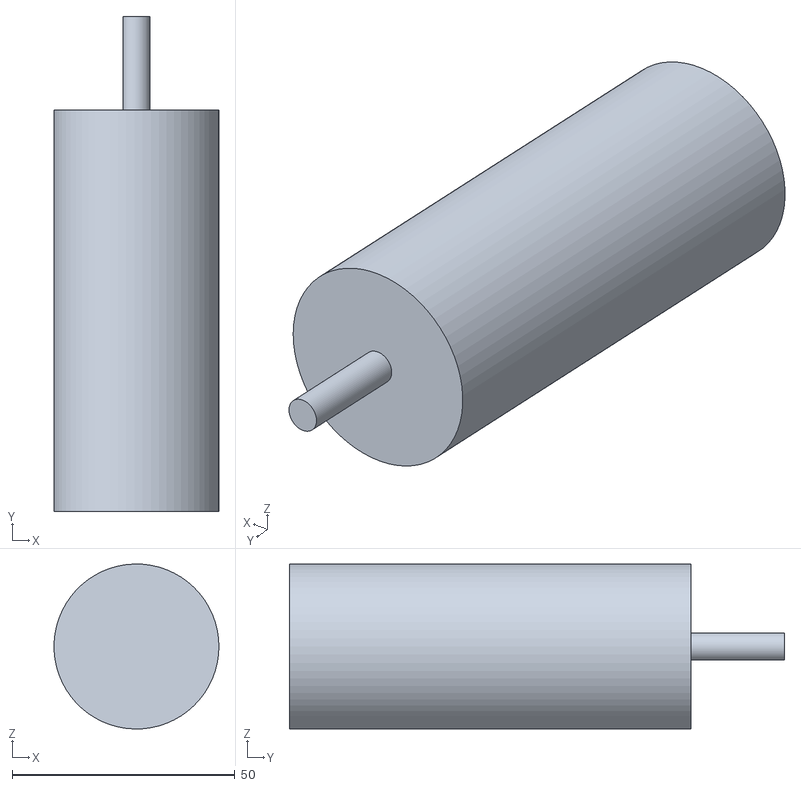
[picture p207: CAD file, 2026-11-07]
mechanical/gripper_elevation/cad/v22/5.1_ELV_motor_DC37_50rpm_kit.stl
37.0 x 111.0 x 37.0
