Robotica76/2026_MakeX_Challengue/(list of files, cad)

Other CAD files:
mechanical/gripper/cad/v22/6.6_GR_almohadilla_V_fija_TPU.stl
mechanical/gripper_elevation/cad/v22/5.26_RIG_separador_torre_mastil_z120_PETG.stl
mechanical/gripper_elevation/cad/v22/5.24_RIG_separador_torre_mastil_z380_PETG.stl
mechanical/chassis/cad/v22/1.44_CH_tornillo_M2_5x30_tras_izq.stl
mechanical/chassis/cad/v22/1.36_CH_hub_mecanum_80_tras_der.stl
mechanical/gripper_elevation/cad/v22/5.19_MAS_costilla_frente_z440_CF3.stl
mechanical/ball_intake/cad/v22/4.17_INT_LR_motor_DC25_interno.stl
mechanical/shooter/cad/v22/7.10_SH_brushless_kit_horario.stl
mechanical/gripper/cad/v22/6.16_GR_bloque_extremo_libre_PETG.stl
mechanical/gripper_elevation/cad/v22/5.22_MAS_costilla_banda_z440_CF3.stl
mechanical/chassis/cad/v22/1.32_CH_coupling_mecanum_80_tras_izq.stl
mechanical/feeder/cad/v22/3.2_TW_placa_lateral_izq_CF3.stl
mechanical/shooter/cad/v22/7.3_SH_placa_lateral_CF3_izq.stl
mechanical/ball_intake/cad/v22/4.6_INT_motor_DC37_200rpm_kit.stl
mechanical/feeder/cad/v22/3.13_TW_engrane_48T_kit_loco.stl
mechanical/gripper/cad/v22/6.7_GR_mordaza_fija_Al3.stl
mechanical/gripper_elevation/cad/v22/5.18_MAS_costilla_frente_z300_CF3.stl
mechanical/gripper_elevation/cad/v22/5.10_ELV_polea_90T_kit_motriz.stl
mechanical/chassis/cad/v22/1.40_CH_tornillos_M4x20_motor_tras_izq.stl
mechanical/ball_intake/cad/v22/4.18_INT_UR_motor_DC25_giro_interno.stl
mechanical/gripper_elevation/cad/v22/5.20_MAS_costilla_banda_z150_CF3.stl
mechanical/ball_intake/cad/v22/4.16_INT_UR_motor_DC25_elevacion.stl
mechanical/chassis/cad/v22/1.8_CH_guarda_rueda_del_izq_PETG.stl
mechanical/chassis/cad/v22/1.46_CH_tornillo_M2_5x30_del_der.stl
mechanical/ball_intake/cad/v22/4.11_INT_UR_riel_tubo_CF_20x20_430_izq.stl
mechanical/ball_intake/cad/v22/4.12_INT_UR_riel_tubo_CF_20x20_430_der.stl
mechanical/ball_intake/cad/v22/4.14_INT_UR_brazo_izq_CF3.stl
mechanical/ball_intake/cad/v22/4.19_INT_UR_tornillo_T8x16.stl
mechanical/ball_intake/cad/v22/4.20_INT_rampa_ancha_PC_2mm.stl
mechanical/ball_intake/cad/v22/4.23_INT_UR_bandas_PU_redondas_x5.stl
mechanical/ball_intake/cad/v22/4.24_INT_engrane_48T_kit_motor.stl
mechanical/ball_intake/cad/v22/4.25_INT_engrane_48T_kit_loco_R3.stl
mechanical/ball_intake/cad/v22/4.27_INT_UR_eje_nariz_D8_Al.stl
mechanical/ball_intake/cad/v22/4.28_INT_UR_eje_cola_D8_Al.stl
mechanical/ball_intake/cad/v22/4.2_INT_UR_nucleo_D32.stl
mechanical/ball_intake/cad/v22/4.32_INT_UR_patin_impreso_2020_der_PETG.stl
mechanical/ball_intake/cad/v22/4.33_INT_centrador_eje_D8.stl
mechanical/ball_intake/cad/v22/4.36_INT_UR_estribo_motor_PETG.stl
mechanical/ball_intake/cad/v22/4.38_INT_deflector_PC_der.stl
mechanical/ball_intake/cad/v22/4.39_INT_deflector_PC_izq.stl
mechanical/ball_intake/cad/v22/4.3_INT_centrador_nucleo.stl
mechanical/ball_intake/cad/v22/4.40_INT_UR_munon_D8_acero.stl
mechanical/ball_intake/cad/v22/4.41_INT_UR_poleas_GT2_20T_x2.stl
mechanical/ball_intake/cad/v22/4.43_INT_LR_munon_D8_acero.stl
mechanical/ball_intake/cad/v22/4.44_INT_UR_soporte_inferior_PETG.stl
mechanical/ball_intake/cad/v22/4.46_INT_engrane_16T_kit_R3.stl
mechanical/ball_intake/cad/v22/4.47_INT_UR_escuadras_perfil_izq_PETG.stl
mechanical/ball_intake/cad/v22/4.48_INT_UR_escuadras_perfil_der_PETG.stl
mechanical/ball_intake/cad/v22/4.52_INT_eje_loco_R3.stl
mechanical/ball_intake/cad/v22/4.53_INT_LR_collarin.stl
mechanical/ball_intake/cad/v22/4.55_INT_UR_banda_GT2_elevacion.stl
mechanical/ball_intake/cad/v22/4.7_INT_centrador_helicoidal_TPU.stl
mechanical/ball_intake/cad/v22/4.9_INT_placa_lateral_izq_CF3.stl
mechanical/chassis/cad/v22/1.13_CH_mecanum_80_L_del_izq_rodillos.stl
mechanical/chassis/cad/v22/1.14_CH_mecanum_80_R_tras_izq_rodillos.stl
mechanical/chassis/cad/v22/1.15_CH_mecanum_80_L_tras_der_rodillos.stl
mechanical/chassis/cad/v22/1.17_CH_motor_180_encoder_del_izq_caja.stl
mechanical/chassis/cad/v22/1.19_CH_motor_180_encoder_tras_izq_caja.stl
mechanical/chassis/cad/v22/1.1_CH_calzas_travesano_impresas_x6.stl
mechanical/chassis/cad/v22/1.20_CH_motor_180_encoder_tras_der_caja.stl
mechanical/chassis/cad/v22/1.21_CH_chumacera_impresa_del_izq.stl
mechanical/chassis/cad/v22/1.22_CH_chumacera_impresa_del_der.stl
mechanical/chassis/cad/v22/1.24_CH_engranes_40T_impresos_del_izq.stl
mechanical/chassis/cad/v22/1.25_CH_separadores_placa_intake_impresos_x4.stl
mechanical/chassis/cad/v22/1.27_CH_motor_180_encoder_del_der_lata.stl
mechanical/chassis/cad/v22/1.28_CH_motor_180_encoder_tras_izq_lata.stl
mechanical/chassis/cad/v22/1.29_CH_motor_180_encoder_tras_der_lata.stl
mechanical/chassis/cad/v22/1.30_CH_coupling_mecanum_80_tras_der.stl
mechanical/chassis/cad/v22/1.31_CH_coupling_mecanum_80_del_der.stl
mechanical/chassis/cad/v22/1.34_CH_hub_mecanum_80_del_der.stl
mechanical/chassis/cad/v22/1.35_CH_hub_mecanum_80_tras_izq.stl
mechanical/chassis/cad/v22/1.38_CH_eje_rueda_D8_del_izq.stl
mechanical/chassis/cad/v22/1.39_CH_eje_rueda_D8_del_der.stl
mechanical/chassis/cad/v22/1.43_CH_motor_180_encoder_del_der_eje_salida.stl
mechanical/chassis/cad/v22/1.47_CH_tornillo_M2_5x30_del_izq.stl
mechanical/chassis/cad/v22/1.48_CH_motor_180_encoder_tras_der_eje_salida.stl
mechanical/chassis/cad/v22/1.4_CH_mecanum_80_L_tras_der_llanta.stl
mechanical/chassis/cad/v22/1.5_CH_mecanum_80_R_tras_izq_llanta.stl
mechanical/chassis/cad/v22/1.6_CH_mecanum_80_L_del_izq_llanta.stl
mechanical/chassis/cad/v22/1.9_CH_slide_beam_496_izq.stl
mechanical/chassis/cad/v22/2.1_ELEC_bateria_LiPo_3S_4200mAh.stl
mechanical/chassis/cad/v22/2.3_ELEC_power_expansion_y_management.stl
mechanical/chassis/cad/v22/2.4_ELB_caja_piso_CF2_estructural.stl
mechanical/chassis/cad/v22/2.5_ELEC_drivers_y_bluetooth.stl
mechanical/chassis/cad/v22/2.7_ELB_caja_tapa_CF1_removible.stl
mechanical/chassis/cad/v22/2.9_ELB_calzas_piso_rieles_PETG_x4.stl
