Robotica76/2026_MakeX_Challengue/mechanical/assemblies/README.md

# Assemblies

| Assembly | Content |
| --- | --- |
| [full_robot](full_robot/README.md) | The whole robot: **v22** STEP (initial and with the flag mast), STL, assembly manual, renders, fit analysis, CAD scripts |
| [ball_system](ball_system/README.md) | Intake → tower → basket → launcher interfaces |
| [manipulation_system](manipulation_system/README.md) | Elevator, gripper and flag-mast interfaces |

Subsystem CAD stays in each subsystem folder (`<subsystem>/cad/v22`, numbered STL); assemblies only reference it.
