Robotica76/2026_MakeX_Challengue/mechanical/assemblies/full_robot/README.md

# Full robot

The only place for whole-robot CAD. Constituent parts stay in their subsystem folders.

## Revisions

| Revision | Date | Content | Status |
| --- | --- | --- | --- |
| [v22](v22/README.md) | 2026-10-26 (CAD), 2026-11-06 (manual, numbered STL) | STEP initial and after modification (flag mast), STL, assembly manual PDF (18 sheets), exploded view, renders, Central Resource Area fit analysis, CadQuery sources | CAD only, not built |

## How v22 was reached (summary)

| Revision | Main change | Decision |
| --- | --- | --- |
| v15 | Intake with UR arm, turret launcher | — |
| v16 | Basket behind the turret | rejected later |
| v17 | Fixed launcher on the left, no turret; tower | DEC-M02 |
| v18 | Elbow at the tower top; side-entry launcher | DEC-M04 |
| v19 | Tower 3 balls wide; inverted launcher fed from the basket; CF rails | DEC-M03, M05, M08, M09 |
| v20 | Feed roller 3:1; screws; low electronics tray | DEC-M06 |
| v21 | Structural electronics box on the rails | DEC-M10, M11 |
| v22 | Removable flag mast with C head; numbered parts and manual | DEC-M12, M13 |

Full register: [DL-SYS-001](../../../docs/08_engineering_notebook/design_log/DL-SYS-001_design_decisions.md).
