Robotica76/2026_MakeX_Challengue/mechanical/assemblies/manipulation_system/README.md

# Manipulation system assembly

Gripper elevator (5) + carriage and gripper (6) + flag mast (9, Modification Stage only).

| Interface | Geometry | Check |
| --- | --- | --- |
| Carriage on the elevator rail | Travel 358 mm (zc 28 → 386); 430 mm proposed for cones (KI-009) | CAD clash check at both ends |
| Flag-mast receptor on the gripper mounting block | Receptor 6.17 at x 181.5, y −64; mast passes the lid notch, 3 mm from the AI camera | CAD clash check with the mast at both carriage positions |
| Gripper reach | Jaw tip at x = +250 (footprint limit, KI-001) | CAD |

Concept and element coverage: [manipulator design](../../../docs/03_design/manipulator/README.md). Flag mast
position is an open decision (KI-008).
