Robotica76/2026_MakeX_Challengue/mechanical/ball_intake/manufacturing/README.md

# Ball Intake Manufacturing

Manufacturing plan for revision v22, derived from the CAD part names. **Nothing has been fabricated yet;** processes and materials are the CAD intent and must be confirmed against stock, kit contents, and the released [drawings](../drawings/README.md).

## v22 · Bill of materials and process

| No. | Part (CAD name) | Qty | Process | Material | STL |
| --- | --- | --- | --- | --- | --- |
| 4.1 | `INT_LR_manguito_TPU_D44` | 1 | FDM print | TPU | [STL](../cad/v22/4.1_INT_LR_manguito_TPU_D44.stl) |
| 4.2 | `INT_UR_nucleo_D32` | 1 | FDM print | PETG | [STL](../cad/v22/4.2_INT_UR_nucleo_D32.stl) |
| 4.3 | `INT_centrador_nucleo` | 1 | FDM print | PETG | [STL](../cad/v22/4.3_INT_centrador_nucleo.stl) |
| 4.4 | `INT_R3_entrada_nucleo` | 1 | FDM print | PETG | [STL](../cad/v22/4.4_INT_R3_entrada_nucleo.stl) |
| 4.5 | `INT_UR_anillos_banda_D60_PETG` | 1 | FDM print | PETG | [STL](../cad/v22/4.5_INT_UR_anillos_banda_D60_PETG.stl) |
| 4.6 | `INT_motor_DC37_200rpm_kit` | 1 | MakeX kit part | — | [STL](../cad/v22/4.6_INT_motor_DC37_200rpm_kit.stl) |
| 4.7 | `INT_centrador_helicoidal_TPU` | 1 | FDM print | TPU | [STL](../cad/v22/4.7_INT_centrador_helicoidal_TPU.stl) |
| 4.8 | `INT_placa_lateral_der_CF3` | 1 | CNC / water-jet cut plate, 3 mm | Carbon fibre | [STL](../cad/v22/4.8_INT_placa_lateral_der_CF3.stl) |
| 4.9 | `INT_placa_lateral_izq_CF3` | 1 | CNC / water-jet cut plate, 3 mm | Carbon fibre | [STL](../cad/v22/4.9_INT_placa_lateral_izq_CF3.stl) |
| 4.10 | `INT_tobogan_repisa_alta_PC_2mm` | 1 | Cut / bend sheet | Polycarbonate | [STL](../cad/v22/4.10_INT_tobogan_repisa_alta_PC_2mm.stl) |
| 4.11 | `INT_UR_riel_tubo_CF_20x20_430_izq` | 1 | Cut to length from CF tube | Carbon fibre tube | [STL](../cad/v22/4.11_INT_UR_riel_tubo_CF_20x20_430_izq.stl) |
| 4.12 | `INT_UR_riel_tubo_CF_20x20_430_der` | 1 | Cut to length from CF tube | Carbon fibre tube | [STL](../cad/v22/4.12_INT_UR_riel_tubo_CF_20x20_430_der.stl) |
| 4.13 | `INT_piso_entrada_ancho_PC` | 1 | Cut / bend sheet | Polycarbonate | [STL](../cad/v22/4.13_INT_piso_entrada_ancho_PC.stl) |
| 4.14 | `INT_UR_brazo_izq_CF3` | 1 | CNC / water-jet cut plate, 3 mm | Carbon fibre | [STL](../cad/v22/4.14_INT_UR_brazo_izq_CF3.stl) |
| 4.15 | `INT_UR_brazo_der_CF3` | 1 | CNC / water-jet cut plate, 3 mm | Carbon fibre | [STL](../cad/v22/4.15_INT_UR_brazo_der_CF3.stl) |
| 4.16 | `INT_UR_motor_DC25_elevacion` | 1 | MakeX kit part | — | [STL](../cad/v22/4.16_INT_UR_motor_DC25_elevacion.stl) |
| 4.17 | `INT_LR_motor_DC25_interno` | 1 | MakeX kit part | — | [STL](../cad/v22/4.17_INT_LR_motor_DC25_interno.stl) |
| 4.18 | `INT_UR_motor_DC25_giro_interno` | 1 | MakeX kit part | — | [STL](../cad/v22/4.18_INT_UR_motor_DC25_giro_interno.stl) |
| 4.19 | `INT_UR_tornillo_T8x16` | 1 | Purchase (T8 lead screw + nut) | Steel | [STL](../cad/v22/4.19_INT_UR_tornillo_T8x16.stl) |
| 4.20 | `INT_rampa_ancha_PC_2mm` | 1 | Cut / bend sheet | Polycarbonate | [STL](../cad/v22/4.20_INT_rampa_ancha_PC_2mm.stl) |
| 4.21 | `INT_UR_poleas_PU_20mm_kit_nariz_y_cola_x10` | 10 | MakeX kit / purchase | — | [STL](../cad/v22/4.21_INT_UR_poleas_PU_20mm_kit_nariz_y_cola_x10.stl) |
| 4.22 | `INT_R3_entrada_estrellas_TPU` | 1 | FDM print | TPU | [STL](../cad/v22/4.22_INT_R3_entrada_estrellas_TPU.stl) |
| 4.23 | `INT_UR_bandas_PU_redondas_x5` | 5 | MakeX kit / purchase | — | [STL](../cad/v22/4.23_INT_UR_bandas_PU_redondas_x5.stl) |
| 4.24 | `INT_engrane_48T_kit_motor` | 1 | MakeX kit part | — | [STL](../cad/v22/4.24_INT_engrane_48T_kit_motor.stl) |
| 4.25 | `INT_engrane_48T_kit_loco_R3` | 1 | MakeX kit / purchase | — | [STL](../cad/v22/4.25_INT_engrane_48T_kit_loco_R3.stl) |
| 4.26 | `INT_engrane_48T_kit_loco` | 1 | MakeX kit / purchase | — | [STL](../cad/v22/4.26_INT_engrane_48T_kit_loco.stl) |
| 4.27 | `INT_UR_eje_nariz_D8_Al` | 1 | Cut to length (rod / tube) | Aluminium | [STL](../cad/v22/4.27_INT_UR_eje_nariz_D8_Al.stl) |
| 4.28 | `INT_UR_eje_cola_D8_Al` | 1 | Cut to length (rod / tube) | Aluminium | [STL](../cad/v22/4.28_INT_UR_eje_cola_D8_Al.stl) |
| 4.29 | `INT_UR_dedos_TPU_espiga` | 1 | FDM print | TPU | [STL](../cad/v22/4.29_INT_UR_dedos_TPU_espiga.stl) |
| 4.30 | `INT_UR_soporte_superior_PETG` | 1 | FDM print | PETG | [STL](../cad/v22/4.30_INT_UR_soporte_superior_PETG.stl) |
| 4.31 | `INT_UR_patin_impreso_2020_izq_PETG` | 1 | FDM print | PETG | [STL](../cad/v22/4.31_INT_UR_patin_impreso_2020_izq_PETG.stl) |
| 4.32 | `INT_UR_patin_impreso_2020_der_PETG` | 1 | FDM print | PETG | [STL](../cad/v22/4.32_INT_UR_patin_impreso_2020_der_PETG.stl) |
| 4.33 | `INT_centrador_eje_D8` | 1 | Cut to length from rod | Steel | [STL](../cad/v22/4.33_INT_centrador_eje_D8.stl) |
| 4.34 | `INT_R3_entrada_eje_D8` | 1 | Cut to length from rod | Steel | [STL](../cad/v22/4.34_INT_R3_entrada_eje_D8.stl) |
| 4.35 | `INT_LR_vaso_soporte_motor_PETG` | 1 | FDM print | PETG | [STL](../cad/v22/4.35_INT_LR_vaso_soporte_motor_PETG.stl) |
| 4.36 | `INT_UR_estribo_motor_PETG` | 1 | FDM print | PETG | [STL](../cad/v22/4.36_INT_UR_estribo_motor_PETG.stl) |
| 4.37 | `INT_soporte_DC37_kit_intake` | 1 | MakeX kit / purchase | — | [STL](../cad/v22/4.37_INT_soporte_DC37_kit_intake.stl) |
| 4.38 | `INT_deflector_PC_der` | 1 | Cut / bend sheet | Polycarbonate | [STL](../cad/v22/4.38_INT_deflector_PC_der.stl) |
| 4.39 | `INT_deflector_PC_izq` | 1 | Cut / bend sheet | Polycarbonate | [STL](../cad/v22/4.39_INT_deflector_PC_izq.stl) |
| 4.40 | `INT_UR_munon_D8_acero` | 1 | Cut to length from rod | Steel | [STL](../cad/v22/4.40_INT_UR_munon_D8_acero.stl) |
| 4.41 | `INT_UR_poleas_GT2_20T_x2` | 2 | MakeX kit / purchase | — | [STL](../cad/v22/4.41_INT_UR_poleas_GT2_20T_x2.stl) |
| 4.42 | `INT_UR_tuerca_brazo_PETG` | 1 | FDM print | PETG | [STL](../cad/v22/4.42_INT_UR_tuerca_brazo_PETG.stl) |
| 4.43 | `INT_LR_munon_D8_acero` | 1 | Cut to length from rod | Steel | [STL](../cad/v22/4.43_INT_LR_munon_D8_acero.stl) |
| 4.44 | `INT_UR_soporte_inferior_PETG` | 1 | FDM print | PETG | [STL](../cad/v22/4.44_INT_UR_soporte_inferior_PETG.stl) |
| 4.45 | `INT_engrane_16T_kit_centrador` | 1 | MakeX kit / purchase | — | [STL](../cad/v22/4.45_INT_engrane_16T_kit_centrador.stl) |
| 4.46 | `INT_engrane_16T_kit_R3` | 1 | MakeX kit / purchase | — | [STL](../cad/v22/4.46_INT_engrane_16T_kit_R3.stl) |
| 4.47 | `INT_UR_escuadras_perfil_izq_PETG` | 1 | FDM print | PETG | [STL](../cad/v22/4.47_INT_UR_escuadras_perfil_izq_PETG.stl) |
| 4.48 | `INT_UR_escuadras_perfil_der_PETG` | 1 | FDM print | PETG | [STL](../cad/v22/4.48_INT_UR_escuadras_perfil_der_PETG.stl) |
| 4.49 | `INT_tobogan_paredes_PC_2mm` | 1 | Cut / bend sheet | Polycarbonate | [STL](../cad/v22/4.49_INT_tobogan_paredes_PC_2mm.stl) |
| 4.50 | `INT_UR_rodamiento_8x16x5` | 1 | Purchase (bearing 8x16x5) | Steel | [STL](../cad/v22/4.50_INT_UR_rodamiento_8x16x5.stl) |
| 4.51 | `INT_eje_loco` | 1 | Cut to length from rod | Steel | [STL](../cad/v22/4.51_INT_eje_loco.stl) |
| 4.52 | `INT_eje_loco_R3` | 1 | Cut to length from rod | Steel | [STL](../cad/v22/4.52_INT_eje_loco_R3.stl) |
| 4.53 | `INT_LR_collarin` | 1 | Purchase (8 mm shaft collar) | Steel | [STL](../cad/v22/4.53_INT_LR_collarin.stl) |
| 4.54 | `INT_LR_buje_PETG` | 1 | FDM print | PETG | [STL](../cad/v22/4.54_INT_LR_buje_PETG.stl) |
| 4.55 | `INT_UR_banda_GT2_elevacion` | 1 | MakeX kit / purchase | — | [STL](../cad/v22/4.55_INT_UR_banda_GT2_elevacion.stl) |

### Summary by process

| Process | Lines |
| --- | --- |
| FDM print | 18 |
| MakeX kit / purchase | 9 |
| Cut / bend sheet | 6 |
| Cut to length from rod | 6 |
| MakeX kit part | 5 |
| CNC / water-jet cut plate, 3 mm | 4 |
| Cut to length from CF tube | 2 |
| Cut to length (rod / tube) | 2 |
| Purchase (T8 lead screw + nut) | 1 |
| Purchase (bearing 8x16x5) | 1 |
| Purchase (8 mm shaft collar) | 1 |

## Assembly

1. Side plates CF3 (4.8, 4.9) on the chassis spacers.
2. Rollers: R2 straight centring roller (4.3, 4.7, 4.33), R3 wide entry roller ±108 mm (4.4, 4.22, 4.34), lower roller LR with its internal DC-25 (4.1, 4.17, 4.35).
3. DC-37 (4.6) on its bracket and the 48T/16T gear train to R3 and R2.
4. Wide ramp and floor sheets (4.20, 4.13), deflectors.
5. UR arm: CF 20×20 rails (4.11, 4.12), printed sliders, T8 lead screw with the top DC-25 and GT2 belt 1:1, arms CF3, band nose with internal DC-25 (giro).

## Inspection checkpoints

- [ ] R2 core turns freely inside the D34 clearance in the tower plates
- [ ] R3 and R2 gear mesh without binding by hand
- [ ] UR arm travels z 95 → 468 without contact; nut lowest at z 113
- [ ] Ramp edge flush with the tower entry (no step for the ball)
- [ ] Intake left plate cut above z 278 (launcher clearance)
