Robotica76/2026_MakeX_Challengue/mechanical/chassis/manufacturing/README.md

# Chassis Manufacturing

Manufacturing plan for revision v22, derived from the CAD part names. **Nothing has been fabricated yet;** processes and materials are the CAD intent and must be confirmed against stock, kit contents, and the released [drawings](../drawings/README.md).

## v22 · Bill of materials and process

| No. | Part (CAD name) | Qty | Process | Material | STL |
| --- | --- | --- | --- | --- | --- |
| 1.1 | `CH_calzas_travesano_impresas_x6` | 6 | FDM print | PETG | [STL](../cad/v22/1.1_CH_calzas_travesano_impresas_x6.stl) |
| 1.2 | `CH_travesanos_square_beam_2424_312_x3` | 3 | MakeX kit / purchase | — | [STL](../cad/v22/1.2_CH_travesanos_square_beam_2424_312_x3.stl) |
| 1.3 | `CH_mecanum_80_R_del_der_llanta` | 1 | MakeX kit / purchase | — | [STL](../cad/v22/1.3_CH_mecanum_80_R_del_der_llanta.stl) |
| 1.4 | `CH_mecanum_80_L_tras_der_llanta` | 1 | MakeX kit / purchase | — | [STL](../cad/v22/1.4_CH_mecanum_80_L_tras_der_llanta.stl) |
| 1.5 | `CH_mecanum_80_R_tras_izq_llanta` | 1 | MakeX kit / purchase | — | [STL](../cad/v22/1.5_CH_mecanum_80_R_tras_izq_llanta.stl) |
| 1.6 | `CH_mecanum_80_L_del_izq_llanta` | 1 | MakeX kit / purchase | — | [STL](../cad/v22/1.6_CH_mecanum_80_L_del_izq_llanta.stl) |
| 1.7 | `CH_guarda_rueda_del_der_PETG` | 1 | FDM print | PETG | [STL](../cad/v22/1.7_CH_guarda_rueda_del_der_PETG.stl) |
| 1.8 | `CH_guarda_rueda_del_izq_PETG` | 1 | FDM print | PETG | [STL](../cad/v22/1.8_CH_guarda_rueda_del_izq_PETG.stl) |
| 1.9 | `CH_slide_beam_496_izq` | 1 | MakeX kit / purchase | — | [STL](../cad/v22/1.9_CH_slide_beam_496_izq.stl) |
| 1.10 | `CH_slide_beam_496_der` | 1 | MakeX kit / purchase | — | [STL](../cad/v22/1.10_CH_slide_beam_496_der.stl) |
| 1.11 | `CH_guarda_rueda_tras_izq_PETG` | 1 | FDM print | PETG | [STL](../cad/v22/1.11_CH_guarda_rueda_tras_izq_PETG.stl) |
| 1.12 | `CH_mecanum_80_R_del_der_rodillos` | 1 | MakeX kit / purchase | — | [STL](../cad/v22/1.12_CH_mecanum_80_R_del_der_rodillos.stl) |
| 1.13 | `CH_mecanum_80_L_del_izq_rodillos` | 1 | MakeX kit / purchase | — | [STL](../cad/v22/1.13_CH_mecanum_80_L_del_izq_rodillos.stl) |
| 1.14 | `CH_mecanum_80_R_tras_izq_rodillos` | 1 | MakeX kit / purchase | — | [STL](../cad/v22/1.14_CH_mecanum_80_R_tras_izq_rodillos.stl) |
| 1.15 | `CH_mecanum_80_L_tras_der_rodillos` | 1 | MakeX kit / purchase | — | [STL](../cad/v22/1.15_CH_mecanum_80_L_tras_der_rodillos.stl) |
| 1.16 | `CH_guarda_rueda_tras_der_PETG` | 1 | FDM print | PETG | [STL](../cad/v22/1.16_CH_guarda_rueda_tras_der_PETG.stl) |
| 1.17 | `CH_motor_180_encoder_del_izq_caja` | 1 | MakeX kit part | — | [STL](../cad/v22/1.17_CH_motor_180_encoder_del_izq_caja.stl) |
| 1.18 | `CH_motor_180_encoder_del_der_caja` | 1 | MakeX kit part | — | [STL](../cad/v22/1.18_CH_motor_180_encoder_del_der_caja.stl) |
| 1.19 | `CH_motor_180_encoder_tras_izq_caja` | 1 | MakeX kit part | — | [STL](../cad/v22/1.19_CH_motor_180_encoder_tras_izq_caja.stl) |
| 1.20 | `CH_motor_180_encoder_tras_der_caja` | 1 | MakeX kit part | — | [STL](../cad/v22/1.20_CH_motor_180_encoder_tras_der_caja.stl) |
| 1.21 | `CH_chumacera_impresa_del_izq` | 1 | FDM print | PETG | [STL](../cad/v22/1.21_CH_chumacera_impresa_del_izq.stl) |
| 1.22 | `CH_chumacera_impresa_del_der` | 1 | FDM print | PETG | [STL](../cad/v22/1.22_CH_chumacera_impresa_del_der.stl) |
| 1.23 | `CH_engranes_40T_impresos_del_der` | 1 | FDM print | PETG | [STL](../cad/v22/1.23_CH_engranes_40T_impresos_del_der.stl) |
| 1.24 | `CH_engranes_40T_impresos_del_izq` | 1 | FDM print | PETG | [STL](../cad/v22/1.24_CH_engranes_40T_impresos_del_izq.stl) |
| 1.25 | `CH_separadores_placa_intake_impresos_x4` | 4 | FDM print | PETG | [STL](../cad/v22/1.25_CH_separadores_placa_intake_impresos_x4.stl) |
| 1.26 | `CH_motor_180_encoder_del_izq_lata` | 1 | MakeX kit part | — | [STL](../cad/v22/1.26_CH_motor_180_encoder_del_izq_lata.stl) |
| 1.27 | `CH_motor_180_encoder_del_der_lata` | 1 | MakeX kit part | — | [STL](../cad/v22/1.27_CH_motor_180_encoder_del_der_lata.stl) |
| 1.28 | `CH_motor_180_encoder_tras_izq_lata` | 1 | MakeX kit part | — | [STL](../cad/v22/1.28_CH_motor_180_encoder_tras_izq_lata.stl) |
| 1.29 | `CH_motor_180_encoder_tras_der_lata` | 1 | MakeX kit part | — | [STL](../cad/v22/1.29_CH_motor_180_encoder_tras_der_lata.stl) |
| 1.30 | `CH_coupling_mecanum_80_tras_der` | 1 | MakeX kit / purchase | — | [STL](../cad/v22/1.30_CH_coupling_mecanum_80_tras_der.stl) |
| 1.31 | `CH_coupling_mecanum_80_del_der` | 1 | MakeX kit / purchase | — | [STL](../cad/v22/1.31_CH_coupling_mecanum_80_del_der.stl) |
| 1.32 | `CH_coupling_mecanum_80_tras_izq` | 1 | MakeX kit / purchase | — | [STL](../cad/v22/1.32_CH_coupling_mecanum_80_tras_izq.stl) |
| 1.33 | `CH_coupling_mecanum_80_del_izq` | 1 | MakeX kit / purchase | — | [STL](../cad/v22/1.33_CH_coupling_mecanum_80_del_izq.stl) |
| 1.34 | `CH_hub_mecanum_80_del_der` | 1 | MakeX kit / purchase | — | [STL](../cad/v22/1.34_CH_hub_mecanum_80_del_der.stl) |
| 1.35 | `CH_hub_mecanum_80_tras_izq` | 1 | MakeX kit / purchase | — | [STL](../cad/v22/1.35_CH_hub_mecanum_80_tras_izq.stl) |
| 1.36 | `CH_hub_mecanum_80_tras_der` | 1 | MakeX kit / purchase | — | [STL](../cad/v22/1.36_CH_hub_mecanum_80_tras_der.stl) |
| 1.37 | `CH_hub_mecanum_80_del_izq` | 1 | MakeX kit / purchase | — | [STL](../cad/v22/1.37_CH_hub_mecanum_80_del_izq.stl) |
| 1.38 | `CH_eje_rueda_D8_del_izq` | 1 | Cut to length from rod | Steel | [STL](../cad/v22/1.38_CH_eje_rueda_D8_del_izq.stl) |
| 1.39 | `CH_eje_rueda_D8_del_der` | 1 | Cut to length from rod | Steel | [STL](../cad/v22/1.39_CH_eje_rueda_D8_del_der.stl) |
| 1.40 | `CH_tornillos_M4x20_motor_tras_izq` | 1 | Hardware (purchase) | Steel | [STL](../cad/v22/1.40_CH_tornillos_M4x20_motor_tras_izq.stl) |
| 1.41 | `CH_tornillos_M4x20_motor_tras_der` | 1 | Hardware (purchase) | Steel | [STL](../cad/v22/1.41_CH_tornillos_M4x20_motor_tras_der.stl) |
| 1.42 | `CH_motor_180_encoder_del_izq_eje_salida` | 1 | MakeX kit part | — | [STL](../cad/v22/1.42_CH_motor_180_encoder_del_izq_eje_salida.stl) |
| 1.43 | `CH_motor_180_encoder_del_der_eje_salida` | 1 | MakeX kit part | — | [STL](../cad/v22/1.43_CH_motor_180_encoder_del_der_eje_salida.stl) |
| 1.44 | `CH_tornillo_M2_5x30_tras_izq` | 1 | Hardware (purchase) | Steel | [STL](../cad/v22/1.44_CH_tornillo_M2_5x30_tras_izq.stl) |
| 1.45 | `CH_tornillo_M2_5x30_tras_der` | 1 | Hardware (purchase) | Steel | [STL](../cad/v22/1.45_CH_tornillo_M2_5x30_tras_der.stl) |
| 1.46 | `CH_tornillo_M2_5x30_del_der` | 1 | Hardware (purchase) | Steel | [STL](../cad/v22/1.46_CH_tornillo_M2_5x30_del_der.stl) |
| 1.47 | `CH_tornillo_M2_5x30_del_izq` | 1 | Hardware (purchase) | Steel | [STL](../cad/v22/1.47_CH_tornillo_M2_5x30_del_izq.stl) |
| 1.48 | `CH_motor_180_encoder_tras_der_eje_salida` | 1 | MakeX kit part | — | [STL](../cad/v22/1.48_CH_motor_180_encoder_tras_der_eje_salida.stl) |
| 1.49 | `CH_motor_180_encoder_tras_izq_eje_salida` | 1 | MakeX kit part | — | [STL](../cad/v22/1.49_CH_motor_180_encoder_tras_izq_eje_salida.stl) |
| 2.1 | `ELEC_bateria_LiPo_3S_4200mAh` | 1 | Electronics (MakeX kit / purchase) | — | [STL](../cad/v22/2.1_ELEC_bateria_LiPo_3S_4200mAh.stl) |
| 2.2 | `ELEC_NovaPi_con_case` | 1 | Electronics (MakeX kit / purchase) | — | [STL](../cad/v22/2.2_ELEC_NovaPi_con_case.stl) |
| 2.3 | `ELEC_power_expansion_y_management` | 1 | Electronics (MakeX kit / purchase) | — | [STL](../cad/v22/2.3_ELEC_power_expansion_y_management.stl) |
| 2.4 | `ELB_caja_piso_CF2_estructural` | 1 | CNC / water-jet cut plate, 2 mm | Carbon fibre | [STL](../cad/v22/2.4_ELB_caja_piso_CF2_estructural.stl) |
| 2.5 | `ELEC_drivers_y_bluetooth` | 1 | Electronics (MakeX kit / purchase) | — | [STL](../cad/v22/2.5_ELEC_drivers_y_bluetooth.stl) |
| 2.6 | `ELB_caja_paredes_CF1_ventiladas` | 1 | CNC / water-jet cut plate, 1 mm | Carbon fibre | [STL](../cad/v22/2.6_ELB_caja_paredes_CF1_ventiladas.stl) |
| 2.7 | `ELB_caja_tapa_CF1_removible` | 1 | CNC / water-jet cut plate, 1 mm | Carbon fibre | [STL](../cad/v22/2.7_ELB_caja_tapa_CF1_removible.stl) |
| 2.8 | `ELB_caja_esquineros_PETG_x4` | 4 | FDM print | PETG | [STL](../cad/v22/2.8_ELB_caja_esquineros_PETG_x4.stl) |
| 2.9 | `ELB_calzas_piso_rieles_PETG_x4` | 4 | FDM print | PETG | [STL](../cad/v22/2.9_ELB_calzas_piso_rieles_PETG_x4.stl) |
| 2.10 | `ELB_cinchos_bateria_velcro_x2` | 2 | Purchase | Velcro | [STL](../cad/v22/2.10_ELB_cinchos_bateria_velcro_x2.stl) |

### Summary by process

| Process | Lines |
| --- | --- |
| MakeX kit / purchase | 19 |
| FDM print | 12 |
| MakeX kit part | 12 |
| Hardware (purchase) | 6 |
| Electronics (MakeX kit / purchase) | 4 |
| Cut to length from rod | 2 |
| CNC / water-jet cut plate, 1 mm | 2 |
| CNC / water-jet cut plate, 2 mm | 1 |
| Purchase | 1 |

## Assembly

1. Rails (slide beam 496) and the three 2424 crossbars on printed shims (1.1, 1.2, 1.9, 1.10).
2. Each wheel module: 180 smart-encoder motor, printed 40T gears, D8 axle on printed pillow block, hub, coupling, mecanum wheel, PETG guard. Front wheels at `y = +45`, rear at `y = −203`, `x = ±221.2`.
3. Square the frame (diagonals equal) before mounting anything else.
4. Electronics box (2.x): four 3 mm PETG shims on the rails, CF 2 mm floor bolted to **both** rails with 4 × M4; battery (2 Velcro straps), NovaPi, power module in the back row; drivers + Bluetooth on edge in the front row; CF 1 mm walls with PETG corner brackets. Fit the lid (4 × M3) only after wiring.

## Inspection checkpoints

- [ ] Frame square: diagonals within 1 mm
- [ ] All four wheels touch the floor (no rocking) with the robot loaded
- [ ] Box floor bolted to both rails; box does not touch the gripper-elevator motor (x = 139) nor the tower belts (7 mm gap)
- [ ] Battery strapped and not movable by hand; cables through the front/left grommets
- [ ] Robot mass ≤ 10 kg with all parts and screws (CAD: 9.88 kg)
