Robotica76/2026_MakeX_Challengue/mechanical/common_parts/manufacturing/README.md

# Common Parts Manufacturing

Manufacturing plan for revision v22, derived from the CAD part names. **Nothing has been fabricated yet;** processes and materials are the CAD intent and must be confirmed against stock, kit contents, and the released [drawings](../drawings/README.md).

## v22 · Bill of materials and process

| No. | Part (CAD name) | Qty | Process | Material | STL |
| --- | --- | --- | --- | --- | --- |
| 10.1 | `HW_tornillos_M3_boton_x73` | 73 | Hardware (purchase) | Steel | [STL](../cad/v22/10.1_HW_tornillos_M3_boton_x73.stl) |

### Summary by process

| Process | Lines |
| --- | --- |
| Hardware (purchase) | 1 |

## Assembly

Tighten all joints; blue thread locker on vibrating joints (motors, wheels, launcher).

## Inspection checkpoints

- [ ] All modelled screws fitted (73 × M3 button head + chassis M4)
- [ ] ≈ 80 additional joints defined by hand at assembly
