Robotica76/2026_MakeX_Challengue/mechanical/gripper_elevation/manufacturing/README.md

# Gripper Elevation Manufacturing

Manufacturing plan for revision v22, derived from the CAD part names. **Nothing has been fabricated yet;** processes and materials are the CAD intent and must be confirmed against stock, kit contents, and the released [drawings](../drawings/README.md).

## v22 · Bill of materials and process

| No. | Part (CAD name) | Qty | Process | Material | STL |
| --- | --- | --- | --- | --- | --- |
| 5.1 | `ELV_motor_DC37_50rpm_kit` | 1 | MakeX kit part | — | [STL](../cad/v22/5.1_ELV_motor_DC37_50rpm_kit.stl) |
| 5.2 | `ELV_riel_slide_beam_496_kit` | 1 | MakeX kit / purchase | — | [STL](../cad/v22/5.2_ELV_riel_slide_beam_496_kit.stl) |
| 5.3 | `MAS_placa_trasera_CF3` | 1 | CNC / water-jet cut plate, 3 mm | Carbon fibre | [STL](../cad/v22/5.3_MAS_placa_trasera_CF3.stl) |
| 5.4 | `MAS_mamparo_interior_CF3` | 1 | CNC / water-jet cut plate, 3 mm | Carbon fibre | [STL](../cad/v22/5.4_MAS_mamparo_interior_CF3.stl) |
| 5.5 | `ELV_soporte_superior_PETG` | 1 | FDM print | PETG | [STL](../cad/v22/5.5_ELV_soporte_superior_PETG.stl) |
| 5.6 | `MAS_placa_delantera_CF3` | 1 | CNC / water-jet cut plate, 3 mm | Carbon fibre | [STL](../cad/v22/5.6_MAS_placa_delantera_CF3.stl) |
| 5.7 | `ELV_AI_camera_2_0_kit` | 1 | MakeX kit part | — | [STL](../cad/v22/5.7_ELV_AI_camera_2_0_kit.stl) |
| 5.8 | `ELV_soporte_inferior_PETG` | 1 | FDM print | PETG | [STL](../cad/v22/5.8_ELV_soporte_inferior_PETG.stl) |
| 5.9 | `ELV_polea_90T_kit_loca` | 1 | MakeX kit / purchase | — | [STL](../cad/v22/5.9_ELV_polea_90T_kit_loca.stl) |
| 5.10 | `ELV_polea_90T_kit_motriz` | 1 | MakeX kit / purchase | — | [STL](../cad/v22/5.10_ELV_polea_90T_kit_motriz.stl) |
| 5.11 | `MAS_tapa_y_bandeja_camara_CF3` | 1 | CNC / water-jet cut plate, 3 mm | Carbon fibre | [STL](../cad/v22/5.11_MAS_tapa_y_bandeja_camara_CF3.stl) |
| 5.12 | `RIG_cuaderna_intake_elevador_der_CF3` | 1 | CNC / water-jet cut plate, 3 mm | Carbon fibre | [STL](../cad/v22/5.12_RIG_cuaderna_intake_elevador_der_CF3.stl) |
| 5.13 | `MAS_piso_CF3` | 1 | CNC / water-jet cut plate, 3 mm | Carbon fibre | [STL](../cad/v22/5.13_MAS_piso_CF3.stl) |
| 5.14 | `RIG_cuaderna_intake_elevador_izq_CF3` | 1 | CNC / water-jet cut plate, 3 mm | Carbon fibre | [STL](../cad/v22/5.14_RIG_cuaderna_intake_elevador_izq_CF3.stl) |
| 5.15 | `ELV_banda_dentada_kit` | 1 | MakeX kit / purchase | — | [STL](../cad/v22/5.15_ELV_banda_dentada_kit.stl) |
| 5.16 | `ELV_bracket_DC37_kit` | 1 | MakeX kit / purchase | — | [STL](../cad/v22/5.16_ELV_bracket_DC37_kit.stl) |
| 5.17 | `MAS_costilla_frente_z150_CF3` | 1 | CNC / water-jet cut plate, 3 mm | Carbon fibre | [STL](../cad/v22/5.17_MAS_costilla_frente_z150_CF3.stl) |
| 5.18 | `MAS_costilla_frente_z300_CF3` | 1 | CNC / water-jet cut plate, 3 mm | Carbon fibre | [STL](../cad/v22/5.18_MAS_costilla_frente_z300_CF3.stl) |
| 5.19 | `MAS_costilla_frente_z440_CF3` | 1 | CNC / water-jet cut plate, 3 mm | Carbon fibre | [STL](../cad/v22/5.19_MAS_costilla_frente_z440_CF3.stl) |
| 5.20 | `MAS_costilla_banda_z150_CF3` | 1 | MakeX kit / purchase | — | [STL](../cad/v22/5.20_MAS_costilla_banda_z150_CF3.stl) |
| 5.21 | `MAS_costilla_banda_z300_CF3` | 1 | MakeX kit / purchase | — | [STL](../cad/v22/5.21_MAS_costilla_banda_z300_CF3.stl) |
| 5.22 | `MAS_costilla_banda_z440_CF3` | 1 | MakeX kit / purchase | — | [STL](../cad/v22/5.22_MAS_costilla_banda_z440_CF3.stl) |
| 5.23 | `ELV_eje_loca_D4_kit` | 1 | MakeX kit / purchase | — | [STL](../cad/v22/5.23_ELV_eje_loca_D4_kit.stl) |
| 5.24 | `RIG_separador_torre_mastil_z380_PETG` | 1 | FDM print | PETG | [STL](../cad/v22/5.24_RIG_separador_torre_mastil_z380_PETG.stl) |
| 5.25 | `RIG_separador_torre_mastil_z250_PETG` | 1 | FDM print | PETG | [STL](../cad/v22/5.25_RIG_separador_torre_mastil_z250_PETG.stl) |
| 5.26 | `RIG_separador_torre_mastil_z120_PETG` | 1 | FDM print | PETG | [STL](../cad/v22/5.26_RIG_separador_torre_mastil_z120_PETG.stl) |

### Summary by process

| Process | Lines |
| --- | --- |
| CNC / water-jet cut plate, 3 mm | 10 |
| MakeX kit / purchase | 9 |
| FDM print | 5 |
| MakeX kit part | 2 |

## Assembly

1. Mast floor, rear/front plates, inner bulkhead and ribs (CF3).
2. Linear rail (slide beam 496), 90T drive and idler pulleys, timing belt.
3. DC-37 50 RPM with bracket.
4. Lid with the AI camera tray; D10 notch for the flag mast at `x 181.5`, `y −64`.
5. Tower–mast spacers (z 120 / 250 / 380) and intake–elevator frames.

## Inspection checkpoints

- [ ] Carriage 28 → 386 mm (358 mm travel)
- [ ] Camera not crossed by the flag mast (3 mm clearance)
- [ ] Lid top z 612, robot height 642
