Robotica76/2026_MakeX_Challengue/software/manual/mappings/README.md

# Mappings

| Mode | Front | Bindings |
| --- | --- | --- |
| "≡" ball mode | Intake (0°) | L1 intake in, L2 out, R1 shoot, R2 aim at the blue fortress + power, Up/Down intake head, N2 pull mode, N3 aim at the X |
| "+" gripper mode | Gripper (90°, right side) | Up/Down elevator, Left/Right jaw, L1/L2 intake |
| Final | — | N4 hang the flag (Red Start 1) |

Source of truth: the programs in [robot/main](../../robot/main/README.md); fronts as angles: DEC-S02.
