Robotica76/2026_MakeX_Challengue/electrical/wiring/wiring_diagrams.md

# Wiring Diagrams Starter

No wiring diagrams or pin assignments exist yet. This is an index and interface-documentation prompt, not a circuit or wiring instruction.

| Planned diagram | Scope | File/reference | Source revisions | Owner | Review/verification |
| --- | --- | --- | --- | --- | --- |
| Power overview | Source, distribution, loads, protection boundaries | TBD | TBD | TBD | TBD |
| Control and communication | Controllers and subsystem signal boundaries | TBD | TBD | TBD | TBD |
| Subsystem harnesses | Local actuation/sensing and assembly interfaces | TBD | TBD | TBD | TBD |

## Future connection record

TBD per connection: source/destination, function, connector identification, pin assignment, polarity/reference, conductor specification, protection, route, strain relief, isolation needs, and test method. Populate only from reviewed design decisions and authoritative component evidence.

Agree mounting and service boundaries with [full_robot](../../mechanical/assemblies/full_robot/README.md). Reconcile [architecture](../architecture/electrical_architecture.md), [power distribution](../power/power_distribution.md), and [BOM](../bom/electrical_bom.md) revisions before approving diagrams.
