Robotica76/2026_MakeX_Challengue/mechanical/assemblies/full_robot/v22/analysis/encaje_area_central_repisa_alta_v19.png

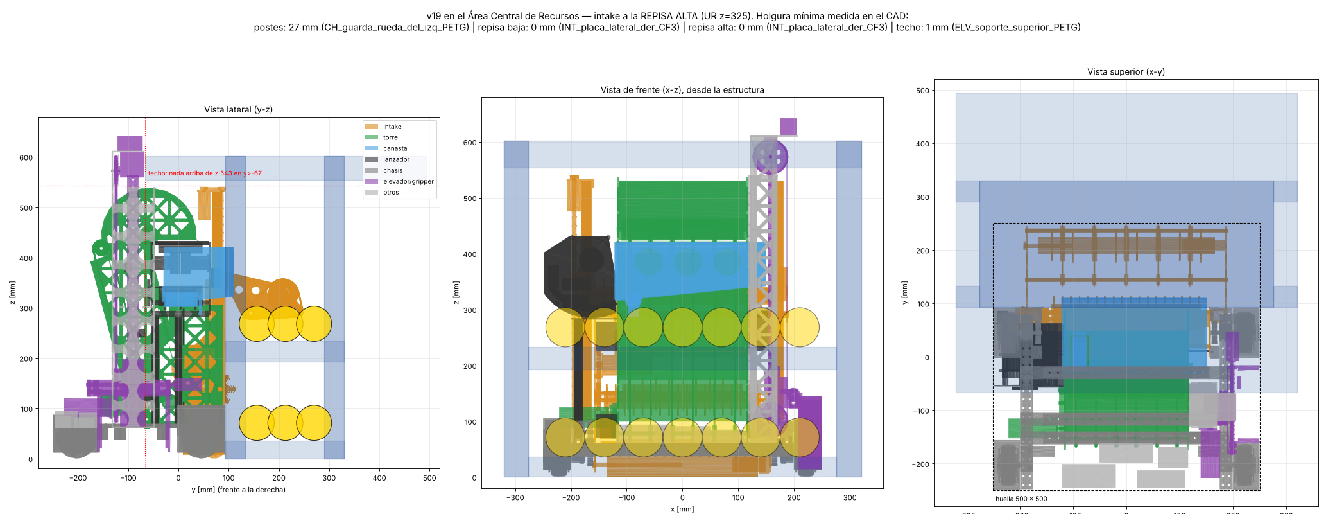
mechanical/assemblies/full_robot/v22/analysis/encaje_area_central_repisa_alta_v19.png
