Robotica76/2026_MakeX_Challengue/mechanical/assemblies/full_robot/v22/renders/v22_mastil_bajo_cabeza.png

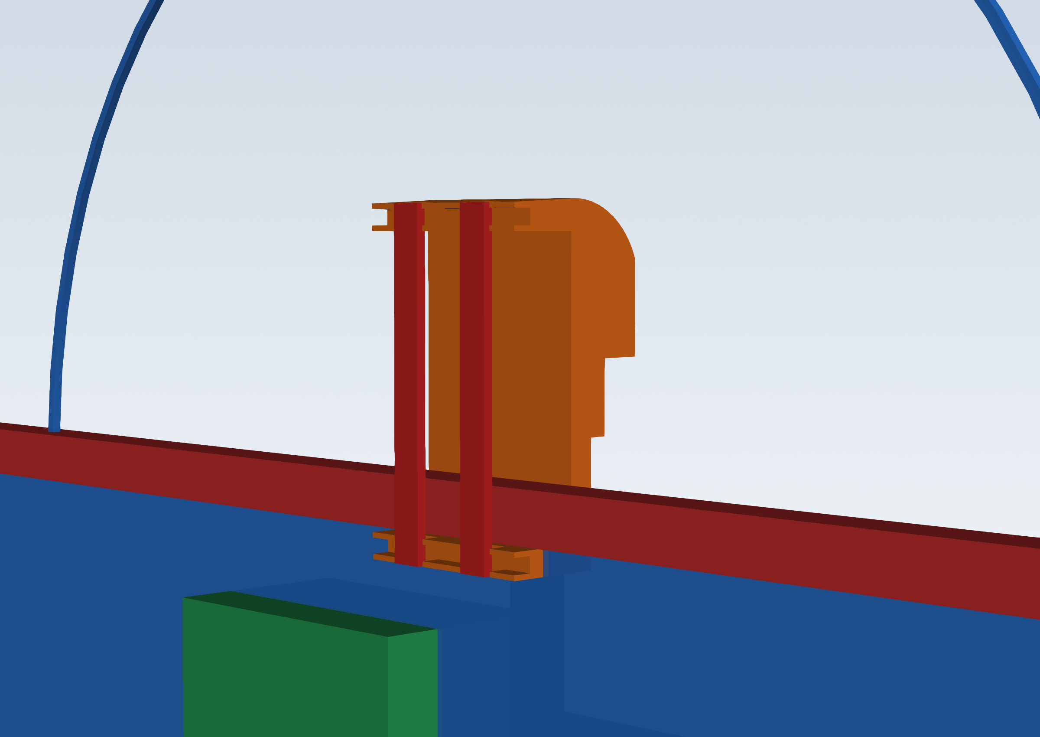
mechanical/assemblies/full_robot/v22/renders/v22_mastil_bajo_cabeza.png
