Robotica76/2026_MakeX_Challengue/mechanical/assemblies/full_robot/v22/renders/v22_mastil_iso.png

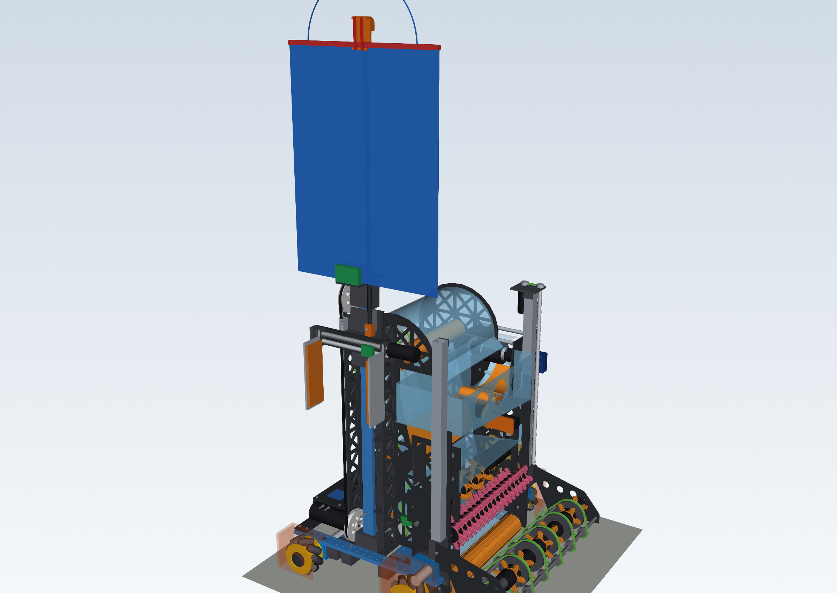
mechanical/assemblies/full_robot/v22/renders/v22_mastil_iso.png
