Robotica76/2026_MakeX_Challengue/tests/electrical/README.md

# Electrical component tests

Planned: port map check (each `DC`/`BL`/`M` port moves the expected mechanism in the expected
direction — run [`test_mechanisms.py`](../../simulation/control/test_mechanisms.py) on the robot), battery and
power-module checks against T17, sensor sign and units (gyro, accelerometer, ranging). No test run yet.
