Robotica76/2026_MakeX_Challengue/tests/full_match/README.md

# Full match black-box tests

Reports for CT-01…CT-05 (automatic stage with the start jig, manual cycles, cones, flag, full match)
— plans in [competition test planning](../../docs/06_verification/competition_tests/README.md). Simulated references:
[strategy](../../docs/07_strategy/README.md).
