Robotica76/2026_MakeX_Challengue/tests/integration/README.md

# Integration and mission tests

Reports for IT-01 (ball path), IT-02 (port map), IT-03 (gripper + elevator + flag mast), IT-04 (mechanisms while driving)
— plans in [integration test planning](../../docs/06_verification/integration_tests/README.md).
