Robotica76/2026_MakeX_Challengue/tests/subsystem/README.md

# Subsystem tests

Reports for complete subsystems. Plans: [subsystem test planning](../../docs/06_verification/subsystem_tests/README.md).
Drive software first: T05-R8 (3 m, < 5 cm drift) and T05-R9 (90°, < 5°) after calibration.
