Robotica76/2026_MakeX_Challengue/software/vision/calibration/README.md

# Vision calibration

Planned: camera pose on the elevator lid (v22 part 5.7), field-of-view to field coordinates,
lighting checks. Not implemented; see [tools/calibration](../../../tools/calibration/README.md).
