Robotica76/2026_MakeX_Challengue/tests/full_match/self_inspection.md

# Autochequeo del Robot — Apéndice 3 (MakeX Challenge Storm Breaker 2026)

> Fuente: Guía de Reglas MakeX Challenge Storm Breaker, 2026.9 v1.1, Apéndice 3 — Formulario de Autoinspección del Robot.
> Instrucción: marcar cada casilla solo con evidencia verificada. Registrar el resultado en la columna "Resultado / evidencia". Las casillas sin marcar indican requisito no verificado (no "cumple").
> Aplicado en el contexto de la regla local R9 (recogido de cabello largo; prohibido calzado con dedos al descubierto).

## 1. Información básica

| N.º | Ítem | Requisito | Valor registrado | ¿Cumple? | Resultado / evidencia |
| --- | --- | --- | --- | --- | --- |
| 1.1 | Código del Módulo de Gestión de Energía | Código de 4 bits (números y letras, p. ej. 004C) | TBD | ☐ | TBD |
| 1.2 | Dimensiones del robot (L × A × H) | ≤ 500 mm × 500 mm × 700 mm (tamaño inicial máximo) | TBD | ☐ | TBD |
| 1.3 | Peso del robot | ≤ 10 kg | TBD | ☐ | TBD |
| 1.4 | Bandera de equipo (L × A) | Superficie ≥ 400 mm × 300 mm; material flexible; asta permitida en material rígido | TBD | ☐ | TBD |

## 2. Equipamiento

| N.º | Ítem | Requisito | Valor registrado | ¿Cumple? | Resultado / evidencia |
| --- | --- | --- | --- | --- | --- |
| 2.1 | Cantidad de Módulos de Visión | ≥ 1 | TBD | ☐ | TBD |
| 2.2 | Motores DC y Encoder (37 DC / 180 Smart Encoder) | ≤ 13 en total | TBD | ☐ | TBD |
| 2.3 | Servos (MS-12A) | ≤ 6 | TBD | ☐ | TBD |
| 2.4 | Motores Brushless (2823/2824) | ≤ 2 | TBD | ☐ | TBD |
| 2.5 | Controlador Bluetooth | 1 unidad | TBD | ☐ | TBD |
| 2.6 | Control inalámbrico | Versión Bluetooth BT4.0 | TBD | ☐ | TBD |
| 2.7 | Batería | Li-Po 3S, 11.1 V, 25–30C, 4200 mAh | TBD | ☐ | TBD |

## 3. Otros requisitos

| N.º | Ítem | Requisito específico | ¿Cumple? | Resultado / evidencia |
| --- | --- | --- | --- | --- |
| 3.1 | Estructura peligrosa | Protección de seguridad en manejo y transporte | ☐ | TBD |
| 3.2 | Destrucción del área de competencia | Prohibida durante carga, descarga y transporte | ☐ | TBD |
| 3.3 | Equipos de alta potencia | No disponibles durante montaje y operación | ☐ | TBD |
| 3.4 | Dispositivos de almacenamiento de energía inseguros | Uso seguro de resortes | ☐ | TBD |
| 3.5 | Materiales prohibidos | Sin gases inflamables, pirotecnia, hidráulica, mercurio, materiales peligrosos expuestos, contrapesos inseguros, diseños que causen enredos/retrasos, bordes afilados, líquidos/geles, ni partes que conduzcan corriente al área | ☐ | TBD |
| 3.6 | Seguridad personal | Gafas de protección; cabello largo recogido; sin calzado con dedos al descubierto en el área de competencia (R9) | ☐ | TBD |
| 3.7 | Sensores luminosos/acústicos | Sin dispositivos de sonido excepto zumbador integrado; LEDs RGB ≤ 5 V para decoración/estado si no interfieren; láser de puntería conforme a especificaciones | ☐ | TBD |
| 3.8 | Piezas y accesorios personalizados | Placas, perfiles, piezas 3D, metales, madera, plásticos, goma, imanes; cuerdas, cables, resortes, bandas, mangueras, láminas perforadas, inyección; componentes comerciales de baja integración | ☐ | TBD |
| 3.9 | Envolver estructuras afiladas | Bordes afilados expuestos envueltos con tiras de esponja | ☐ | TBD |
| 3.10 | Desprendimiento | Prohibido el desprendimiento del robot y sus componentes durante la competencia | ☐ | TBD |
| 3.11 | Interferencia | Prohibido interferir con la electrónica y sensores de otros robots | ☐ | TBD |
| 3.12 | Número de equipo | Fuente Microsoft YaHei, negrita negra, tamaño 130, fondo claro | ☐ | TBD |
| 3.13 | Entrega del cuaderno de ingeniería | Entregar cuaderno del proyecto con código fuente de control antes de la competencia | ☐ | TBD |
| 3.14 | Contaminación del área | Lubricantes y materiales no contaminan la arena ni otros robots | ☐ | TBD |

> Nota: este checklist aplica el Apéndice 3 y la regla R9. No se marca ningún ítem como "cumple" sin evidencia verificada (medición, inspección o documento). Registrar incumplimientos en [problemas conocidos](../../05_integration/known_issues.md) y vincular acciones correctivas al [plan de verificación](../../06_verification/verification_plan.md).
