Robotica76/2026_MakeX_Challengue/docs/06_verification/verification_plan.md

# Verification Plan

Every acceptance criterion must identify its official rule or student engineering requirement. Unconfirmed limits remain TBD.

## Coverage matrix

| Test ID | Requirement / rule IDs | Subsystem / interface / mode | Method: inspection / analysis / demonstration / test | Procedure link | Acceptance criterion + source | Owner / reviewer | Result / evidence | Status |
| --- | --- | --- | --- | --- | --- | --- | --- | --- |
| TBD | TBD | TBD | TBD | TBD | TBD | TBD | TBD | Not executed |

## Procedure record structure

| Field | Fill in before execution |
| --- | --- |
| Objective and requirement IDs | TBD |
| Configuration / hardware / document revisions | TBD |
| Setup, equipment, calibration, environment | TBD |
| Safety review, supervision, stop conditions | TBD |
| Preconditions and ordered steps | TBD |
| Variables, repetitions, measurement units, uncertainty | TBD |
| Expected outcome and criterion source | TBD |
| Evidence storage / notebook entry | TBD |

## Result review

| Test ID / run | Actual outcome | Pass / fail / inconclusive / not executed | Deviations / uncertainty | Issue / corrective action | Retest link | Reviewer |
| --- | --- | --- | --- | --- | --- | --- |
| TBD | TBD | Not executed | TBD | TBD | TBD | TBD |

Use [subsystem](subsystem_tests/README.md), [integration](integration_tests/README.md), or [competition](competition_tests/README.md) records. Link [requirements](../01_requirements/robot_requirements.md), [compliance](../01_requirements/rules_compliance_matrix.md), [issues](../05_integration/known_issues.md), and [notebook evidence](../08_engineering_notebook/test_results/README.md).
