Robotica76/2026_MakeX_Challengue/docs/08_engineering_notebook/media/README.md

# Media

Index of images, videos and slide decks used as evidence, with provenance and permission.
Media files generated by the project (renders, simulation figures) live next to the data that
produced them; this index points to them.

| Media | Content | Provenance | Where |
| --- | --- | --- | --- |
| v22 renders | Robot with the flag mast, carriage up/down | Generated from the v22 CAD | [full_robot/v22/renders](../../../mechanical/assemblies/full_robot/v22/renders/) |
| Assembly manual and exploded view | 18-sheet A3 manual, numbered parts | Generated from the v22 CAD | [full_robot/v22/docs](../../../mechanical/assemblies/full_robot/v22/docs/) |
| 3D simulator screenshots, time-lapse | Intake flow, shooting, automatic stage | Generated by `simulation/field3d` | [field3d/docs](../../../simulation/field3d/docs/), [timelapse_34.gif](../../../simulation/field3d/timelapse_34.gif) |
| Strategy figures and GIFs | Monte Carlo, reinforcement learning, 4-robot matches | Generated by `simulation/analysis` | [analysis/reports](../../../simulation/analysis/reports/README.md) |
| 2025 robot presentation | Team slide deck of the 2025 robot | Team-authored | [legacy](../legacy/README.md) |

| Media ID | Description / date | Source / creator | Permission / consent status | Linked record | Storage reference |
| --- | --- | --- | --- | --- | --- |
| TBD | TBD | TBD | TBD | TBD | TBD |

Do not commit media of people without consent or material without redistribution permission.
