Robotica76/2026_MakeX_Challengue/docs/08_engineering_notebook/legacy/README.md

# Legacy (2025 season)

| File | Content |
| --- | --- |
| [Robotica76_UTM_2025.pptx](Robotica76_UTM_2025.pptx) | Team presentation of the 2025 MakeX robot (35 MB). Context for the reused 2025 drive code ([software/legacy/challenge_2025](../../../software/legacy/challenge_2025/README.md)) and the lessons carried into 2026 |

Kept as a reference only; the 2026 design records are in the [design log](../design_log/README.md).
