Robotica76/2026_MakeX_Challengue/docs/08_engineering_notebook/legacy/Robotica76_UTM_2025.pptx

Julio 2026

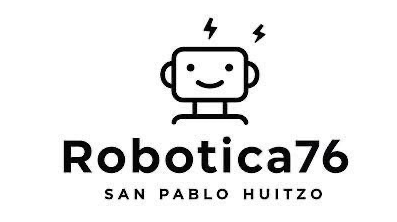
[picture p233: figure]

## Quienes somos? 👋

El club de robótica ROBOTICA76, es una organización sin fines de lucro que organizados buscamos ayudar, colaborar y consolidar espacio de formación en robótica, mini-robotica y conferencias.

## MISION 👓

- ✔️ Formar un grupo de trabajo unido para la capacitación y el fomento de la mini-robótica y robótica en el instituto, así como realizar proyectos de investigación e innovación que nos ayude al desarrollo de los alumnos y de la comunidad.

## VISION 🔭

- ✔️ Fomentar el desarrollo tecnológico de la localidad con la participación de los jóvenes y escuelas locales, donde se demuestre el liderazgo y la iniciativa de nuestros equipos obteniendo destacados reconocimientos.

## OBJETIVOS 🎯

✔️ Consolidar una selección de Robótica representativa y competitiva.
✔️ Desarrollar el conocimiento tecnológico de los estudiantes.
✔️ Desarrollar proyectos de innovación tecnológica para representar a nuestra Institución en competencias.
✔️ Crear grupos de aprendizaje colectivo para el desarrollo del conocimiento.
✔️ Crear otros Clubs de Robótica en otras instituciones educativas.

## Slide 6

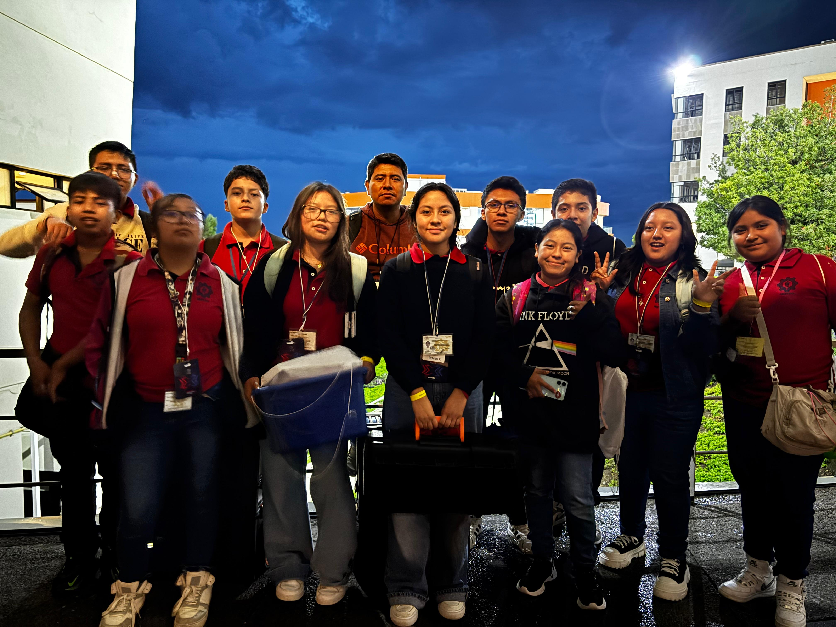
[picture p234: figure]

- 14 integrantes
  - 13-15 a~nos
- Categorias
  - Mbot Rescue – Robotica de rescate (Entry-Level)
  - RoverX – Robotica de rescate (Intermedio)
  - Ultimate Challengue – Misiones autónomas y manuales de robótica cooperativa

## Nuestra Historia y Progreso 📈

Certificacion internacional a categorias:
- Rescue
- RoverX
- Challengue

Nov 2026
Inscritos

June 2023
Para que sirven las matematicas?
Apr. 2024
Para que sirven las matematicas? Vista general a las aplicaciones de ingenieria.
2024
Agosto 2024
Python y POO
2024
Noviembre 2024
MakeX 2024 – Cuarto lugar Nacional (Nivel secundaria – Robotica de rescate)
2025
Mayo 2025
MakeX 2025 – 1o, 2do y 3er lugar Nacional y
2025
Noviembre 2025
MakeX 2025 – Ultimate Challengue (Bachillerato/Universidad)
2026
obteniendo pases para competencias
internacionales
(Nivel secundaria/bachillerato – Robotica de rescate)

## Resultados Nov 2025

- 3er Lugar RoverX

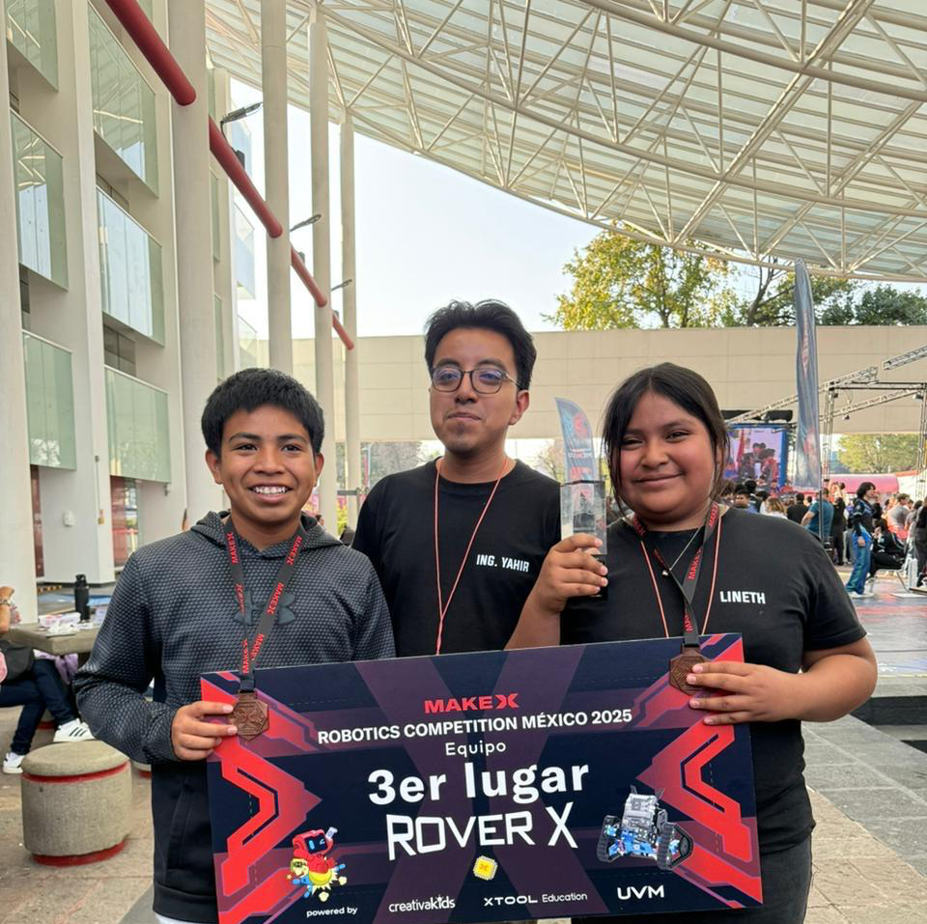
[picture p235: figure]

## Slide 10

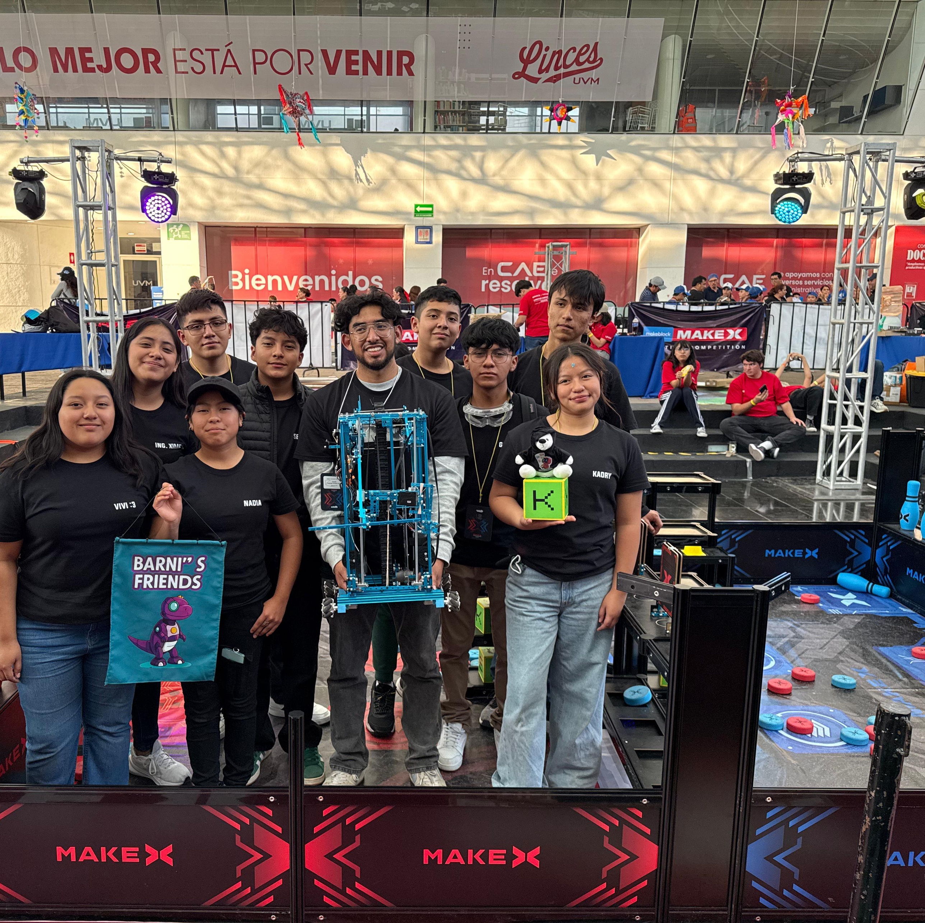
[picture p236: figure]

- 4o Lugar – Ultimate Challenge Winner
