Robotica76/2026_MakeX_Challengue/(commit log)

2026-10-19 Add 2D field layout simulation with pygame viewer
    - field_layout.py: Storm Breaker field (4655 x 3055 mm) from the 2026 rules
    guide V1.1; sizes cite rule pages, positions scaled from Fig 4.2-1 and
    marked as estimates. Flat floor (T04), element heights, central barrier.
    - robot.py / robot_config.json: configurable box footprint with 4 mecanum
    wheels, 500 x 500 mm limit (T01), start area and heading.
    - viewer.py: supersampled, cached field rendering with hover info.
    - panel.py / ui.py / theme.py: side panel with start-position dropdown,
    orientation dial (5 deg steps), length/width boxes, Apply/Reset/Save.
    - test_field_layout.py: layout, robot and headless panel checks.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
    [field_layout.py, panel.py, robot.py, test_field_layout.py, theme.py, ui.py, viewer.py]
2026-10-19 Play back mBlock Python programs in the 2D simulator
    - mblock_runtime.py: novapi / mbuild.encoder_motor / time stand-ins; the
    program runs unchanged in a thread, in lockstep with a simulated clock.
    - kinematics.py: motor-port to wheel mapping (drive_train in
    robot_config.json, direction +/-1, gear ratio, 580 RPM clamp) and
    mecanum forward kinematics with 80 mm wheels.
    - simulation.py: run states, 30 s automatic-stage limit, stop with
    "Out of boundaries" when the footprint leaves the field.
    - Panel: Load .py / Run / Stop, run clock and status; viewer draws the
    trail and an OUT OF BOUNDARIES banner; robot drawn as its own sprite.
    - Example program and tests for kinematics, runtime an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
2026-10-20 Address PR #26 review: stoppable programs, RPM clamp, read errors
    - Stop now ends programs that never call a simulated API (e.g.
    `while True: pass`): a per-thread line tracer raises ProgramStopped
    in the program file. ProgramRunner.stop() joins and reports whether
    the thread exited; the run message warns if it did not.
    - MotorBus clamps commanded RPM to max_rpm for every port, so
    get_value("speed") matches the speed used for motion.
    - Unreadable or non-UTF-8 program files end the run with an error
    instead of raising into the viewer.
    - Regression tests for each case (fail on the previous code).
    [mblock_runtime.py, simulation.py, test_simulation.py]
2026-10-24 Add mecanum chassis control with odometry and S-curve smoothing
    Reuses the makeX 2025 drivetrain, adapted to 8 cm mecanum wheels:
    - Closed-loop odometry (encoders + gyroscope) with accelerometer
    collision detection; USE_SENSORS flag falls back to open loop.
    - Jerk-limited S-curve smoothing for manual driving, with adaptive
    limits by speed and measured vibration.
    - README documents frames, flags, and unverified items (TBD).
    Validated only in an offline simulation with mocked hardware.
    [chassis.py]
2026-10-24 Added chasys.py
    mecanum drive reused from makeX 2025, adapted to 8 cm wheels
    2026 stage: odometry with encoders + gyroscope, accelerometer for collision detection.
    The system is design to add an enhacement in odometry and chassis movement from pure geomerty robot measurements and an option to enable gyro + accelerometer feedback
    The system automatically detect the accelearion and decrease the acceleraion rate at low speeds to prevent shaking or high breaking
    [Intake_StormBreaker.stl]
2026-10-24 Stop programs reliably, even when they catch the stop
    The line tracer from 69fa1f9 was one-shot: CPython disables tracing in a
    thread once the trace function raises, so a program that caught the first
    ProgramStopped (e.g. `except BaseException` inside a loop) could never be
    stopped. The regression tests caught it intermittently.
    ProgramRunner.stop() now injects ProgramStopped into the program thread
    (PyThreadState_SetAsyncExc) every few ms until it exits, after a short
    cooperative wait. The thread body also absorbs an injection that lands
    while it is already finishing. Stress check: 120 stops across pass-loop,
    sleep-loop and bare-except programs, no leaked threads.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
    [mblock_runtime.py]
2026-10-24 Add emulated Makeblock Bluetooth gamepad window
    - gamepad.py: separate pygame window/process with the Makeblock
    controller layout (L1/L2/R2/R1, arrow keys, Menu/Bluetooth/Plus,
    number buttons 1-4, two joysticks, indicator LED, On/Off switch) and
    callouts like the reference picture. Buttons light while held, sticks
    drag and spring back, power toggles input. Each change is printed as a
    JSON line; the simulation does not consume it yet.
    - Panel: "Open gamepad" button; the viewer launches one window at a time
    and closes it on exit.
    - test_gamepad.py: every control present, no overlapping hit areas,
    press/release and axis events, power gating, headless render.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
2026-10-24 Run chassis.py in the simulator: sensors, gamepad link, demos
    Simulator (simulation/field2d):
    - Encoder angles (get_value("angle")), motor.move(), novapi.get_gyroscope /
    get_acceleration, time.ticks_ms, and mbuild.gamepad (get_joystick,
    is_key_pressed) are now simulated.
    - The gamepad window opened from the viewer is the Bluetooth link: its
    events feed mbuild.gamepad; the panel shows CONNECTED / NOT OPEN.
    - `import x` of project code resolves beside the program, then under
    software/ (ambiguous names are an error), so simulation programs use
    software/controls/drivetrain/chassis.py unchanged.
    - robot_config.json follows the chassis.py wiring (M4/M1/M3/M2, left side
    mirrored) and gy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
    [gamepad.py, mblock_runtime.py, panel.py, simulation.py, test_chassis_programs.py, ui.py]
2026-10-24 Add Windows launcher for the 2D simulator
    run_simulator.bat creates .venv and installs pygame on first run, then
    offers the empty simulator or one of the chassis demos (or passes its
    arguments to viewer.py). .gitattributes keeps .bat files CRLF.
2026-10-24 Add macOS launcher for the 2D simulator
    run_simulator.command mirrors run_simulator.bat: creates .venv with
    python3 and installs pygame on first run, then offers the empty simulator
    or a chassis demo, or passes its arguments to viewer.py. Tested here from
    its folder, from another folder, and on a fresh copy without .venv.
2026-10-24 Add Monte Carlo robustness study of chassis.py
    Simulator (field2d):
    - uncertainty.py: optional error model (Variation), ideal by default:
    wheel diameter, motor gain and lag, slip (forward/strafe/turn), gyro
    bias/drift/noise/scale, encoder resolution, sleep jitter, start error.
    - MotorBus, body_velocity and the simulation apply it; simtrace.mark()
    records the true pose and simtrace.options() passes study settings
    (simulator only, not on the robot).
    Study (simulation/analysis):
    - montecarlo_chassis.py runs mc_routine_chassis.py on N sampled robots
    in parallel and checks each move against the request: error <= 1 cm
    for >95 % of moves with 95 % confidence (exact Clopper-Pearson lowe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
    [kinematics.py, mblock_runtime.py, simulation.py, uncertainty.py]
2026-10-24 Add Monte Carlo report of chassis.py with figures and calibration guide
    simulation/analysis/reports/chassis_montecarlo/README.md (Spanish, for
    the team): five scenarios x 300 simulated robots, summary and per-move
    tables, five figures (error ECDF, 95 % lower bound per move, real end
    points, sensitivity, trajectories), the chassis.py parameters to write
    (TOL_CM 0.3, TOL_DEGREES 0.5, GYRO_SIGN, effective WHEEL_DIAMETER,
    STRAFE_FACTOR, new GYRO_SCALE with the proposed 2-line change), the
    calibration accuracy each needs, and step-by-step calibration on the mat.
    make_chassis_report.py regenerates it all (same seed, same numbers);
    montecarlo_chassis.run_study() is the reusable entry point and can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
2026-10-24 Make the chassis Monte Carlo report bilingual (Spanish and English)
    The report README now opens with a language switch and holds the full
    report in Spanish and in English, each with its own figures
    (figures/es, figures/en) and number format (99,0 % / 99.0%).
    make_chassis_report.py generates both from the same run, so numbers stay
    identical across languages. Figure files moved from figures/*.png to
    figures/<lang>/*.png.
2026-10-24 Document T05 chassis motion: design study, control record, notebook entry
    - docs/04_controls/drivetrain_motion_control.md: 2025 -> 2026 function
    map and fixes, control decisions (odometry, closed loop, adaptive
    S-curve, sampling time, flags), calibration parameters, and TODO.
    - docs/03_design/chassis/README.md: T05-R1..R9 status, drive type
    selection, configuration, simulation evidence, risks.
    - Design log DL-T05-001 and notebook index entries.
    Refs #6
2026-10-25 Cubes Stikers
    Reference images of QR codes, multipliers, and the objects to be used/detected by the AI camera.
2026-10-25 Prop cards stats
    Document with positioning data and statistics on the best locations for placing a robot that uses the AI camera.
    [prop_cards.xlsx]
2026-10-31 Add Storm Breaker v22 CAD and check it against the requirements
    - mechanical/assemblies/full_robot/v22: zipped STEP (initial and
    after modification with flag mast; 121 MB each, over the GitHub
    limit unzipped), STL, CadQuery sources (not runnable here: missing
    robot_v21), renders, and a README with frame, envelope, subsystem
    map, actuator count, and CAD requirements check.
    - mechanical/flag_system/cad/v22: printable flag mast parts.
    - Compliance matrix rows for T01, T02, T17 checks; known issues
    KI-001..KI-007 (0.5 mm footprint margin, no motor reserve, power
    module in CF box, no team ID, wheel geometry and fronts that differ
    from chassis.py, mass unknown).
    All results are CAD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
    [FLAG_cabeza_C_PETG.stl, FLAG_ligas_x2.stl, FLAG_mastil_tubo_CF_8x6.stl, FLAG_pasador_R_D3.stl, FLAG_receptor_mastil_PETG_(va_en_el_robot).stl]
2026-10-31 Use the v22 drive geometry in chassis.py and the 2D simulator
    The v22 wheel rectangle sits 79 mm behind the footprint centre
    (a + b = 345 mm) and the gripper / launcher moved to the sides.
    - robot_config.json: v22 footprint and measured wheel centres;
    robot.py accepts explicit wheel_centers_mm (resizing returns to
    corner wheels); kinematics solve any wheel layout by least squares.
    - chassis.py: CM_PER_TURN_DEGREE 0.603 cm/deg from CAD; odometry
    tracks the wheel centre and reports the footprint centre
    (ODOM_CENTER_OFFSET_CM); fronts become angles (F_INTAKE default,
    F_GRIPPER, F_LAUNCHER, F_REAR; F1/F2 kept as aliases).
    - Tests: offset-wheel kinematics, offset-turn odometry in close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
2026-10-31 Add a 3D simulator with the v22 CAD robot and a UDP state stream
    - simulation/field3d: Panda3D viewer running the same Simulation as
    the 2D viewer (programs, gamepad, chassis.py). CAD robot with
    spinning wheels (from encoder angles), elevator carriage (the 18
    parts that move 358 mm in the CAD) and removable flag mast; field
    built from field_layout heights; orbit / follow / orthographic top /
    driver cameras; headless screenshots; Windows and macOS launchers.
    - state_stream.py: robot state as JSON over UDP (127.0.0.1:5005,
    30 Hz) for Unreal Engine or ROS 2 bridges; stream_listener.py example.
    - tools/scripts/step_to_glb.py: STEP (or .step.zip) to GLB through
    cascadio, used to bui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
2026-10-31 Add rules-based field details to the 3D simulator
    Builds each field structure with the shape given in the 2026 Rules
    Guide V1.1 (section 4.2-4.3), inside the field_layout footprints:
    own resource areas (shelves at 758.5 mm, pins, ball box with 10
    balls, mesh), pin placement shelf at 405 mm with flag posts, strategy
    area frame with the four 140 mm channel windows, central resource
    table with two ball levels and the red/blue X mark, two-level mobile
    fortress with V cut-out walls and 8 letter cubes, cones and bonus
    cubes on the strategy area, black floor and frame.
    Each dimension cites its rules page; values read off figures are
    marked as estimates. Tests check element heights and the prop cou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
2026-10-31 Simulate balls and the intake; add a ball collection demo
    - balls.py: the 70 balls of the rules (own resource boxes, central
    levels) with an "initial" and a "released" (manual stage) scenario,
    and an intake model from robot_config.json (zone at the v22 front,
    DC1 power threshold, 18-ball capacity from the CAD basket + tower).
    - mblock_runtime: mbuild.power_expand_board set_power / stop (DCBus).
    - Simulation: optional ball scenario and intake (default none, so
    earlier studies and the Monte Carlo are unchanged).
    - 3D viewer: balls are simulation objects (collected ones disappear),
    HUD count, balls_collected in the state stream, --balls option,
    launcher option 4.
    - control/test_ball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
2026-10-31 Animate the intake head, rollers and elevator from the program ports
    - mechanisms.py: kinematic linear slides (elevator carriage DC3,
    intake head lift DC2) and spinners (intake rollers DC1, tower DC4,
    feeder DC5, shooter BL1) driven by power_expand_board power;
    ports, speeds and travels in robot_config.json "mechanisms"
    (ports are assumptions; elevator speed from DC37 50 rpm x 90T GT2).
    - The intake collects balls only with its head down.
    - 3D model: intake-head group (16 INT_UR parts on their rails,
    ~380 mm travel inferred from the 428 mm rails) and 16 spinning
    roller / gear / wheel sets with axes and centres from the meshes;
    the head roller rides on the lift. Carriage and hea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
2026-10-31 Let the intake reach follow its head; test it on the central shelf
    - The intake reaches ball centres 0-60 mm above the intake head lift
    (replaces the floor-only limit), so the head raised ~255 / ~50 mm
    reaches the central resource upper / lower level. robot_config.json
    intake: ball_center_z_mm, body_front_mm 115 (v22 CAD, the head
    overhangs the rest of the robot by 134 mm).
    - control/test_intake_shelf.py: raises the head, drives it into the
    central table in two passes between the legs, takes 15/15 of the
    upper level, leaves the lower level, body never past x 2105 mm;
    launcher option 6. It runs 34 s (longer than the 30 s auto stage).
    - Tests for the reach and the shelf demo; doc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
    [balls.py, simulation.py, test_balls.py, test_mechanisms.py]
2026-10-31 Add ball dynamics, the full ball path, and wheel / inertia vectors
    - ball_physics.py: gravity, bounces on the floor, frame and field
    structures (boxes from the rules dimensions), ball-ball collisions,
    rolling resistance, pushes from the robot body and intake head;
    resting balls sleep (34 s simulated in ~1 s).
    - Ball path through the robot: 18 slots from the v22 CAD reference
    balls (basket 6, tower 12), waypoints head -> tower -> elbow ->
    basket, feeder to the shooter, ballistic launch; each stretch moves
    with its port (DC1, DC4, DC5, BL1). Captures, shots and fortress
    hits are counted.
    - control/test_full_intake.py: collect 10, store, aim the launcher at
    the blue fortress, co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
    [ball_physics.py, balls.py, simulation.py, test_ball_physics.py, test_balls.py, test_field3d.py]
2026-10-31 Add the match clock, rule monitors and the automatic-stage routine
    - match.py: stage timeline (auto 30 / manual 100 / modification 60 /
    final 90 s) and monitors for R19 (robot stationary at the end of
    the automatic stage) and R06 (body outside the alliance area, 3 s
    grace; intake head overhang allowed by team decision).
    - 3D viewer: match clock in the top-right corner with rule notes.
    - chassis.py: on_cycle callback in drive / turn_to / turn, so
    mechanisms run while the robot moves.
    - software/autonomous/task_execution/auto_central_then_cubes.py:
    head rises while driving diagonally to the central table, two
    passes take 14 upper-level balls by 15.7 s, then a timed cube route
    (gr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
2026-10-31 Simulate props and the gripper; automatic stage takes the X12 bonus cube
    - props.py: bonus cubes and cones on the strategy areas, letter cubes
    in the fortresses; gripper model (jaw slide DC6, grab point on the
    carriage from the v22 CAD) that holds and drops props onto the
    support below; score preview with the bonus-cube rules (p.30 a-e).
    - Simulation: props and gripper; jaw slide added to the mechanisms.
    - 3D viewer: props follow the simulation, the moving jaw slides, HUD
    previews valid bonus cubes / cones / letter cubes.
    - auto_central_then_cubes.py (team plan): central balls (14), then the
    gripper takes the X12 from the lower strategy area (body over the
    line 2.26 s) and drops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
2026-10-31 Pull the central balls to our side in the automatic stage; collision check and route search
    - auto_pull_central.py: four head-roller passes (upper b, upper a, lower a, lower b; lanes at
    y 1437 / 1600), head above the balls on the way in, pulling on the way out; 22 central
    balls end on our side in simulation, no collisions, no R06, stationary at 30 s
    - optimize_auto_route.py: headless search of task order, speeds, lane depth, tolerance and
    head heights, scored on denial minus collisions and rule penalties
    - simulator: pull mode (DC7) for balls and props, CollisionMonitor with the CAD height bands,
    props stay on the strategy top while raked, balls pressed under a plate leave sideways
    -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
    [ball_physics.py, balls.py, chassis.py, match.py, props.py, simulation.py]
2026-10-31 Pull the lower strategy-area cones and cubes to our side in the automatic stage
    Props pulled off the strategy area drop at the centre line; a floor pass with the head low
    pulls them onto our floor. Props passes go first (head high), floor passes after the
    lower-level balls (head low). Three selectable strategies: balls (21-22 balls), mixed
    (16-17 balls, cone, X12; default) and props (11 balls, 2 cones, X9, X12), all without
    collisions or rule penalties in simulation.
    [test_match.py]
2026-10-31 Load mBlock programs in the simulator; 2026 competition program on the chassis dynamics
    - Load program button (3D viewer, 2D panel) for .py and .mblock block projects; the
    .mblock is translated to the Python mBlock generates (mblock_project.py, checked
    identical against the 2025 project's Python view); the file reloads when saved
    - runtime: smart servos, ranging sensors, busy polling loops kept in step (1 ms per
    200 API calls without a sleep)
    - software/robot/main/robot_2026.py: the 2025 flow (N1 start, automatic, manual with
    "≡" / "+" modes) on chassis.py and auto_pull_central.run(strategy), v22 ports
    - tools/scripts/bundle_for_mblock.py: one file for mBlock's Python editor
    - soft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
2026-10-31 Winning strategy over the whole match: X12 bonus in the automatic stage, ball cycles in manual
    - auto_pull_central "bonus" (default): pull the X12 to our floor, gripper puts it in red
    exchange area 1 (valid at 22.7 s in simulation), park clear at 30 s
    - referee.py: bonus exchange and own resource balls released at 30 s; match score from
    the rules table (bonus balls at 20)
    - simulation/control/match_2026.py: automatic + scripted manual stage (collect, shoot
    over the strategy areas); simulate_match.py plays and scores it, --compare: bonus 300,
    props 130, balls 90, mixed 80
    - 3D HUD shows the score; strategy docs filled from the rules guide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
2026-10-31 Two robots per alliance: play our half only; modification stage and the team flag
    - HalfMonitor: this robot keeps to y <= 1527.5 mm (robot_config "own_half")
    - referee: at 130 s the robot must be partly in its starting area; it returns with the
    flag mast; flag.py models hanging the flag on an own flagpole (50 points)
    - flag geometry from the v22 CAD; the CAD mast cannot reach the pole (cone post and pin
    area keep the chassis away), the simulated proposal puts the rod on the left side up
    to the front edge (37 mm window)
    - match_2026.py: 280 s, our half only, back to the start area before 130 s, flag hung
    12.3 s into the final stage; 300 points in simulation, no collisions
    - auto bonus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
    [flag.py, match.py, referee.py, simulation.py, test_referee.py]
2026-10-31 Competition program as blocks and Python, profiled chassis control, Monte Carlo strategy
    - software/robot/main/storm_breaker_2026.py + .mblock: block-friendly program with its own
    odometry (encoders + gyro angle), time-optimal profiled motion (translate and turn at
    once, pass-through waypoints, face the travel direction), timed mechanism jobs; X12 into
    exchange area 1 plus X9 and cones onto our side; manual modes; N4 hangs the flag
    - tools/scripts/python_to_mblock.py: Python -> mBlock blocks (2025 project assets); the
    translator gets the motion-sensor, encoder and timer blocks; round trip tested identical
    - montecarlo_strategy.py: strategies on sampled robots (competition scenario wi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
2026-10-31 Blocks: mBlock's real opcodes for encoder angle, reset timer and brushless motors; figures
    - encoder angle -> novapi.encoder_motor_get_pos, reset timer -> novapi.timer_reset, BL1/BL2
    -> POWER_EXPAND_BLmotor_power/stop, rotation reset -> motion_sensor_reset_rotation (block
    keys from mBlock 5.6's NovaPi extension; the team found the undefined blocks in mBlock)
    - storm_breaker_2026.mblock regenerated
    - plot_strategy_report.py: paths, Monte Carlo candidates, X12 time, speed profile, match points
    [mblock_project.py]
2026-11-01 Scripted gamepad driver for the 3D viewer; R2 aim-and-shoot assist; head tracked in manual
    - ai_driver.py: plays the gamepad from the state stream (pose, balls inside, score, flag):
    N1 automatic, area-1 sweeps with L1, R2 shots, back to the start area, N4 flag;
    simulate_driver.py runs it headless: 290-310 points, no collisions, our half only
    - viewer3d.py --driver / --autorun; the stream carries balls inside, score and flag state
    - storm_breaker_2026: R2 held aims the launcher at the blue fortress with the odometry and
    sets the power from the distance; the manual head buttons update the head estimate (the
    flag routine raised the head only to 120 mm and touched the pin area)
    Co-Autho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
    [storm_breaker_2026.py, viewer3d.py]
2026-11-01 Robot pushes cubes and cones; smooth scripted driver; X12-only plan after the physics check
    - push_props: the robot's CAD height bands and the head push props out along the smallest
    overlap; structures jam them; off a strategy-area top they drop. The gripper slot (open
    to the outside) and the intake mouth (props under the head roller) are left free
    - the pushing showed real plan problems: after the floor pass the cube touches the robot
    front, so the robot now backs off before turning; the DENY_X9 pass shoved the X12 out
    of the exchange area and blocked the park spot, so the winner is X12 only
    - ai_driver: speed profile, rate-limited sticks, turn hysteresis, stage deadlines (stick
    j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
    [props.py, simulation.py, storm_breaker_2026.py, test_mblock_project.py, test_props.py]
2026-11-01 Faster scripted driver: predicted pose, close-and-still exit, head moving while driving
    Live, every move hunted around its target until the 8 s timeout (stream delay): the driver
    now steers from the pose predicted with the streamed velocity, stops when close and nearly
    still, moves the head while driving (just over the balls on the way, to the floor at the
    sweep), turns while translating. The manual sweep starts at 38 s instead of 79 s live.
2026-11-01 Viewer speed meter in the terminal; broad phase for prop pushing (2.1x -> 2.8x offscreen)
2026-11-01 Automatic stage pulls the X9 and the second cone onto our side again, park west
    Lane a runs 50 mm farther in so the body clears the X12 in the exchange area; the robot
    waits at (1200, 800), clear of the props and the released balls. Monte Carlo (10 robots,
    prop physics): P(X12) 1.00, P(X9) 1.00. The driver starts from either park spot and moves
    the head from its streamed height. Driven match: 330 points, no collisions.
    [storm_breaker_2026.py, test_mblock_project.py]
2026-11-01 Viewer keeps the match clock at real time
    - busy-wait loops (mBlock 'wait until') hand over every 10 ms of simulated time instead of
    1 ms: the viewer crawled at 0.02x while the program waited for N1 or for the 30 s mark
    - the viewer simulates up to 0.3 s per frame (macOS slows a covered window to ~8 fps) and
    runs without vsync at a 60 fps cap
2026-11-03 Simulate pins and the X mark; N3 aims at the X; the driver wins it back if flipped
    - pins: 4 per own resource area on the side shelves (758.5 mm, p.13); they drop onto the
    pin placement area shelf or the floor; pin_points scores 30 / 10 (p.41-42). The v22
    robot cannot reach them (645 mm body, 525 head, 515 gripper)
    - X mark: "both" at the start; a ball moving toward it at >= 1.2 m/s turns the colour of
    the side it comes from toward that side (model of p.44-46, to check on a real field)
    - match_score adds pins and the X mark; the scoreboard and the state stream show them
    - storm_breaker_2026: aim_and_shoot takes a target; N3 aims at the X mark
    - ai_driver: if the X mark is blue, the las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
    [ball_physics.py, field_model.py, props.py, referee.py, storm_breaker_2026.py, test_ball_physics.py]
2026-11-03 Simulate the MAKEX Challenge bonus and R26; letter cube reach analysis
    - props.make_bonus: +50 per strategy-area side with the alliance's valid M, A, K, E from
    outside to inside (p.39-40); a letter cube counts on the rails, not on the map
    - ChannelMonitor (R26): robot body bands or the head below the strategy top inside a
    channel; -20, then -120 each time, in match_score and the Monte Carlo problems
    - letter_cube_reach.py: our half holds one M, A, K and E, but the v22 gripper reaches
    none (the body runs >= 102 mm into the fortress plate); +150 mm of reach gets K and E
    from the south, M only by crossing into the partner half, A not at all
    - the driven match stays clean: no R26 event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
    [match.py, props.py, referee.py, simulation.py, test_match.py]
2026-11-04 Hang both lower cones on our cone post in the manual stage (+40)
    - props: a cone hangs only if lowered onto the post from above (thread_cone);
    brought in below the 405 mm top it falls beside the post
    - elevator travel 430 mm (design proposal, v22 358 mm is 57 mm short);
    cone_post_reach.py finds headings 240-260 at red cone post 2
    - CollisionMonitor: a structure inside the gripper slot is no contact
    - program: lane a floor pull ends 200 mm farther in (PULL_A_DY) so the
    cone stays clear of the shelf legs; manual "+" mode tracks the carriage
    - driver: cone a first (heading 35, head over the strategy top), sweeps,
    cone b; placement corrected with the actual heading; timed key holds
    rep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
    [match.py, mblock_runtime.py, props.py, simulation.py, storm_breaker_2026.py]
2026-11-05 Mobile fortress on casters; letter cubes K and E into the channels (+60)
    - fortress.py: the robot pushes a fortress out of its structure boxes along
    the footprint; it stays in the alliance area and off other structures and
    carries its letter cubes and balls; caches (colliders, ball world) follow;
    the 3D viewer draws each fortress as a node that moves with it
    - program: N2 pull mode in manual (head roller only); each mode stops the
    other mode's motors (DC2 kept running across a mode change); the flag
    routine turns first and pushes the fortress slowly (its end pose overlaps
    the fortress by 230 mm), x 322 for rod overlap margin
    - gripper: jaws centre a prop only along their closing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
    [ball_physics.py, field_model.py, fortress.py, props.py, simulation.py, storm_breaker_2026.py]
2026-11-05 Route Monte Carlo over every automatic mission order; two identical robots
    - program: ORDER digits run the automatic missions (1 X12, 2 deny X9+cone,
    3/4 central table balls taken in and shot); auto shot until 3 s before END_BY
    - montecarlo_routes.py: 65 orders x sampled robots, best ones as whole matches
    - two_robots.py: our robot and its blue twin (field turned 180 deg) on one
    field: shared balls, props, X mark, fortresses; robot contacts recorded
    - engine: ball world without field physics for a second robot, linked sims
    refresh structures, drag ownership for balls and props
    - figures in reports/routes_montecarlo
2026-11-05 3D viewer: --twin ORDER adds the blue twin robot (same program and driver) on the same field
2026-11-05 Driver keeps 2 balls for the X mark and fires them at 276.8 s (last hit wins); one X mark shared by both robots
2026-11-05 Driver stream: only our own cone posts count as hung (the twin's cones were counted)
2026-11-05 2 vs 2 strategy game, self-play reinforcement learning and Monte Carlo; fortress evasion in the driver (EVADE_MM, two_robots --red-evade)
2026-11-05 Four-robot 2 vs 2 match in the detailed simulator; UCB bandit on it; report
    - four_robots.py: ours, partner (START_Y 2730, ORDER 0, partner_driver.py) and
    their blue twins turned 180 deg on one field; alliance score
    - rl_four.py: UCB bandit over our alliance configurations on whole matches
    - timelapse4.py: offscreen 4-robot timelapse with the match report
    - program: R19 fix (mechanisms cut at 29.5 s, bounded park wait), table pass
    rounds the cone; driver leaves the east park spot westward; per-robot X time
    - reports/four_robots/REPORTE.md: winning match red 450 - blue 360
    [storm_breaker_2026.py, timelapse4.py]
2026-11-05 timelapse.py: print the twin's driver log too
2026-11-06 pin_reach.py: footprint and slim-tool reach to the pins on the resource-area shelves
2026-11-06 Monte Carlo: props jitter after run() (it was discarded), seeded sampled robots in 4-robot matches, mc_four.py
2026-11-06 Pin module: claws in the free front of the square (simulate_driver.py N pins), launcher knock-off study
2026-11-06 Robots off the field in the modification stage; fortress push speed capped; extended 4-robot Monte Carlo results
2026-11-07 Update STL per subsystem
    [1.10_CH_slide_beam_496_der.stl, 1.11_CH_guarda_rueda_tras_izq_PETG.stl, 1.12_CH_mecanum_80_R_del_der_rodillos.stl, 1.13_CH_mecanum_80_L_del_izq_rodillos.stl, 1.14_CH_mecanum_80_R_tras_izq_rodillos.stl, 1.15_CH_mecanum_80_L_tras_der_rodillos.stl, 1.16_CH_guarda_rueda_tras_der_PETG.stl, 1.17_CH_motor_180_encoder_del_izq_caja.stl]
